jlopezr/mini-gpu/tools/README.md

# tools/

Infraestructura común del repositorio: lanzadores que funcionan desde cualquier
directorio una vez `tools/` está en el `PATH`, y que reutilizan la lógica que ya
vive en cada prototipo (simuladores, backends de placa) en vez de duplicarla.
`build`/`build-sweep`/`prototype-report` son genéricos: no dependen de qué
prototipo es, solo de en qué carpeta corren.

```bash
export PATH="$PWD/tools:$PATH"
```

Todo lo de aquí abajo funciona igual si lo lanzas desde la raíz del repo, desde
`17.fpga-gpu-ram-v2/`, o desde `/tmp`: cada comando localiza la raíz del
repositorio solo (por `MINI_GPU_ROOT`, por su propia ruta, o buscando
`tools/` + `README.md`).

## Validar VOBJ con vlink

`vlink` vive como submódulo opcional en `w.vlink`. Para inicializarlo
y compilarlo:

```bash
git submodule update --init w.vlink
build-vlink
```

`check-vobj` genera un smoke test MiniISA, lo ensambla a `.vobj`, lo enlaza con
`vlink` a rawbin y compara el resultado con el `.bin` directo de `mini-asm`:

```bash
check-vobj
check-vobj programa.asm
check-vobj programa.vobj
```

Si `vlink` no está en `PATH` ni compilado en `w.vlink`, el comando
sale con código 77 y lo reporta como skip. También acepta `--vlink /ruta/a/vlink`.

Para inspeccionar un objeto sin enlazar:

```bash
mini-objdump programa.vobj
mini-objdump --disassemble programa.vobj
mini-objdump --json programa.vobj
```

Un ejemplo completo de compilación separada (dos `.c` y un `.asm` a objetos
VOBJ, una biblioteca `.a` y vlink descartando lo que no se usa) está en
[`1.isa/ejemplo-enlazado/`](../1.isa/ejemplo-enlazado/README.md).

## Comprobar la trazabilidad documental

`trace check` construye un Project Model conforme al metamodelo v0.3. Un fichero
Markdown es un `RESOURCE`, no una identidad semántica. Los `ARTIFACT` se
declaran explícitamente mediante un comentario seguido de su heading:

```markdown
<!-- trace:artifact IMPL-MINIGPU
type: implementation
subjects: [isa, cpu, gpu]
implements:
  - SPEC-ISA
-->

# Implementación MiniGPU
```

El ID es global, sensible a mayúsculas y no deriva del `type`. Los headings
dentro del artifact crean `SECTION` locales como `SPEC-ISA#ssy`; una sección
que sea origen de relaciones necesita un ID formal `{#ssy}` y una directiva
`trace:relations`. Los enlaces Markdown ordinarios no crean relaciones.

El checker valida metadata YAML, tipos core, IDs únicos, atributos de relación,
targets exactos y relaciones duplicadas. Solo conserva las relaciones authored
en su dirección canónica; `trace show` calcula la vista inversa al consultar.

Este vertical slice implementa `RESOURCE`, `ARTIFACT`, `SECTION` y relaciones
Markdown. `trace.yaml` controla el discovery con patrones `scan` y `exclude`:

```yaml
project: minigpu
version: 1
scan:
  - "**/*.md"
exclude:
  - build/**
  - .git/**
```

La configuración es estricta: campos desconocidos, versiones no soportadas y
listas de patrones inválidas son errores. Una ruta explícita tampoco puede
saltar los límites de `scan`/`exclude`.

### Caché del grafo

Cada adapter produce un fragmento de modelo por `RESOURCE`, almacenado en
`.trace/cache-v1.json` (ignorado por Git). La caché conserva identidades,
relaciones pendientes, diagnósticos, localizaciones y dependencias:

- si `mtime_ns` y tamaño no cambian, no se abre el fichero;
- si cambia la metadata pero no el tamaño, se calcula SHA-256 y se reutiliza el
  fragmento cuando el contenido sigue siendo idéntico;
- si cambia el contenido o la versión del adapter, se vuelve a parsear;
- los resources borrados salen del grafo activo y conservan su último fragmento
  como tombstone para el análisis de impacto;
- un sidecar se invalida también cuando cambia, aparece o desaparece el recurso
  que describe.

El resolver reconstruye siempre el grafo global desde los fragmentos para que
duplicados y referencias reflejen el conjunto actual. `trace check --no-cache`
permite forzar una lectura completa; la salida normal informa hits y misses.

### Análisis de impacto

`trace impact` recorre en ambos sentidos únicamente las relaciones explícitas
del grafo y muestra una ruta mínima que explica cada resultado. Acepta una
identidad o un recurso; cuando se indica un recurso, todas las identidades que
proceden de él son puntos de partida:

```bash
$ trace impact SPEC-DEVICE#identity-register
$ trace impact tools/traceability/example/validation.py --depth 2
$ trace impact REQ-DEVICE-IDENTITY --json
```

La salida separa afectados directos y transitivos. `--depth N` limita el
recorrido y `--json` ofrece IDs, localizaciones, profundidad y cada salto de la
ruta para integraciones. El recorrido es una vista de conectividad: no añade
relaciones semánticas ni invierte su dirección canónica; cada salto indica si
se recorrió una relación en sentido `outgoing` o `incoming`.

Si un recurso desaparece después de haber sido cacheado,
`trace impact ruta/al/recurso` utiliza su tombstone y lo marca expresamente en
la salida. Esta posibilidad depende de la caché descartable: con `--no-cache`,
o si se borra `.trace/cache-v1.json`, no existe historial del recurso eliminado.

### Navegación del grafo

La API pública `Graph` construye una vez los índices por ID, tipo de elemento,
tipo de artifact, `kind` y `subject`, además de relaciones entrantes, salientes
y ownership estructural. Los comandos de consulta usan esos mismos índices:

```bash
$ trace list --type specification
$ trace list --kind capability --format json
$ trace incoming SPEC-DEVICE#identity-register --relation implements
$ trace outgoing IMPL-DEVICE-PROBE --relation implements
$ trace tree SPEC-DEVICE
$ trace path VER-DEVICE-IDENTITY::identity-read IMPL-DEVICE-PROBE::read-identity
```

`tree` recorre estructura (`owner` y `parent-facet`), no relaciones semánticas.
`path` recorre relaciones explícitas en ambos sentidos y devuelve el camino más
corto, indicando en cada salto si utilizó la dirección canónica o su vista
inversa. `show`, `list`, `incoming`, `outgoing`, `tree`, `path` e `impact`
aceptan `--format text|json`; `impact --json` se conserva como alias.

### Queries Python

Las preguntas reutilizables son funciones Python registradas, no comandos con
lógica duplicada ni un DSL propio:

```python
from tools.traceability import query

@query
def my_query(graph):
    ...

@query("related-to", arguments=("identity",))
def related_to(graph, identity):
    ...
```

El registro core se consulta y ejecuta desde CLI:

```bash
$ trace query list
$ trace query unimplemented
$ trace query unverified
$ trace query not-fully-verified
$ trace query unsatisfied
$ trace query implementations-of SPEC-DEVICE#identity-register
$ trace query verifications-of SPEC-DEVICE#identity-register --format json
```

`unverified` significa que no existe ninguna relación entrante `verifies`.
`not-fully-verified` exige al menos una relación con `coverage=complete`; varias
relaciones `partial` no se combinan implícitamente. Esta slice expone el registro
Python, pero todavía no carga módulos de queries arbitrarios desde el proyecto.

### Rules Python

Las rules son políticas verificables separadas de las queries. Se registran con
`@rule`, devuelven `RuleFinding` y se activan explícitamente en `trace.yaml`:

```yaml
rules:
  - accepted-requirements-satisfied
  - accepted-specifications-implemented
  - accepted-targets-fully-verified
```

`trace check` solo las ejecuta después de resolver un grafo válido. Los findings
`error` provocan exit code 1; los `warning` se muestran sin hacer fallar el
comando. `trace rule list` enumera el registro core. Una rule desconocida o una
configuración duplicada/inválida es un error explícito.

Una `FACET` se declara dentro de un artifact y se asocia a una sección formal
con el mismo ID local:

```markdown
<!-- trace:facet calls
kind: capability
-->

## Function calls {#calls}
```

Esto crea `SPEC-ISA@calls` y `SPEC-ISA#calls`. Su subtree determina el alcance;
las facets anidadas conservan `parent-facet` y cada sección guarda únicamente
su facet inmediata. Una frontera de artifact termina cualquier facet activa.

Todavía no se modela jerarquía interna de símbolos. El contenido situado dentro
de bloques `gendoc` se ignora al construir el modelo, para que el resultado
generado nunca se convierta accidentalmente en fuente autoritativa.

### Anotaciones SystemVerilog

El adapter SystemVerilog ofrece nivel 1–2: enlaza grupos de comentarios al
siguiente `module` y reconoce artifacts, módulos nombrados y símbolos formales.

```systemverilog
// @artifact IMPL-MINIGPU type=implementation
// @implements SPEC-ISA
module minigpu (...);

// update-mask @implements SPEC-SIMT#active-mask
module mask_writer (...);
```

En el primer grupo las relaciones salen del ARTIFACT. En el segundo, el ID
formal produce `IMPL-MINIGPU::update-mask`. También se admite `@id local-id`
como anotación separada. Whitespace y comentarios normales no rompen el grupo;
otro elemento sintáctico sí lo rompe y produce un diagnóstico.

Python y ensamblador MiniISA reutilizan exactamente la misma gramática. Python
asocia los grupos al siguiente `class`, `def` o `async def` (admite decoradores
entre ambos); ASM los asocia al siguiente label. Sus comentarios son `#` y `;`
respectivamente. Como en SystemVerilog, el código no anotado permanece como
RESOURCE y no genera un inventario de SYMBOLs.

### Sidecars

Un fichero `<basename>.trace.yaml` aporta metadata a un recurso que no conviene
modificar. Puede declarar cualquier tipo de ARTIFACT; no implica `source` por
sí mismo.

```yaml
artifact: SRC-W9825G6KH-DATASHEET
type: source
kind: datasheet
resource:
  file: w9825g6kh.pdf
  revision: "Rev. A"
  sha256: "..."
```

`resource.file` se resuelve respecto al sidecar y no puede salir de la raíz.
Debe existir. Si se proporciona `sha256`, `trace check` valida su formato y el
contenido. La metadata desconocida es un error y el artifact puede declarar
las mismas relaciones core que una representación Markdown.

```bash
trace check                         # todos los Markdown del repositorio
trace check README.md docs/         # solo observaciones de esas rutas
trace check --root /ruta/mini-gpu   # raíz explícita para CI
trace show REQ-DEVICE-IDENTITY      # declaración y relaciones de una identidad
```

`trace coverage` ayuda a migrar documentación existente: compara los ficheros
que descubre `scan` con las identidades declaradas y resume por directorio
cuántos siguen sin marcar. No es una query porque esos ficheros aún no son
identidades del grafo.

```bash
trace coverage                      # resumen por directorio de primer nivel
trace coverage --depth 2 --files    # más detalle y lista de ficheros sin marcar
trace coverage 30.fpga-cpu-console  # solo una zona
```

Al seleccionar rutas se siguen indexando las identidades de todo el repositorio,
de modo que sus enlaces pueden resolverse fuera del subconjunto. El comando
devuelve 0 si todo resuelve, 1 si encuentra diagnósticos y 2 si el uso o una
ruta de entrada no son válidos.

Hay un [ejemplo autocontenido](traceability/example/README.md) con requisito,
decisión, especificación, implementación y verificación. Sirve como recorrido
mínimo y especificación ejecutable del adapter Markdown.

## Windows: un `.ps1` por cada lanzador

Un fichero sin extensión no se puede ejecutar directamente en Windows (no hay
shebang), así que cada lanzador de `tools/` tiene un `.ps1` homónimo. Todos
son adaptadores finos que reenvían tal cual a python (`@args`); no hay lógica
propia en PowerShell en ninguno, así que las opciones son siempre las del
script Python correspondiente: `--prototype`/`-p`, doble guion.

## Resolver un prototipo

Los comandos Python que aceptan `--prototype` también aceptan `-p` (equivalen
al mismo argumento: `-p 17` y `--prototype 17` son intercambiables).

Entienden cuatro formas equivalentes de identificar un prototipo, y resuelven
un número ambiguo o inexistente con un error explícito en vez de adivinar:

```bash
$ list-prototypes | grep -m1 17
PROTOTYPE               TITLE
...
17.fpga-gpu-ram-v2      MiniGPU con SDRAM v2: 8 warps × 8 lanes             sí     no    sí     no

$ python3 tools/prototype.py 17
/Users/tú/mini-gpu/17.fpga-gpu-ram-v2

$ python3 tools/prototype.py 17.fpga-gpu-ram-v2   # nombre completo, mismo resultado
$ python3 tools/prototype.py ./17.fpga-gpu-ram-v2 # ruta relativa
$ python3 tools/prototype.py 99
error: No existe ningún prototipo para '99'. Disponibles: 0.mandelbrot, 1.isa, ...
```

`list-prototypes` es el punto de partida cuando no te acuerdas del nombre
exacto de una carpeta: lista todo en orden numérico (1, 2, ..., 10, 11, no
alfabético) con el título de su `README.md`, el backend detectado en el RTL
(`cpu`/`gpu`/`—`) y si tiene `apio.ini` (si lo tiene, `build`/`test`/`lint`/
`build-sweep` funcionan ahí sin más).

## Ensamblar y simular un programa

Lanzadores finos: ejecutan el script real de la carpeta correspondiente, no
una reimplementación.

```bash
> mini-asm ../t.tests/cases-gpu/demos/vector/vector.asm           # -> 1.isa/asm2/mini-asm.py
> sim-cpu ../t.tests/cases-gpu/demos/vector/vector.asm             # -> 2.cpu-sim-func/minicpu_sim.py
> sim-gpu ../t.tests/cases-gpu/demos/vector/vector.asm             # -> 11.gpu-sim-func/minigpu_sim.py
> sim-gpu-cycle ../t.tests/cases-gpu/demos/vector/vector.asm       # -> 25.gpu-sim-cycle-uarch/minigpu_cycle.py
> sim-sys ../t.tests/cases-cpu-gpu/launch/launch.asm              # -> 32.cpu-gpu-func-sim/cpu_gpu_sim.py
```

Cada uno acepta los mismos argumentos que el script al que llama (pásale
`--help` para verlos).

Los simuladores son Python puro y van de 4 a 10 veces más rápido con PyPy, sin cambiar nada: basta con lanzarlos
con él (`uv python install pypy@3.11` lo instala). Las ventanas Tk (`--window`) no van en PyPy, pero se abren en
otro proceso, y `gui_python()` de `tools/sim_host.py` las lanza con `MINIGPU_GUI_PYTHON`, el `.venv` del repo o el
`python3` del PATH. El Makefile de `39.mini-gl` ya usa PyPy si está (`SIM_PYTHON`). Para `mini-opt` no compensa:
tarda poco y el JIT no llega a amortizarse.

```bash
$ $(uv python find pypy) tools/sim-sys programa.bin --halt-after-swaps 2
```

Sin `-o`, `mini-asm` deja el binario en `_build/<nombre>.bin` junto al fuente
(carpeta ignorada por git), no al lado del `.asm`. `board-load` y `run-board`
ensamblan ahí mismo, así que `vector.asm` acaba en `vector/_build/vector.bin`.

`mini-asm` se llamaba `miniisa`, y el módulo `1.isa/mini_asm.py` se llamaba
`miniisa_asm.py`. `MiniISA` sigue siendo el nombre de la ISA: el rename fue solo
del ensamblador, para que quede junto a `mini-lcc`.

Para saber qué instrucción hay en una dirección concreta —el `pc` que reporta
`run-board` o un simulador— `mini-asm --listing` saca el listado PC / palabra /
fuente y la tabla de etiquetas. Ver [`1.isa/ensamblador.md`](../1.isa/ensamblador.md).

Para saber **qué funciones ocupan más** de un programa, `asm-sizes` lee los
bloques `Secciones:` y `Simbolos:` de ese listado (los calcula el ensamblador)
y da el tamaño de cada función y de cada dato, con el reparto por sección:

```text
> mini-asm v.tui/_build/tui_mini.s --listing tui_mini.lst -o tui_mini.bin
> asm-sizes tui_mini.lst --top 15 --datos
```

Solo necesita el `.lst`. Si es de un `mini-asm` anterior a esos bloques, lo
dice y hay que regenerarlo. La imagen del listado coincide con el `.bin`.

Los tres simuladores aceptan **`.asm`, `.bin` o `.hex`**, y ensamblan solos si
hace falta. La carga es `load_program_bytes()` de `1.isa/mini_asm.py` (fachada
de compatibilidad hacia `asm2`), una sola para los tres: antes cada simulador hacía lo suyo, y estos ejemplos con
`.asm` solo funcionaban en `sim-gpu-cycle` — los otros dos leían el fichero como
binario y morían con «el programa debe contener instrucciones completas», que
es el síntoma (el texto fuente no mide un múltiplo de 4) y no la causa.

Ojo con los casos de `t.tests`: muchos traen un `warps.json` que hay que pasar
con `--config`, o el simulador lanza los 8 warps por defecto en vez de los que
el caso espera.

```bash
$ sim-gpu t.tests/cases-gpu/memory/memory-copy/program.asm \
         --config t.tests/cases-gpu/memory/memory-copy/warps.json --trace
```

El modelo 25 ejecuta la futura microarquitectura S/F/I/D/X/W. Acepta
`--trace ciclos.jsonl`, `--report perfil.json`, latencias parametrizables y
`--imem-lines 0` para fetch ideal. Tests: `test --prototype 25 --quick`.
Los casos existentes también se ejecutan con
`python t.tests/run_tests.py --backend sim-gpu --version cycle t.tests/cases-gpu`.

### Perfil por función (`--profile`)

`sim-sys`, `sim-cpu` y `sim-gpu` cuentan, si se les pide, las instrucciones de CPU y de warp de cada función del
programa (`tools/sim_profile.py`, compartido como las opciones de periféricos; `sim-gpu-cycle` todavía no lo tiene):

```bash
$ sim-sys programa.asm --profile                        # tabla al terminar (las 25 primeras)
$ sim-sys programa.bin --profile --symbols programa.asm # un .bin no lleva nombres: el .asm que lo dio
$ sim-sys programa.asm --profile perfil.txt             # todas, en un fichero
$ sim-sys programa.asm --profile --profile-annotate anotado.txt  # y el .asm con la cuenta de cada instrucción
```

Las funciones son las etiquetas de código que no son de bloque (`L.n`, que el ensamblador renombra a
`L.<fichero>.n`) ni las que añade `mini-opt` (`__inl$...` de `marks` y los puntos de reunión `__ssy_...` de
`ssy`). lcc da a cada función del `.asm` el nombre que tiene en C y no expande en línea, así que en un programa de
`build-c` son las funciones C (`build-c` deja el `.asm` que ensambla junto a los intermedios: es el
de `--symbols`). En la CPU salen las instrucciones **propias**, las **llamadas** (`JAL`/`JALR`) y el **total**
con todo lo que llama; la pila se sigue por la dirección de retorno, así que una llamada final que `mini-opt`
convirtió en `BRA` cuenta dentro de quien salta, y la recursión no se cuenta dos veces. En la GPU, las
instrucciones de warp de cada kernel (`__kernel_x` sale como `x (kernel)`). El código antes de la primera
etiqueta (o de un programa sin ninguna) sale como `(sin nombre)`. Funciona junto a `--trace`.

Un kernel no llama a nada (`kernelcalls` expande sus llamadas), pero el pase `marks` de `mini-opt` deja etiquetas
`__inl$...` donde cambia la función expandida, y con ellas la GPU sale como un árbol: el kernel y, dentro, cada
función expandida con sus instrucciones **propias**, el **total** con lo que tiene dentro y la **ocupación**
(lanes activas de las vivas, de media: en SIMT una instrucción con una lane activa cuesta lo mismo que con ocho):

```text
Perfil de GPU: 336488 instrucciones de warp; ocupación 97% (lanes activas de las vivas)
  función                                         propias      %      total      %  ocup.
  mgl_render (kernel)                                  33   0.0%     336488 100.0%    97%
    render.gpu_renderer                              2604   0.8%     336455 100.0%    97%
      segment.gpu_renderer                          60562  18.0%     118076  35.1%    95%
        span.gpu_renderer                           10276   3.1%      26924   8.0%    97%
          row_fill.gpu_renderer                     16648   4.9%      16648   4.9%    96%
        box.gpu_renderer                             2988   0.9%      14136   4.2%    96%
          row_fill.gpu_renderer                     11148   3.3%      11148   3.3%    95%
        put.gpu_renderer                             6400   1.9%       6400   1.9%    34%
```

`--profile-annotate FICHERO` escribe el `.asm` de las funciones que se han ejecutado con, en cada instrucción, las
veces que la ha ejecutado la CPU, las de la GPU (instrucciones de warp) y su ocupación.

### Backend Codon para CPU+GPU

Si Codon está instalado, `sim-sys` ejecuta el sistema en un motor nativo compilado
con Codon a partir de los mismos núcleos Python (`minicpu_core.py`,
`minigpu_core.py`, `cpu_gpu_core.py`), sin traducirlos. Es `--backend auto`, el
valor por defecto; sin Codon (en Windows, siempre) usa Python, y si Codon falla al
compilar, avisa y sigue con Python. `--backend python|codon` fuerza uno y
`MINIGPU_SIM_BACKEND` cambia el valor por defecto. Conserva los periféricos Python
y las opciones de ventana, entrada, serie y volcados; traza y perfil usan siempre
el motor Python.

Se necesita Codon (`MINIGPU_CODON`, PATH o `_build/codon-sdk/bin/codon`) y la
libpython de CPython (`CODON_PYTHON` permite indicar la ruta). La compilación
queda en `_build/codon-engine/` y se rehace al cambiar cualquier fuente del motor.
Para MiniGL, `make -C 39.mini-gl sim-boxes` ya lo usa.
Regresión diferencial: `RUN_CODON=1 tools/test --prototype 32 --quick`.
Cómo está montado: [codon/README.md](codon/README.md). Qué no admite Codon y qué
rodeos llevan por ello los núcleos: [codon/LIMITACIONES.md](codon/LIMITACIONES.md).

### Periféricos comunes de los tres simuladores

`sim-cpu`, `sim-gpu` y `sim-gpu-cycle` comparten `tools/sim_devices.py` y las
opciones de `tools/sim_peripherals.py`:

| Opción | Efecto |
|---|---|
| `--video` | Activa registros de vídeo en `0x80000000` |
| `--frame-instructions N` | Periodo sintético del frame, 1000 por defecto; debe ser positivo |
| `--halt-after-swaps N` | Activa vídeo y para el simulador tras N intercambios |
| `--frame-output frame.bin` | Activa vídeo y guarda el framebuffer frontal RGB565 de 320×240 |
| `--console` | Activa vídeo con la consola de texto 80×30 de la 30: `CONFIG` (`+0x40`), paleta (`+0x1000`) y texto (`+0x6000`) dentro de la ventana de vídeo. `SWAP` pasa a ser `FRAME_COMMIT` de dos bits (swap y `STATE_COMMIT`) |
| `--console-output pantalla.txt` | Activa `--console` y vuelca la pantalla de texto (30 líneas, UTF-8) al terminar |
| `--console-image pantalla.png` | Activa `--console` y guarda la pantalla como PNG 640×480, dibujada con `--console-font` (nombre de `30.fpga-cpu-console/fonts` —`cpc464` por defecto, `pc`, `tamzen`— o ruta a un `.hex`). Compone la consola sobre el framebuffer si el programa lo usa (`VIDEO_CTRL` en scanout); el color 0 es transparente, como en el RTL, y sin framebuffer sale negro. `--frame-output` y `fb_window` solo muestran el framebuffer, sin la consola |
| `--serial` | Activa serie en `0x80000200` |
| `--serial-tty` | Activa serie y lo conecta al terminal: la salida del programa va a stdout y lo que se teclea entra por RX (sin eco ni Enter, como `run-board --interactive`). **Ctrl+C** sale. Combinable con `--window` (ventana para teclado y ratón, terminal para la UART). No vale en `mini-dbg`: la TUI ocupa el terminal |
| `--serial-input entrada.bin` | Activa serie y precarga los bytes de entrada |
| `--serial-output salida.bin` | Activa serie y recoge la salida durante toda la ejecución |
| `--window` | Abre una ventana con la pantalla (framebuffer, consola o ambos, según `VIDEO_CTRL` y `CONFIG`) y conecta su teclado y ratón a INPUT. Implica vídeo; `--console` y `--console-font` valen igual. **F12** o cerrar la ventana paran el simulador; al terminar el programa la última imagen se queda hasta cerrarla. En `mini-dbg` es la ventana de `fb screen` y F12 interrumpe la ejecución sin parar la máquina |
| `--keyboard` | Activa INPUT (teclado y ratón, `mmio.md` §25, en `0x80600000`) con un teclado presente desde el principio |
| `--mouse` | Activa INPUT con un ratón presente desde el principio |
| `--input-script entrada.txt` | Activa INPUT y carga un guion de entrada. El guion conecta lo que no pidan `--keyboard`/`--mouse`; se comprueba entero al cargar |

Por ejemplo, las mismas opciones sirven con cualquiera de los tres lanzadores:

```powershell
.\tools\sim-cpu.ps1 programa.asm --serial-input entrada.bin --serial-output salida.bin
.\tools\sim-gpu-cycle.ps1 dibujo.asm --video --halt-after-swaps 2 --frame-output frame.bin
.\tools\sim-cpu.ps1 leer_teclas.asm --input-script entrada.txt --serial-output salida.bin
```

#### Ventana (`--window`)

```powershell
.\tools\sim-cpu.ps1 2.cpu-sim-func\examples\input_paint.asm --window --run-limit 2000000000
```

El pintor de `2.cpu-sim-func/examples/input_paint.asm` dibuja con el ratón
(botón izquierdo), cambia de color con cualquier tecla y borra con la barra
espaciadora. La ventana es un proceso aparte (`tools/screen_window.py`, Tk y
PIL) y el simulador la refresca unas 15 veces por segundo solo si la pantalla
cambió; no hay ritmo de tiempo real, el simulador corre tan deprisa como puede.

Las teclas viajan como **teclas físicas** (`tools/host_input.py`): `MapVirtualKey`
da el scancode y de ahí el Usage ID, así que no dependen del layout. Los
modificadores se leen del sistema y AltGr no deja pulsado un Control. Mantener
una tecla no repite pulsaciones: el contrato no define typematic, es del
software. Los movimientos del ratón se funden en un evento por muestreo
(10 ms). El ratón se supone al principio en el centro de la ventana, y cuando el
puntero sale y vuelve a entrar por otro sitio se entrega el desplazamiento neto
de fuera, de modo que un pincel no se descoloca. Si la FIFO de
INPUT está casi llena, el simulador retiene el movimiento y lo entrega sumado
cuando hay hueco, en vez de perderlo (el dispositivo sigue siendo fiel al
contrato: lo que llegara con la cola llena se perdería). Perder el foco suelta
todo. El ratón de INPUT es **relativo**: el programa no sabe dónde está el
puntero, solo cuánto se mueve, así que un pincel arranca donde el programa
diga y se mueve desde ahí; para ver el puntero hay que dibujarlo.

#### En la placa (`monitor.py input`)

En la 30, el teclado y el ratón del PC alimentan el INPUT de la FPGA a través del
monitor, sin ningún USB conectado a la placa:

```powershell
python 30.fpga-cpu-console\monitor.py input
```

Abre una ventana que **solo captura** (con `tools/screen_window.py --panel`; la
imagen la enseña el HDMI de la placa, porque leer el framebuffer por UART
costaría ~1,5 s por frame) y manda cada report como eventos con `INPUT_EVENTS`
(`mmio.md` §16.5). Es la misma captura y la misma traducción a teclas físicas
que la ventana del simulador. **F12** sale, y al salir manda las liberaciones de
lo que siguiera pulsado y la presencia a cero. La lógica —qué palabras salen, el
control de flujo con los huecos libres de la FIFO, que el movimiento se funda
mientras no hay sitio— está en `tools/input_adapter.py` y se prueba sin placa
(`t.tests/unit/input/test_input_adapter.py`). Cada ida y vuelta cuesta ~16 ms por el latency
timer del FTDI, así que se manda un comando por vuelta con todo lo que cabe.

**El puntero se resincroniza al conectar.** El ratón de INPUT es relativo y el
programa de la placa sigue vivo entre una sesión y otra, así que conserva el
puntero donde lo dejó la anterior, mientras que la ventana de captura supone que
empieza en su centro. Sin más, cada vez que se sale y se vuelve a entrar queda un
desfase. Al conectar se barre el puntero hacia la esquina (0,0), donde lo deja
cualquier programa que recorte su cursor a la pantalla, y de ahí al centro de la
ventana (`InputAdapter.home`). Con `--keep-pointer` no se hace, para un programa
que use el movimiento como entrada relativa y no quiera ese barrido.

#### Pruebas automáticas en la placa

`monitor.py input` es para una persona. Para automatizar hay tres piezas, de la
más baja a la más alta:

- **`monitor.py screen [FILA...]`** imprime la pantalla de texto (80x30) como
  texto, entera o solo las filas que se piden. La RAM de texto no se puede leer en
  bloque por el monitor, así que son ~2 ms por celda: ~0,2 s una fila, ~5 s la
  pantalla entera.
- **`tools/board_input.py`** (`BoardInput`) es lo mismo que la ventana pero desde
  Python: `tap`, `key_down`, `click(columna, fila)`, `screen()`, `wait_for(texto)`.
  Resincroniza el puntero al empezar y lleva la cuenta de dónde está, así que un
  clic cae en su celda sea cual sea el estado en que dejó la placa la sesión
  anterior, y espera a que la CPU haya sacado los eventos y la aplicación haya
  repintado antes de mirar.
- **`monitor.py input --script guion.txt`** ejecuta un guion de
  `tools/board_script.py`: el mismo formato que `--input-script` del simulador
  (`keyboard`, `mouse`, `key`, `type`), con los instantes en **milisegundos** en vez
  de instrucciones, y cuatro verbos que solo existen con una placa delante:

```text
@0     keyboard connect
+0     mouse connect
+300   type "hola"
+0     click 53 6                      # columna, fila de la pantalla de texto
+0     moveto 40 15                    # solo mueve el puntero
+0     expect row 13 contains "hola"   # lo que debe verse ya (con un margen)
+0     expect row 29 is "Control: Edit"
+0     expect screen absent "Error"
+0     wait row 29 contains "Edit" 3000    # espera hasta 3000 ms (5000 por defecto)
```

  `expect` y `wait` admiten `contains`, `is` (fila entera) y `absent`, sobre
  `row N` o `screen`. El guion se comprueba entero al cargarlo (una tecla sin
  teclado conectado, una celda fuera de pantalla, una línea mal escrita fallan con
  el número de línea y antes de tocar la placa). Una comprobación que falla para el
  guion, dice qué esperaba y qué había, y el código de salida es 1. Pase lo que
  pase, al terminar se sueltan las teclas y los botones, y se quita la presencia.

  **Cuánto se espera.** Leer una fila cuesta ~0,16 s (80 palabras a ~2 ms: la
  latencia del USB-serie; el monitor no encadena peticiones ni lee bloques de la RAM
  de texto), así que nada duerme entre lecturas. `wait` mira hasta que se cumple o
  se agota su tiempo. `expect ... contains|is` mira en cuanto la placa consumió lo
  enviado y, si no está, sigue hasta `4 x settle`; `absent` espera `settle` y mira
  una vez, porque la ausencia no se confirma viendo algo. Lo que arranca la
  aplicación (justo tras `board-load`) se espera con un `wait`, no con un `+300` y un
  sueño. `--settle-ms` (150 por defecto) es el tiempo que se deja a la aplicación
  para repintar; `--keep-pointer` desactiva la resincronización del puntero.
  Ejemplo: `v.tui/test/board_controls.txt`.

Qué usar: para la lógica (teclado español, repintado, controles) el simulador con
`--input-script`, que es determinista y no necesita placa; para comprobar la placa
de verdad (latencia, FIFO, repintado real), estos. Se prueban sin placa en
`t.tests/unit/input/test_board_input.py` y `t.tests/unit/input/test_board_script.py`, con una FPGA y una
aplicación simuladas.

#### Guiones de entrada (`--input-script`)

Una acción por línea, con el instante en instrucciones completadas (de CPU o
de warp): `@N` es absoluto y `+N` relativo a la línea anterior. `@0` se aplica
al cargar, antes de la primera instrucción.

```text
@0    keyboard connect               # o `keyboard connect A LSHIFT` con teclas ya pulsadas
+100  key press H                    # down y up, dos reports
+10   type "Hola\n"                  # teclado US; las mayúsculas llevan LSHIFT
+50   key down LSHIFT A              # varias teclas = un solo report
+50   key up LSHIFT A
@500  mouse connect
+10   mouse move 12 -5
+10   mouse button left click        # left, right, middle o 0..31; down, up o click
+10   mouse report 0b101 3 4         # bitmap de botones y movimiento en un report
+10   keyboard disconnect            # libera lo pulsado y deja STATE a cero
```

Las teclas son nombres de `tools/hid_keys.py` (`A`, `ENTER`, `LSHIFT`, `F1`,
`UP`...) o Usage IDs literales (`0x2C`); un dígito suelto es la tecla del
dígito, no el Usage ID. El simulador reproduce INPUT, no USB: aplica los
reports con el orden de eventos, el overflow y las reglas de
conexión/desconexión de §25, así que un guion que lanza más de 16 eventos sin
que el programa los lea los pierde igual que la FPGA.

`SYS_ID` siempre está disponible, también mediante LOAD en la 25. Vídeo y serie
son opcionales en la API (`video=VideoDevice()`, `serial=SerialDevice()`). El
runner `t.tests` conecta serie en los tres modelos y vídeo cuando lo pide el
caso; los tres declaran `video`, `frame_capture` y `serial`.

El contrato funcional de vídeo incluye `SWAP_COUNT`, `HALT_AT` y `VIDEO_CTRL`.
Las bases arrancan a cero y las configura el programa; se alinean a 4 bytes en
los tres modelos. Una escritura a `SWAP` pide intercambio, incluso con valor
cero. Para portabilidad al RTL GPU, alinear bases a 16 y escribir 1 a `SWAP`.
`HALT_AT` cuenta intercambios completados desde que se arma (mmio.md §9.6) y
`HALT_TARGET` dice a quién para: el bit 0 a la CPU y el 1 a la GPU, y cada modelo
solo hace caso al suyo. El RTL GPU no gana serie por esta unificación de
simuladores.

El frame se mide en instrucciones CPU o de warp, no en ciclos del pipeline.
Los puntos de avance y el orden entre warps dependen del motor: no se promete
el mismo PC al capturar. No se simulan desgarro, underflow ni tiempo físico de
UART/HDMI. `--frame-output` vuelca RAM desde `FB_FRONT`, no renderiza PATTERN ni
BLANK. Los accesos MMIO requieren palabras alineadas de 32 bits.

## Depurador interactivo (`mini-dbg`)

Un solo depurador que se **conecta** a dos sitios: el simulador funcional o la
placa por el monitor serie. Mismos comandos, misma interfaz, mismo núcleo.

```bash
> mini-dbg programa.asm                  # simulador funcional (2.cpu-sim-func)
> mini-dbg --board --prototype 21        # placa real, por monitor.py
> mini-dbg --board -p 21 programa.asm    # placa, con el fuente para el listado
```

El programa hace dos cosas: se carga en el simulador y sirve de mapa
`PC -> fuente`. Con `--board` no se carga nada —de eso ya se ocupa
`board-load`— pero el `.asm` sigue valiendo para ver el código tal como se
escribió en vez de palabras en crudo. El mapa no es un desensamblador: lo
construye `mini_asm.first_pass`, como `mini-asm --listing`, así que conserva
comentarios, etiquetas y macros. Con un `.bin` o un `.hex` se ven `.word`.

La TUI son cuatro paneles —código con el PC centrado, registros, memoria y
consola— y una línea de comandos. Cada tecla hace exactamente lo mismo que
escribir el comando, ni más ni menos:

| Comando | Tecla | Qué hace |
|---|---|---|
| `step [N]` | `s` | Ejecuta N instrucciones (1 por defecto). No para en breakpoints |
| `over` | `n` | Un paso, saltando entera la llamada si es `JAL`/`JALR` |
| `finish` | `o` | Ejecuta hasta salir de la función actual |
| `run [N]` | `c` | Hasta breakpoint, `HALT`, error, `F12` o `Esc`; con N, como máximo N instrucciones |
| `until X` | `u` | Hasta la dirección, etiqueta o línea marcada por el cursor |
| `break [X]` | `b` | Breakpoint en X (o en el PC con la tecla); sin argumento los lista |
| `delete [X]` | — | Borra el breakpoint X, o todos |
| `regs [Rn]` | — | Los registros, o uno |
| `set X V` | — | `set R5 0x10`, `set pc bucle` |
| `mem [X N]` | — | Vuelca N bytes desde X y mueve el panel de memoria |
| `write X V` | — | Escribe la palabra V en la dirección X |
| `fb [X]` | `v` | Ventana de framebuffer: `front` (por defecto), `back`, `both`, `off`. `fb screen` abre la pantalla del simulador (framebuffer, consola o ambos) con teclado y ratón hacia INPUT; `--window` la abre al arrancar |
| `input` | — | Estado de INPUT: presencia, teclas pulsadas, botones del ratón y la cola de eventos, sin consumirlos. Solo si hay INPUT (`--keyboard`, `--mouse`, `--window` o `--input-script`) |
| `frame` | `f` | Ejecuta hasta que se completa el siguiente intercambio de framebuffer |
| `reset` | `R` | PC, registros y contadores a cero sin borrar la memoria |

Durante `run`, `until`, `over`, `finish` o `frame`, `F12` (o `Esc` en la TUI) solicita
la parada y devuelve el control a la TUI. En las ventanas **solo** `F12`: `Esc` es una
tecla más del programa que se depura. Código y memoria aceptan también `PageUp`, `PageDown` y
`Home`; `Home` lleva al inicio del programa o a `0x00000000`, respectivamente.
`Ctrl+C` hace lo mismo durante la ejecución; con la máquina ya parada, sale del
depurador limpiamente.
`run` sin argumento no tiene límite interno, pensado también para programas
gráficos con bucle principal permanente. `run N` o `--run-limit N` permiten
pedir expresamente un máximo.
Después de ejecutar, el cursor de código vuelve al PC y el siguiente
`↑`/`↓` parte de la instrucción actual.
Con el foco en código, registros o memoria, `/` abre una búsqueda en ese panel.
En memoria busca bytes hexadecimales (`DE AD BE EF`) o texto dentro de la
ventana mostrada. `a` repite la última búsqueda en el mismo panel.
Los comentarios clicables usan cian para destinos de código, magenta para RAM
y amarillo para MMIO (`0x80000000` en adelante). La dirección efectiva de un
acceso se calcula con la instantánea actual de los registros: es exacta cuando
el PC está en esa instrucción y orientativa al inspeccionar código futuro.

**Ayuda.** `F1` (o `?` con el foco fuera de la línea de comandos, o escribir
`help`) abre una ventana flotante con todo: las teclas, las propias de cada
panel, los comandos agrupados por tema y el significado de los colores y marcas.
Solo enseña lo que el objetivo tiene —sin la sección de CPU + GPU en un solo
núcleo, ni `fb` sin vídeo— y las teclas salen de las de la propia aplicación, así
que no se desactualiza. `Esc`, `F1` o `q` la cierran, y las flechas la
desplazan. La paleta de Textual (`Ctrl+P`) no ofrece su «Show keys and help
panel», que abre una barra lateral que se come un tercio del ancho: en su lugar
tiene «Ayuda del depurador», la misma ventana. En modo línea (`--no-tui`), `help`
sigue imprimiendo la lista.

El pie muestra únicamente acciones disponibles. `v` y `f` no aparecen si el
objetivo no ofrece vídeo; al cambiar el foco añade las teclas propias del panel:
`↑`/`↓`, `/`, `a`, `p`, `b` y `u` en código, `↑`/`↓`, `/` y `a` en registros, y
`↑`/`↓`, `/`, `a` y `h` en memoria.

### Ver el framebuffer mientras se depura

`v` (o `fb`) abre una **ventana** aparte con el framebuffer, en tkinter —de la
biblioteca estándar, no hace falta pygame ni nada nuevo—. `fb both` enseña los
dos buffers lado a lado, `+`/`-` amplían y `F12` detiene la ejecución en curso
sin cerrar la ventana. La X (o `fb off`) sí la cierra.
Mientras la ventana de vídeo tiene el foco, sus teclas de depuración se
reenvían como si estuviera seleccionado el panel de código: `s`, `n`, `o`,
`c`, `f`, `R`, cursores, `PageUp`/`PageDown`, `Home`, `p`, `b`, `u`, `/` y
`a`. El zoom conserva `+`/`-`.

Los dos buffers no enseñan lo mismo, y esa es la gracia:

- **front** es el frame estable, el que estaría saliendo por HDMI.
- **back** es sobre el que el programa está dibujando *ahora*, así que con la
  máquina parada a mitad de dibujo se ve a medias. Eso no es un fallo de la
  captura: es ver exactamente hasta dónde había llegado. Es justo lo contrario
  de `capture-frames`, que para en el swap para que la captura salga
  entera y determinista — las dos herramientas quieren cosas distintas.

En el simulador la ventana se repinta **después de cada comando**, así que se
ve el dibujo avanzar paso a paso. En la placa no: son ~1,5 s por buffer a
1 Mbaud (el número está medido en `tools/capture-frames`), así que se refresca
cuando se pide con `fb`. `fb auto on|off` cambia ese comportamiento si en algún
caso concreto interesa lo contrario.
Durante una ejecución larga, el título con `PC` e `instr` se actualiza unas
diez veces por segundo aunque no haya un frame nuevo; este refresco no lee ni
transfiere los píxeles.
Cada frame viaja íntegramente en memoria por la tubería, codificado en Base64;
no se crean archivos temporales ni interviene el bloqueo de ficheros de
Windows. La ventana agrupa los frames que llegan más deprisa de lo que puede
pintarlos. Si Pillow falla igualmente,
el error aparece en rojo en la consola de la TUI en vez de quedar oculto bajo
el repintado del terminal.

Las bases no se cablean: `FB_FRONT` y `FB_BACK` se releen en cada refresco
porque el swap las intercambia. En el simulador se le preguntan al dispositivo;
en la placa se leen de la ventana de vídeo de MMIO v2 (`0x80200000`), pero sólo
después de comprobar el magic de SYS_ID y el bit de vídeo de `DEVICES`. Sin
magic no se lee nada: en v2 `0x80000000` es SYSTEM, así que leer ahí a ciegas
devolvería el propio magic con pinta de dirección de framebuffer.

Los programas de vídeo escriben sus propias bases `FB_FRONT` y `FB_BACK`; el
depurador no las prepara desde fuera. Hay que habilitar el dispositivo con
`--video`. Si un fuente usa símbolos `MMIO_VIDEO_*` sin esa opción, `mini-dbg`
y `sim-cpu` muestran un aviso antes de ejecutarlo:

```bash
> mini-dbg t.tests/cases-cpu/video/fire/fire.asm --video -x "run 400000"
```

Direcciones y valores aceptan etiquetas del programa, `0x...`, decimal y `pc`.
Los `.include` se buscan siempre en `runtime/include` y `runtime/src` —ahí vive `mmio.inc`—
más lo que se añada con `-I`.
Para tuberías, `ssh` o una máquina sin `textual`, `--no-tui` da el mismo
depurador en modo línea. Se puede arrancar con trabajo hecho:
`mini-dbg programa.asm --break bucle -x run`.

**Qué se puede hacer en cada sitio.** No todo objetivo soporta todo, y el que
no, lo dice en vez de fingirlo:

| Operación | Simulador | Placa |
|---|---|---|
| Paso, breakpoints, leer registros y memoria | sí | sí |
| Escribir memoria, `reset` | sí | sí |
| `set Rn` / `set pc` | sí | **no** — pide comandos nuevos en `monitor.v` (punto 11 del TODO) |
| `run` sin breakpoints | paso a paso (ya es rápido) | `RUN` del monitor, no miles de `STEP` por el serie |

Un `run` **con** breakpoints en la placa sí va instrucción a instrucción por el
puerto serie, porque el hardware no tiene comparador de PC: es correcto pero
lento, así que conviene acercarse con `until` y afinar desde ahí.

**Dónde está.** `tools/debug_core.py` es el depurador entero —comandos,
ejecución, breakpoints— y no pinta nada; `tools/debug_tui.py` solo coloca en
paneles lo que el núcleo devuelve. En medio, `tools/debug_target.py` define qué
necesita el depurador de la máquina que depura, con una implementación para el
simulador y otra (`tools/debug_board.py`) para el monitor. CPU y GPU juntas son
un tercer objetivo, `tools/debug_system.py` (siguiente apartado).
Suite: `python -m unittest discover -s t.tests/unit/debugger -t t.tests -p "test_debugger*.py"`.

### Depurar CPU + GPU (`mini-dbg --gpu`)

```bash
> mini-dbg --gpu t.tests/cases-cpu-gpu/launch/launch.asm
> mini-dbg --gpu programa.asm --num-warps 4 --warp-size 8 --cpu-steps 2 --gpu-steps 1
```

Monta el simulador de `32.cpu-gpu-func-sim` (CPU y GPU sobre la misma RAM): el
programa lleva el código de la CPU y el kernel en una imagen, como en
`sim-sys`. Solo existe en el simulador; la placa no lo tiene porque el
monitor de las carpetas con GPU no da los registros de lane (hace falta un
comando de selección de contexto en `monitor.v`).

**Parada total.** `run`, `until` y `frame` hacen avanzar a los dos núcleos con
el reparto de `--cpu-steps`/`--gpu-steps`, y en cuanto uno para (breakpoint,
error) paran los dos. El foco pasa al núcleo responsable y el mensaje lo dice:
`parada en 0x0000004C [GPU warp 1]`. Una CPU con `HALT` no corta a la GPU: se
sigue hasta que los warps terminen. Si la CPU ya paró y quedan warps que no
pueden avanzar (una barrera a la que no llegan todos) sale con «sin progreso».

**Foco.** Hay un núcleo con foco y, dentro de la GPU, un warp y una lane. El
foco recibe `step`, `regs`, `set`, el listado y la barra de estado.

| Comando | Tecla | Hace |
|---|---|---|
| `core [cpu\|gpu]` | `g` | cambia de núcleo (sin argumento, alterna) |
| `warp [N]` | `w` | foco en el warp N (sin argumento, el siguiente); implica GPU |
| `lane [N]` | `l` | foco en la lane N (sin argumento, la siguiente); implica GPU |
| `round [N]` | `r` | una instrucción en cada warp que pueda avanzar, en orden de warp; el foco no se mueve |
| `sched [N]` | `t` | N instrucciones del warp que elige el planificador (round-robin); el foco las sigue |
| `warps` | | tabla de warps |
| `lanes` | | registros de todas las lanes del warp (omite las filas a cero) |

**`step` mueve solo el núcleo con foco.** Con el foco en la CPU, la GPU queda
congelada: se ve el `WARP_START` hacer vivos a los warps sin que ejecuten. Con el
foco en la GPU avanza *un warp* —el del foco— y ningún otro, ni el puntero del
planificador. Si ese warp espera en una barrera o ha terminado, el foco pasa al
siguiente que pueda avanzar y la consola lo dice (`el warp 0 espera en una
barrera; sigo con el warp 1`). Para ver el entrelazado sin ir cambiando de warp a
mano hay dos formas: `round` hace avanzar una instrucción a todos los warps
vivos (se ve la tabla entera moverse), y `sched` da el paso que daría el
hardware, eligiendo el planificador y llevándose el foco con él. Los dos paran si
un warp falla (parada total, con el foco en el que falló). Un `step` explícito
ignora los breakpoints. `over`
y `finish` actúan sobre el núcleo con foco; un kernel de `build-c` no tiene llamadas (`kernelcalls` las expande).

**Ejecutar con parte del sistema quieta.** `run` y `until` avanzan CPU y GPU a la
vez. Con un ámbito, solo avanza una parte y el resto queda congelado:

| Comando | Avanza | Para en |
|---|---|---|
| `run gpu [N]` | solo la GPU, con el planificador; la CPU queda donde estaba | breakpoint, `watch`, error, o cuando no quedan warps vivos |
| `run warp [N]` | solo el warp con foco (implica el foco en la GPU) | lo mismo, o cuando ese warp termina o espera en una barrera |
| `until X gpu`, `until X warp` | como los anteriores | además, la dirección X |

Sirven para aislar qué hace la GPU sin que la CPU llegue al sondeo ni al swap.
Con `run gpu` los warps acaban con `WARP_DONE` sin recoger (la CPU no ha hecho el
W1C), y un `run` normal después deja que la CPU lo recoja. Un warp que espera en
una barrera no puede avanzar solo: la parada lo dice, y habrá que avanzar los
demás (`step`, `round`) o usar `run gpu`. Los límites de `N` cuentan
instrucciones de warp.

**Una sola lista de breakpoints.** Es una dirección, y vale para los dos
núcleos: salta el que llegue. Un warp recién lanzado sobre una marca para antes
de ejecutar su primera instrucción —una vez por warp lanzado—, que es como se
llega a la primera línea de un kernel: `break kernel`, `run`. No hay ISA por
núcleo: el listado es el del fuente, y una instrucción que el núcleo no sabe
ejecutar falla al ejecutarla.

**Dos resets.**

| Comando | Qué hace |
|---|---|
| `reset gpu` | blando: descarta warps, errores y barreras; **conserva** descriptores, memoria y la CPU |
| `reset` | duro: RAM a cero, imagen recargada, CPU y GPU como tras el reset del sistema (§19); conserva los breakpoints |

El reset duro no toca el estado de vídeo, serie ni entrada: el anfitrión los
configuró al arrancar y el simulador no tiene un reset de sistema para ellos.

**Paneles.** La tabla de warps está siempre arriba a la derecha: estado
(`LIBRE`, `CONFIG` —descriptor escrito y sin lanzar, con su PC y máscara—,
`READY`, `WAIT_BAR`, `FIN`, `ERROR`), PC, máscara de lanes (`●` activa, `○` viva
pero fuera de la ruta, `·` muerta), profundidades de las pilas SIMT, id lógico y
argumento. Debajo, los registros: los de la CPU, o con el foco en la GPU una
rejilla con una columna por lane del warp (la del foco subrayada, las lanes
inactivas atenuadas, los valores que cambiaron en amarillo y el nombre del
registro en cian si las lanes activas no coinciden). La columna es fija de 84
caracteres: por debajo de unos 140 de terminal el panel de código se queda
estrecho.

**Dos indicadores en el listado.** Entre la marca de breakpoint y la dirección
hay dos columnas: `C` (verde) donde está el PC de la CPU y `G` (azul fijo `#4da3ff`, no un color ANSI: según el tema del terminal `bright_blue` sale blanco) donde está
el del warp con foco, si está vivo. La fila resaltada en inverso sigue siendo la
del núcleo con foco. El listado se centra en esa fila, así que el otro
indicador puede quedar fuera de pantalla: `core` lleva el foco y el listado a él.

**`watch`.** `watch X [N]` vigila N bytes en X (4 por defecto, admite etiquetas) y
para la ejecución cuando su valor cambia, diciendo **quién escribió**:

```text
> watch out
> run
watch 0x00000150: 0x00000000 → 0x00000007 (escrito por GPU warp 0, PC=0x00000048) (31 instrucciones)
```

El foco se va al núcleo que escribió. En la TUI, mientras haya watches aparece
un panel `watch` a la derecha de la memoria (se esconde con `unwatch all`): dos
líneas por watch con el valor actual —en amarillo si cambió con el último
comando— y debajo el valor anterior y quién lo escribió. Caben cuatro. `watch`
sin argumento los lista y
`unwatch [X|all]` los quita. Funciona también con un solo núcleo (entonces dice
solo `PC=...`). Tras un `step` que no pasa por `run`, el cambio se anuncia en la
consola; un `write` o un `set` del propio usuario no es una noticia.
Limitaciones: compara el valor tras cada instrucción, así que una escritura del
mismo valor no se ve; con watches activos `run` va instrucción a instrucción
(en la placa, donde cada lectura es un viaje por el serie, `watch` se rechaza); y
solo mira RAM, no MMIO.

**Escrituras.** `write` va con los permisos de la CPU (`mmio.md` §15): escribir un
descriptor con el warp vivo, o un bloque que la CPU no puede tocar, es un error
normal que se enseña en la consola; no para ningún núcleo.

## Ejecutar la suite de tests

`t.tests` (backends de placa/simulador, casos, runner) tiene su propio
`./test` local; `run-tests` es el mismo script accesible desde cualquier sitio:

```bash
$ run-tests
== Tests unitarios de infraestructura ==
...
== Suite de casos (run_tests.py) ==
...

$ run-tests --quick              # solo los test_*.py, sin simular casos (rápido)
$ run-tests --hardware           # casos contra placa real, backend fpga-gpu
$ run-tests -- --backend fpga-cpu               # passthrough directo a run_tests.py; detecta el puerto FTDI si no pasas --port
```

### Informe de tiempos de todas las suites (`test-timings`)

`test-timings` ejecuta y ordena de mayor a menor todos los tests unitarios
Python del repositorio (por método y con subtotal por carpeta), los bancos RTL de un prototipo (por banco) y los casos de
`t.tests` para `sim-cpu`, `sim-gpu` y `sim-gpu-cycle`. Escribe por defecto
`reports/test-timings.md`. Usa `--jobs 1` por defecto para que el total y los
tiempos individuales no se solapen:

```powershell
.\tools\test-timings.ps1                                  # todo; usa la placa si la detecta
.\tools\test-timings.ps1 --prototype 30                   # solo este RTL
.\tools\test-timings.ps1 --prototype 30 --prototype 29     # RTL CPU y GPU
.\tools\test-timings.ps1 --prototype 30 --cpu-prototype 30 --gpu-prototype 29
.\tools\test-timings.ps1 --skip-hardware                    # no detectar ni modificar la placa
.\tools\test-timings.ps1 --full --json reports/test-timings.json
```

Por defecto detecta un único FTDI: si está conectado, elige el prototipo
registrado de número más alto de cada familia y acepta cargar primero su
bitstream CPU y después el GPU; si no encuentra ninguno, omite hardware sin
fallar. `--skip-hardware` evita incluso la detección y garantiza que no toca la
placa. Al indicar `--cpu-prototype`/`--gpu-prototype` manualmente no carga nada
(`--no-upload`). `--cases RUTA` (repetible) limita los casos, y `--skip-python`,
`--skip-rtl` y `--skip-x-tests` permiten medir una parte. Los bancos marcados
`TEST-LENTO` solo entran con `--full`.

Los casos cuyo `test.json` declara `"slow": "motivo"` se omiten por defecto
en `sim-gpu` y `sim-gpu-cycle`: hoy son las dos imágenes completas, `mandelbrot`
y `mandelbrot-packed`, que dominan el tiempo del informe y ocultan el coste del
resto de la suite. `--full-x-tests` los incluye. Esta
exclusión no se aplica a las placas CPU/GPU, cuyo coste y comportamiento interesa
medir por separado. El runner general ofrece también `--exclude-case RUTA`
(repetible) para excluir un caso o una carpeta en cualquier ejecución, y
`--skip-slow` para respetar la marca declarativa.

No incluye síntesis, lint ni checks de documentación: son validaciones, pero no
tests de ejecución comparables. Tampoco incluye la suite propia opcional de
`u.lcc` ni `13.hdmi/check_timing.ps1`; ambas son proyectos/pruebas independientes
y requieren dependencias o entornos distintos.

## Compilador C experimental (`mini-lcc`)

El fork de lcc con backend MiniISA se integra como submodulo en
`u.lcc`, no dentro de `tools/`: `tools/` conserva solo los lanzadores y la
infraestructura propia del repo. Para inicializarlo:

```bash
$ git submodule update --init --recursive u.lcc
```

La validacion propia del compilador se puede lanzar directamente:

```bash
$ mkdir -p u.lcc/build
$ python3 u.lcc/run-mini-tst.py --simulate
$ python3 u.lcc/run-mini-tst.py --simulate --optimize
$ python3 u.lcc/run-mini-tst.py --simulate --compare-optimizer
```

`--optimize` conserva el `.s` original, genera además un `.opt.s` con
`tools/mini-opt` y valida la forma optimizada. `--compare-optimizer` genera las
dos y, con `--simulate`, valida ambas contra las mismas expectativas, además de
mostrar el total de instrucciones antes y después. Sin ninguna de esas opciones
el comportamiento sigue siendo el histórico. Se puede pasar otra ubicación con
`--mini-opt RUTA`.

O mediante el wrapper global:

```bash
$ mini-lcc-test
```

Para compilar un programa C a ensamblador MiniISA:

```bash
$ mini-lcc programa.c -o programa.s
```

Por ahora esta validacion comprueba compilacion y simulacion dentro de
`mini-lcc`. El siguiente paso sera usarlo para producir `.asm`, `.bin` o
manifiestos `.json` desde programas C y alimentar con ellos los simuladores y
las suites de `t.tests`.

## Un programa entero en C: `mini-cc`

Para un programa con CPU y kernels de GPU en C, `mini-cc` encadena `mini-lcc`, `mini-opt` y `mini-asm`
(las tres piezas se explican en la sección siguiente) y añade el runtime de la GPU:

```bash
$ mini-cc programa.c                          # -> _build/c/programa.bin (simulador); sin GPU
$ mini-cc programa.c runtime/src/gpu.c runtime/src/gpu_runtime.inc runtime/src/bench.inc   # con el runtime de la GPU
$ mini-cc programa.c ... --board              # -> _build/c/programa_board.bin (placa 36)
$ mini-cc programa.c ... --load               # compila con --board y lo sube a la 36 (como board-load)
$ mini-cc programa.c ... --load 37 --no-run  # a la 37, sin arrancarlo
$ mini-cc programa.c ... --outdir out -I inc --data tex=tex.bin
$ mini-cc test.c biblioteca.c                # varias unidades: la primera lleva main y da el nombre
```

Compila lo que se le pide y nada más: cada `.c` con `mini-lcc --no-crt`, y una sola llamada a `mini-opt` con todos
los `.s`, que los junta y optimiza el programa entero. Los demás ficheros (`.s`, `.asm`, `.inc`) no se optimizan: se
`.include`n tal cual tras el código, en el orden dado. Lo único que se pone solo es el arranque
(`runtime/src/crt0.s`), primero, cuando hay algún `.c`. El runtime de la GPU se pide explícitamente: `gpu.c`
(`gpu_launch` y `__gpu_stack`, los 32 KiB de pila de los kernels), `gpu_runtime.inc` y `bench.inc`; los Makefile que
usan `tools/c-program.mk` lo pasan con `$(GPU_RUNTIME)`. Un programa que no lanza la GPU desde C no lo necesita
(el scheduler y su demo ocupan la mitad). La biblioteca C mínima es `string.c` (`runtime/src`, cabecera `string.h`), que
también se pide. Las cabeceras `gpu.h`, `mmio.h` y `string.h` de `runtime/include` entran siempre en el `-I`; `-D NOMBRE[=VALOR]`
define una macro en todas las unidades.

- **`--board`** hace `.define BOARD` en el `.asm` generado: lanzar la GPU con `RUN` (la 36 no tiene `WARP_START`) y
  `bench_now()` con los ciclos reales de CPU. La salida se llama `<nombre>_board.bin`.
- **`--data ETIQUETA=FICHERO`** (repetible): pega un binario tras el código con `.incbin`. El C lo declara con
  `extern unsigned etiqueta[]`. `mini-cc` no ejecuta generadores: los datos los prepara quien llama.
- **`--outdir DIR`**: dónde dejar los intermedios (`.s`, `.opt.s`, `.asm`, `.bin`, `.hex`). Por defecto, `_build/c/`
  en la raíz del repo, que git ignora. **`-I DIR`** (repetible): cabeceras propias, además de `runtime/include`.
- La lógica es `tools/mini_cc.py` (`build()`, `wrapper_path()`), que usan los tests de la 32 y los `compare*.py`.

El ensamblador acepta `.ifdef`/`.ifndef`/`.else`/`.endif`, `.define SIMBOLO` y `-D SIMBOLO` (ver `1.isa/mini_asm.py`);
así `gpu_runtime.inc` y `bench.inc` sirven al simulador y a la placa con un solo fichero.
Ejemplos en `t.tests/cases-cpu-gpu/programas-en-c.md`; los números, en `32.cpu-gpu-func-sim/compare/README.md`.

## Compilar C para la CPU y la GPU: `mini-lcc --no-crt`, `crt0` y `mini-opt`

Tres piezas pequeñas entre el compilador y el ensamblador:

```bash
$ mini-lcc host.c --no-crt -o host.s          # sin _start ni __stack
$ mini-lcc kernels.c --no-crt -o kernels.s
$ mini-opt kernels.s -o kernels.opt.s --stats # pases sobre el .s
$ cat programa.asm
    .include "crt0.s"                         # primero: _start en la direccion 0
    .include "host.s"
    .include "kernels.opt.s"
$ mini-asm programa.asm -I runtime/src -o programa.bin
```

- **`-I DIR`** (repetible): carpeta extra para `#include "..."`, además de la del propio fuente.
- **`--no-crt`** (`rcc -crt=none`): el compilador no emite `_start` ni `.comm __stack`. El
  arranque es `runtime/src/crt0.s` (pone la pila, llama a `main`, para). Sin la opción el
  compilador sigue emitiéndolo como siempre.
- **Juntar `.s`:** con `.include`. Las etiquetas `L.n` que lcc numera desde 1 en cada
  compilación son privadas de cada fichero incluido (el principal conserva las suyas), así
  que dos `.s` no chocan. Los `static` de C sí chocarían (el ensamblador no sabe de ellos): `mini-cc`
  los renombra a `<nombre>.<unidad>` en cada unidad (lo que lcc no marca con `.globl`).
- **Varios `.s` en `mini-opt`:** `mini-opt a.s b.s -o todo.s` los junta en ese orden (renumera
  las `L.n` y `__sf.n` de los siguientes, empieza cada uno en `.text`) y optimiza la unión
  como un programa. Si dos `.s` definen el mismo símbolo, error. `mini-cc` lo hace así con
  todas las unidades `.c` y deja un solo `<programa>.opt.s`; los `--extern-refs` son solo el
  arranque y los ficheros a mano (`.s`, `.inc`).
- **`--whole-program` y el pase `deadfuncs`:** dice que los `.s` de entrada son todo el programa. Entonces
  `deadfuncs` (primero del pipeline y otra vez tras `tailcalls`, cuando el `inline` ha dejado funciones sin llamadas)
  borra las funciones que no alcanza ninguna raíz: lo que nombran los `--extern-refs` (el arranque llama a `main`; sin contar
  sus comentarios), los kernels (`__kernel_*`, que los lanza el anfitrión por su etiqueta) y lo que un dato mencione
  (`.word f`), y lo que esas funciones llamen o cuya dirección tomen. Los datos no se tocan, porque los anfitriones
  leen globales por su etiqueta. Sin la bandera no hace nada, porque en un `.s` suelto cualquier función pública
  puede llamarla otra unidad. `mini-cc` la pone siempre. Con el scheduler, la demo ahorra 156 instrucciones
  (`gpu_cancel`...).
- **`mini-opt`** transforma un `.s` en otro con pases (`--list-passes`). Hoy `intrinsics`: el
  C declara `extern volatile int __gpu_tid;` y lo lee como una variable; el pase convierte
  `LI r,__gpu_tid ; LOAD d,r,0` en `GETTID d` (también `__gpu_lane`, `__gpu_warp`,
  `__gpu_lwarp`, `__gpu_arg`, y `__gpu_bar = 0;` pasa a `BAR`). Rechaza la dirección de un
  intrínseco o un temporal que siga vivo. El código es un paquete, `tools/mini_opt/`, con un fichero
  por pase en `passes/` (`intrinsics`, `kernels`, `stackslots`, `jumps`, `constprop`, `dce`,
  `copyprop`, `boolean`, `forward`, `deadstores`, `branches`, `unreachable`, `argblock`, `strength`, `licm`, `noalias`, `sharebase`, `deadsaves`, `inline` (y `kernelcalls`), `leafregs`, `tailcalls`,
  `deadfuncs`, `invert`, `ssy`, `lanestack`, `marks`) y,
  aparte, el troceado en funciones (`model.py`), qué lee y escribe cada instrucción (`isa.py`), el
  grafo de flujo y la vida de registros (`flow.py`) y la línea de órdenes (`cli.py`). Para añadir una
  transformación: un fichero en `passes/` con una función `@register_pass` y su `import` en
  `passes/__init__.py`.

- **Pase `inline`:** lcc no expande nada en línea. Tras `deadsaves`, cuando las hojas ya no
  tienen marco, cada `JAL R31, f` a una hoja de la unidad de hasta 8 instrucciones (sin llamadas,
  sin tocar R30 ni R31 y que solo salta a sus etiquetas) pasa a ser su cuerpo, con etiquetas `L.n`
  nuevas y cada `JR R31` saltando detrás de la llamada; luego `copyprop`, `dce`, `jumps` y
  `deadsaves` limpian. Recupera menos que escribir una macro: llega después de que lcc haya
  repartido los registros contando con la llamada (valores en R16–R29, guardados en la pila).
  Eso lo arregla en parte `leafregs`.
- **Pase `leafregs`:** en una función sin llamadas (nunca las tuvo o `inline` las expandió),
  los R16–R29 que guarda pasan a un R3–R15 que no interfiera con ellos (la vida de registros dice
  que nunca llevan valores a la vez) y se borran el guardado y la restauración, sea una copia
  (`stackslots`) o un `STORE`/`LOAD` en la pila; el guardado de R31 se borra sin más y, si nada
  más lee la pila, el marco también.

- **Pase `kernelcalls`:** en un kernel, cada `JAL R31, f` pasa a ser el cuerpo entero de `f` (marco
  incluido: `JAL` no cambia R30, así que hace lo mismo que llamada), y lo que este llame, a su vez; los
  kernels se compilan para la GPU de la 36, que no tiene `JAL` (el simulador 11 y la 37 sí). Sin llamadas, nadie lee R31: se borran sus guardados.
  Error si `f` es de otra unidad, recursiva, de ABI privada o salta por un puntero. Va antes de
  `kernels`, que sigue el valor de R30 por cada instrucción para no confundir los marcos expandidos con
  el del kernel, y reserva en la pila de la lane los 16 bytes donde lcc guarda R1–R4.
- **Pase `kernels`:** una función `__kernel_<nombre>` (la macro `KERNEL` de
  `runtime/include/gpu.h`) pasa a ser el punto de entrada de una lane: fija su
  pila (solo si la usa: el marco que solo guarda y restaura registros preservados se quita),
  carga desde `GETARG` los parámetros `R1`–`R4` que el cuerpo lee, cambia `SHLI`/`SHRI`/`SARI`
  por los desplazamientos con registro que tiene la GPU, y sustituye `JR R31` por `EXIT`. Da error
  si el kernel usa una instrucción que la GPU del prototipo no ejecuta o pide más de 4
  parámetros. `__gpu_nthreads` (nwarps × nlanes del lanzamiento) es un intrínseco compuesto.
  Ejemplo completo en `t.tests/cases-cpu-gpu/`.

- **Pase `ssy`:** pone `SSY` delante de los saltos de un kernel que pueden divergir, con su
  postdominador inmediato como punto de reconvergencia; en un bucle, una sola vez antes de él.
  Un análisis de qué registros varían entre lanes (`GETTID`, `GETLANE`, y lo definido bajo un
  salto divergente) evita marcar los saltos uniformes. De la pila sigue cada hueco: lo que se lee
  varía solo si lo que se guardó variaba (si una dirección de la pila se escapa, varía todo lo que se
  lee de ella); así los parámetros por la pila de una función expandida por `kernelcalls` no abren
  regiones. `--ssy-all` los marca todos. Quita
  además el `SSY` que cae siempre después de otro con el mismo destino. Si se entra en un bucle divergente
  desde un salto condicional (`if (...) ... else for (...)`), el `SSY` no puede ir delante del salto, porque
  abriría la región también en el camino que no entra: va en un trampolín (`SSY join; BRA cabecera`) al final
  de la función, al que se redirige el salto. Al final comprueba que ningún `SSY` puede abrir su región con
  la pila de regiones llena (8 niveles en la 36, la 37 y los simuladores): una cota de las regiones que lo
  contienen. Pasarse es un error al compilar, con la función expandida de la que viene el salto.

- **Pase `lanestack`** (kernels, al final): error si los marcos de las funciones expandidas por `kernelcalls`
  hacen bajar R30 más de lo que tiene la pila de la lane (512 bytes menos los 16 del hueco de R1..R4), o si un
  acceso a la pila cae fuera de ella. Sin la comprobación, una lane escribiría en la pila de la siguiente sin
  aviso. Si R30 no se puede seguir, no comprueba nada (`lanestack.unknown` en `--stats`).

- **Pase `marks`** (el último): `inline` y `kernelcalls` apuntan en cada línea que copian de qué funciones viene
  (`Line.origin`), y este pase pone una etiqueta `__inl$<unidad>$<función>$<n>$<f1>$<f2>...` donde cambia (sin
  funciones detrás de `<n>`, de vuelta en la propia). Es para el perfil (`--profile` de los simuladores). Va al
  final porque una etiqueta parte un bloque básico, y no cambia el binario. Una línea que ha creado un pase no
  trae origen: toma el de sus vecinas si coinciden.

- **Pase `licm`** (todas las funciones): en cada bucle sin llamadas saca al preheader
  las instrucciones puras cuyos operandos no cambian en él (constantes, `SHL p, cstep, c`, productos como
  `MUL t, lane, dux`...), en un
  registro que el bucle no usa (R5..R15; en un kernel también los R16..R29 libres) y cuando cada uso
  viene solo de esa definición. Va de dentro afuera: lo que el bucle interior deja en su preheader está en el
  cuerpo del exterior y, si tampoco cambia allí, sube otra vez (en la rotación y el cubo, lo que no depende de
  la fila: el reparto por `lane`, `4 * lane`, los límites). Un cero pasa a `R0`. No toca `DIV`/`REM`. Las cargas, solo en un kernel y solo si la base es la
  dirección de un símbolo que el kernel solo lee (todos los usos de `LI base, símbolo+K` en la función son
  `LOAD`, por cualquier camino) y que **ningún puntero puede alcanzar**, lo que se demuestra con la unidad entera:
  el símbolo está definido en ella, su dirección no escapa de ninguna función (solo se usa como base de
  `LOAD`/`STORE`, directamente o en un puntero calculado a partir de ella, `&tabla[i]`, que a su vez solo
  se usa así o se compara; no se suma a otra cosa, ni se guarda, ni se pasa, ni se devuelve, ni está en un
  `.word`), no es `volatile` y ningún fichero ajeno a la unidad lo nombra (`--extern-refs FICHERO`, repetible: el
  arranque, el runtime de ensamblador, la otra unidad). `volatile` es un hecho que lcc escribe en un comentario
  (`; @miniopt volatile NOMBRE`, que el ensamblador no ve), porque el `.s` ya no lo dice. Quedan dos supuestos que
  ningún análisis del texto puede comprobar: que nadie escriba el símbolo mientras el kernel corre (la CPU, el DMA,
  otro agente) y que no se fabrique un puntero a partir de un entero. Con `--assume-noalias` basta que el kernel no
  escriba el símbolo, aunque su dirección escape o lo nombre código ajeno; un `volatile` no se saca nunca.
  `mini-cc` pasa `--extern-refs` con el arranque y los ficheros a mano (las unidades `.c` ya están juntas), y deja la suposición
  apagada (`MINI_OPT_NOALIAS=1` la enciende). Las direcciones que solo servían de base a lo que sale del bucle
  quedan muertas: las borra el `dce` que viene detrás en el pipeline.
- **Pase `stackslots`:** lcc deja en la pila lo que no cabe en los registros, y en un kernel cada lane tiene
  su porción a 512 bytes de la siguiente (un acceso de un warp son 8 transacciones). Los huecos de pila
  que son una palabra a un desplazamiento fijo de `R30`, a los que solo se accede con `LOAD`/`STORE` de
  palabra y de los que nadie toma la dirección, y alguno de cuyos accesos está en un bucle, pasan a un
  registro que ninguna instrucción de la función menciona (`LOAD Rd, R30, k` es `ADD Rd, Rp, R0`; `STORE
  Rs, R30, k` es `ADD Rp, Rs, R0`); `constprop` y `copyprop`, que van después, quitan las copias. Si caben
  también los huecos que no están en bucles, se llevan todos y desaparece el marco entero (los `ADDI R30,
  R30, ±n` y, en un kernel, la preparación de la pila de la lane). Para saber a qué hueco apunta un acceso
  sigue cuánto vale `R30` por el grafo de flujo; si dos caminos no coinciden, o `R30` se toca de otra forma
  que en la preparación del principio, no hace nada. Registros: en una función normal solo R1..R15 y sin
  llamadas; en un kernel también R31 y los R16..R29 que sobren. Los huecos más calientes (los accesos
  dentro de bucles pesan 10 por nivel de anidamiento) se llevan primero. El área desde `R30` de
  entrada +16, reservada por MiniABI para los argumentos 5+, nunca se promociona: pertenece al
  llamador y no es un slot privado inicializado por la función.
- **Pase `sharebase`:** lcc carga cada campo de una tabla con su propio `LI` (`LI R12, cube_faces+4 ; LOAD
  R12, R12, 0`). Dentro de un bloque, los `LI simbolo+K` del mismo símbolo cuyo registro solo se lee como
  base de `LOAD`/`STORE` (y no sale vivo del bloque) se cambian por un único `LI base, simbolo` en un
  registro que nadie toca durante el tramo, y cada acceso suma su `K` al desplazamiento. Necesita al
  menos dos `LI` del mismo símbolo y un registro libre (los mismos que `licm`; en un kernel también los
  R16..R29 sin uso); si no lo hay, no hace nada. Va después de `licm`, que se queda primero con los
  registros que necesita para sacar cosas de los bucles.
- **Pase `constprop`:** donde un registro vale una constante por todos los caminos, `ADD`, `SUB`, `AND`,
  `OR` y `XOR` pasan a su forma con inmediato, y `SHL` por 1 a `ADD d, a, a`; la constante, si ya nadie la
  lee, la elimina después el pase `dce`. Con la misma información: se quita un `MOVI`/`LI` que carga lo que el registro ya vale
  (`redundant`); si los dos operandos son constantes la operación se hace en el filtro y queda un
  `MOVI`/`LI` (`evaluated`, con la aritmética de 32 bits de la máquina; una copia `ADD d, x, R0` no se
  evalúa, es lo que sigue `copyprop`); `x+0`, `x-0`, `x|0`, `x^0`, `x<<0`, `x*1` y `x&-1` pasan a una
  copia (o se borran si `d` es `x`) y `x*0`, `x&0`, `x-x` y `x^x` a un cero (`identities`); y
  `MUL d, a, K` seguido de `SHL d, d, S` queda `MUL d, a, K<<S`, con la constante recargada ya
  desplazada antes del `MUL` (`fused`; solo si ese registro no se lee después).
- **Pase `copyprop`:** propagación de copias (`ADD d, s, R0`: donde llega por todos los caminos, los
  usos de `d` leen `s`) en todas las funciones. Una copia que queda de un registro sobre sí mismo
  también se borra; la DCE general queda en su pase propio.
- **Pase `branches`:** resuelve branches cuyos operandos son constantes o el mismo registro; los que
  siempre se toman pasan a `BRA` y los que nunca se toman desaparecen.
- **Pase `unreachable`:** elimina bloques que dejan de ser alcanzables, en particular tras simplificar
  branches. Las funciones con saltos indirectos se dejan intactas.
- **Pase `deadfuncs`:** solo con `--whole-program`, que promete que los `--extern-refs` son todo el resto del
  programa (el arranque, el runtime y las otras unidades); sin esa promesa no borra nada, porque que un fichero
  pasado no nombre una función no demuestra que no la use otro que no se ha pasado. Como un enlazador: las raíces
  son lo que se nombra fuera de las funciones de la unidad (`main` en el arranque, un `.word f` en una tabla de
  datos) y los kernels (`__kernel_*`), que son puntos de entrada aunque los lance alguien de fuera del programa
  (los arneses de `32.cpu-gpu-func-sim/compare` los lanzan desde Python), y se borran las funciones que no se alcanzan desde ellas siguiendo lo que nombra cada cuerpo, aunque se
  llamen entre ellas. Las declaraciones (`.globl`, `.extern`) y los comentarios no cuentan como uso; al borrar
  una función se va su `.globl`, esté donde esté, y se quedan sus cambios de sección. Las referencias ajenas son
  los `.s` de las otras unidades sin optimizar, así que puede sobrar algo, pero nunca se borra código vivo.
  `mini-cc` pasa siempre `--whole-program`: de la biblioteca C mínima (`runtime/src/string.c`) solo se queda lo que\n  el programa usa.
- **Pase `dce`:** elimina a punto fijo instrucciones puras cuyo resultado ya no está vivo. Es un pase
  independiente y el pipeline por defecto lo intercala entre fases para que una limpieza abra nuevas
  oportunidades a la siguiente; `--passes` permite colocarlo donde convenga.
- **Pase `tailcalls`:** una `JAL` directa en posición final pasa a restaurar el epílogo y hacer `BRA`
  al destino. Solo actúa sobre el epílogo canónico de LCC, con destino definido en la misma unidad,
  sin argumentos de pila, varargs ni punteros al frame actual; helpers de ABI privada y llamadas
  indirectas quedan fuera.
- **Pase `jumps`:** `BRA` a una etiqueta que solo salta, va al destino final; `BRA` a la línea
  siguiente se quita.
- **Pase `forward`:** reenvío de store a load sobre huecos de la pila. `STORE R1, R30, 32 ... LOAD R1, R30, 32`
  deja de leer la memoria (el `LOAD` sobra) y `LOAD R5, R30, 32` pasa a `ADD R5, R1, R0`; una segunda carga
  del mismo hueco copia a la primera. Es el análisis `forward_must` sobre el CFG con el estado
  `{desplazamiento: registro con el mismo valor}`, válido solo si lo es por todos los caminos. Lo invalidan:
  que se reescriba el registro, otro store sobre esa palabra (o de otro ancho, o con desplazamiento simbólico),
  cualquier llamada, un cambio de R30, y un store por puntero si el hueco está en o por encima de la dirección
  de marco más baja que la función calcula (si calcula R30 de otra forma, caen todos). Solo palabras con
  desplazamiento numérico múltiplo de 4. Va antes de `constprop` y `copyprop`, que limpian las copias.
- **Pase `deadstores`:** tras `forward`, el `STORE R1, R30, 32` con que lcc vuelca un argumento a su hueco
  deja de leerse. Se borra un `STORE` de palabra a un hueco por encima del marco (desplazamiento ≥ n, con
  `ADDI R30, R30, -n` al entrar: el área de parámetros del llamador, que el destino puede pisar) cuando
  ninguna instrucción de la función lee esa palabra con ningún ancho y nadie calcula la dirección de ese
  hueco ni de uno anterior del área (`va_start`, `&param`). Por debajo del marco no toca nada: ahí está el
  área saliente, que lee el destino de la llamada, además de los guardados y los locales. Si R30 cambia
  de otra forma que el ajuste canónico, o se usa de una forma que no se sigue, no toca la función.
  Es una condición de toda la función, sin CFG ni liveness.
- **Hechos de lcc (`; @miniopt volatile NOMBRE`, `; @miniopt const NOMBRE`):** comentarios que el ensamblador no ve y `parse_unit` lee en
  `Unit.volatile` y `Unit.const`. Un objeto `const` (o un array de const; un struct solo si lo es entero) no lo escribe nadie, así que `licm`
  saca de un bucle, en cualquier función, su lectura a una dirección fija; si es además `volatile`, gana `volatile`. Un puntero a `const`
  no se exporta: otro puntero puede escribir en el objeto.
- **Intrínseco `NOALIAS(p)` y pase `noalias`:** `restrict` no existe en C89, así que `gpu.h` define `NOALIAS(p)` como
  `__noalias_mark = (int)(p)`. `intrinsics` lo convierte en una marca interna `NOALIAS Rp` (que lee `p`, así que sigue vivo hasta ella) y el
  pase `noalias` las borra al final (`optimize` las borra aunque no se pida el pase). Es la promesa de `restrict`: lo que se accede por `p`
  o por un puntero calculado a partir de él no se accede por ningún otro mientras dure la función. El análisis de procedencia
  (`passes/noalias.py`) da a cada registro el conjunto de regiones marcadas de las que puede derivar: la marca vale para el *valor* (todas
  sus copias, aunque lcc use el registro original), `p + índice` deriva de `p`, y lo que se guarda en memoria, se pasa a una llamada y se
  vuelve a cargar conserva la región. Dos accesos no se estorban si sus procedencias no comparten región y alguna no está vacía. `licm` lo
  usa para sacar de un bucle una carga invariante por un puntero marcado o por un símbolo que no sea `volatile` cuando ningún store del
  bucle (salvo los del marco) puede tocar lo mismo; sin marca ni símbolo no se toca (podría ser un dispositivo). Si se marca mal el
  resultado es incorrecto sin aviso. Solo con mini-opt, que es quien borra la escritura.
- **Pase `argblock`:** contrato de los kernels: el bloque de argumentos (lo que devuelve `GETARG`) no se escribe mientras el kernel
  corre, como la memoria constante de CUDA. Así, `GETARG` y cada `LOAD` cuya base sale de él son invariantes de un bucle aunque haya
  `STORE` por punteros dentro (el compilador no puede demostrar que no escriben en el bloque: los punteros de salida salen del propio
  bloque y todo es `int`). Se suben al preheader solo ellos. Va antes de `strength` porque el paso `x += nlanes` se releía en cada vuelta
  y mientras no sale del bucle no es invariante, y porque `licm`, que sube lo demás, se queda con los registros libres. `licm` aplica
  el mismo contrato después. Solo en funciones `__kernel_*`. Cuidado con un kernel que escriba resultados en su bloque: el contrato
  lo prohíbe.
- **Pase `strength`:** reducción de fuerza de los accesos indexados de un bucle. lcc compila `a[(y + 1) * 168 + 8 + x + k]` con la
  cuenta entera de cada acceso (`ADD`, `SHL`, `ADD` de la base y el `LOAD`, 4 instrucciones donde a mano es una). Si el bucle tiene una
  variable de inducción (`ADDI i, i, c`, su única escritura, en el único bloque con arista de vuelta) y la dirección es una suma de
  registros invariantes, `i` y una constante (`ADD`, `ADDI`, `SUB`, `SHL`/`SHLI` y `MUL` por constante, evaluados dentro de un bloque), los
  accesos con los mismos invariantes y coeficientes (las vecinas `x - 1`, `x`, `x + 1`) comparten un puntero: el preheader lo deja en
  `sum(...) + coef * i0 + const_minimo` y el último bloque lo avanza `coef * c`; cada acceso pasa a `LOAD v, P, const - const_minimo`, y el DCE
  borra las cuentas que quedan sin uso. Cada grupo se prueba sobre una copia y se acepta solo si el bucle queda más corto (con doble peso
  en los bloques que se ejecutan en cada vuelta); necesita un registro libre para el puntero (y otro de apoyo para el preheader), por eso va
  antes de `licm`, que se queda con los que sobran. El paso de la variable puede ser una constante (`ADDI i, i, c`) o un registro que el
  bucle no escribe (`ADD i, i, s`, el `x += nlanes` de un kernel): el puntero avanza entonces `coef * s`, un registro que se calcula una vez en
  el preheader y se comparte entre grupos. No toca bucles con llamadas ni con más de una arista de vuelta. En la vida de Conway en C
  con índices: 2,30× → 1,13× el ensamblador en la CPU.
- **Pase `deadsaves`:** un `R16..R29` que la función guarda en el prólogo y restaura en el epílogo, pero que
  no aparece en ninguna otra instrucción, pierde el `STORE` y los `LOAD`. Lo dejan así `copyprop` y `dce` al
  borrar el último uso (el `.s` de lcc no los tiene). El `JR` lo lee por convenio y no cuenta como uso; no
  hace falta liveness. Respeta el hueco: si otra instrucción lo lee, lo escribe o calcula su dirección, o hay
  un desplazamiento simbólico de pila, no toca nada. El marco no se encoge. Va antes de `tailcalls`, que así
  copia epílogos más cortos.
- **Pase `invert`:** `Bcc a,b,L1 ; BRA L2 ; L1:` pasa a `B!cc a,b,L2 ; L1:` (la condición contraria
  salta a `L2` y si no, cae en `L1`, que se queda por si tiene otras referencias). Solo si `L2` es una
  etiqueta de la misma función y esta tiene menos de 32.000 instrucciones, porque un branch
  condicional alcanza ±128 KiB y `BRA` mucho más. Va el último antes de `ssy`.
- **Pase `boolean`:** un branch que decide entre cargar 1 y cargar 0 (`Bcc a,b,Lf ; MOVI r,1 ; BRA Le ;
  Lf: ; ADD r,R0,R0 ; Le:`, como lcc evalúa `x = a < b`) pasa a `SLT`/`SLTU`: BLT/BGE/BLTU/BGEU en una
  instrucción (más un `XORI r,r,1` si el sentido es el contrario) y BEQ/BNE en `SUB` + `SLTU r,R0,r` (sin
  el `SUB` si un operando es R0). No necesita liveness: `r` se escribe por los dos caminos y la secuencia
  nueva no toca nada más. Solo actúa si nadie más salta a `Lf`; `Le` y las demás etiquetas se quedan.
- **`--stats`:** una línea por pase con las instrucciones que añade o quita y sus contadores
  (`mini-opt k.s --stats`); `32.cpu-gpu-func-sim/compare/opt_stats.py` lo junta con las
  instrucciones ejecutadas en el simulador, con y sin los pases.

Pruebas: `t.tests/unit/compiler/test_mini_opt.py` y `t.tests/unit/compiler/test_crt0.py` (la parte que pasa por `rcc`
necesita MSVC y se omite sin él). `TuiDemoTest`, en `test_mini_opt.py`, compila la demo de `v.tui`
con y sin los pases y exige la misma pantalla, menos instrucciones ejecutadas (−16,0 % medido) y un
binario menor (−5,6 %).

## Build con historial de timing, en segundo plano, estado, logs

`tools/build` (con `tools/build_report.py`) es común a cualquier prototipo con
`apio.ini` — no hace falta copiar nada a su carpeta. Sintetiza con apio,
resume Fmax/LUT/FF/camino crítico y archiva un historial reproducible en
`<prototipo>/reports/`:

```bash
$ build --prototype 17 --label synth --background
Using prototype: 17.fpga-gpu-ram-v2
Started build: 20260915-001203-synth
Status: .../reports/20260915-001203-synth/status.json
Log: .../reports/20260915-001203-synth/build.log
```

`--archive-only` archiva los resultados existentes sin volver a sintetizar.
Por defecto se reutiliza el último informe detallado si sus hashes coinciden
con el RTL, constraints y opciones actuales. Si no coinciden, ejecuta PNR
detallado y guarda el log completo. `--no-incremental` fuerza siempre un PNR
detallado nuevo; `--incremental` fuerza una ejecución usando la caché interna
de Apio y no pide el progreso detallado de routing.
Funciona igual sin `--background` (bloquea hasta terminar, con la misma
salida por pantalla).

Para reconstruir todos los prototipos que declaran un proyecto Apio:

```powershell
.\tools\build.ps1 --all
```

Los recorre en orden numérico y de forma secuencial, crea una entrada de
`build-list` por prototipo, continúa si alguno falla y muestra un resumen al
final. `--all` no admite `--background`, para no lanzar varias síntesis FPGA
simultáneas accidentalmente.

Desde otra terminal (o desde otro directorio: `build-status` también acepta
`--prototype` para encontrarlo sin tener que estar dentro de la carpeta):

```bash
$ build-status --prototype 17
Prototype: 17.fpga-gpu-ram-v2
Label: synth
State: running
PID: 47021
Elapsed: 02:14
Recent output:
...

$ build-log --prototype 17 --lines 50
$ build-log --prototype 17 --follow        # como tail -f / Get-Content -Wait
$ build-list --prototype 17                # builds anteriores, más nuevo primero
$ build-list --prototypes                  # una fila de estado por prototipo RTL
$ build-stop --prototype 17                # SIGTERM al build activo
```

`build-list --prototypes` cruza el último intento registrado con el bitstream
local y el informe archivado. Distingue `CURRENT`, `STALE` y `MISSING` del
estado del último build (`SUCCESS`, `FAILED`, `TIMING_FAIL`, `RUNNING`,
`INTERRUPTED` o `NEVER`), y muestra timing, Fmax requerida/alcanzada del reloj limitante,
la semilla fija de NextPNR (o `-` si no hay ninguna), duración, fecha y
etiqueta. Es una consulta: no lanza ni detiene builds.
Cuando el build produjo un resultado válido pero no alcanzó la frecuencia
requerida, `LAST BUILD` muestra `TIMING_FAIL` en amarillo y la columna
`TIMING` conserva `FAIL` en rojo; `FAILED` queda reservado para errores sin
un informe de timing válido.
La fecha se convierte a la zona horaria local del ordenador.
En una terminal colorea los estados (`CURRENT`/`SUCCESS`/`PASS` en verde,
obsoletos o interrumpidos en amarillo, fallos o ausencias en rojo y builds
activos en cian); al redirigir la salida no emite secuencias ANSI. Si hay algún
build activo, lo anuncia sobre la tabla y marca su fila con `*`. La variable
de entorno `NO_COLOR` desactiva también el color interactivo.

`--background` devuelve el control enseguida: crea `status.json` de inmediato
y sigue el proceso en segundo plano de verdad (grupo/sesión propios), no
bloquea la terminal que lo lanzó. Si lo paras con `build-stop`, el estado
queda en `stopped`, no en `failed`.

Al consultar el historial, un registro que siga marcado como `running` pero
cuyo PID ya no exista se corrige y persiste como `interrupted`. Esto recupera
los estados que quedan huérfanos tras cerrar una terminal, reiniciar el equipo
o terminar externamente el proceso de seguimiento.

Los backends de placa usan este mismo camino cuando necesitan reconstruir un
bitstream antes de programarlo. Esa síntesis automática aparece por tanto en
`build-list`, con etiqueta `auto-upload`, y genera el mismo archivo de timing
que un `build --prototype N` explícito.

Cuando ya no necesitas builds antiguos:

```bash
$ build-clean --dry-run                  # qué borraría, sin borrar nada
$ build-clean --prototype 17 --keep 5 --keep-reports 3 --yes
```

`build-clean` limpia dos cosas. Los logs de ejecución de `reports/` en la raíz
(`--keep`, 10 por defecto, `--older-than`, `--max-size`) y los archivos de build
de `<prototipo>/reports/`. De estos conserva completos los `--keep-reports`
(2) más recientes, el último que cumplió timing y los que aún no tienen
`metadata.json` (build en curso). En los demás borra solo lo pesado
(`hardware.json`, `.config`, `.pnr` y las carpetas `sweep-*`) y deja
`summary.*`, `metadata.json`, `build.log` y `sources.zip`; con `--full` borra
la carpeta entera. Nunca borra sin `--yes`.

## Suite de un prototipo (`test`)

Igual que `build`: común a cualquier prototipo, sin copiar nada a su carpeta.
Cada paso se salta con claridad si no aplica — no todos los prototipos tienen
fixtures, `test_*.py` propios o `apio.ini`:

```bash
$ test --prototype 21
Using prototype: 21.fpga-cpu-hdmi-alu
== tests Python
...
== regresión RTL (apio test)
...
OK

$ test --prototype 6 --quick          # solo fixtures + tests Python, sin apio test
$ test --prototype 21 --lint          # añade apio lint
$ test --prototype 22 --full          # incluye los bancos lentos (alias: --slow)
$ test --prototype 17 --background    # se sigue con build-status/build-log, igual que build
```

Orden de pasos: fixtures (si algún banco del prototipo incluye `fixtures/count.vh`,
las genera `tools/make_rtl_fixtures.py --prototype N`, ver
[Fixtures diferenciales de RTL](#fixtures-diferenciales-de-rtl-make_rtl_fixtures-y-fixtures-report);
si no, el `make_fixtures.py` propio, si existe) → `test_*.py` propios por
`unittest discover` (si hay alguno) → `apio test` (regresión RTL contra los
testbenches del `apio.ini`, salvo `--quick`) → `apio lint` (solo con
`--lint`). Un prototipo sin nada de eso —`test_*.py` ni `apio.ini`— avisa y
sale en `OK` en vez de fingir que probó algo.

### Bancos lentos (`TEST-LENTO`)

Un banco que lleve `TEST-LENTO` en un comentario queda **fuera de la pasada
normal**; `--full` (o `--slow`) lo mete de vuelta. Sirve para los bancos que
simulan una carga realista entera y cuestan minutos: hoy solo
`22.fpga-gpu-bl8/gpu_plasma_tb.v`, con 463 s, la mitad de la suite del
prototipo.

La marca va **dentro del banco, con el motivo al lado**, no en una lista
aparte: una lista se desincroniza en cuanto alguien renombra o borra un banco y
el filtro deja de filtrar sin que nadie se entere. Al omitir alguno, `test`
dice cuál y cómo pedirlo.

Con `--jobs 1`, un prototipo sin ningún banco marcado hace una sola llamada a
`apio test`, y el recorrido por bancos sueltos solo se usa cuando hay algo que
excluir. Con el valor por defecto (`--jobs 2`) los bancos se reparten como se
explica abajo.

Al marcar uno, deja cubierto lo mismo por otro lado. `gpu_plasma_tb` tiene a
`gpu_plasma4_tb`, que corre el mismo camino con 24 filas en vez de 240 (~50 s).

### Bancos en paralelo (`--jobs`)

`test` reparte los bancos RTL en `--jobs N` grupos (por defecto 2) que corren a
la vez. Cada grupo es **una** invocación de `apio test` sobre su **propia copia**
de la carpeta del prototipo, y no sobre la real: apio/scons guardan estado en el
proyecto y dos `apio test` sobre la misma carpeta se pisarían. Las copias son
hermanas de la carpeta (`_tmp_test_<k>_<prototipo>`, para que rutas como
`..\runtime\include` sigan valiendo), no llevan `reports/` ni `_build/`, y se borran
al terminar, también si algo falla.

- El reparto es por turnos, sin más. Sirve cuando un banco pesa más que todos los
  demás juntos, como `video_fullframe_tb` en la 30 (unos 40 s de simulación
  frente a ~10 s del resto): la suite tarda lo que ese banco y los demás corren
  a su lado. Más grupos no lo bajan.
- Los ficheros que un banco escribe en su carpeta (`frame_full.hex/.bin`) se
  copian de vuelta a la carpeta real, como con una sola invocación.
- `--jobs 1` es el comportamiento anterior, sin copias.
- La salida de cada grupo se imprime entera al terminar, no mientras corre.

### Solo lint (`lint`)

`test --lint` añade `apio lint` a la suite completa, pero sigue ejecutando
fixtures/tests Python si el prototipo los tiene. Para *solo* lint, sin nada
más:

```bash
$ lint --prototype 12
Using prototype: 12.fpga-gpu
== lint (apio lint)
...
OK
```

`lint` es `test --lint-only`: nunca toca fixtures, tests Python ni la
regresión RTL, aunque el prototipo los tenga.

## Fixtures diferenciales de RTL (`make_rtl_fixtures` y `fixtures-report`)

`gpu_system_tb.v` (y `gpu_system_bl8_tb.v` en 22 y 29) compara el estado completo del RTL con el del
simulador funcional, programa a programa. Lo que lee está en `<prototipo>/fixtures/` (`NN.program.hex`,
`NN.regs.hex`, `NN.memory.hex`, `NN.config.hex`, `NN.counts.hex`, `NN.state.hex`, `manifest.json` y
`count.vh`). **No se versiona**: lo genera un único script para los cinco prototipos de GPU (12, 14, 17,
22 y 29), a partir de los casos de `t.tests/cases-gpu`.

```bash
python tools/make_rtl_fixtures.py --prototype 22        # escribe 22.fpga-gpu-bl8/fixtures/
python tools/make_rtl_fixtures.py -p 12 --out /tmp/f    # a otro sitio, para comparar
```

`test --prototype N` ya lo ejecuta como primer paso (un prototipo cuyo banco incluye `fixtures/count.vh`
lo usa; si no, su `make_fixtures.py` propio, si lo tiene), así que a mano solo hace falta para el banco
suelto: `apio test -p 22.fpga-gpu-bl8 gpu_system_tb.v` necesita las fixtures ya generadas.

Qué casos entran y por qué lo decide el propio caso, en su `test.json`
(ver [t.tests/README.md](../t.tests/README.md#casos-para-el-diferencial-de-rtl)). Un caso entra en un
prototipo solo si todo su `requires` está entre las capacidades que `rtl_facts` lee de su RTL; los
casos van por ruta ordenada, así que el `NN` de un caso puede ser distinto en cada prototipo.

`fixtures-report` dice cuál es cuál:

```text
$ fixtures-report
caso                                       12   14   17   22   29
alu/random-arithmetic                      01   01   01   01   01
...
Omisiones:
  <caso> en 12: falta video

Sin problemas.

$ fixtures-report --prototype 22     # una sola columna
```

La matriz lleva el `NN` de cada caso o `-` si el prototipo lo omite, con el motivo debajo. Después
comprueba tres cosas y sale con 1 si alguna falla:

1. un banco pide `generated/programs/X.hex` y no hay `X.asm` en `t.tests` (el banco no tendría programa);
2. un caso marcado `rtl.differential` que ningún prototipo usa (marca que no hace nada);
3. un programa que un banco pide por nombre y que ni un caso (que lo ejecute) ni un README de su
   carpeta documentan: corre en la regresión sin que nadie diga qué prueba.

Los bancos que piden su programa por nombre (`gpu_smoke_tb`, `gpu_plasma_tb`, `gpu_bench_tb`...) no
usan `fixtures/`: los resuelve `stage_programs.py` desde `t.tests`, y `fixtures-report` solo los vigila.

## Barrido de semillas de placement (`build-sweep`)

Igual que `build`: común a cualquier prototipo con `apio.ini`, sin copiar
nada. Necesita un build archivado con timing correcto (`build --prototype N`
primero) y `oss-cad-suite` instalado (lo gestiona `apio`). Lee la placa/paquete
del propio `scons.params` archivado — no asume qué FPGA es:

```bash
$ build --prototype 17 --label base
$ build-sweep --prototype 17 --seeds 1 2 3 4 5     # usa el último build archivado
$ build-sweep --prototype 17 --seeds 1 2 3 --report-dir 17.fpga-gpu-ram-v2/reports/20260915-001203-base
$ build-sweep --prototype 17 --seeds 1 2 3 4 5 --background   # se sigue con build-status/build-log
```

**El barrido no sintetiza.** Repite colocación y rutado sobre el `hardware.json`
del último build archivado, así que si has cambiado RTL hay que hacer **antes** un
`build`: si no, barre el netlist viejo (el aviso «el build de partida NO cumple
timing; se barre igual» es la pista, y el nombre de la carpeta `reports/<build>` del
log también).

**Sin esperar al rutado del build (`--live`).** La síntesis de un build termina a
los pocos minutos y el rutado de la semilla del `apio.ini` puede tardar una hora.
Con `--live` el barrido toma la síntesis de `_build/default` del build **en curso**
y barre las demás semillas a la vez, sin esperar:

```bash
$ build --prototype 37 --label hito2 --background     # sigue con la semilla del apio.ini
$ build-sweep --prototype 37 --live --seeds 1 2 3 4 5 6 8 --jobs 7 --background
```

Comprueba que esa síntesis es de ese build (su fecha es posterior al arranque y el
`hardware.json` está entero) y que **las fuentes no han cambiado** desde que
arrancó (hashes del `metadata.json`); si no, se niega. Copia la síntesis a
`sweep-*/base/`, de modo que el barrido queda autocontenido y se puede adoptar
(`--promote`) cuando el build haya terminado. Cuida la memoria: cada `nextpnr` pesa
alrededor de 1 GB, y el build en curso es uno más.

Cada semilla queda en `reports/<build>/sweep-<fecha>/seed-N/`, con
`results.json` y `medians.json` en la carpeta del barrido. Al final imprime
cuántas cumplen, el rango, la mediana y la semilla con más margen. Hay dos
usos distintos, y cada uno tiene su opción:

- **Adoptar una semilla porque vamos justos** (`--promote`): escribe `--seed N`
  en el `nextpnr-extra-options` del `apio.ini` (conserva comentarios y saltos de
  línea) y deja el bitstream de esa semilla como build archivado y en
  `_build/`, sin volver a sintetizar (ver más abajo). Sin valor adopta la que
  cumple con más margen; con valor (`--promote 9`), esa, si cumple. Si ninguna
  cumple no toca nada. Es opt-in: las carpetas GPU no fijan semilla a
  propósito, ahí no se usa. Los párrafos de números del `apio.ini` se siguen
  apuntando a mano.
- **Saber si un cambio de RTL mejora o empeora** (`--compare`): no fijes una
  semilla, que mezcla el efecto del cambio con el ruido del placement. Barre
  las mismas semillas antes y después, y compara:

  ```bash
  $ build-sweep --prototype 17 --seeds 1 2 3 4 5 6 7 8      # antes del cambio
  # ... cambio de RTL ...
  $ build --prototype 17
  $ build-sweep --prototype 17 --seeds 1 2 3 4 5 6 7 8 \
        --compare 17.fpga-gpu-ram-v2/reports/<build-antiguo>/sweep-<fecha>
  ```

  Por reloj imprime mediana, peor caso y rango de los dos barridos, y un
  veredicto: `MEJORA`, `EMPEORA` o «dentro del ruido» cuando el cambio de
  mediana no supera dos veces el error típico de la diferencia entre los dos
  conjuntos (desviación / √n de cada uno). El rango de las semillas no vale
  para esto: con ocho es tan ancho que tapaba una mejora de +6 MHz. Exige exactamente las mismas
  semillas que el barrido de referencia y se niega antes de barrer si no
  coinciden. Es una heurística, no una prueba estadística.

**Probar opciones de nextpnr** (`--nextpnr-options`): antes de tocar el
`apio.ini`, se mide con el mismo barrido sobre el mismo build archivado. Las
opciones van **sin guiones** y con `=` para el valor, para que no dependan de
cómo cite cada shell:

```bash
$ build-sweep --prototype 30 --seeds 1 2 3 4 5 6 7 8 --nextpnr-options tmg-ripup placer-heap-timingweight=120 \
      --compare 30.fpga-cpu-console/reports/<build>/sweep-<base>
```

Quedan anotadas en el barrido (`--list` las muestra en la columna OPCIONES) y
con `--promote` se escriben en el `apio.ini` **junto con la semilla**: una semilla
solo vale con las opciones con las que se midió. No admite `seed`, `json`,
`report`, `lpf`, `textcfg`, `package`, `speed` ni `force`, que ya pone el
barrido. Hay que comparar siempre contra un barrido base **con las mismas
semillas y el mismo build**.

Lo medido en la 30 (ocho semillas, mismo netlist, mediana de `sdram_clk`, 80
MHz exigidos): `tmg-ripup` y `placer-heap-timingweight` de 60 a 250 suben la
mediana y hacen que algunas semillas cumplan; `--router router2` la baja 13 MHz;
`placer-heap-critexp`, `placer-heap-beta` y `freq` dan exactamente lo mismo que
sin ellas, y `placer static` empeora. `tmg-ripup` alarga el rutado (unos 4-5
minutos por semilla en la 30).

**Consultar barridos ya hechos** (no lanza nada ni crea registro en `reports/`):

```bash
$ build-sweep --prototype 6 --list            # una fila por barrido y reloj
$ build-sweep --prototype 6 --show latest     # detalle por semilla del último
$ build-sweep --prototype 6 --show 20260920-1334   # o un trozo del nombre (ver --list)
```

`build-sweep --last` (sin `--prototype`) hace lo mismo para todos los prototipos
a la vez: una fila por reloj del **último** barrido de cada prototipo que tenga
alguno, con el margen del peor caso sobre lo exigido.

En terminal (y sin `NO_COLOR`), `--last`, `--list`, `--show`, `--compare` y el
resumen del propio barrido colorean los valores: peor / mediana / mejor y el
margen en verde si llegan a lo exigido y en rojo si no; `CUMPLEN` en verde si
cumplen todas las semillas, amarillo si algunas y rojo si ninguna; y el
veredicto de `--compare` (`MEJORA` verde, `EMPEORA` rojo, ruido amarillo). Al
redirigir a un fichero o al log no se escribe ningún código de color.

`--list` enseña, de todos los builds archivados, cuántas semillas cumplieron y
el peor / mediana / mejor de cada reloj frente al exigido; `2/3` en SEEDS
significa que una semilla pedida no llegó a dar informe. `--show` añade el
margen en % por semilla y marca las que no dieron informe. Acepta `latest`, un
trozo único del nombre del barrido o su ruta.

**Cuándo fijar semilla y qué Fmax declarar.** Se fija (`--promote`) cuando el
margen se mide en unidades, como en las carpetas de CPU: ahí la semilla decide
si el diseño cumple. En las de GPU (12, 14, 17, 22) el margen se mide en
decenas por ciento, la semilla no decide nada, y fijarla solo daría un número
reproducible a costa de rebarrer con cada cambio de RTL: no se fija. En ese
caso el Fmax que vale es el **peor** del barrido, no el de un build suelto, que
es optimista y no reproducible. Para una medición reproducible concreta sí se
puede fijar la semilla, pero no representa el peor caso del barrido.

**Adoptar una semilla sin recompilar** (`--promote`). Cambiar el `apio.ini` deja
el bitstream STALE, pero la semilla buena ya está enrutada en el barrido
(`hardware.config`). Con la misma semilla y el mismo netlist nextpnr es
determinista, así que en vez de sintetizar otra vez `--promote`:

```bash
$ build-sweep --prototype 16 --seeds 1 2 3 4 5 6 7 8 --promote   # barre y adopta la mejor
$ build-sweep --prototype 16 --seeds 1 2 3 4 5 6 7 8 --promote 3 # barre y adopta la 3
$ build-sweep --prototype 16 --promote                           # del último barrido, la mejor
$ build-sweep --prototype 16 --promote 9 --from 20261008-0955    # esa, de otro barrido
```

Con `--seeds` actúa al terminar el barrido; sin `--seeds`, sobre uno ya hecho
(`--from` elige cuál). Escribe la semilla y las opciones de nextpnr con las que
se midió en el `apio.ini`, empaqueta ese `.config` con `ecppack` (segundos), lo
archiva como un build más (`<fecha>-promote-seedN`, con `hardware.bit` y su
`sources.zip`) y lo deja en `_build/<env>/`, con lo que el prototipo vuelve a
ser CURRENT. Se niega, sin tocar el `apio.ini`, si el RTL cambió desde el build
que se barrió o si la semilla no cumple timing (una semilla cumple si cumplen
**todos** sus relojes). Si falla el empaquetado, el `apio.ini` vuelve a como
estaba. En la 16 el `.bit` promovido es idéntico, byte a byte, al de un `build`
completo.

"Más margen" es la semilla cuyo reloj más justo tiene más holgura. Cuando hay
varias que cumplen y no son la mejor en todos los relojes, el barrido imprime
al final **la mejor semilla de cada reloj**, y marca la elegida. Sirve para
decidir a mano: por ejemplo, adoptar con `--promote N` la que deja más margen en
el reloj de la CPU porque se va a tocar, aunque no sea la de más margen global.

`build-sweep` no sintetiza: re-ruta el `hardware.json` del último build
archivado. Si el RTL ha cambiado desde entonces devuelve ocho números
plausibles y falsos, así que ejecuta `build` justo antes.

Antes reemplazaba a `tools/seed-sweep.ps1` (retirado): ese trabajaba directo
sobre `_build/<env>/` sin pasar por el archivo de `reports/`; `build-sweep`
pide un build archivado primero, pero a cambio verifica que ese build pasó
timing y queda constancia de qué fuentes se barrieron.

## El muro de caminos casi críticos (`timing-wall`)

Un build que cierra con poca holgura casi nunca tiene **un** camino malo: tiene
cientos casi igual de malos, y arreglar el peor solo descubre el siguiente.
`timing-wall` enseña ese muro —qué registros de destino llegan tarde, de qué
módulos son y cuántos— y compara dos builds para ver si un cambio baja el muro o
solo el primer camino:

```bash
$ timing-wall -p 30                                   # último build (o, si no trae detalle, el último barrido)
$ timing-wall -p 30 --sweep latest --seed 5           # una semilla concreta de un barrido
$ timing-wall <barrido> --compare <otro-barrido>      # antes y después de un cambio de RTL
$ timing-wall informe.pnr --clock sdram --top 30
```

Acepta un `hardware.pnr`, una carpeta `seed-N` o un barrido entero (se toma su
mejor semilla). Por defecto mira el reloj de menos margen. La `LLEGADA` es el
tiempo acumulado hasta el registro de destino desde el flanco de reloj, como el
último número de un camino crítico; `HOLGURA = periodo − llegada`, y las columnas
`>=80 %` y `>=90 %` cuentan destinos por encima de esa fracción del periodo. Sale
además el resumen por módulo, que suele decir más que la lista de registros.

**Cuando el muro sale como `(anonimo)`** (`--path`). Yosys aplana el diseño y los
registros de, por ejemplo, la CPU acaban llamandose `$auto$ff.cc:337:slice$N`: el
agrupado por modulo no dice de quien son. El informe detallado de nextpnr solo trae
los destinos finales (no las LUT intermedias), asi que el camino de cada destino no
se puede reconstruir. Lo que si trae completo es el **camino critico** de cada
dominio, y `--path` lo enseña salto a salto:

```bash
$ timing-wall -p 35 --sweep latest --seed 24 --path            # el reloj de menos margen
$ timing-wall -p 35 --sweep latest --seed 24 --path --clock sdram
```

Por salto: tipo, retardo, acumulado, **distancia** (columnas + filas entre los
extremos del salto de ruteo; en amarillo los de 1,5 ns o mas), la red y donde se
declara (`fichero.v:linea`; las redes que crea ABC no tienen fuente). Al final, el
reparto logica/ruteo. Sirve para ver si un camino pierde el tiempo en niveles de
logica o en un salto largo (p. ej. un `CE` con mucho fanout que cruza la FPGA). Es
**un** camino por dominio y semilla: para saber si el problema es general hay que
mirarlo en varias semillas del mismo barrido.

Ejemplo real (la 30, sdram_clk a 80 MHz): del mejor build sin opciones de
nextpnr al que está en la placa, los destinos a ≥ 80 % del periodo bajan de 675 a
293 y los de ≥ 90 % de 223 a 11. Antes de arreglar nada, el 80 % del muro eran
registros anchos de `dmem_adapter_i` (`wb_data`, de 128 bits, y sus máscaras).

**Nombres del RTL y resumen por etapa** (`--by-register`, `--filter`, `--stages`).
Con `--by-register` cada destino se nombra con su registro del RTL
(`cpu_i.ex_result`) en vez de con la celda (`$auto$ff.cc:337:slice$N`), y el muro
deja de salir como `(anonimo)`. Lo saca del `hardware.json` de Yosys del mismo build
(`build` lo archiva junto al `.pnr`; si no está, `--netlist`): la salida `Q` de cada
flip-flop es un bit, y `netnames` dice qué señales lo contienen. Como un `wire` que
corta un registro o un puerto que lo recibe comparten sus bits, se prefiere la señal
declarada en el mismo fichero que el `always` que escribe el flip-flop, luego una sin
constantes ni bits repetidos, y luego la más ancha. `--filter cpu_i.` deja solo un
módulo.

`--stages` (implica `--by-register`) añade un resumen por etapa. La etapa **no se
deduce del circuito**: sale del RTL. Primero, del atributo
`(* pipeline_stage = "IF" *)` en la declaración del registro, que Yosys conserva en
el `hardware.json` (en `reg` y en `output reg`; **no** en arrays de memoria); si no
lo tiene, del prefijo de su nombre corto. La lista dice los prefijos y el orden: un
elemento en minúsculas que acaba en `_` es un prefijo (`if_` → etapa `IF`); el resto
son etiquetas de atributo que solo fijan su sitio. `prefijo=ETIQUETA` pone la
etiqueta a mano (`ctl_=_CTL`). Sin valor, `if_,id_,ex_,wb_,ctl_=_CTL`. Las
etiquetas que empiezan por `_` (`_CTL`, `_RAM`) son **grupos que no son etapas** del
pipeline, y lo que no tiene etapa se lista en `(sin etapa)`:

```bash
$ timing-wall -p 38 --clock clk_25mhz --filter cpu_i. --stages --ports
ETAPA        LLEGADA  % PERIODO  DATO   ENABLE  OTRAS  REGISTROS  DESTINOS  >=80 %  >=90 %
IF           19.17    48         19.17  18.13   7.82   6          388       0       0
ID           19.32    48         18.60  19.32   7.84   3          195       0       0
EX           17.48    44         17.48  12.38   7.55   18         645       0       0
WB           10.69    27         9.55   10.69   7.32   13         433       0       0
_CTL         9.54     24         7.14   9.54    3.66   4          11        0       0
(sin etapa)  9.80     25         4.62   1.48    9.80   4          1243      0       0
(sin etapa): registers 9.80, debug_data 4.62, sweep 3.87, debug_address_registered 3.62
```

En `38.fpga-cpu-pipelined/cpu.v` los `if_*`/`id_*`/`ex_*`/`wb_*` y `ctl_*` van por
prefijo y solo llevan atributo los demás (`architectural_pc`, `imem_*`, `dmem_*`,
`halted`...).
La regla: un registro es de la etapa cuya lógica lo **lee**, así que la lógica de la
etapa X es el cono que va de los registros de X a los de X+1.

La `LLEGADA` de un registro es cuándo le llega la señal, no de qué etapa viene: en la
38 los registros de IF llegan tan tarde como EX porque su habilitación depende de la
decisión de salto. `--ports` lo separa en columnas por entrada del flip-flop: `DATO`
(DI/M, lo que el registro calcula), `ENABLE` (CE, la decisión de si se actualiza) y
`OTRAS` (reset, puertos de RAM):

```bash
$ timing-wall -p 38 --clock clk_25mhz --filter cpu_i. --by-register --ports
REGISTRO DE DESTINO     MODULO  LLEGADA  HOLGURA  DATO   ENABLE  OTRAS  ...
cpu_i.if_instruction    cpu_i   17.46    +22.54   1.79   17.46   4.27
cpu_i.ex_result         cpu_i   17.48    +22.52   17.48  12.27   4.24
```

`if_instruction` copia su dato en 1,79 ns y solo espera al enable; `ex_result` sí
calcula. Ojo en el resumen por etapa: los `*_valid` son bits de control y su "dato"
es precisamente la decisión de avanzar, así que suben la columna `DATO` de la etapa.
Para el camino concreto, `--path`.

**Matriz entre etapas** (`--stage-matrix`, implica `--stages`). Sigue el netlist de
Yosys hacia atrás desde cada entrada de cada registro, por la lógica combinacional,
hasta los registros de los que sale, contando las LUT del camino (el carry cuenta una
al entrar y ninguna a lo largo de la cadena; la lectura de RAM distribuida cuenta
una y su contenido es un origen, `_RAM`). Saca dos matrices etapa origen × etapa
destino, una para el DATO y otra para el CONTROL (CE/LSR), con `LUT/llegada` en
cada casilla, y la lista de caminos hacia atrás:

```bash
$ timing-wall -p 38 --clock clk_25mhz --filter cpu_i. --stages --stage-matrix
DATO (DI/M): lo que el registro calcula
ORIGEN \ DESTINO  IF         ID         EX        WB       _CTL   _RAM  (fuera)  (sin etapa)
IF                5/19.2 =   1/18.6     ·         ·        ·      ·     ·        ·
ID                12/19.2 <  13/18.6 =  13/17.5   ·        ·      ·     ·        ·
EX                7/19.2 <   7/18.6 <   8/14.6 =  4/9.6    ·      ·     ·        ·
WB                8/19.2 <   8/18.6 <   9/14.6 <  4/9.6 =  2/6.0  ·     ·        ·
_CTL              6/19.2     ·          6/14.6    4/9.6    4/7.1  ·     ·        ·
_RAM              8/19.2     10/18.6    10/17.5   ·        ·      ·     ·        2/4.6
...
Caminos hacia atras, 20 de 204, por LUT:
ORIGEN                ETAPA  DESTINO                    ENTRADA  ETAPA  LUT  LLEGADA
cpu_i.id_instruction  ID     cpu_i.if_fetch_request_pc  dato     IF     12   18.58
cpu_i.id_instruction  ID     cpu_i.imem_address         dato     IF     11   19.17
```

`<` es un camino hacia atrás, `=` uno dentro de la misma etapa; las casillas con
algún grupo (`_CTL`, `_RAM`, `(fuera)`...) no llevan dirección. Las LUT son del par;
la **llegada es del destino**, no del par (nextpnr no da tiempos por par), así que
si un destino recibe caminos de dos etapas las dos casillas comparten su llegada.
Las LUT no incluyen el ruteo, que puede ser más de la mitad del camino.

Necesita el informe detallado de nextpnr (`--detailed-timing-report`): **todas las
semillas de `build-sweep` lo llevan**, pero un `build` normal no, salvo que el
`apio.ini` lo pida. Solo se miran los destinos del reloj elegido, sin las rutas
hasta los pines. Es una lectura de un solo netlist y una sola semilla: la
colocación mueve las cifras, así que conviene comparar semillas de un mismo
barrido y no una contra otra suelta.

## Encadenar todo (`check`)

`test` → `lint` → `build`, en ese
orden, parando en el primer fallo. Solo reenvía `--prototype` — cada paso
tiene opciones propias incompatibles entre sí (`--quick`, `--archive-only`...),
así que para combinaciones concretas usa cada comando por separado:

```bash
$ check --prototype 12
Using prototype: 12.fpga-gpu
== tests Python
...
== lint (apio lint)
...
== regresión RTL (apio test)
...
OK
```

## Informe de un prototipo

Sin necesidad de placa: cruza el título del `README.md`, el último commit que
tocó la carpeta, el mapa de memoria que declara `monitor.py`
(`ARCHITECTURAL_REGIONS`/`MONITOR_REGIONS`, leído sin importar el módulo), y
el último `reports/*/summary.json` archivado si existe. La identidad
—backend, versión de monitor, reloj, capacidades— se lee **directamente del
RTL**, no de una copia a mano en ningún sitio:

- CPU o GPU: presencia de `cpu.v` vs `gpu_sm.v`/`gpu_system.v`.
- Versión de monitor: `localparam VERSION_MAJOR`/`VERSION_MINOR` en `monitor.v`.
- Reloj: atributo `FREQUENCY_PIN_CLKOP` del fichero del PLL.
- Capacidades: `tools/capabilities.json` — un mapa capacidad→señal (fichero,
  y opcionalmente un patrón a buscar dentro). Añadir una capacidad nueva es
  una entrada ahí, no hay que tocar cada prototipo ni el código de
  `prototype-report`.

```bash
$ prototype-report --prototype 21
Prototype: 21.fpga-cpu-hdmi-alu
Title: MiniCPU con la familia ALU completa, desplazamientos inmediatos y `R0` a cero
Last commit: d99ca1d (2026-09-14) 10 does not have MUL/DIV
Backend: cpu — alu (monitor 4.21)
Clock: 80.0 MHz
Capabilities: mul_div, subword_memory, calls, shift_immediate, alu_extended, video, frame_capture, serial
Memory map:
  ARCHITECTURAL_REGIONS:
    0x00000000-0x02000000 (33,554,432 bytes)
Synthesis: (sin reports/*/summary.json; ejecuta ./build --report)

$ prototype-report --prototype 21 --json | jq .capabilities
```

El nombre corto de versión (`alu`, `ebr`, `sdram`...) es lo único que sigue
viniendo de `t.tests/backends/{fpga_cpu,fpga_gpu}.py` — es una etiqueta elegida a
mano, no algo verificable en el RTL. Si un prototipo no está registrado ahí
(como le pasaba a `17.fpga-gpu-ram-v2`), cae al nombre de la carpeta en vez
de dejar todo en blanco.

## Las constantes del mapa MMIO

```bash
$ generate-mmio
escrito: runtime/include/mmio.inc
escrito: tools/mmio_map.py
escrito: runtime/include/mmio_map.h

$ generate-mmio --check     # no escribe; exit code 1 si algo cambiaría (para CI)
```

La fuente única es [`1.isa/mmio_map.vh`](../1.isa/mmio_map.vh), que pide
[`1.isa/mmio.md`](../1.isa/mmio.md) §20: sólo `define`, nombre y constante, sin
una sola expresión. De ahí salen el include del ensamblador y el módulo Python
que usan el monitor y los simuladores. **No edites lo generado**: toca el `.vh`
y vuelve a ejecutar esto.

El include se usa así, y `runtime/include` y `runtime/src` ya van en el `-I` tanto de
`run_tests.py` como de `tools/run_board.py`, así que no hay que pasar nada:

```asm
.include "mmio.inc"
    LI    R2, MMIO_VIDEO_BASE
    STORE R3, R2, 0                  ; CTRL
    LI    R4, MMIO_VIDEO_FB_FRONT_ADDR
```

Cada `_OFF` del `.vh` sale también como `_ADDR` con su base ya sumada. A qué
bloque pertenece se deduce del prefijo del nombre, así que **un `_OFF` tiene
que llamarse igual que su `_BASE`** — `MMIO_GPU_WARPS_PC_OFF` cuelga de
`MMIO_GPU_WARPS_BASE`, y escribirlo sin la S lo colgaría de `MMIO_GPU_BASE`.
El generador comprueba que no haya dos registros en la misma dirección y falla
si los hay, que es como se caza ese error.

`t.tests/unit/tools/test_mmio_map.py` comprueba tres cosas distintas: que lo generado está
al día, que las direcciones son las que dice el contrato (con los números
escritos a mano, para que un `.vh` mal editado no pase), y que el generador
rechaza lo que no debe aceptar.

## Mantener la documentación generada al día

```bash
$ generate-docs
actualizado: docs/resumen-prototipos.md
actualizado: docs/synthesis-report.md

$ generate-docs --check     # no escribe nada; exit code 1 si algo cambiaría (para CI)
$ generate-docs --list-generators
```

`generate-docs` descubre los bloques declarativos en todos los Markdown que
forman parte del modelo. Tanto `docs/synthesis-report.md` como
`docs/resumen-prototipos.md` conservan el texto escrito a mano: la herramienta
**solo** toca lo que haya entre los marcadores de cada bloque. Por ejemplo:

```markdown
<!-- gendoc:begin cpu-capabilities
generator: cpu-matrix
-->

... contenido generado ...

<!-- gendoc:end cpu-capabilities -->
```

El nombre del bloque es local al documento y el campo `generator` selecciona
el generador registrado. El mismo mecanismo materializa queries del grafo:

```markdown
<!-- gendoc:begin identity-register-implementations
generator: trace.query
query: implementations-of
arguments:
  - SPEC-DEVICE#identity-register
-->

... tabla generada ...

<!-- gendoc:end identity-register-implementations -->
```

El generador llama directamente a `ModelBuilder`, `Graph` y `CORE_QUERIES`; no
duplica la semántica del CLI. `--check` comprueba también estos bloques sin
escribir. Como dogfood, `tools/generate_docs.py` declara el artifact
`IMPL-GENDOC` y símbolos formales para sus cuatro generadores.

Todos se despachan ahora mediante `GeneratorRegistry`: `synthesis-table`,
`cpu-matrix`, `gpu-matrix`, `prototype-summary` y `trace.query`. El decorador
`@generator` permite registrar otros generadores Python sin añadir ramas al
dispatcher. `--list-generators` muestra el inventario disponible. En cada
ejecución se recalculan todos los bloques encontrados; la
caché de `trace` conserva también qué recursos contienen bloques, por lo que
`generate-docs` solo vuelve a abrir esos Markdown y solo los escribe cuando el
texto renderizado cambia. Todavía no existe caché ni declaración de dependencias
específica por generador.

Las matrices llevan una columna por simulador además de las de bitstream. Las
capacidades del RTL se detectan leyendo los `.v`; las de los simuladores se leen
del `VERSIONS` de `t.tests/backends/{sim_cpu,sim_gpu}.py`, que es donde
están declaradas y lo que usa `incompatibility()` para decidir qué casos corren.
Fmax y LUT/FF salen del `summary.json` archivado en `reports/` y, si esa carpeta
no tiene ninguno, del `_build/*/hardware.pnr` local.

## Dependencias externas

- Python 3.10+
- Apio (`.venv/bin/apio` en macOS/Linux, `.venv/Scripts/apio.exe` en Windows)
- oss-cad-suite (Yosys, nextpnr...), que instala `apio` en
  `~/.apio/packages/oss-cad-suite`
- Icarus o Verilator para los testbenches Verilog/SystemVerilog
- pyserial para hablar con la placa (`board.py`, `monitor.py` de cada
  prototipo; los lanzadores de `tools/` que no tocan placa, como
  `prototype-report`, no lo necesitan)

## Diagnosticar desconexiones USB del FTDI (Windows)

`usb-power-monitor` registra los cambios de presencia y estado del FTDI y de
toda su cadena de hubs. Tambien guarda los indicadores de suspension selectiva
y de reposo de cada dispositivo. Es una herramienta de solo lectura: no cambia
la configuracion de energia. Comprueba el estado cada segundo, pero solo escribe
una nueva linea cuando detecta algun cambio, por lo que el registro permanece
pequeno. Cada evento se escribe, se fuerza a disco y se cierra inmediatamente;
el fichero queda util aunque el proceso o el dispositivo se interrumpan despues.

```powershell
.\tools\usb-power-monitor.ps1
# o una prueba limitada a 20 minutos:
.\tools\usb-power-monitor.ps1 --duration 20 --output ftdi-prueba.jsonl
```

Deja que la pantalla se apague y, despues de reproducir el fallo, pulsa
`Ctrl+C`. El fichero JSONL solo contiene una instantanea inicial, los cambios
detectados y posibles errores; se puede compartir directamente para comparar
que elemento de la cadena desaparecio primero.

## Ejecutar un programa en una placa real (`run-board`)

Resuelve el prototipo, comprueba (y si hace falta sube) el bitstream
correcto, carga el programa y lo ejecuta. Reutiliza `t.tests/backends/board.py`
para todo lo que habla con la placa — no es un segundo sistema de
programación FPGA, es la composición de esas piezas con resolución de
prototipos:

```bash
$ run-board --prototype 6 --program fpga_smoke_test.asm --port COM3
Using prototype: 6.fpga-cpu
Bitstream correcto: monitor 3.6.
== loading fpga_smoke_test.bin at 0x00000000
== starting
CPU halted=True error=False ...

$ run-board --prototype 6 --port COM3                    # solo comprueba identidad
$ run-board --prototype 6 --port COM3 --no-upload         # falla si el bitstream no es el correcto
$ run-board --prototype 6 --port COM3 --program demo.asm --no-run   # carga sin arrancar
$ run-board --prototype 21 --port COM3 --interactive      # deja una consola serie (solo con capacidad `serial`)
```

La identidad esperada del monitor se lee del RTL (`monitor.v`), igual que
`prototype-report` — no depende de que el prototipo esté registrado en
ningún sitio. `--rebuild` fuerza `apio upload` aunque la identidad ya
coincida.

`--program` acepta una ruta, o un nombre suelto: primero busca en el
directorio actual y en `examples/` del prototipo; si no aparece ahí, busca por
todo el repositorio (como hacía `run-demo.ps1`, ya retirado) y falla con una
lista si hay varias coincidencias.

Si no pasas `--port`, `run-board` detecta el primer adaptador FTDI conectado
(VID `0x0403`, el de la ULX3S y de la mayoría de placas de desarrollo FPGA).
En macOS/Linux no hay "COM3" que valga por defecto, así que esto evita tener
que buscarlo a mano cada vez; si hay varios o ninguno, lo dice explícitamente
en vez de adivinar.

### Detección de puerto compartida (`tools/serial_ports.py`)

Lo mismo vale ahora para los `monitor.py` de los prototipos y para
`22.fpga-gpu-bl8/profile.py`: todos importan `tools/serial_ports.py`, que es
el único sitio donde vive `detect_port()`/`available_ports()`.

Antes esa función estaba **copiada palabra por palabra en los trece
monitores** y devolvía el primer puerto del sistema. Con la placa
desenchufada eso cogía el puerto serie de la placa base o un enlace
Bluetooth, y el fallo salía mucho más tarde disfrazado de *write timeout* —
un síntoma que se parece a "la FPGA no tiene monitor" y no a "no has
enchufado la placa". Ahora `--port` sin valor detecta, y `available_ports()`
marca cuál es la placa:

```text
Available ports: COM3 (FTDI), COM1, COM6, COM8
```

`t.tests/backends/board.py` mantiene su propia copia a propósito: `t.tests`
no depende de `tools/` (la dependencia va en el otro sentido) y `board.py`
recibe el `monitor.py` del prototipo como módulo, así que importar desde el
monitor haría un ciclo. Son dos copias en vez de trece, y
`t.tests/unit/backends/test_monitor_port.py` comprueba que no divergen.

### Las tres operaciones por separado

`run-board` es la composición de tres pasos; cada uno también existe como
comando suelto, por si solo hace falta uno:

```bash
$ board-info --prototype 6 --port COM3
Using prototype: 6.fpga-cpu
OK: monitor 3.6 (versión ebr).                # o MISMATCH, sin subir nada nunca

$ board-upload --prototype 6 --port COM3 -y
Using prototype: 6.fpga-cpu
Bitstream correcto: monitor 3.6.

$ board-load --prototype 6 --port COM3 --program fpga_smoke_test.asm
Using prototype: 6.fpga-cpu
== loading fpga_smoke_test.bin (32 bytes) at 0x00000000
== starting
CPU halted=True error=False ...
```

`board-info` nunca escribe nada en la placa (solo lee la versión del
monitor). `board-upload` es el mismo chequeo que hace `run-board` por
defecto, con `--rebuild`/`--no-upload`/`-y`. `board-load` **no comprueba la
identidad del bitstream** — asume que ya es el correcto y va directo a
ensamblar/cargar/ejecutar; combínalo con `board-upload` si no estás seguro.

**Subir un build archivado (`board-upload --bitstream`).** `board-upload` normal
programa `_build/default/hardware.bit`, que es el del *último intento*, aunque
ese intento no haya cerrado timing o haya muerto antes de generar bitstream (en
ese caso el fichero que queda es el de un intento anterior). Para volver a un
build bueno del histórico:

```bash
$ board-upload -p 37 --bitstream 37.fpga-cpu-gpu-mk2/reports/20261008-160636-738467-base -y
$ board-upload -p 37 --bitstream reports/20261008-160636-738467-base/hardware.bit -y
```

Acepta un `hardware.bit` o la carpeta de `reports/` que lo contiene (una ruta
relativa se busca desde el directorio actual y desde la carpeta del prototipo).
Lee el `summary.txt` de esa carpeta y **avisa** de los relojes que no cumplían
(o de que no hay resumen), pero no lo impide. Programa con `fujprog` directo,
comprueba la identidad con `board-info` al terminar, y **no sella** la subida:
borra el sello de `_build/default/.uploaded`, así que el siguiente `run-board`
o `board-upload` sin `--bitstream` vuelve a programar el bitstream actual del
proyecto. Es incompatible con `--rebuild` y `--no-upload`.

### Barrido de fase de la SDRAM (`phase-sweep`)

Programa uno o varios bitstreams y, para cada uno, recorre las 48 fases del reloj
de la SDRAM (pasos de 208 ps) escribiendo y leyendo cuatro patrones desde el
monitor. Saca la ventana de fases que pasan en todos y recomienda su centro, que
es la fase con la que sale el bitstream (`SDRAM_PHASE` en el `top.v` de la 35–38,
un valor para Yosys y otro para Diamond; la 36 y la 37 la fijan en `pll_mem.v`):

```bash
$ phase-sweep --bitstream 38.fpga-cpu-pipelined/reports/20261111-165312-596391-paso-5 --dry-run
$ phase-sweep --bitstream s3=37.fpga-cpu-gpu-mk2/reports/sweep-X/seed-3 \
              --bitstream s10=37.fpga-cpu-gpu-mk2/reports/sweep-X/seed-10 --yes
```

`--bitstream` acepta `[NOMBRE=]RUTA`, al `hardware.bit` o a su carpeta de
`reports/`; sin nombre usa el de esa carpeta. **El prototipo sale de la ruta**
(la carpeta `N.nombre` que la contiene); `-p` solo hace falta para un bitstream
fuera del repo. Se usa para dos cosas: `board-upload` comprueba tras programar
que responde el monitor de ese prototipo, y el protocolo se habla con su
`monitor.py`, que no es igual en todos (la 38 va a 250 kbaudios, la 35-37 a
1 Mbaudio). Al acabar deja la placa en `--restore-phase`, por defecto la que tenía
el bitstream recién programado. Los informes (JSONL, CSV, JSON y Markdown) van a
`<prototipo>/reports/phase-sweep-<fecha>.*` salvo `--output`. Sin `--yes` no
programa nada; `--phases 4-16` limita el barrido, pero entonces no recomienda
fase.

### Cambiar la fuente de la consola sin resintetizar (`font-patch`)

La fuente de `text_console.v` es contenido inicial de cuatro EBR: cambiarla no
cambia el netlist, así que no hace falta volver a sintetizar. `font-patch`
localiza esos EBR en `_build/default/hardware.config` por su contenido (detecta
cuál de las fuentes de `fonts/` lleva), los reescribe con la pedida y repaquea
con `ecppack`:

```bash
$ font-patch --prototype 30 pc               # deja _build/default/font-pc.bit
$ font-patch --prototype 30 cpc464 --upload  # y lo programa (SRAM) con fujprog
```

No toca `hardware.bit` ni el sello de subida. Tras `--upload` la CPU arranca
vacía: recarga el programa con `board-load`. Solo vale para el netlist con el
que se construyó el `.config`; si cambia el RTL hay que reconstruir, y entonces
la fuente entra por `FONT_FILE`. Parchear a la fuente por defecto da el mismo
bitstream, byte a byte, que una síntesis completa (comprobado en la 30).

### Suite de casos contra placa real (`test-board`)

`t.tests/run_tests.py` necesita `--backend fpga-cpu`/`fpga-gpu` y `--version`
(el nombre corto de `t.tests/backends/{fpga_cpu,fpga_gpu}.py`), que hay que saber
a mano. `test-board` los infiere del mismo sitio que `board-info`/`run-board`
(el RTL, vía `_capabilities()`), detecta el puerto igual que el resto de
comandos de placa, y reenvía todo lo demás (`TEST_JSON`, `--trace`, `-y`,
`--measure`...) a `run_tests.py` sin tocarlo:

```bash
$ test-board --prototype 21 -y cases-cpu/basics
Detected port: /dev/cu.usbserial-D00688 (ULX3S FPGA 85K v3.0.8)
Using prototype: 21.fpga-cpu-hdmi-alu
$ .../run_tests.py --backend fpga-cpu -p 21 --port /dev/... -y cases-cpu/basics
PASS smoke [fpga-cpu]
PASS zero-register [fpga-cpu]
2 caso(s), 0 fallo(s), 0 omitido(s) por arquitectura o capacidades, 1.7s
```

Si el prototipo no tiene identidad inferible (sin `cpu.v`/`gpu_sm.v`/
`gpu_system.v` + `monitor.v` con versión), falla con un mensaje claro en vez
de adivinar — en ese caso usa `t.tests/run_tests.py` directamente con
`--backend`/`--version` a mano.

**La 36 y la 37 son CPU y GPU.** `test-board -p 37 -y` lanza `run_tests.py` dos
veces, una por familia y en este orden: `--backend fpga-cpu` y `--backend
fpga-sys` (la GPU, que lanza el host por GPU CORE; `fpga-gpu` no las conoce). Un
fallo de la primera no impide la segunda y el código de salida es el peor de los
dos. `--family cpu|gpu` prueba una sola, y los demás argumentos (casos, `-y`...)
se reenvían a las dos: con casos concretos en un prototipo CPU+GPU, usa
`--family` para no mandar un caso de CPU al backend de GPU. `test-all --family
gpu` incluye también la GPU de la 36 y la 37.

### CPI y reparto de los ciclos (`--measure`)

`test-board --prototype 30 --measure medidas.md <casos>` ejecuta cada caso y
escribe una tabla en Markdown: instrucciones y CPI por versión, tiempo de CPU y,
**solo para las versiones con contadores de espera** (capacidad `perf_stalls`, hoy
la 30), una tercera tabla, «Reparto de los ciclos»: qué fracción de los ciclos de
cada caso es cálculo, espera a la búsqueda de instrucciones, espera a datos y
espera a MMIO, más la tasa de acierto del búfer de instrucciones y las peticiones
a memoria por instrucción. Los contadores son los de CPU PERFORMANCE
(`1.isa/mmio.md` §13.2); las versiones que solo tienen `CYCLES` y `RETIRED` salen
sin esa tabla, no con ceros.

Para mirar un programa suelto, o uno que ya está corriendo en la placa, el
`monitor.py` de la 30 tiene `perf`: `monitor.py perf` da lo acumulado y
`monitor.py perf 2` lo contado en una ventana de 2 s, que es lo correcto cuando
lleva minutos corriendo (los contadores dan la vuelta a los 53 s a 80 MHz).
Los dos usan `tools/perf_counters.py`, así que reparten los ciclos igual.

#### Archivo de medidas y comparación (`measure-compare`)

`--measure` archiva cada medida en `<prototipo>/reports/<fecha>-medida-<etiqueta>/`
(`measure.json` y `measure.md`), con o sin nombre de fichero. Guarda los datos de
cada caso, el hash de las fuentes sintetizables y el Fmax del build hecho con
*esas* fuentes; si no hay un build que coincida, el Fmax queda en `n/d`. Se pone
nombre con `--measure-label antes-de-segmentar`.

```bash
$ measure-compare -p 30                 # las dos medidas más recientes del prototipo
$ measure-compare A B                   # carpetas o measure.json, primero la de antes
```

Junta CPI y frecuencia en **ns por instrucción = CPI / Fmax**, para juzgar una
propuesta de subir Fmax que empeore el CPI. Es una **proyección**: el reloj real
está fijo (80 MHz, por el divisor de la UART) y nadie ha corrido a la Fmax del
build. El CPI global es ciclos totales entre instrucciones totales, sin los casos
de vídeo y UART, cuyas instrucciones dependen del reloj o del baudrate.

#### Probar todos los prototipos (`test-all`)

`test-all` ejecuta la suite completa en cada prototipo con placa, de uno en uno
(hay una sola placa), y escribe una matriz caso × prototipo en
`reports/pruebas/<fecha>-<familia>.md`: `PASS`, `FAIL` o `SKIP`, con una sección
que dice por qué se omitió cada caso y otra con el detalle de los fallos. Un
`SKIP` por capacidades no es un fallo; el código de salida es 0 solo sin `FAIL`
ni prototipos que no arrancan. Una pasada que termina con código distinto de cero
sin ningún `FAIL` (una excepción del arnés a mitad) sale como `INCOMPLETO` en la
columna Estado, con lo ya ejecutado en la matriz: antes salía como `OK` con medio
informe.

```bash
$ test-all --family gpu --yes          # 12, 14, 22, 29 y la GPU de la 36 y la 37
$ test-all --family cpu --yes
$ test-all -p 22 -p 29 --yes           # solo esos
$ test-all --list
```

#### Medir todos los prototipos y comparar (`bench-all`, `perf-report`)

`--measure` funciona con `--backend fpga-cpu` y con `--backend fpga-gpu`. En GPU
el CPI son ciclos por instrucción **de warp**, y solo salen ciclos donde el RTL
tiene el bloque GPU PERFORMANCE (22 y 29; en 12 y 14 sale `sin contadores`).

```bash
$ bench-all --list                      # qué prototipos mediría, sin tocar la placa
$ bench-all --yes                       # todos, CPU y GPU, y al final el informe
$ bench-all --family gpu -p 22 --yes    # solo la 22
$ perf-report                           # solo el informe, con lo ya archivado
$ perf-report --label bench --history 8
```

`bench-all` llama a `run_tests.py --measure -p N` por prototipo, así que cada uno
sube su bitstream (y lo sintetiza si sus fuentes cambiaron: la primera pasada
tarda). Un prototipo que falla no detiene a los demás. El informe va a
`reports/rendimiento/<fecha>-informe.md` y trae, por familia: un resumen por
prototipo (reloj, Fmax, CPI, ns/instr), y tablas de tiempo (ms), CPI y FPS donde
cada fila es un programa y cada columna un prototipo, más la evolución de cada
uno entre medidas y los casos cuyo CPI cambió un 1 % o más.

Tres cosas que el informe repite donde importan: el CPI del resumen es sobre los
casos que **todos** los prototipos de la tabla midieron (otro conjunto da otro
promedio); los programas de vídeo y UART llevan `*` porque su tiempo depende de
vsync o del baudrate; y los FPS son intercambios por segundo de la placa, que con
vsync a 60 Hz no pasan de 60 y solo se dan con 10 intercambios o más (con menos
sale `corto`: el arranque pesa más que el ritmo). Los prototipos sin contadores
(6, 10, 12 y 14) no entran en el CPI común, y la evolución compara cada medida con
la anterior solo sobre los casos que ambas tienen. Los casos de vídeo de GPU (`demo-plasma`)
corren en placa en la 22 y la 29: paran tras N intercambios sondeando
`SWAP_COUNT`, igual que los de CPU (`t.tests/backends/frame_capture.py`).

## Herramientas de vídeo/HDMI

Comunes a los cuatro prototipos con framebuffer + HDMI, todas con `--prototype`/`-p`:

```bash
$ make-framebuffer bars fb.bin                                  # genera un patrón RGB565 320x240
$ demo-no-cpu --prototype 21 --pattern frame                    # lo muestra sin ejecutar CPU
$ capture-frames --prototype 21 swap_demo_fast --frames 4       # captura frames deterministas
$ measure-demo --prototype 21                                   # FPS de swap_demo/tear_demo (lee R21)
```

`make-framebuffer` no depende de ninguna versión concreta. `demo-no-cpu`
genera uno de sus patrones, para el núcleo, lo carga en SDRAM y configura el
scanout con el mapa MMIO común; acepta `--port` y detecta el FTDI si se omite.
`capture-frames` y `measure-demo` sí hablan con una
placa real por el protocolo de vídeo compartido, reutilizando
`resolve_target`/`run_monitor_cli`/`detect_port` de `run_board.py`;
`measure-demo` en particular solo tiene sentido con las demos
`swap_demo`/`tear_demo`, no como medición de FPS general.

### Poner una imagen en la pantalla (`image-to-framebuffer`)

El camino contrario a `frame-to-image.py`: entra un JPG/PNG/BMP y sale el
`.bin` RGB565 de 320x240 —**153600 bytes**, el mismo formato que
`make-framebuffer`—, listo para `write-block`.

```bash
$ image-to-framebuffer foto.jpg foto_fb.bin                       # 153600 bytes en 0x01000000
$ image-to-framebuffer foto.jpg foto_fb.bin --ajuste encajar --fondo 0,0,64
$ image-to-framebuffer foto.jpg foto_fb.bin --upload --prototype 22
```

El framebuffer es de 320x240 y el scanout duplica cada píxel, así que lo que
entra sin deformarse es **4:3** (640x480, 1024x768...). Para el resto está
`--ajuste`: `recortar` (por defecto, llena y recorta el lado largo),
`encajar` (imagen entera con bandas de `--fondo`) y `estirar`.

Con `--upload --prototype N` no se queda en un fichero: resetea el núcleo,
escribe el framebuffer en SDRAM (~2 min a 250 kbaud), apunta `FB_FRONT` y
`FB_BACK` a esa dirección y pone `VIDEO_CTRL` en SCANOUT. No hace falta
programa cargado — el scanout lee SDRAM por su cuenta. `VIDEO_CTRL` solo
existe en la 22; en 16/18/19/21 el scanout está siempre encendido y la
herramienta lo dice al leerlo de vuelta en vez de fallar.

### Capturar un frame sin placa (`capture-frame-sim`)

Igual que `capture-frames`, pero contra el simulador funcional
(`2.cpu-sim-func/minicpu_sim.py`) en vez de hardware — no hace falta placa ni
`--prototype`, y es casi instantáneo. Dos formas de decidir cuándo capturar,
y el formato de salida lo decide la extensión (`.bin`, `.hex`, o cualquier
cosa que entienda Pillow vía `frame-to-image.py`):

```bash
$ capture-frame-sim cases-cpu/video/bounce/bounce.asm --swap 20 frame.png
$ capture-frame-sim cases-cpu/video/band/band.asm --instrucciones 500000 frame.bin
```

`--swap N` para en el N-ésimo intercambio completado desde el arranque.
`--instrucciones N` ejecuta N instrucciones sin condición de parada y captura
en el intercambio que ocurra después — útil para mirar el framebuffer en un
punto cualquiera del programa sin saber a qué intercambio corresponde.

## Qué no hay todavía

Nada pendiente en la infraestructura común. `prototype-report`/`run-board`
leen la identidad de un prototipo directamente del RTL (`cpu.v`/`gpu_sm.v`,
`monitor.v`, el PLL, `tools/capabilities.json`) en vez de depender de que
alguien la registre en ningún sitio — ver "Informe de un prototipo" arriba.

Para agentes trabajando en este repo: ver también [`../AGENTS.md`](../AGENTS.md).
