jlopezr/mini-gpu/9.fpga-ram-param/README.md

# Monitor UART para controlador SDRAM parametrizado de ULX3S

Este proyecto expone los 32 MiB de SDR SDRAM W9825G6KH como un espacio de
memoria direccionado por bytes mediante el monitor UART. Es la unión del
monitor de `5.fpga-monitor`, las direcciones de 32 bits de `6.fpga-cpu` y el
controlador SDRAM de `8.ulx3s_w9825g6kh_test`.

El oscilador de 25 MHz alimenta una PLL que hace funcionar todo el diseño a
120 MHz. La UART trabaja a 1200000 baudios (`120 MHz / 100`), con 8 bits, sin
paridad y un bit de parada.

El controlador recibe `CLK_FREQ_HZ=120_000_000` desde `top.v`. La espera de
encendido, el intervalo de refresco y los tiempos `tRP`, `tRCD` y `tRFC` se
convierten automáticamente a ciclos enteros redondeando hacia arriba. Esta
La PLL, la lógica y la SDRAM comparten el mismo reloj de 120 MHz, por lo que el
diseño continúa teniendo un único dominio y no necesita un puente CDC.

La UART conserva inicialmente 100 ciclos por bit y nunca supera el límite de
3 Mbaud. `monitor.py` lee `CLK_FREQ_HZ`, `UART_CLOCKS_PER_BIT` y
`UART_MAX_BAUD` directamente de `top.v` y calcula el mismo baud rate, por lo
que no hay que editar ambos archivos. El reloj físico generado o conectado al
diseño debe coincidir siempre con el valor del parámetro.

## Mapa y protocolo

El rango válido es `0x00000000`–`0x01ffffff`. Las direcciones y longitudes se
envían primero por el byte más significativo:

| Petición | Respuesta  | Operación |
|---|---|---|
| `01` | `81` | PING |
| `02` | `82 02 00` | Versión 2.0 |
| `10 AA AA AA AA DD` | `90` | Escribir byte |
| `11 AA AA AA AA` | `91 DD` | Leer byte |
| `20 AA AA AA AA LL LL DD...` | `a0` | Escribir 1–256 bytes |
| `21 AA AA AA AA LL LL` | `a1 DD...` | Leer 1–256 bytes |

Las operaciones fuera de rango responden `ff`.

## Adaptación a SDRAM y DQM

La interfaz física usa palabras de 16 bits y burst length 1. El adaptador
convierte la dirección de byte en `address >> 1`. Para escrituras pares activa
solo `wmask[0]`; para impares, solo `wmask[1]`. El controlador aplica la
inversión requerida por los pines activos en alto de máscara:

```text
sdram_dqm = ~req_wmask
```

Así, escribir un byte no modifica su vecino. Los bloques del monitor siguen
siendo secuencias de accesos BL1 independientes; todavía no se emplean bursts.

## Pruebas

```powershell
apio test monitor_tb.v
apio test sdram_byte_adapter_tb.v
apio build
```

Prueba física equivalente a los patrones de la carpeta 8, controlada desde el
PC (128 KiB en este ejemplo):

```powershell
python monitor.py memory-test 0 0x20000 --port COM3
```

También están disponibles `ping`, `get-version`, `write-byte`, `read-byte`,
`write-block`, `read-block` y `verify`. Use `python monitor.py --help` para ver
los argumentos.

## LEDs

| LED | Significado |
|-----|---|
| 0 | Inicialización SDRAM terminada |
| 1 | Monitor ocupado |
| 2 | Controlador SDRAM ocupado |
| 3 | Error de acceso durante el pulso actual |
| 7:4 | Cuatro bits bajos del último comando |

La futura integración con la CPU añadirá un frontend 32→16. Una palabra CPU
de 32 bits requerirá inicialmente dos transacciones BL1; los bursts quedan
fuera del alcance de esta etapa.
