jlopezr/mini-gpu/tools/traceability/example/requirements.md

<!-- trace:artifact REQ-DEVICE-IDENTITY
type: requirement
kind: interface
subjects: [cpu, gpu]
-->

# Identidad del dispositivo

Cada prototipo debe exponer una identidad que permita distinguir el diseño y
la versión del monitor antes de cargar o ejecutar un programa.
