jlopezr/mini-gpu/3.fpga/docs/documentacion.md

<https://github.com/emard/ulx3s>
<https://github.com/emard/ulx3s/blob/master/doc/MANUAL.md#precompiled-opensource-tools-for-all-platforms>
<https://github.com/ulx3s/fpga-odysseus>
<https://ulx3s.github.io/>
<https://fpgawars.github.io/apio/docs/supported-boards/>
