jlopezr/mini-gpu/30.fpga-cpu-console/README.md

# MiniCPU con consola de texto 80×30 y fuente 8×16

Parte de [`../21.fpga-cpu-hdmi-alu`](../21.fpga-cpu-hdmi-alu) e implementa el
primer corte de la [propuesta 2D v0.4](minigpu-2d-propuesta-consolidada-v0.4.md):

- Text RAM de 2400 celdas en EBR dual-port;
- celda `BG[15:12] | FG[11:8] | CHARACTER[7:0]`;
- Font RAM de 256 glifos × 8×16, inicializada en el bitstream y cargable por MMIO;
- colores de texto 1..15 replicados desde la paleta global;
- overlay físico 640×480, posterior al framebuffer, con color 0 transparente;
- `CONFIG.TEXT_ENABLE` shadow/active mediante `FRAME_COMMIT.STATE_COMMIT`.

Tiles, sprites, framebuffer indexado y HUD quedan fuera de este hito. El RTL
reserva sus posiciones arquitectónicas para poder incorporarlos sin renumerar
la consola.

La fuente inicial es la variante Mode 1 de
[CPC464](https://codeberg.org/Dmian/font-cpc464), convertida de 8×8 a 8×16
mediante duplicación vertical exacta. También se conserva una fuente alternativa
estilo PC (Unscii). Las dos siguen la asignación CP437, con cajas simples, dobles
y mixtas en 0xB0..0xDF. Origen, licencia y regeneración están documentados en
[`fonts/README.md`](fonts/README.md).

## Mapa de este hito

| Recurso | Offset desde `VIDEO_BASE` |
|---|---:|
| `FRAME_COMMIT` | `0x000c` |
| `CONFIG` | `0x0040` |
| cargador de fuente | `0x0080..0x0094` |
| `PALETTE[256]` | `0x1000..0x13fc` |
| `TEXT[2400]` | `0x6000..0x857c` |

## INPUT: el teclado y el ratón del PC en la placa

La 30 añade el bloque INPUT de [`mmio.md` §25](../1.isa/mmio.md) en
`0x80600000`, **sin ningún teclado ni ratón conectado a la FPGA**: los eventos
los manda el PC por el monitor.

```text
 teclado / ratón del PC
        │  tools/screen_window.py --panel     captura (Tk), teclas físicas HID
        ▼
 tools/input_adapter.py        el ADAPTADOR: calcula los eventos con las reglas
        │                      de InputDevice y respeta el control de flujo
        │  INPUT_EVENTS (3B) / INPUT_PRESENCE (3C)      por la UART del monitor
        ▼
 monitor.v  ──►  input_registers.v  ──►  MMIO  ──►  el programa (polling)
                 STATE + FIFO de 16
```

El adaptador está en el PC, no en la FPGA. El bloque [`input_registers.v`](input_registers.v)
**solo guarda**: recibe eventos ya formados, actualiza STATE (`KEY_STATE0..7`,
`MOUSE_BUTTONS`) y los mete en la FIFO. Se valoró y se descartó mandar el estado
completo de las teclas y calcular las diferencias en la FPGA: habría hecho falta
un comparador de 256 bits, un buscador del primer bit distinto y una FSM de
serialización en una carpeta que cierra a 80 MHz por los pelos, y las reglas de
orden habrían quedado escritas dos veces (Python y Verilog). Además, el día que
llegue el USB real su adaptador también producirá eventos, no estados: así este
bloque sirve igual para el monitor, para USB o para cualquier otra fuente.

Cómo se usa:

```powershell
python 30.fpga-cpu-console\monitor.py input      # F12 en la ventana para salir
```

Las decisiones y el protocolo de los dos comandos están en `mmio.md` §16.5. En
resumen: cada palabra son 4 bytes en little-endian, todas las de un report van
en un comando, la respuesta lleva los huecos libres de la FIFO (el control de
flujo) y el monitor consume siempre todas las palabras aunque no quepan.

Qué cambió respecto a la 21 para tenerlo:

| Pieza | Cambio |
|---|---|
| [`input_registers.v`](input_registers.v) | El bloque: STATE, FIFO de 16 palabras drop-new, `OVERFLOW` pegajoso, `FLUSH` con prioridad sobre el push |
| `monitor.v` | `HAS_INPUT`, `INPUT_EVENTS` (`3B`) e `INPUT_PRESENCE` (`3C`). Copia **idéntica** en las doce carpetas con monitor; con `HAS_INPUT = 0` contestan `ff` |
| `mmio_decoder.v` | Bloque `0x8060_0000`: solo palabras alineadas; escribir un registro de solo lectura, leer `EVENT_CTRL`, un registro reservado o una máscara parcial dan error |
| `top.v` | `HAS_INPUT`, `WINDOW4` del monitor y monitor **5.30** (MAYOR 5: juego base + serie + INPUT) |
| `DEVICES` | 0x237 → **0xA37** (bit 11, INPUT), derivado de la capacidad `input_device` |

Las demás carpetas reciben el nuevo `monitor.v` con `HAS_INPUT = 0`: su protocolo
no cambia, pero el texto del fichero sí, así que **sus bitstreams quedan
desfasados** hasta que se vuelvan a sintetizar.

Pruebas, todas sin placa:

| Banco | Qué comprueba |
|---|---|
| [`input_registers_tb.v`](input_registers_tb.v) | Diferencial contra `InputDevice`: 7 760 operaciones de `input_vectors.hex` (lo genera `tools/gen_input_vectors.py`), con las colisiones `FLUSH`/pop/`CLEAR_OVERFLOW` en el mismo ciclo |
| [`monitor_input_tb.v`](monitor_input_tb.v) | Los dos comandos contra el bloque real: lotes de 1 y 16, lote mayor que los huecos, sondeo, y `HAS_INPUT = 0` contestando `ff` |
| [`mmio_input_ack_tb.v`](mmio_input_ack_tb.v) | Mux + decodificador + bloque: los accesos inválidos dan error en el ciclo del `ack` y no tienen efecto |
| [`cpu_input_tb.v`](cpu_input_tb.v) | Un programa lee INPUT mientras el monitor lo alimenta, con la CPU en marcha y parada |
| `test_input_codec.py` | El codec Python contra un modelo de la FPGA |
## Base CPU heredada

La CPU conserva los **cuatro cambios independientes** de la 21. Todo lo demás
—camino de ráfagas BL8, vídeo, monitor, accesos sub-palabra y llamadas— parte
de esa carpeta.

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

### Frecuencia de la 21

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

Para repetirlo:

```powershell
..\tools\build-sweep.ps1 --prototype 21.fpga-cpu-hdmi-alu --seeds 1 2 3 4 5 6 7 8
```

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

---

## 1. Desplazamientos con inmediato

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

```text
31          26 25    21 20    16 15    11 10   9              0
┌─────────────┬────────┬────────┬────────┬───┬────────────────┐
│   opcode    │   Rd   │   Ra   │ Rb/imm │ I │       0        │
└─────────────┴────────┴────────┴────────┴───┴────────────────┘
                                            ↑ 1 = cantidad inmediata
```

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

---

## 2. La familia ALU completa

Las cuatro reservadas de `1.isa/isa.md` §3, implementadas enteras:

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

### `MULHI` es con signo, y no es gratis

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

El razonamiento completo, y el del signo del resto, están en
[`docs/alu-extendida.md`](../21.fpga-cpu-hdmi-alu/docs/alu-extendida.md).

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

---

## 3. `R0` cableado a cero

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

Detalles en [`docs/registro-cero.md`](../21.fpga-cpu-hdmi-alu/docs/registro-cero.md). Verificación:
[`zero_register_tb.v`](zero_register_tb.v), que recorre los seis caminos por los
que la CPU escribe el banco, y el caso
[`basics/zero-register`](../t.tests/cases-cpu/basics/zero-register/).

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

### Qué se rompió con `R0` a cero, y cómo quedó

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

La 19 se queda como está y sigue siendo válida: allí `R0` es un registro
general.

---

## 4. El medio resultado que la CPU tiraba

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

**Medido en simulación**, con [`alu_fast_path_tb.v`](alu_fast_path_tb.v):

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

Las reglas y qué protege cada una están en
[`docs/alu-extendida.md`](../21.fpga-cpu-hdmi-alu/docs/alu-extendida.md) §3.

### Romper las suites a propósito

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

---

## 5. Comparaciones materializadas: `SLT` y `SLTU`

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

```text
0x26 SLT  Rd, Ra, Rb   Rd = (signed(Ra)  < signed(Rb)) ? 1 : 0
0x27 SLTU Rd, Ra, Rb   Rd = (Ra           < Rb)         ? 1 : 0
```

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

```asm
SLT  Rd, Ra, R0      ; Rd = signo de Ra
SLTU Rd, R0, Ra      ; Rd = (Ra != 0)
```

y los dos están entre los vectores de
[`compare_tb.v`](compare_tb.v).

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

---

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

## Lo nuevo respecto a la 18

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

Las llamadas cuestan aún menos hardware: reutilizan `STATE_BRANCH_COMMIT` entero
y solo añaden un sumador de desplazamiento y el enlace escrito desde `pc`. El
diseño y por qué `JR` sigue teniendo opcode propio están en
[`docs/llamadas.md`](../21.fpga-cpu-hdmi-alu/docs/llamadas.md); la verificación es el lote de llamadas de
[`cpu_tb.v`](cpu_tb.v).

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

### Frecuencia

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

Para repetirlo:

```powershell
..\tools\build-sweep.ps1 --prototype 19.fpga-cpu-hdmi-ls --seeds 1 2 3 4 5 6 7 8
```

---

Lo que sigue es el README de la 18, que describe el camino de ráfagas.

**Estado: en curso.** Lo que hay hecho y medido:

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

## Un framebuffer de verdad, sin placa

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

```powershell
..\.venv\Scripts\apio.exe test video_fullframe_tb.v
..\.venv\Scripts\python.exe ..\tools\frame-to-image.py frame_full.bin mirar.jpg
..\.venv\Scripts\python.exe ..\tools\frame-to-image.py frame_full.hex mirar.png --escala 2
```

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

Dos cosas difieren de la placa y conviene saberlas:

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

## La combinación de escrituras

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

**4,15×** sobre la 16, o **3,32× netos** contando el reloj más lento.

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

## El árbitro, y dos cosas que su banco corrigió

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

## Una trampa de `memory_fabric_4`, para la lista

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

## El búfer de instrucciones

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

### Coherencia, que aquí es barata

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

### Lo que cobra

Sobre el bucle interior real, 160 iteraciones:

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

### Lo que costó en la FPGA

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

---

# Documentación heredada de la 16

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

## Escalera de hitos

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

## Qué hay en el hito A

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

```text
clk_25mhz ─┬─ pll_cpu ──── 100 MHz ── CPU + monitor UART + SDRAM
           │
           └─ clock2_gen ─┬─ 125,0 MHz ── serializador TMDS
                          └─  25,0 MHz ── simple_480p → video_pattern → DVI → gpdi
```

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

### Modo de vídeo

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

### Lo que se ve

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

## Qué hay en el hito B

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

```text
   dominio de sistema, 100 MHz          dominio de pixel, 25 MHz
   ───────────────────────────          ────────────────────────

   video_line_source_pattern
        │  (en el hito C pasa a ser el lector de SDRAM)
        ▼
   escritura ─────► line_buffer ──────► lectura, cada pixel y
                     2 bancos            cada linea por duplicado
                                              │
                     handshake                ▼
        fill_start ◄──────────────── peticion de linea
        fill_done  ────────────────► banco listo
```

### Por qué doble banco y no una FIFO asíncrona

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

### Underflow

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

### El primer frame tras reset es basura

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

## Qué hay en el hito C

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

### El framebuffer

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

### Arbitraje: la prioridad tuvo que acotarse

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

```text
presupuesto     2 × 800 píxeles / 25 MHz = 64 µs = 6400 ciclos a 100 MHz
coste           SRC_W × V + (SRC_W / VIDEO_RUN) × C

con V = 10 ciclos por acceso de vídeo y C = 20 por transacción de CPU:

VIDEO_RUN = 1   →  9600 ciclos   no cabe
VIDEO_RUN = 4   →  4800 ciclos   cabe, 25 % de margen
```

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

### Cómo probarlo en la placa

```powershell
..\.venv\Scripts\python.exe ..\..\tools\make-framebuffer diagonal fb.bin
..\.venv\Scripts\python.exe monitor.py write-block 0x01000000 fb.bin --port COM3
```

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

## Qué hay en el hito D

Una ventana de registros y el doble framebuffer que gobiernan.

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

### El instante del intercambio

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

### Acceso desde la CPU y desde el monitor

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

Eso permite probar el swap **sin escribir ni una línea de programa**:

```powershell
..\.venv\Scripts\python.exe ..\..\tools\make-framebuffer bars fb0.bin
..\.venv\Scripts\python.exe ..\..\tools\make-framebuffer checker fb1.bin
..\.venv\Scripts\python.exe monitor.py write-block 0x01000000 fb0.bin --port COM3
..\.venv\Scripts\python.exe monitor.py write-block 0x01025800 fb1.bin --port COM3
..\.venv\Scripts\python.exe monitor.py write-byte 0x80000008 1 --port COM3
```

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

### Los programas

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

### Los dos demos de Bresenham

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

Las operaciones que este último deja como candidatas para evolucionar la ISA
—y las optimizaciones que no necesitan tocarla— se analizan en
[`docs/cubo-solido-isa.md`](../21.fpga-cpu-hdmi-alu/docs/cubo-solido-isa.md).

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

Los dos reparten el enlace entre varios registros —`R31` y `R30` en las rectas,
más `R29` en las circunferencias— en lugar de salvarlo en memoria. Funciona
porque `JAL` nombra su registro de enlace explícitamente, y es barato con dos o
tres niveles, pero **no escala**: con recursión no vale de ninguna manera. Los
propios ficheros lo explican y apuntan a [`docs/llamadas.md`](../21.fpga-cpu-hdmi-alu/docs/llamadas.md);
el caso `calls-link-and-return` de [`t.tests`](../t.tests) hace la
versión con pila.

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

```powershell
..\tools\run-board.ps1 --prototype 21 --program swap_demo_fast
..\tools\run-board.ps1 --prototype 21 --program tear_demo_fast
..\tools\run-board.ps1 --prototype 21 --program bresenham_lines
..\tools\run-board.ps1 --prototype 21 --program bresenham_circles
..\tools\run-board.ps1 --prototype 21 --program swap_demo --no-run     # cargar sin arrancar
..\tools\run-board.ps1 --prototype 21 --program tear_demo --port COM4
```

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

```powershell
..\tools\demo-no-cpu.ps1 --prototype 30 --pattern frame
```

#### Qué se ve, y por qué

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

#### El umbral de los 16,7 ms

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

#### La contabilidad que exige el doble buffer

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

#### Cómo se miden, y cómo se midieron mal

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

Hay dos trampas, y la primera se cayó en ella:

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

## Temporización: de 120 a 100 MHz

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

Lo que cuesta:

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

### El baudio: dos condiciones, no una

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

Entre 40 y 200, el único divisor que cumple ambas es **100 → 1 Mbaud**:

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

### El pulso del monitor, y por qué el vídeo lo hacía desaparecer

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

### Por qué se degradó, y por qué no es lo que parece

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

```text
instruction → decodificación de shift_kind → step_active → branch_taken → pc
8,34 ns totales: 1,9 de lógica y 4,9 de routing
```

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

### Se intentó recuperar los 120 MHz, y no salió

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

```text
antes    min 102,03   mediana 109,46   max 111,35
después  min 103,57   mediana 110,13   max 116,97
```

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

### Resultado a 100 MHz

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

## Lo que sólo dijo la placa

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

### La captura de DQ no tenía margen

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

```text
semilla 7 ->  (3,4) (3,5) (7,4) (7,5)
semilla 1 ->  (0,6) (3,4) (3,6) (4,6) (6,6) (7,4) (7,6)
```

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

```verilog
reg [15:0] dq_negedge;
always @(negedge clk) dq_negedge <= sdram_d;
```

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

La matriz queda como herramienta, porque es lo único que distingue este fallo:

```powershell
..\.venv\Scripts\python.exe sdram_dq_matrix.py --port COM3
```

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

### `HALT_AT` sólo servía una vez por encendido

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

### El contador de instrucciones contaba una de menos

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

## Uso y comprobaciones

Desde esta carpeta:

```powershell
..\.venv\Scripts\apio.exe test video_fullframe_tb.v
..\.venv\Scripts\apio.exe test video_frame_tb.v
..\.venv\Scripts\apio.exe test cpu_burst_system_tb.v
..\.venv\Scripts\apio.exe test write_combine_tb.v
..\.venv\Scripts\apio.exe test memory_fabric_tb.v
..\.venv\Scripts\apio.exe test video_burst_tb.v
..\.venv\Scripts\apio.exe test sdram_controller_128_tb.v
..\.venv\Scripts\apio.exe test instruction_buffer_tb.v
..\.venv\Scripts\apio.exe test perf_probe_tb.v
..\.venv\Scripts\apio.exe test cpu_video_tb.v
..\.venv\Scripts\apio.exe test video_registers_tb.v
..\.venv\Scripts\apio.exe test video_sdram_tb.v
..\.venv\Scripts\apio.exe test video_scanout_tb.v
..\.venv\Scripts\apio.exe test cpu_sdram_system_tb.v
..\.venv\Scripts\apio.exe test cpu_tb.v
..\.venv\Scripts\apio.exe test monitor_tb.v
..\.venv\Scripts\apio.exe test sdram_controller_tb.v
..\.venv\Scripts\apio.exe test sdram_system_adapter_tb.v
..\.venv\Scripts\apio.exe build
```

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

### Qué mapa de direcciones prueba cada banco

Hay **dos** decodificadores MMIO en esta carpeta, y hasta ahora no estaba dicho
en ninguna parte:

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

La suite completa de CPU contra esta placa:

```powershell
..\.venv\Scripts\python.exe ..\t.tests\run_tests.py --backend fpga-cpu --version bl8 --port COM3
```

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

### Medir el CPI

La CPU tiene un dispositivo MMIO de contadores, **CPU PERFORMANCE**, en
`0x81010000` ([`cpu_perf_counters.v`](cpu_perf_counters.v), contrato en
[`mmio.md`](../1.isa/mmio.md) §13.2). Son ocho: `CYCLES` y `RETIRED` (CPI e IPC),
las búsquedas que aciertan y fallan en el búfer de instrucciones, las peticiones
al fabric y tres de espera —a la búsqueda, a los datos y a MMIO— que reparten los
ciclos entre cálculo y memoria. El propio programa puede leerlos, porque son
MMIO. Los comandos `0x36` y `0x37` del monitor, que daban solo los dos primeros,
ya no existen.

Desde el PC, `monitor.py perf` congela el bloque, lee los ocho y da el reparto:

```powershell
..\.venv\Scripts\python.exe monitor.py perf --port COM3        # lo acumulado desde el último run
..\.venv\Scripts\python.exe monitor.py perf 2 --port COM3      # lo contado en una ventana de 2 s
```

Con un programa que lleva minutos corriendo, usa la ventana (`perf 2`): los
contadores dan la vuelta a los 53 s y sus valores absolutos dejan de significar
nada, aunque las diferencias siguen valiendo. El comando avisa cuando pasa.

Para comparar esta versión con las anteriores en los mismos programas, el runner
tiene `--measure`, que saca una tabla en Markdown con instrucciones, tiempo y CPI
y, para las versiones que tienen los contadores de espera —hoy solo esta—, una
tercera con el reparto de los ciclos de cada caso:

```powershell
..\.venv\Scripts\python.exe ..\t.tests\run_tests.py --backend fpga-cpu `
    --measure medidas.md --port COM3 ..\t.tests\cases
```

Qué cuenta exactamente cada contador, cómo leerlos, un ejemplo y por qué dan la
vuelta en lugar de saturar están en [`docs/cycles.md`](docs/cycles.md).

### `MUL`, `MULFX` y `DIV`

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

## Notas de integración

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

## Pasos siguientes

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

### El número incómodo

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

De ahí salen tres caminos, de menos a más ambicioso:

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

### Lo que falta en la CPU

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
