jlopezr/mini-gpu/32.cpu-gpu-func-sim/README.md

# 32.cpu-gpu-func-sim

Simulador funcional de **MiniCPU + MiniGPU sobre una RAM compartida**, con el
mapa y los permisos de MMIO v2 ([`../1.isa/mmio.md`](../1.isa/mmio.md)).

No reimplementa ningún núcleo: importa la `CPU` de
[`../2.cpu-sim-func`](../2.cpu-sim-func/minicpu_sim.py) y el `System` de
[`../11.gpu-sim-func`](../11.gpu-sim-func/minigpu_sim.py), y les pone en medio lo
que les falta para convivir. Un arreglo en cualquiera de los dos simuladores
llega aquí sin tocar nada.

```bash
sim-sys t.tests/cases-cpu-gpu/launch/launch.asm
python -m unittest test_cpu_gpu_sim        # desde esta carpeta: 14 s, sin las clases lentas
RUN_SLOW=1 python -m unittest test_cpu_gpu_sim   # todo: unos 110 s (en PowerShell, $env:RUN_SLOW = "1")
```

Las clases lentas (`@slow` en el test) simulan varios fotogramas de un demo en su `setUpClass`: `PollExperimentTest`,
`BenchDmaTest` y los de `race` (`LifeRaceTest`, `BlurRaceTest`, `RotateRaceTest`, `CubeRaceTest`, `CCubeRaceTest`,
`LifeRaceStripTest`, `CRotateTest`, `CPlaneRaceTest`). Por defecto salen como omitidas; hay que correrlas antes de dar por
bueno un cambio en el compilador, en `mini-opt` o en un demo.

## GPU ociosa y rendimiento del anfitrión

El planificador conserva el reparto CPU/GPU por ronda y comprueba los límites
antes de cada instrucción. Cuando no hay warps vivos, `GpuUnit.halted` usa
`WARP_LIVE` y `GpuUnit.step()` devuelve sin entrar en la máquina SIMT. La misma
consulta barata se usa al comprobar el límite GPU y el fin de ejecución.
`HALT` y los errores también detienen la GPU; una espera en barrera con warps
vivos conserva la detección de `stalled` cuando la CPU ya ha parado, y no se
considera GPU ociosa.

Medida local con PyPy 3.11, sin ventana ni profiling, del binario MiniGL
`39.mini-gl/build/minigpu/3d/boxes.bin`, hasta 12 swaps:

| | Antes | GPU ociosa optimizada |
|---|---:|---:|
| Tiempo de pared, dos ejecuciones | 13,007 / 13,300 s | 4,580 / 4,580 s |
| Instrucciones CPU, cada ejecución | 42 190 000 | 42 190 000 |
| Instrucciones GPU | 0 | 0 |

Unas **2,87 veces más rápido** (65% menos tiempo) en esta medición, incluido
el arranque y calentamiento del JIT. Los framebuffers finales de ambos ensayos
son idénticos. No es una medida de la velocidad de la FPGA ni incluye ventana.
Regresión: los 150 tests, incluidos los lentos, pasan con CPython mediante
`RUN_SLOW=1 PYTHON=python3 tools/test --prototype 32 --full`. Se compararon
también trazas, registros, RAM y contadores con la implementación anterior en
el programa `launch`, con repartos CPU/GPU 1:1, 5:1, 1:5 y 3:7: idénticos.
Para reproducir, desde la raíz del repositorio y con el binario ya compilado:

```sh
"$(uv python find pypy)" tools/sim-sys 39.mini-gl/build/minigpu/3d/boxes.bin \
    --halt-after-swaps 12 --run-limit 1000000000 --frame-output /tmp/boxes.bin
```

## Backend Codon

Si Codon está instalado, `sim-sys` ejecuta CPU y GPU SIMT en un motor nativo
compilado con Codon a partir de `cpu_gpu_core.py` y de los núcleos de 2 y 11,
**los mismos ficheros** que usa Python: el modelo está en `cpu_gpu_core.py` y
`cpu_gpu_sim.py` añade la línea de órdenes. Es `--backend auto`, el valor por
defecto; sin Codon (en Windows, siempre) usa Python. Vídeo, entrada, serie y
ventana son los periféricos Python; traza y profiling usan siempre el motor Python.

```sh
sim-sys t.tests/cases-cpu-gpu/launch/launch.asm                  # Codon si está
sim-sys t.tests/cases-cpu-gpu/launch/launch.asm --backend python # forzar Python
RUN_CODON=1 PYTHON=python3 tools/test --prototype 32 --quick
```

Requiere Codon y una biblioteca compartida de CPython. La primera ejecución
compila el motor; las siguientes reutilizan la caché de `_build/codon-engine/`.
Al tocar `cpu_gpu_core.py` hay que respetar lo que Codon no admite
([`tools/codon/LIMITACIONES.md`](../tools/codon/LIMITACIONES.md)); las pruebas
con `RUN_CODON=1` lo comprueban. Detalles y mediciones en
[`tools/codon/README.md`](../tools/codon/README.md).

## Programas

Los programas que corren en este simulador (y los de la placa 36) están en
[`t.tests/cases-cpu-gpu`](../t.tests/cases-cpu-gpu/README.md), uno por carpeta y cada uno con su README:

| Programa | Qué es |
|---|---|
| [launch](../t.tests/cases-cpu-gpu/launch/) | CPU y kernel en un solo fichero, sin ninguna dirección escrita a mano |
| [dma](../t.tests/cases-cpu-gpu/dma/) | El arnés del [diseño de GPU/DMA](docs/diseno-gpu-dma.md), los kernels de sistema y su [benchmark](docs/bench-dma.md) |
| [race](../t.tests/cases-cpu-gpu/race/) | Demos de «carrera»: el mismo trabajo con CPU, GPU inocente y GPU buena |
| [render](../t.tests/cases-cpu-gpu/render/) | Un plasma que pinta la GPU, con el bucle de frames en la CPU |
| [simt](../t.tests/cases-cpu-gpu/simt/) | Kernels en C con divergencia |

[`compare/`](compare/README.md) tiene las herramientas que miden el C frente al ensamblador en este simulador.
`test_cpu_gpu_sim.py` comprueba los programas contra modelos en Python.
`--window` abre la ventana y ya implica el vídeo; sin ventana, `--video` da los registros de vídeo (en `mini-dbg`,
`fb` abre una ventana con el framebuffer).

## Qué se comparte

| | |
|---|---|
| **RAM** | El mismo `bytearray` en la CPU y en todas las lanes de la GPU. Lo que escribe uno lo lee el otro sin copias ni caché. |
| **SYSTEM, SERIAL, VIDEO, INPUT** | Los dispositivos de `tools/sim_devices.py`, accesibles desde las dos (§15). `SYSTEM_ID` es 32 y `DEVICES` declara también el bit de GPU. |
| **Reloj de dispositivos** | Una vez por instrucción retirada, de CPU o de warp. `HALT_TARGET` decide a quién para `HALT_AT`: bit 0 la CPU, bit 1 la GPU. |

## Dónde se sincronizan

Solo en el MMIO de la GPU (§14), que es lo que hace el hardware. No hay otro
canal.

```text
CPU escribe código y datos en RAM
CPU escribe descriptores en GPU WARPS (0x82010000)
CPU escribe GPU_CONTROL.RUN  o  WARP_START          ← lanza
GPU ejecuta (los warps escriben en la RAM)
CPU lee GPU_STATUS / WARP_LIVE / WARP_DONE          ← sondea
CPU escribe unos en WARP_DONE (W1C) y lee resultados
```

Implementado según el contrato: `RUN` (solo sin warps vivos), `HALT`, `RESUME`
(solo con la GPU detenida), `STEP` (una instrucción de warp, solo detenida),
`RESET` (conserva los descriptores), `WARP_START` (añade trabajo con otros warps
en marcha), `WARP_LIVE`, `WARP_DONE` pegajoso y W1C, `GPU_CAPS` con la geometría
real y `GPU_STATUS` (`RUNNING`, `HALTED`, `IDLE`, `ERROR`, `LIVE_WARPS`).

Los accesos inválidos paran el núcleo que los hace con error `0x02`, no devuelven
cero (§4.3): escribir un registro de solo lectura, bits reservados o dos
comandos a la vez en `GPU_CONTROL`, `WARP_START` de un warp no implementado, ya
vivo o con `ACTIVE = 0`, `RUN` con warps vivos, `RESUME`/`STEP` sin `HALT`,
`PC` desalineado, `ACTIVE` con lanes que no existen, y tocar el descriptor de un
warp en marcha.

### Configuración por warp: id lógico y argumento

Además de los descriptores, GPU WARPS tiene dos arrays de una palabra por warp
(§14.2): `LOGICAL_WARP_ID[n]` en `+0x200 + 4n` y `WARP_ARG[n]` en `+0x280 + 4n`,
de lectura y escritura. La CPU los rellena antes de `WARP_START` y el kernel los
lee con las instrucciones `GETLWARP` y `GETARG` (la familia `GETID` de
[`isa.md`](../1.isa/isa.md), junto con `GETLANE` y `GETWARP`).

- Escribirlos con el warp vivo es error, como el resto del descriptor.
- `GPU_CONTROL.RESET` los **conserva**, igual que los descriptores.
- Se copian al warp al lanzarlo, así que un cambio posterior en el registro no
  afecta a un warp que ya corre.

Así un kernel recibe su parámetro sin ninguna dirección escrita a mano: la CPU
pone en `WARP_ARG` el puntero a un bloque de argumentos, y en `LOGICAL_WARP_ID`
qué warp lógico es cada uno, que no tiene por qué coincidir con su slot físico.
El diseño que usa esto está en [`docs/diseno-gpu-dma.md`](docs/diseno-gpu-dma.md).

Una **GPU con error** queda parada con `GPU_STATUS.ERROR` y `FIRST_ERROR` /
`FIRST_ERROR_PC` en `GPU SIMT DEBUG`; la CPU sigue. Solo `RESET` la recupera, y
mientras haya error `RUN` y `WARP_START` fallan.

## Permisos por master (§15)

| Bloque | CPU | GPU |
|---|---|---|
| SYSTEM | R | R |
| SERIAL, VIDEO, INPUT | RW | RW |
| CPU CORE (`0x81000000`) | R | — |
| GPU CORE, solo `ID`…`STATUS` | RW | R |
| GPU CORE, `CONTROL`, `WARP_*` | RW | — |
| GPU WARPS (descriptores, `LOGICAL_WARP_ID`, `WARP_ARG`) | RW | — |
| GPU SIMT DEBUG | RW (solo `CONTEXT` escribible) | — |

Un warp no puede reprogramarse a sí mismo ni a sus vecinos: es error.

## Planificación

Determinista y de un solo hilo. Cada ronda ejecuta `--cpu-steps` instrucciones
de CPU (1) y luego `--gpu-steps` de warp (1), con el round-robin de `11`. El
resultado de un programa correcto **no depende** de la proporción (hay un test),
pero el reparto es una elección del modelo, no una medida: el simulador cuenta
instrucciones, no ciclos ni esperas, y no reproduce contienda por la memoria.

Termina cuando la CPU ha parado y la GPU no puede avanzar sola (sin warps vivos,
con error o detenida). Una CPU con `HALT` no corta a la GPU: los warps lanzados
terminan. Si la CPU ya paró y quedan warps vivos sin poder avanzar (una barrera
a la que no llegan todos) sale con código 2 y el aviso «sin progreso».

**Límites de ejecución.** `--run-limit N` vale **N para cada núcleo**: N
instrucciones de CPU y N de warp (no N entre las dos), contando los warps
relanzados. `--cpu-run-limit` y `--gpu-run-limit` lo sustituyen para uno solo,
por si quieres, por ejemplo, dejar la CPU libre y acotar la GPU. Se comprueban
antes de cada instrucción y salta el primero que se alcance, con código 2 y el
mensaje de qué núcleo fue. Un núcleo que ya paró no dispara su límite.

## Línea de órdenes

```text
cpu_gpu_sim.py PROGRAMA [--num-warps 8] [--warp-size 8]
    [--cpu-steps 1] [--gpu-steps 1]
    [--run-limit N] [--cpu-run-limit N] [--gpu-run-limit N]
    [--memory-size 0x2000000] [--dump DIR TAM FICHERO]
    [--trace | --trace-file F] [--trace-limit N]
    [+ periféricos de tools/sim_peripherals.py]
```

Una sola imagen, cargada en 0: el código de la CPU primero (termina con `HALT`
antes de llegar al kernel) y el kernel detrás. Para tenerlos en ficheros
distintos, `.include "kernel.asm"` en el de la CPU: las etiquetas son globales,
así que cada uno puede usar las del otro. No hay opción para cargar un kernel
aparte: obligaría a escribir su dirección a mano.

La CPU pone los descriptores y lanza: no hay ningún `--config` que lo haga por
ella, porque eso sería un camino que la placa no tiene.

`--trace` intercala una línea por instrucción, con `CPU` delante de las de CPU y
`GPU` delante de las de warp (el formato de `11`):

```text
CPU     0x00000030  LOAD R15, R10, 36
GPU     000001  W0   0x0000004C  FF  AAAAAAAA GETTID R1   -> 0x00000050 READY
```

`--trace-limit N` (implica `--trace`) imprime como máximo N líneas, de CPU y de
warp juntas, y avisa con `... traza limitada a N líneas; la ejecución continúa`.
Solo limita lo que se imprime: el programa corre hasta el final. Para parar la
ejecución están los límites de arriba.

Código de salida: 0 bien, 1 error de CPU o de GPU, 2 límite alcanzado, sin
progreso o entrada inválida.

## Límites conocidos

- **Provisional:** `CPU_ID` (2) y `GPU_ID` (11) son el número de carpeta del
  modelo que implementa cada núcleo, `*_VERSION` es 1, `*_FEATURES` es 0,
  `CPU_STATUS` usa el bit 0 (parada) y el 1 (error), y `WARP_RETIRED` lee el
  warp de `CONTEXT`. §22 pospone esos bits «junto a MiniISA» y §14.3 no dice de
  qué warp es el contador: cuando se definan, se cambian aquí.
- CPU PERFORMANCE, GPU PERFORMANCE, CPU DEBUG, TIMER, INTC, DMA, FABRIC y SDRAM
  no existen: acceder es error (§17), no cero.
- **§4.2 (una sola lane activa en un acceso MMIO desde SIMT) no se comprueba**:
  es una carencia heredada de `11`, que serializa las lanes en silencio. Los
  kernels de los tests y de la demo usan `ACTIVE = 1` cuando acceden a MMIO.
- **Accesos de 8 y 16 bits en la GPU:** el simulador de `11` los tiene (se
  retroportaron de la CPU y del modelo de ciclos de la 25), así que los kernels de
  este simulador pueden usar `LOADB`/`LOADUB`/`STOREB`/`LOADH`/`LOADUH`/`STOREH`
  sobre RAM. El RTL también: el SM de la 29, y con él las placas 36 y 37, los
  decodifica y la LSU escribe con máscara por byte (capability `subword_memory`).
  Las GPU anteriores (12, 14, 17, 22) no los tienen. Contra MMIO son error, como
  manda §4.1.
- La GPU de `11` no tiene `JAL`/`JR`; el kernel solo puede usar su ISA, y la CPU
  la suya.
