jlopezr/mini-gpu/14.fpga-gpu-ram/README.md

# MiniGPU con SDRAM: 8 warps × 8 lanes

> **Backport de `R0` cableado a cero.** Esta carpeta recibio el cambio despues
> de cerrarse: `R0` vale siempre cero y descarta las escrituras, que es una
> regla de la MiniISA y no una extension opcional. Ver
> [`1.isa/isa.md`](../1.isa/isa.md) seccion 1.
>
> El guardian NO esta en `gpu_register_file.v` sino en `gpu_sm.v`, que es la
> diferencia con la MiniCPU y conviene no perderla: aqui el banco es BRAM y no
> tiene reset, lo pone a cero un barrido de 256 ciclos en el estado `INIT`. Si
> el guardian estuviera dentro del banco bloquearia tambien ese barrido, `R0` no
> se inicializaria nunca y en simulacion se quedaria a `X`. Dejando el barrido
> fuera, lo escribe una vez y ninguna instruccion vuelve a tocarlo.
>
> **Este monitor responde ahora 3.14.** Subio con el renumerado a juego de comandos (mayor) y numero de carpeta (menor), sin cambiar ni
> un byte del protocolo. Los numeros de version que se mencionan mas abajo son
> historicos; los de hoy estan en [`resumen-prototipos.md`](../docs/resumen-prototipos.md).

Copia del RTL de `12.fpga-gpu` con memoria unificada de **32 MiB de SDRAM**
en lugar de los ocho bancos EBR de 128 KiB. Destino: ULX3S-85F,
**25 MHz**, UART **250000 baudios**, monitor **3.14**.

Comparte todos los comandos con la 12, que responde 3.12: el mayor es igual
porque el juego de comandos es el mismo, y el menor los distingue porque **es el
número de carpeta**. Eso es lo que permite a `t.tests --version sdram` saber que
no tiene delante el bitstream de BRAM. Antes esos números se elegían a mano, y
14 y 17 llegaron a compartir el mismo.

Código, LOAD/STORE y monitor comparten `0x00000000–0x01ffffff`.
Las palabras son de 32 bits little-endian, alineadas a cuatro bytes;
la última comienza en `0x01fffffc`. El monitor conserva sus accesos por byte
y las ventanas de 12: depuración SIMT en `0x80000100` y configuración de warps
en `0x80001000`, la segunda página, exclusiva de la GPU (ver
[`docs/resumen-prototipos.md`](../docs/resumen-prototipos.md)).
Los registros de la GPU siguen usando EBR; se sustituye la RAM de código/datos.

## Integración

- `gpu_sm.v`, `gpu_lane.v` y `gpu_register_file.v` conservan el RTL de 12.
- `gpu_lsu.v` conserva el contrato vectorial SM↔LSU y los ocho slots de warp.
  Atiende una lane cada vez y rota entre warps después de cada palabra.
  Alterna con el puerto auxiliar de fetch/monitor cuando ambos tienen trabajo.
  Las respuestas vectoriales retenidas no bloquean el fetch.
- `gpu_system.v` conecta el SM, la LSU y el monitor. El monitor accede a memoria
  cuando la GPU está detenida y ha drenado sus operaciones.
- `sdram_controller.v` procede de 10 (idéntico al de 9), parametrizado desde
  `top.v` a 25 MHz. Solo se explicitan extensiones de ancho de contadores para lint.
  Cada palabra requiere dos accesos BL1 de 16 bits; no hay caché ni coalescencia.
  Las máscaras DQM preservan los bytes no escritos por el monitor.
- `top.v` conecta los pines SDRAM usando el LPF de 12, que ya incluía su pinout.

Se esperan `init_done` y la aceptación real de cada petición. Una respuesta STORE
solo se publica después de recibir `done` para ambas mitades de todas las lanes.
Las direcciones desalineadas o fuera de rango generan errores por lane activa.
Una máscara vacía responde sin tocar memoria.

El reset del monitor reinicia la GPU y descarta sus transacciones pendientes,
pero **no reinicia el controlador SDRAM**: continúa el refresco y se conserva RAM.
Una transferencia ya aceptada puede terminar; las escrituras parciales no se
revierten. La siguiente petición espera la disponibilidad del controlador y
no recoge una finalización antigua. El reset global sí inicializa el controlador.

## Uso y comprobaciones

Desde la raíz del repositorio:

```powershell
./tools/test.ps1 --prototype 14
./tools/lint.ps1 --prototype 14
./tools/build.ps1 --prototype 14 --label check
.venv/Scripts/python.exe 14.fpga-gpu-ram/monitor.py --help
```

Se conservan los ejemplos, el generador de fixtures y las 32 pruebas diferenciales
contra `11.gpu-sim-func`. Las pruebas de sistema y UART usan el controlador real
con un modelo funcional del bus SDRAM (`sim/sdram_model.vh`). La inicialización
se acorta solo en las pruebas de sistema; el top conserva los 200 µs del controlador.
El modelo verifica datos/direcciones/máscaras, pero no sustituye una prueba física
ni un modelo de temporización del fabricante. Véase `validation.md`.
