jlopezr/mini-gpu/18.fpga-cpu-hdmi-bl8/README.md

# MiniCPU con SDRAM, salida HDMI y memoria en ráfagas

> **Backport de `R0` cableado a cero.** Esta carpeta recibio el cambio despues
> de cerrarse: `R0` vale siempre cero y descarta las escrituras, que es una
> regla de la MiniISA y no una extension opcional. Ver
> [`1.isa/isa.md`](../1.isa/isa.md) seccion 1.
>
> **Este monitor responde ahora 3.18.** Subio con el renumerado a juego de comandos (mayor) y numero de carpeta (menor), sin cambiar
> ni un byte del protocolo: es lo unico que el PC puede preguntar para saber que
> bitstream tiene delante, y un programa que use `R0` como registro general no
> para con error en el bitstream viejo, da otro resultado en silencio.
>
> El texto que sigue es anterior al backport. Los numeros de version que
> menciona mas abajo son historicos; los de hoy estan en
> [`resumen-prototipos.md`](../docs/resumen-prototipos.md).

Copia de [`../16.fpga-cpu-hdmi`](../16.fpga-cpu-hdmi) cuyo camino de memoria se
va sustituyendo por uno de ráfagas BL8, para que la CPU no pase la vida
esperando a la SDRAM. Es el punto 0 del [`../TODO.md`](../TODO.md).

**Estado: en curso.** Lo que hay hecho y medido:

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

El paso 0 reordenó el plan y está contado entero en
[`docs/medida-inicial.md`](docs/medida-inicial.md). El resumen: de los ~26 ciclos
por acceso de 16 bits, **8 son comandos de SDRAM y 6,5 son suelo de handshake y
de CPU**; y **el scanout se lleva otro 35 %** del tiempo de la CPU. Por eso el
búfer de instrucciones se hizo primero: es lo más grande, y no necesita BL8 para
nada —sobre el bus de 16 bits ya daba 2,65×—.

El paso 2 encontró **dos fallos** en el controlador BL8 que llegó de
`pruebas/sdram`, uno de ellos grave: la ráfaga de lectura salía corrida un beat
en la placa. Está contado en
[`docs/controlador-bl8.md`](docs/controlador-bl8.md).

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

Y con eso **el camino de memoria entero está integrado en `top.v`**: controlador
de 128 bits, árbitro de cuatro puertos y un adaptador por cliente. El bucle
interior de `swap_demo_fast` pasa de los **146 ciclos por palabra de la 16 a
49,7: 2,94×**, medido por
[`cpu_burst_system_tb.v`](cpu_burst_system_tb.v) sobre el sistema completo.
Cómo está montado y qué costó cerrar temporización está en
[`docs/camino-de-memoria.md`](docs/camino-de-memoria.md).

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

## Un framebuffer de verdad, sin placa

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

```powershell
..\.venv\Scripts\apio.exe test video_fullframe_tb.v
..\.venv\Scripts\python.exe ..\tools\frame-to-image.py frame_full.bin mirar.jpg
..\.venv\Scripts\python.exe ..\tools\frame-to-image.py frame_full.hex mirar.png --escala 2
```

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

Dos cosas difieren de la placa y conviene saberlas:

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

El programa es [`../t.tests/cases-cpu/demos/fullframe/fullframe_tb.asm`](../t.tests/cases-cpu/demos/fullframe/fullframe_tb.asm) —**no**
[`../t.tests/cases-cpu/demos/fullframe/fullframe.asm`](../t.tests/cases-cpu/demos/fullframe/fullframe.asm), que es el de la placa—, y
pinta una «L» azul y un cuadrado blanco. La «L» no es simétrica a propósito: un
marco completo se ve igual si alguien intercambia los ejes; una línea arriba y
una columna a la izquierda, no.

Los dos programas son idénticos salvo las dos `.equ` de las bases del
framebuffer: en la placa están en `0x01000000`, y ahí no caben en el modelo de
SDRAM del banco. Esta frase decía lo contrario y era falsa; regenerar
`fullframe.hex` «como ponía aquí» hace que el banco cuente 60 000 violaciones
JEDEC, que en realidad son 60 000 accesos a una fila que no existe.
[`t.tests/unit/build/test_fullframe_fixture.py`](../t.tests/unit/build/test_fullframe_fixture.py)
comprueba las tres cosas para que no vuelva a quedarse vieja.

## La combinación de escrituras

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

**4,15×** sobre la 16, o **3,32× netos** contando el reloj más lento.

Lo delicado no es la combinación sino los tres vaciados forzados —MMIO, parada de
la CPU, y lectura que caiga en la línea guardada—, y cada uno tiene control
negativo comprobado: se quitó del RTL y se verificó que el banco falla. Ahí
apareció un fallo real, que `wb_dirty` bajaba al *empezar* el volcado y no al
terminarlo, con lo que la carrera con el monitor seguía abierta. Está contado en
[`docs/combinacion-escrituras.md`](docs/combinacion-escrituras.md).

## El árbitro, y dos cosas que su banco corrigió

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

## Una trampa de `memory_fabric_4`, para la lista

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

## El búfer de instrucciones

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

### Coherencia, que aquí es barata

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

### Lo que cobra

Sobre el bucle interior real, 160 iteraciones:

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

### Lo que costó en la FPGA

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

Lo que costó cerrar temporización —de 84 a 100 MHz, con una parada en 78 por
arreglar el camino crítico equivocado— está en
[`docs/camino-de-memoria.md`](docs/camino-de-memoria.md).

---

# Documentación heredada de la 16

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

Estado: **hito D completado**. Hay doble framebuffer con intercambio
sincronizado, gobernado desde una ventana de registros en `0x80200000` que
manejan tanto la CPU como el monitor. Con esto termina la fase 2 del plan.

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

## Escalera de hitos

| Hito | Contenido | Estado |
|---|---|---|
| A | Fusión: CPU de 10 intacta + 640×480p60 con patrón generado por lógica | **hecho** |
| B | Doble line buffer, cruce de dominios y escalado 2×, con productor falso | **hecho** |
| C | Scanout real: la CPU escribe el framebuffer en SDRAM y se ve | **hecho** |
| D | Registros en `0x80200000` y doble framebuffer con swap sincronizado | **hecho** |

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

## Qué hay en el hito A

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

```text
clk_25mhz ─┬─ pll_cpu ──── 100 MHz ── CPU + monitor UART + SDRAM
           │
           └─ clock2_gen ─┬─ 125,0 MHz ── serializador TMDS
                          └─  25,0 MHz ── simple_480p → video_pattern → DVI → gpdi
```

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

### Modo de vídeo

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

### Lo que se ve

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

## Qué hay en el hito B

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

```text
   dominio de sistema, 100 MHz          dominio de pixel, 25 MHz
   ───────────────────────────          ────────────────────────

   video_line_source_pattern
        │  (en el hito C pasa a ser el lector de SDRAM)
        ▼
   escritura ─────► line_buffer ──────► lectura, cada pixel y
                     2 bancos            cada linea por duplicado
                                              │
                     handshake                ▼
        fill_start ◄──────────────── peticion de linea
        fill_done  ────────────────► banco listo
```

### Por qué doble banco y no una FIFO asíncrona

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

### Underflow

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

### El primer frame tras reset es basura

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

## Qué hay en el hito C

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

### El framebuffer

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

### Arbitraje: la prioridad tuvo que acotarse

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

```text
presupuesto     2 × 800 píxeles / 25 MHz = 64 µs = 6400 ciclos a 100 MHz
coste           SRC_W × V + (SRC_W / VIDEO_RUN) × C

con V = 10 ciclos por acceso de vídeo y C = 20 por transacción de CPU:

VIDEO_RUN = 1   →  9600 ciclos   no cabe
VIDEO_RUN = 4   →  4800 ciclos   cabe, 25 % de margen
```

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

### Cómo probarlo en la placa

```powershell
..\.venv\Scripts\python.exe ..\..\tools\make-framebuffer diagonal fb.bin
..\.venv\Scripts\python.exe monitor.py write-block 0x01000000 fb.bin --port COM3
```

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

## Qué hay en el hito D

Una ventana de registros y el doble framebuffer que gobiernan.

Las direcciones son las de **MMIO v2** ([`1.isa/mmio.md`](../1.isa/mmio.md) §9).
El bloque de vídeo vive en `0x80200000`, no en `0x80000000`, que ahora es
SYSTEM. Un programa no las escribe a mano: hace `.include "mmio.inc"` y usa los
símbolos, que los genera `tools/generate-mmio` desde `1.isa/mmio_map.vh`.

| Dirección | Símbolo del offset | Registro | | Contenido |
|---|---|---|----|---|
| `0x80200000` | `MMIO_VIDEO_CTRL_OFF` | `CTRL` | RW | modo: 0 BLANK, 1 PATTERN, 2 SCANOUT |
| `0x80200004` | `MMIO_VIDEO_FB_FRONT_OFF` | `FB_FRONT` | RW | dirección de byte del buffer que se muestra |
| `0x80200008` | `MMIO_VIDEO_FB_BACK_OFF` | `FB_BACK` | RW | dirección de byte del buffer que se dibuja |
| `0x8020000c` | `MMIO_VIDEO_SWAP_OFF` | `SWAP` | RW | escribir: pide intercambio. leer bit 0: pendiente |
| `0x80200010` | `MMIO_VIDEO_STATUS_OFF` | `STATUS` | R  | bit 0 underflow, bit 1 intercambio pendiente |
| `0x80200014` | `MMIO_VIDEO_FRAME_COUNT_OFF`  | `FRAME_COUNT` | R  | frames de barrido, registro propio de 32 bits |
| `0x80200018` | `MMIO_VIDEO_SWAP_COUNT_OFF` | `SWAP_COUNT`  | R  | intercambios completados |
| `0x8020001c` | `MMIO_VIDEO_HALT_AT_OFF` | `HALT_AT` | RW | alarma: para al completarse ese **intercambio** |
| `0x80200020` | `MMIO_VIDEO_HALT_TARGET_OFF`  | `HALT_TARGET` | RW | a quién para. **Tras reset vale 0: a nadie** |
| `0x80200024` | `MMIO_VIDEO_TX_OFF` | `VIDEO_TX` | R  | transacciones de vídeo contra memoria |

Tres cosas de v2 que muerden si se pasan por alto:

- **`CTRL` se mueve al principio**, así que los cuatro registros de siempre
  —`FB_FRONT`, `FB_BACK`, `SWAP` y `STATUS`— cambian todos de offset.
- **`FRAME_COUNT` es un registro propio**, no los bits 31:16 de `STATUS`.
- **`HALT_AT` no para a nadie mientras `HALT_TARGET` valga cero.** El síntoma
  de olvidarlo es un timeout, que no se parece a la causa. Cuenta
  **intercambios** completados desde que se arma, como en v1 (MMIO v2 llegó a
  contar frames y volvió a intercambios: mmio.md §9.6); armarlo no toca
  `FRAME_COUNT` ni `SWAP_COUNT`.

`FB_FRONT` y `FB_BACK` se alinean a **16 bytes**, y desalinearlas es un **error
de acceso**: en v1 se truncaban los bits bajos en silencio.

### El instante del intercambio

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

### Acceso desde la CPU y desde el monitor

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

Eso permite probar el swap **sin escribir ni una línea de programa**:

```powershell
..\.venv\Scripts\python.exe ..\..\tools\make-framebuffer bars fb0.bin
..\.venv\Scripts\python.exe ..\..\tools\make-framebuffer checker fb1.bin
..\.venv\Scripts\python.exe monitor.py write-block 0x01000000 fb0.bin --port COM3
..\.venv\Scripts\python.exe monitor.py write-block 0x01025800 fb1.bin --port COM3
# Tras el reset las dos bases valen CERO y el modo es PATTERN, asi que hay que
# ponerlo todo: el framebuffer es una decision del programa, no una reserva que
# el hardware imponga.
..\.venv\Scripts\python.exe monitor.py write-word 0x80200004 0x01000000 --port COM3  # FB_FRONT
..\.venv\Scripts\python.exe monitor.py write-word 0x80200008 0x01025800 --port COM3  # FB_BACK
..\.venv\Scripts\python.exe monitor.py write-word 0x80200000 2 --port COM3           # CTRL = SCANOUT
..\.venv\Scripts\python.exe monitor.py write-word 0x8020000C 1 --port COM3           # SWAP
```

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

### Los programas

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

```powershell
..\tools\run-board.ps1 --prototype 18 --program swap_demo_fast
..\tools\run-board.ps1 --prototype 18 --program tear_demo_fast
..\tools\run-board.ps1 --prototype 18 --program swap_demo --no-run     # cargar sin arrancar
..\tools\run-board.ps1 --prototype 18 --program tear_demo --port COM4
```

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

```powershell
..\tools\demo-no-cpu.ps1 --prototype 18 --pattern frame
```

#### Qué se ve, y por qué

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

#### El umbral de los 16,7 ms

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

#### La contabilidad que exige el doble buffer

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

#### Cómo se miden, y cómo se midieron mal

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

Hay dos trampas, y la primera se cayó en ella:

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

## Temporización: de 120 a 100 MHz

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

Lo que cuesta:

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

### El baudio: dos condiciones, no una

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

Entre 40 y 200, el único divisor que cumple ambas es **100 → 1 Mbaud**:

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

### El pulso del monitor, y por qué el vídeo lo hacía desaparecer

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

### Por qué se degradó, y por qué no es lo que parece

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

```text
instruction → decodificación de shift_kind → step_active → branch_taken → pc
8,34 ns totales: 1,9 de lógica y 4,9 de routing
```

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

### Se intentó recuperar los 120 MHz, y no salió

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

```text
antes    min 102,03   mediana 109,46   max 111,35
después  min 103,57   mediana 110,13   max 116,97
```

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

### Resultado a 100 MHz

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

## Lo que sólo dijo la placa

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

### La captura de DQ no tenía margen

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

```text
semilla 7 ->  (3,4) (3,5) (7,4) (7,5)
semilla 1 ->  (0,6) (3,4) (3,6) (4,6) (6,6) (7,4) (7,6)
```

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

```verilog
reg [15:0] dq_negedge;
always @(negedge clk) dq_negedge <= sdram_d;
```

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

La matriz queda como herramienta, porque es lo único que distingue este fallo:

```powershell
..\.venv\Scripts\python.exe sdram_dq_matrix.py --port COM3
```

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

### `HALT_AT` sólo servía una vez por encendido

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

### El contador de instrucciones contaba una de menos

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

## Uso y comprobaciones

Desde esta carpeta:

```powershell
..\.venv\Scripts\apio.exe test video_fullframe_tb.v
..\.venv\Scripts\apio.exe test video_frame_tb.v
..\.venv\Scripts\apio.exe test cpu_burst_system_tb.v
..\.venv\Scripts\apio.exe test write_combine_tb.v
..\.venv\Scripts\apio.exe test memory_fabric_tb.v
..\.venv\Scripts\apio.exe test video_burst_tb.v
..\.venv\Scripts\apio.exe test sdram_controller_128_tb.v
..\.venv\Scripts\apio.exe test instruction_buffer_tb.v
..\.venv\Scripts\apio.exe test perf_probe_tb.v
..\.venv\Scripts\apio.exe test cpu_video_tb.v
..\.venv\Scripts\apio.exe test video_registers_tb.v
..\.venv\Scripts\apio.exe test video_sdram_tb.v
..\.venv\Scripts\apio.exe test video_scanout_tb.v
..\.venv\Scripts\apio.exe test cpu_sdram_system_tb.v
..\.venv\Scripts\apio.exe test cpu_tb.v
..\.venv\Scripts\apio.exe test monitor_tb.v
..\.venv\Scripts\apio.exe test sdram_controller_tb.v
..\.venv\Scripts\apio.exe test sdram_system_adapter_tb.v
..\.venv\Scripts\apio.exe build
```

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

- `video_scanout_tb.v` (hito B) simula el cruce de dominios **sin memoria**.
- `video_sdram_tb.v` (hito C) simula la aritmética del framebuffer y el
  arbitraje **sin dominio de píxel**, contra el adaptador real y un modelo
  funcional de memoria con tres ciclos de latencia.

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

La suite completa de CPU contra esta placa:

```powershell
..\.venv\Scripts\python.exe ..\t.tests\run_tests.py --backend fpga-cpu --version bl8 --port COM3
```

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

### Medir el CPI

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

```powershell
..\.venv\Scripts\python.exe monitor.py perf --port COM3
```

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

```powershell
..\.venv\Scripts\python.exe ..\t.tests\run_tests.py --backend fpga-cpu `
    --measure medidas.md --port COM3 ..\t.tests\cases
```

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

### `MUL`, `MULFX` y `DIV`

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

## Notas de integración

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

## Pasos siguientes

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

### El número incómodo

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

De ahí salen tres caminos, de menos a más ambicioso:

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

### Lo que falta en la CPU

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
