jlopezr/mini-gpu/19.fpga-cpu-hdmi-ls/README.md

# MiniCPU con SDRAM, salida HDMI, memoria en ráfagas, accesos de 8 y 16 bits y llamadas

> **Backport de `R0` cableado a cero.** Esta carpeta recibio el cambio despues
> de cerrarse: `R0` vale siempre cero y descarta las escrituras, que es una
> regla de la MiniISA y no una extension opcional. Ver
> [`1.isa/isa.md`](../1.isa/isa.md) seccion 1.
>
> **Este monitor responde ahora 4.19.** Subio con el renumerado a juego de comandos (mayor) y numero de carpeta (menor), sin cambiar
> ni un byte del protocolo: es lo unico que el PC puede preguntar para saber que
> bitstream tiene delante, y un programa que use `R0` como registro general no
> para con error en el bitstream viejo, da otro resultado en silencio.
>
> El texto que sigue es anterior al backport. Los numeros de version que
> menciona mas abajo son historicos; los de hoy estan en
> [`resumen-prototipos.md`](../docs/resumen-prototipos.md).

Copia de [`../18.fpga-cpu-hdmi-bl8`](../18.fpga-cpu-hdmi-bl8) con nueve
instrucciones nuevas: `LOADB`, `LOADUB`, `STOREB`, `LOADH`, `LOADUH`, `STOREH`
y las llamadas `JAL`, `JALR` y `JR`. Todo lo demás —camino de ráfagas BL8,
vídeo, monitor— es la 18 tal cual, y el resto de este documento la describe sin
cambios.

## Lo nuevo respecto a la 18

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

El diseño entero, la tabla de opcodes y lo que costará la migración a v0.3 están
en [`docs/accesos-sub-palabra.md`](docs/accesos-sub-palabra.md). La verificación
es [`subword_ls_tb.v`](subword_ls_tb.v), sobre el sistema completo, y la clase
`SubwordAccessTest` de
[`../2.cpu-sim-func/test_minicpu_sim.py`](../2.cpu-sim-func/test_minicpu_sim.py)
sobre el simulador funcional. El demo que las justifica es
[`../t.tests/cases-cpu/demos/subword-demo/subword_demo.asm`](../t.tests/cases-cpu/demos/subword-demo/subword_demo.asm): un degradado RGB565
pixel a pixel, que con solo `STORE` de 32 bits costaría una lectura y una mezcla
por pixel.

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

### Frecuencia

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

Para repetirlo:

```powershell
..\tools\build-sweep.ps1 --prototype 19.fpga-cpu-hdmi-ls --seeds 1 2 3 4 5 6 7 8
```

---

Lo que sigue es el README de la 18, que describe el camino de ráfagas.

**Estado: en curso.** Lo que hay hecho y medido:

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

## Un framebuffer de verdad, sin placa

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

```powershell
..\.venv\Scripts\apio.exe test video_fullframe_tb.v
..\.venv\Scripts\python.exe ..\tools\frame-to-image.py frame_full.bin mirar.jpg
..\.venv\Scripts\python.exe ..\tools\frame-to-image.py frame_full.hex mirar.png --escala 2
```

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

Dos cosas difieren de la placa y conviene saberlas:

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

## La combinación de escrituras

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

**4,15×** sobre la 16, o **3,32× netos** contando el reloj más lento.

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

## El árbitro, y dos cosas que su banco corrigió

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

## Una trampa de `memory_fabric_4`, para la lista

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

## El búfer de instrucciones

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

### Coherencia, que aquí es barata

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

### Lo que cobra

Sobre el bucle interior real, 160 iteraciones:

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

### Lo que costó en la FPGA

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

---

# Documentación heredada de la 16

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

## Escalera de hitos

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

## Qué hay en el hito A

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

```text
clk_25mhz ─┬─ pll_cpu ──── 100 MHz ── CPU + monitor UART + SDRAM
           │
           └─ clock2_gen ─┬─ 125,0 MHz ── serializador TMDS
                          └─  25,0 MHz ── simple_480p → video_pattern → DVI → gpdi
```

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

### Modo de vídeo

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

### Lo que se ve

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

## Qué hay en el hito B

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

```text
   dominio de sistema, 100 MHz          dominio de pixel, 25 MHz
   ───────────────────────────          ────────────────────────

   video_line_source_pattern
        │  (en el hito C pasa a ser el lector de SDRAM)
        ▼
   escritura ─────► line_buffer ──────► lectura, cada pixel y
                     2 bancos            cada linea por duplicado
                                              │
                     handshake                ▼
        fill_start ◄──────────────── peticion de linea
        fill_done  ────────────────► banco listo
```

### Por qué doble banco y no una FIFO asíncrona

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

### Underflow

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

### El primer frame tras reset es basura

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

## Qué hay en el hito C

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

### El framebuffer

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

### Arbitraje: la prioridad tuvo que acotarse

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

```text
presupuesto     2 × 800 píxeles / 25 MHz = 64 µs = 6400 ciclos a 100 MHz
coste           SRC_W × V + (SRC_W / VIDEO_RUN) × C

con V = 10 ciclos por acceso de vídeo y C = 20 por transacción de CPU:

VIDEO_RUN = 1   →  9600 ciclos   no cabe
VIDEO_RUN = 4   →  4800 ciclos   cabe, 25 % de margen
```

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

### Cómo probarlo en la placa

```powershell
..\.venv\Scripts\python.exe ..\..\tools\make-framebuffer diagonal fb.bin
..\.venv\Scripts\python.exe monitor.py write-block 0x01000000 fb.bin --port COM3
```

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

## Qué hay en el hito D

Una ventana de registros y el doble framebuffer que gobiernan.

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

Tres cosas de v2 que muerden si se pasan por alto:

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

### El instante del intercambio

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

### Acceso desde la CPU y desde el monitor

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

Eso permite probar el swap **sin escribir ni una línea de programa**:

```powershell
..\.venv\Scripts\python.exe ..\..\tools\make-framebuffer bars fb0.bin
..\.venv\Scripts\python.exe ..\..\tools\make-framebuffer checker fb1.bin
..\.venv\Scripts\python.exe monitor.py write-block 0x01000000 fb0.bin --port COM3
..\.venv\Scripts\python.exe monitor.py write-block 0x01025800 fb1.bin --port COM3
# Tras el reset las dos bases valen CERO y el modo es PATTERN, asi que hay que
# ponerlo todo: el framebuffer es una decision del programa, no una reserva que
# el hardware imponga.
..\.venv\Scripts\python.exe monitor.py write-word 0x80200004 0x01000000 --port COM3  # FB_FRONT
..\.venv\Scripts\python.exe monitor.py write-word 0x80200008 0x01025800 --port COM3  # FB_BACK
..\.venv\Scripts\python.exe monitor.py write-word 0x80200000 2 --port COM3           # CTRL = SCANOUT
..\.venv\Scripts\python.exe monitor.py write-word 0x8020000C 1 --port COM3           # SWAP
```

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

### Los programas

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

### Los dos demos de Bresenham

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

```powershell
..\tools\run-board.ps1 --prototype 19 --program swap_demo_fast
..\tools\run-board.ps1 --prototype 19 --program tear_demo_fast
..\tools\run-board.ps1 --prototype 19 --program bresenham_lines
..\tools\run-board.ps1 --prototype 19 --program bresenham_circles
..\tools\run-board.ps1 --prototype 19 --program swap_demo --no-run     # cargar sin arrancar
..\tools\run-board.ps1 --prototype 19 --program tear_demo --port COM4
```

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

```powershell
..\tools\demo-no-cpu.ps1 --prototype 19 --pattern frame
```

#### Qué se ve, y por qué

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

#### El umbral de los 16,7 ms

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

#### La contabilidad que exige el doble buffer

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

#### Cómo se miden, y cómo se midieron mal

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

Hay dos trampas, y la primera se cayó en ella:

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

## Temporización: de 120 a 100 MHz

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

Lo que cuesta:

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

### El baudio: dos condiciones, no una

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

Entre 40 y 200, el único divisor que cumple ambas es **100 → 1 Mbaud**:

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

### El pulso del monitor, y por qué el vídeo lo hacía desaparecer

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

### Por qué se degradó, y por qué no es lo que parece

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

```text
instruction → decodificación de shift_kind → step_active → branch_taken → pc
8,34 ns totales: 1,9 de lógica y 4,9 de routing
```

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

### Se intentó recuperar los 120 MHz, y no salió

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

```text
antes    min 102,03   mediana 109,46   max 111,35
después  min 103,57   mediana 110,13   max 116,97
```

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

### Resultado a 100 MHz

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

## Lo que sólo dijo la placa

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

### La captura de DQ no tenía margen

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

```text
semilla 7 ->  (3,4) (3,5) (7,4) (7,5)
semilla 1 ->  (0,6) (3,4) (3,6) (4,6) (6,6) (7,4) (7,6)
```

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

```verilog
reg [15:0] dq_negedge;
always @(negedge clk) dq_negedge <= sdram_d;
```

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

La matriz queda como herramienta, porque es lo único que distingue este fallo:

```powershell
..\.venv\Scripts\python.exe sdram_dq_matrix.py --port COM3
```

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

### `HALT_AT` sólo servía una vez por encendido

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

### El contador de instrucciones contaba una de menos

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

## Uso y comprobaciones

Desde esta carpeta:

```powershell
..\.venv\Scripts\apio.exe test video_fullframe_tb.v
..\.venv\Scripts\apio.exe test video_frame_tb.v
..\.venv\Scripts\apio.exe test cpu_burst_system_tb.v
..\.venv\Scripts\apio.exe test write_combine_tb.v
..\.venv\Scripts\apio.exe test memory_fabric_tb.v
..\.venv\Scripts\apio.exe test video_burst_tb.v
..\.venv\Scripts\apio.exe test sdram_controller_128_tb.v
..\.venv\Scripts\apio.exe test instruction_buffer_tb.v
..\.venv\Scripts\apio.exe test perf_probe_tb.v
..\.venv\Scripts\apio.exe test cpu_video_tb.v
..\.venv\Scripts\apio.exe test video_registers_tb.v
..\.venv\Scripts\apio.exe test video_sdram_tb.v
..\.venv\Scripts\apio.exe test video_scanout_tb.v
..\.venv\Scripts\apio.exe test cpu_sdram_system_tb.v
..\.venv\Scripts\apio.exe test cpu_tb.v
..\.venv\Scripts\apio.exe test monitor_tb.v
..\.venv\Scripts\apio.exe test sdram_controller_tb.v
..\.venv\Scripts\apio.exe test sdram_system_adapter_tb.v
..\.venv\Scripts\apio.exe build
```

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

### Qué mapa de direcciones prueba cada banco

Hay **dos** decodificadores MMIO en esta carpeta, y hasta ahora no estaba dicho
en ninguna parte:

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

La suite completa de CPU contra esta placa:

```powershell
..\.venv\Scripts\python.exe ..\t.tests\run_tests.py --backend fpga-cpu --version bl8 --port COM3
```

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

### Medir el CPI

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

```powershell
..\.venv\Scripts\python.exe monitor.py perf --port COM3
```

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

```powershell
..\.venv\Scripts\python.exe ..\t.tests\run_tests.py --backend fpga-cpu `
    --measure medidas.md --port COM3 ..\t.tests\cases
```

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

### `MUL`, `MULFX` y `DIV`

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

## Notas de integración

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

## Pasos siguientes

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

### El número incómodo

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

De ahí salen tres caminos, de menos a más ambicioso:

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

### Lo que falta en la CPU

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
