jlopezr/mini-gpu/17.fpga-gpu-ram-v2/README.md

# MiniGPU con SDRAM v2: 8 warps × 8 lanes

> **Backport de `R0` cableado a cero.** Esta carpeta recibio el cambio despues
> de cerrarse: `R0` vale siempre cero y descarta las escrituras, que es una
> regla de la MiniISA y no una extension opcional. Ver
> [`1.isa/isa.md`](../1.isa/isa.md) seccion 1.
>
> El guardian NO esta en `gpu_register_file.v` sino en `gpu_sm.v`, que es la
> diferencia con la MiniCPU y conviene no perderla: aqui el banco es BRAM y no
> tiene reset, lo pone a cero un barrido de 256 ciclos en el estado `INIT`. Si
> el guardian estuviera dentro del banco bloquearia tambien ese barrido, `R0` no
> se inicializaria nunca y en simulacion se quedaria a `X`. Dejando el barrido
> fuera, lo escribe una vez y ninguna instruccion vuelve a tocarlo.
>
> **Este monitor responde ahora 3.17.** Subio con el renumerado a juego de comandos (mayor) y numero de carpeta (menor), sin cambiar ni
> un byte del protocolo. Los numeros de version que se mencionan mas abajo son
> historicos; los de hoy estan en [`resumen-prototipos.md`](../docs/resumen-prototipos.md).

Copia de `14.fpga-gpu-ram` dedicada a subir la frecuencia máxima sin cambiar la
funcionalidad. El registro de cambios, medidas y caminos críticos está en
`optimizacion.md`; `tools/build` resume el informe de temporización al final de
cada pasada y `tools/build-sweep` mide el fmax sobre varias semillas, porque una
sola tiene aquí un 17 % de dispersión. Todo lo demás de este documento describe
el diseño heredado.

A su vez copia del RTL de `12.fpga-gpu` con memoria unificada de **32 MiB de SDRAM**
en lugar de los ocho bancos EBR de 128 KiB. Destino: ULX3S-85F,
**25 MHz**, UART **250000 baudios**, monitor **3.17**.

Comparte todos los comandos con la 12 y con la 14: el mayor es igual porque el
juego de comandos es el mismo, y el menor las distingue porque **es el número de
carpeta**. Antes esos números se elegían a mano, y esta carpeta y la 14 llegaron
a responder el mismo — con lo que comprobar el bitstream contra la placa
equivocada pasaba en silencio.

Código, LOAD/STORE y monitor comparten `0x00000000–0x01ffffff`.
Las palabras son de 32 bits little-endian, alineadas a cuatro bytes;
la última comienza en `0x01fffffc`. El monitor conserva sus accesos por byte
y las ventanas de 12: depuración SIMT en `0x80000100` y configuración de warps
en `0x80001000`, la segunda página, exclusiva de la GPU (ver
[`docs/resumen-prototipos.md`](../docs/resumen-prototipos.md)).
Los registros de la GPU siguen usando EBR; se sustituye la RAM de código/datos.

## Integración

- `gpu_lane.v` y `gpu_register_file.v` proceden de 12; las etapas de control
  añadidas en `gpu_sm.v` se documentan en `optimizacion.md`.
- `gpu_lsu.v` conserva el contrato vectorial SM↔LSU y los ocho slots de warp.
  Atiende una lane cada vez y rota entre warps después de cada palabra.
  Alterna con el puerto auxiliar de fetch/monitor cuando ambos tienen trabajo.
  Las respuestas vectoriales retenidas no bloquean el fetch.
- `gpu_system.v` conecta el SM, la LSU y el monitor. El monitor accede a memoria
  cuando la GPU está detenida y ha drenado sus operaciones.
- `sdram_controller.v` procede de 10 (idéntico al de 9), parametrizado desde
  `top.v` a 25 MHz. Solo se explicitan extensiones de ancho de contadores para lint.
  Cada palabra requiere dos accesos BL1 de 16 bits; no hay caché ni coalescencia.
  Las máscaras DQM preservan los bytes no escritos por el monitor.
- `top.v` conecta los pines SDRAM usando el LPF de 12, que ya incluía su pinout.

Se esperan `init_done` y la aceptación real de cada petición. Una respuesta STORE
solo se publica después de recibir `done` para ambas mitades de todas las lanes.
Las direcciones desalineadas o fuera de rango generan errores por lane activa.
Una máscara vacía responde sin tocar memoria.

El reset del monitor reinicia la GPU y descarta sus transacciones pendientes,
pero **no reinicia el controlador SDRAM**: continúa el refresco y se conserva RAM.
Una transferencia ya aceptada puede terminar; las escrituras parciales no se
revierten. La siguiente petición espera la disponibilidad del controlador y
no recoge una finalización antigua. El reset global sí inicializa el controlador.

## Uso y comprobaciones

Desde la raíz del repositorio:

```powershell
tools\test.ps1 --prototype 17
tools\lint.ps1 --prototype 17
tools\build.ps1 --prototype 17 --label context-pc
.venv/Scripts/python.exe 17.fpga-gpu-ram-v2/monitor.py --help
```

Se conservan los ejemplos, el generador de fixtures y las 32 pruebas diferenciales
contra `11.gpu-sim-func`. Las pruebas de sistema y UART usan el controlador real
con un modelo funcional del bus SDRAM (`sim/sdram_model.vh`). La inicialización
se acorta solo en las pruebas de sistema; el top conserva los 200 µs del controlador.
El modelo verifica datos/direcciones/máscaras, pero no sustituye una prueba física
ni un modelo de temporización del fabricante. Véase `validation.md`.

## Builds con historial de timing

`tools/build` ejecuta **una sola vez** `apio build --verbose-pnr`. La opción
`--detailed-timing-report` está en `apio.ini`, así que no hace falta volver a
enrutar para obtener el detalle. Al terminar imprime fmax por reloj, los nets del
camino crítico y la utilización, y los archiva en `reports/<fecha>-<etiqueta>/`.

La consola muestra el progreso nativo de nextpnr: iteraciones de colocación y
tabla de arcos enrutados, reintentados y pendientes. Los pendientes pueden subir
durante los reintentos; no representan un porcentaje ni una ETA lineales.
La frecuencia tras la colocación es provisional: interesa la final, tras routing.

Cada ejecución conserva `reports/<fecha>-<etiqueta>/` (ignorado por Git):

- `build.log`: salida completa, progreso e histogramas de slack de nextpnr.
- `routing_progress.csv` y `slack_histograms.txt`: esas tablas extraídas del log.
  El histograma usa picosegundos y conserva las cuentas aproximadas del original.
- `hardware.pnr`: JSON con timing detallado por net y caminos críticos.
- `summary.json` y `summary.txt`: frecuencias, recursos, extremos y segmentos
  de los caminos críticos, con retardos de lógica y routing separados.
- `sources.zip` y `metadata.json`: copia de fuentes, hashes, comando y duración.
  Las fuentes se comprimen para que Apio no descubra los LPF archivados como
  constraints adicionales del proyecto.
- Netlist, configuración y bitstream, para conservar la implementación medida.

El historial sobrevive a `apio clean`. No se elimina automáticamente: cada build
conserva también el netlist y puede ocupar decenas de MB o más con timing detallado.
En Apio 1.5.1, **`--verbose-pnr` fuerza el routing incluso sin cambios**; el modo
normal sirve para medir una nueva pasada y ver su progreso. Para aprovechar la
caché sin pedir progreso ni histogramas en el log, utiliza:

```powershell
tools\build.ps1 --prototype 17 --label comprobacion --incremental
```

El JSON detallado sigue habilitado en ambos modos. Cambiar entre modo normal e
incremental también puede invalidar la acción de routing en SCons una vez,
porque cambia la línea de comando. Para archivar sin ejecutar nada, usa
`-ArchiveOnly`.

La comparación con el informe anterior es de una pasada; no sustituye un barrido
de semillas. El script devuelve error si falla Apio, falta el informe/reloj, o
algún dominio no alcanza su constraint (mínimo 25 MHz).

`tools\build.ps1 --prototype 17 --label anterior --archive-only` conserva resultados
existentes sin sintetizar. En este modo la copia de fuentes es la actual y no
demuestra qué fuentes produjeron el informe antiguo.
