jlopezr/mini-gpu/39.mini-gl/examples/low-poly-tie-fighter/README.md

# Low Poly Tie Fighter Star Wars

- Autor: **tolotedesign**
- Fuente: <https://sketchfab.com/3d-models/low-poly-tie-fighter-star-wars-4cf6cb507ba54533a50e608f2aadb47c>
- Licencia: [Creative Commons Attribution 4.0 (CC BY 4.0)](https://creativecommons.org/licenses/by/4.0/)

Modelo y textura sin cambios: `source/TIE.obj` y `textures/TIETexture.png`.

Cambios en la versión que usa el sketch ([`../tie_fighter_shape.h`](../tie_fighter_shape.h), generada con
[`tools/obj2shape.py`](../../tools/obj2shape.py)): caras triangulizadas, modelo centrado, escalado a
[-1, 1] y girado 180° en x, y la textura sustituida por un color plano por cara (el color medio de la
textura bajo la cara, reducido a unos pocos colores).
