jlopezr/mini-gpu/32.cpu-gpu-func-sim/examples/c/README.md

# Programas en C con CPU y GPU

A diferencia de `examples/asm` (`dma`, `race`, `render`), que está en
ensamblador, esto es C compilado con `mini-lcc`. Un mismo `.c` lleva el código de la CPU
(`main`) y los kernels de la GPU:

```c
#include "gpu.h"

void KERNEL(memset)(int *dst, int value, int n) {          /* GPU */
    int i, step = __gpu_nthreads;
    GRID_FOR(i, n, step)
        dst[i] = value;
}

int main(void) {                                           /* CPU */
    return GPU_RUN(memset, 4, buffer, 7, 4096);            /* kernel, warps, parámetros */
}
```

```text
python examples/c/build.py examples/c/dma/memset.c        # -> examples/c/_build/memset.bin
python cpu_gpu_sim.py examples/c/_build/memset.bin
```

## Dónde está cada cosa

`examples/asm` y `examples/c` tienen los mismos temas, y lo que existe en las dos tiene el mismo
nombre en la misma carpeta, para encontrar rápido la otra versión:

| Tema | Ensamblador | C |
|---|---|---|
| `dma` | `asm/dma/gpu_kernels.inc` (memset, memcpy, fill_rect, blit) | `c/dma/gpu_kernels.c` |
| `dma` | (dentro de `gpu_kernels.inc`) | `c/dma/memset.c`: programa completo con CPU y GPU |
| `race` | `asm/race/rotate.inc` (+ `rotate.asm`) | `c/race/rotate.c` (+ `rotate_body.h`) |
| `race` | `asm/race/cube.inc` + `race_host.inc` (+ `cube_board.asm`) | `c/race/cube.c` (+ `cube_body.h`): el demo entero, anfitrión incluido |
| `simt` | | `c/simt/diverge.c` (solo en C) |
| `render`, `launch.asm`, `race/{life,blur}` | sí | aún no |

En `c/system/` están las librerías del sistema (`gpu.h`, `gpu.c`, `mmio.h`); `build.py` pasa esa carpeta a
`mini-lcc -I`, así que los ejemplos solo escriben `#include "gpu.h"`. En `c/` quedan las herramientas
(`build.py`, `compare.py`, `compare_rotate.py`) y las salidas de la compilación van a `c/_build/`.

## Cómo funciona

- **`KERNEL(nombre)`** pone `__kernel_nombre` al nombre de la función. Es la marca que lee
  `mini-opt`: lcc no tiene atributos.
- **`mini-opt`** (pases `intrinsics` y `kernels`, ver `tools/README.md`) convierte esa función en
  el punto de entrada de una lane: carga los parámetros que el kernel lee desde el bloque de
  argumentos (`GETARG`) y sustituye el `JR R31` final por `EXIT`. Quita además el marco de
  pila que lcc monta para guardar y restaurar registros preservados, que a un kernel no le
  sirve (nadie recibe esos registros de vuelta). Solo si el kernel usa la pila de verdad (un
  array local, un derrame) fija la de su lane (`__gpu_stack`, 512 bytes por lane). Además cambia los desplazamientos con cantidad inmediata
  (`SHLI`) por los de registro, que son los únicos que tiene la GPU, y da un error si el
  kernel usa una instrucción que la GPU no ejecuta.
- **`GPU_RUN(nombre, warps, parámetros...)`** llama a `gpu_launch` (`system/gpu.c`), que rellena el
  bloque de argumentos y llama a `gpu_run` de `examples/asm/dma/gpu_runtime.inc` (el runtime de
  ensamblador de siempre). Lanza y espera.
- **El arranque** es `1.isa/runtime/crt0.s`; `build.py` compila con `mini-lcc --no-crt`.
- **La divergencia no se escribe:** un `if`, un `while` o un `break` cuyas lanes tomen
  caminos distintos necesita una región abierta con `SSY` (si no, `ERROR_SIMT`). Los pone
  el pase `ssy` de `mini-opt`: delante de cada salto que puede divergir, con el punto donde
  se juntan todos los caminos (su postdominador inmediato) como destino; en un bucle, una
  sola vez antes del bucle. Solo marca los saltos que dependen de `GETTID`/`GETLANE` (o de lo
  que se calcula bajo un salto así); `mini-opt --ssy-all` los marca todos.

## Los ejemplos

- **`dma/memset.c`**: el kernel más sencillo, sin divergencia (`n` es múltiplo de los hilos).
- **`simt/diverge.c`**: cinco kernels con divergencia: un bucle cuyas lanes salen en vueltas
  distintas, `if`/`else` por id de hilo, un `while` con un número de vueltas distinto por
  lane, una salida anticipada y dos bucles anidados con `break`. Se comprueban contra un
  modelo en Python (`CDivergenceTest`).
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
