jlopezr/mini-gpu/docs/synthesis-report.md

# Último informe de síntesis por prototipo

_La tabla la genera `generate-docs` a partir de `t.tests/backends/` y `reports/`; el texto exterior al bloque puede editarse a mano._

<!-- gendoc:begin synthesis-table
generator: synthesis-table
-->

| Prototype | Label | Clock | Achieved / Target (MHz) | Status |
|---|---|---|---|---|
| [`3.fpga`](../3.fpga) | build | $glbnet$clk_25mhz$TRELLIS_IO_IN | 295.42 / 25.00 | PASS |
| [`4.fpga-uart`](../4.fpga-uart) | build | $glbnet$clk | 166.94 / 120.00 | PASS |
| [`5.fpga-monitor`](../5.fpga-monitor) | build | $glbnet$clk | 139.76 / 120.00 | PASS |
| [`6.fpga-cpu`](../6.fpga-cpu) | auto-upload | $glbnet$clk | 112.46 / 100.00 | PASS |
| [`7.ulx3s_w9825g6kh_test`](../7.ulx3s_w9825g6kh_test) | build | $glbnet$sdram_clk$TRELLIS_IO_OUT | 136.05 / 25.00 | PASS |
| [`8.fpga-ram`](../8.fpga-ram) | build | $glbnet$sdram_clk$TRELLIS_IO_OUT | 118.99 / 25.00 | PASS |
| [`9.fpga-ram-param`](../9.fpga-ram-param) | seed4 | $glbnet$sdram_clk$TRELLIS_IO_OUT | 122.58 / 120.00 | PASS |
| [`10.fpga-cpu-ram`](../10.fpga-cpu-ram) | auto-upload | $glbnet$sdram_clk$TRELLIS_IO_OUT | 105.73 / 100.00 | PASS |
| [`12.fpga-gpu`](../12.fpga-gpu) | auto-upload | $glbnet$clk_25mhz$TRELLIS_IO_IN | 35.06 / 25.00 | PASS |
| [`13.hdmi`](../13.hdmi) | build | $glbnet$clk_pix | 110.95 / 74.00 | PASS |
| [`13.hdmi`](../13.hdmi) | build | $glbnet$clk_pix_5x | 425.89 / 370.10 | PASS |
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
