jlopezr/mini-gpu/0.mandelbrot/mandelbrot.png

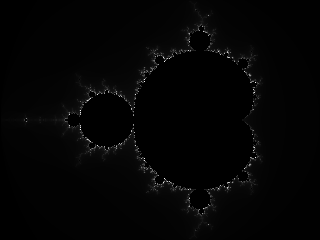
0.mandelbrot/mandelbrot.png
