jlopezr/mini-gpu/1.isa/minigpu2.png

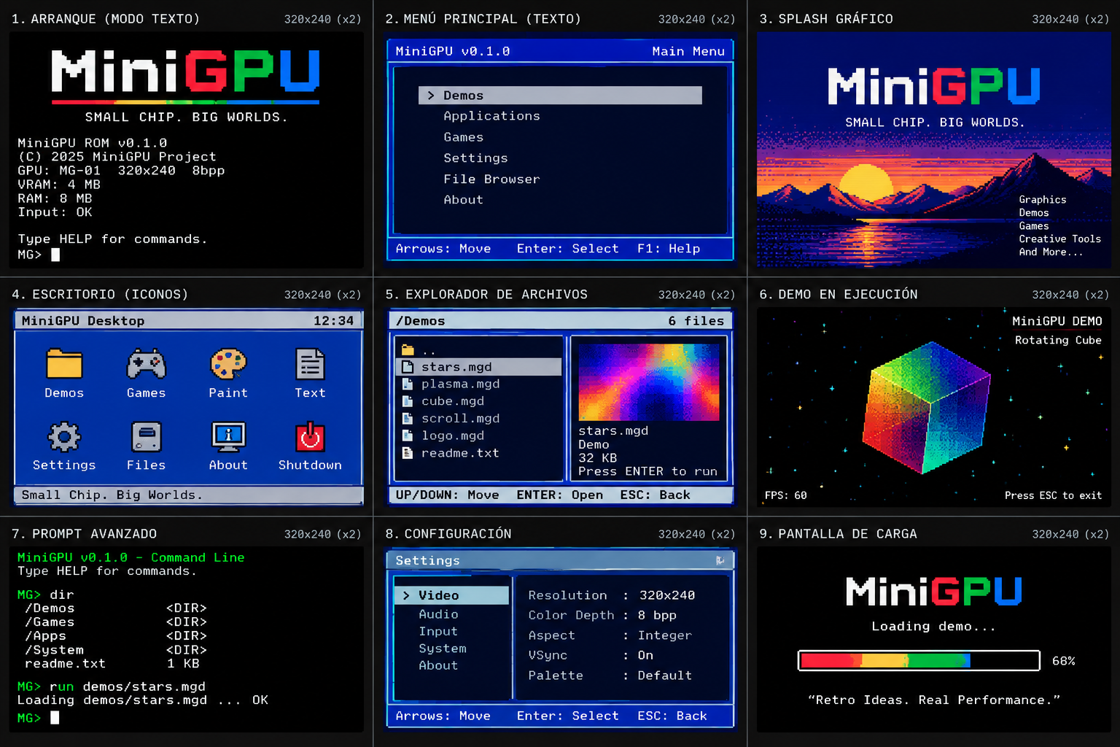
1.isa/minigpu2.png
