jlopezr/mini-gpu/1.isa/minigpu-small.png

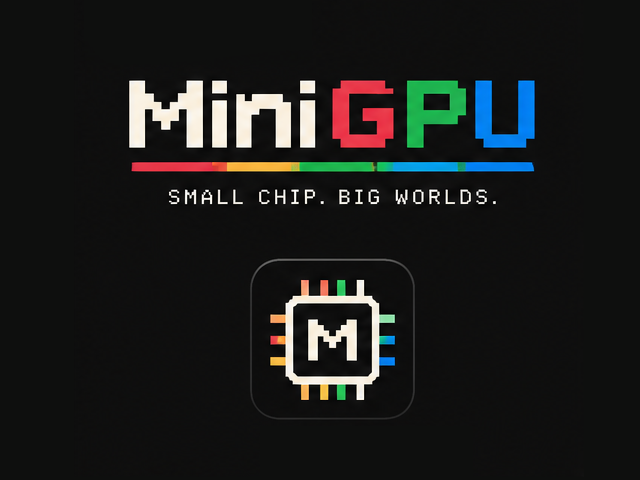
1.isa/minigpu-small.png
