jlopezr/mini-gpu/1.isa/minigpu-xsmall.png

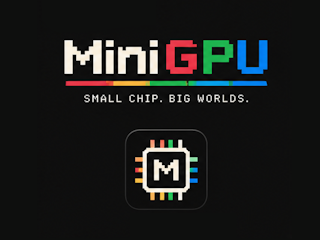
1.isa/minigpu-xsmall.png
