jlopezr/mini-gpu/37.fpga-cpu-gpu-mk2/fonts/previews/tui-tamzen.png

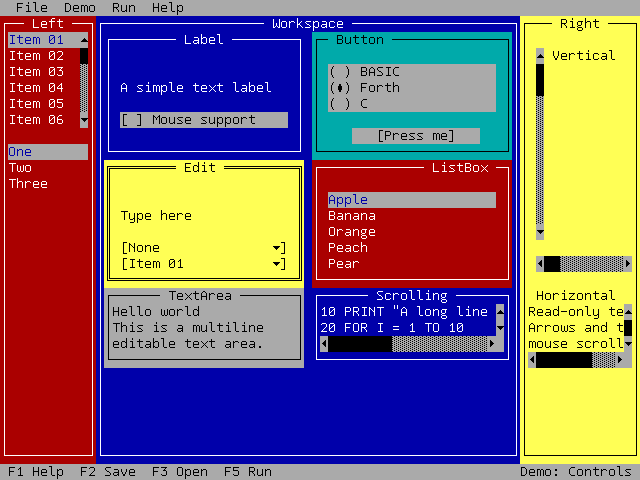
37.fpga-cpu-gpu-mk2/fonts/previews/tui-tamzen.png
