jlopezr/mini-gpu/39.mini-gl/examples/low-poly-tie-fighter/textures/TIETexture.png

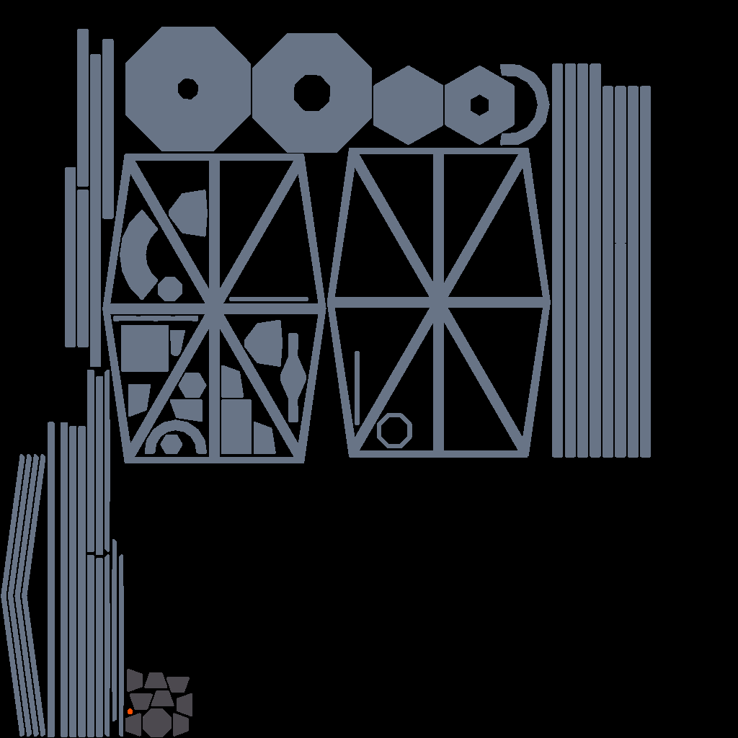
39.mini-gl/examples/low-poly-tie-fighter/textures/TIETexture.png
