jlopezr/mini-gpu/x.tests/README.md

# Tests de MiniCPU y MiniGPU

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

## Dónde viven los programas

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

### Convertir una demo en un caso

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

```powershell
# 1. escribe test.json con nombre, program, requires, max_instructions y "expect": {}
# 2. grábalo desde el simulador; --tighten deja max_instructions en el doble de
#    lo observado, y --frame guarda el frame tras run_until.swap
python record_case.py cases-cpu/demos/swap-smoke/test.json --tighten --frame
```

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

## MiniGPU: ejemplo completo de suma de vectores

Desde `x.tests`:

```powershell
python run_tests.py --backend sim-gpu
python run_tests.py cases-gpu/memory/vecsum/test.json --backend sim-gpu
python -m unittest unit.runner.test_gpu_runner -v
```

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

```json
{
  "warps": {
    "1": {
      "pc": "0x38",
      "active_mask": 0,
      "instructions_executed": 14,
      "registers": {
        "7": {"R1": 15, "R8": 115}
      }
    }
  }
}
```

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

## Ejecución

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

### Casos C generados por mini-lcc

El submodulo [`../y.lcc`](../y.lcc) contiene tests C del backend MiniISA de
lcc. Para aprovecharlos desde esta infraestructura sin duplicar manifiestos
derivados en git:

```powershell
python run-mini-lcc-tests.py --backend sim-cpu
```

El adaptador ejecuta `y.lcc/run-mini-tst.py`, reutiliza los `.bin`, `.json` y
dumps esperados generados en `y.lcc/mini-tst-out/`, y crea casos temporales en
`x.tests/generated/mini-lcc/`. Esa carpeta esta ignorada porque se regenera a
partir de los `.c`.

Para pasar opcionalmente el ensamblador generado por `mini-opt` antes de crear
los casos de `x.tests`:

```powershell
python run-mini-lcc-tests.py --backend sim-cpu --optimize
```

`--compare-optimizer` conserva y ensambla las dos formas, muestra el recuento
antes/después y hace que `x.tests` valide la optimizada. Si se combina con
`--simulate-lcc`, el runner propio de Mini-LCC simula y comprueba también ambas:

```powershell
python run-mini-lcc-tests.py --backend sim-cpu --compare-optimizer --simulate-lcc
```

Por defecto no se invoca el optimizador. Tanto el `.s` original como el
`.opt.s` se conservan bajo `y.lcc/mini-tst-out/`. Fuera de un checkout de
Mini-GPU se puede indicar el ejecutable con `--mini-opt RUTA`.

Por defecto se omiten los `xfail` conocidos de `mini-lcc` que generan
manifiesto, ya que `x.tests` no tiene semantica de fallo esperado. Para
investigarlos como fallos normales:

```powershell
python run-mini-lcc-tests.py --backend sim-cpu --include-xfail
```

Desde `x.tests`. `--port` es opcional: sin él, detecta el primer adaptador
FTDI conectado; solo hace falta si hay varios o para forzar uno en concreto
(por ejemplo, en Windows con "COM3"):

```powershell
# 1. CPU sobre el simulador funcional
python run_tests.py --backend sim-cpu

# 2. CPU sobre FPGA, versión EBR
python run_tests.py --backend fpga-cpu --version ebr --port COM3

# 3. CPU sobre FPGA, versión SDRAM
python run_tests.py --backend fpga-cpu --version sdram --port COM3

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

# 5. GPU sobre el simulador funcional
python run_tests.py --backend sim-gpu

# 6. GPU sobre FPGA, versión BRAM
python run_tests.py --backend fpga-gpu --version bram --port COM3
```

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

Qué necesita y qué ejecuta cada una:

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

**`sdram` no tiene `mul_div`, y esa capacidad es distinta de las demás.**
`10.fpga-cpu-ram` no implementa `MUL`, `MULFX` ni `DIV`, que son instrucciones
**base** de la MiniISA, no extensiones. Salió al correr el diferencial contra esa
placa por primera vez. Se probó el port —copiar el `cpu.v` de la 6, que resultó
ser un superconjunto estricto— y funciona, pero deja el diseño en una de ocho
semillas al +2,4 %; el detalle está en
[`10.fpga-cpu-ram/cpu.v`](../10.fpga-cpu-ram/cpu.v).

`mul_div` es por tanto la única capacidad que significa «a este backend le
**falta** algo de la base» en vez de «tiene algo **de más**». Conviene no leer su
`SKIP` como «aquí no hace falta»: ahí falta algo que la ISA exige. El día que la
10 implemente las tres, la capacidad desaparece entera en lugar de extenderse a
más backends.

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

```powershell
.\.venv\Scripts\python.exe .\x.tests\run_tests.py --backend fpga-gpu --version bram --port COM3 --yes --durations
```

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

```powershell
.\.venv\Scripts\apio.exe upload -p .\12.fpga-gpu
if ($LASTEXITCODE -ne 0) { throw "Falló la carga" }
.\.venv\Scripts\python.exe .\x.tests\run_tests.py --backend fpga-gpu --version bram --port COM3 --no-upload --durations
```

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

```powershell
python run_tests.py --backend both --version fpga-cpu=sdram --port COM3
```

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

También se puede ejecutar uno o varios casos concretos:

```powershell
python run_tests.py cases-cpu/basics/smoke/test.json --backend sim-cpu
```

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

```powershell
python run_tests.py cases-gpu/memory/vecsum/test.json --backend sim-gpu `
    --trace --trace-limit 100 --trace-file ejecucion.log
```

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

```powershell
python run_tests.py --backend sim-gpu --durations 5
```

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

```powershell
python run_tests.py --backend both `
    --version sim-cpu=current --version fpga-cpu=sdram --port COM3
```

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

## Placa y bitstream

Los backends de FPGA comprueban la versión física mediante `GET_VERSION`:

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

Lo que sí conviene saber para leer esas respuestas:

```text
mayor   = juego de comandos     3  base + READ_WORD/WRITE_WORD
                                4  lo anterior + SEND_BYTES/RECV_BYTES
menor   = número de carpeta     3.6, 3.10, 3.12, 3.14, 3.16, 3.17,
                                3.18, 3.22, 4.19, 4.21
```

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

```powershell
python run_tests.py --backend fpga-cpu --port COM3              # pregunta
python run_tests.py --backend fpga-cpu --port COM3 --yes        # carga sin preguntar
python run_tests.py --backend fpga-cpu --port COM3 --no-upload  # nunca carga
```

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

`RESET_CPU` permite ejecutar casos consecutivos sin reconfigurar la placa ni
borrar sus memorias.

## Formato

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

```json
{
  "architecture": "cpu",
  "name": "ejemplo",
  "program": "program.asm",
  "max_instructions": 1000,
  "timeout_seconds": 2.0,
  "initial_memory": [
    {
      "address": "0x00100300",
      "file": "input/data.bin"
    }
  ],
  "expect": {
    "halted": true,
    "error": false,
    "error_code": "0x00",
    "pc": "0x00000020",
    "registers": {
      "R1": "0x12345678"
    },
    "memory_dumps": [
      {
        "address": "0x00100400",
        "file": "expected/result.bin"
      }
    ]
  }
}
```

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

```json
"build": {"command": ["make", "case"]}
```

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

## Opciones del simulador

Un caso GPU puede fijar parámetros de construcción del simulador con la clave
opcional `simulator_options`:

```json
{
  "architecture": "gpu",
  "name": "ssy-path-overflow-depth4",
  "program": "program.asm",
  "warp_config": "warps.json",
  "simulator_options": {
    "simt_region_depth": 8,
    "simt_path_depth": 4
  },
  "expect": {}
}
```

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

## Direcciones de datos

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

## Resultado diferencial

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

## Medir: `--measure`

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

```bash
# Todas las versiones de placa, más el simulador
python run_tests.py --backend fpga-cpu --measure medidas.md --port COM3 cases

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

# Sin placa: solo cuenta instrucciones, que es la mitad de la tabla
python run_tests.py --backend sim-cpu --version sim --measure cases
```

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

## Estado de error

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

## Programas de integración

`cases-cpu/programs` contiene cargas de trabajo pequeñas pero completas:

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

## Casos GPU y diagnóstico de fallos

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

El campo opcional `expect.fault` comprueba el diagnóstico completo:

```json
"fault": {
  "pc": "0x1C",
  "warp_id": 0,
  "core_id": 3,
  "address": "0x02000000"
}
```

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

## Casos para el diferencial de RTL

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

```json
"rtl": { "differential": true, "warp_config": "../../rtl-8-warps.json", "exclude": ["12"] }
```

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

Qué sí y qué no marcar:

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

## Arquitectura y compatibilidad

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

Los nombres llevan la plataforma delante (`sim-` o `fpga-`) y detrás lo que se
ejecuta:

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

## Capacidades

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

```json
"requires": ["frame_capture"]
```

| Capacidad | Qué significa | Quién la tiene |
|---|---|---|
| `atomic_warp_faults` | Un fallo de warp no deja efectos parciales | solo el simulador GPU |
| `video` | Registros en `0x80000000` y un framebuffer que se muestra | `sim-cpu`, `sim-gpu`, `hdmi`, `bl8`, `subword`, `alu`, `console`, y las GPU `22` y `29` |
| `frame_capture` | Parar tras N intercambios y capturar el frame: hace falta `SWAP_COUNT` (se detecta de `video_registers.v` o `gpu_video_regs.v`), no `HALT_AT` | los mismos que `video` |
| `halt_on_swap` | `HALT_AT` cuenta intercambios: el arnés lo arma en vez de sondear. Implica `frame_capture`; un caso no lo pide, lo elige el backend | todas las que tienen vídeo: las CPU (`hdmi`, `bl8`, `subword`, `alu`, `console`) y las GPU 22 y 29 |
| `subword_memory` | `LOADB`/`LOADUB`/`STOREB`/`LOADH`/`LOADUH`/`STOREH`, opcodes `0x18–0x1D`. En una CPU se detecta en `cpu.v`; en una GPU, en `gpu_sm.v`, que es quien despacha la memoria | `sim-cpu`, `subword`, `alu`, `sim-gpu`, `sim-gpu-cycle` y la GPU 29 (`smpipe`) |
| `gpu_ids` | La familia `GETID` (`GETLANE`, `GETWARP`, `GETLWARP`, `GETARG`, opcode `0x30` con `type` 1 a 4) y los campos `logical_warp_id` y `arg` de cada warp en `warps.json` (`LOGICAL_WARP_ID[n]` y `WARP_ARG[n]`, `mmio.md` §14.2). Un caso que los use en `warps.json` **tiene que declararla**: el runner lo rechaza al cargarlo. Se detecta en `gpu_lane.v`; una GPU sin ella solo tiene `GETTID` y un `type` ≠ 0 para con `0x05`, así que sus casos se omiten allí | `sim-gpu`, `sim-gpu-cycle` y la GPU 29 (`smpipe`) |
| `calls` | `JAL`/`JALR`/`JR`, opcodes `0x2C–0x2E` | `sim-cpu`, `subword`, `alu` |
| `serial` | Puerto serie en `0x80000200`, y los comandos que lo alimentan | `sim-cpu`, `subword`, `alu` |
| `input` | INPUT, teclado y ratón (`mmio.md` §25, `0x80600000`). El caso lo alimenta con `"input": [líneas de guion]` (`tools/input_script.py`; `@N`/`+N` en instrucciones completadas), que se comprueba al cargar el caso. Es **que el arnés sabe alimentarlo**, no que el RTL lo tenga (eso es `input_device`): la placa recibe eventos del monitor, no tiempo en instrucciones, así que solo lo declaran los simuladores y en la placa el caso se omite | `sim-cpu`, `sim-gpu`, `sim-gpu-cycle` |
| `input_device` | El RTL tiene el bloque INPUT (`input_registers.v`), alimentado por `INPUT_EVENTS`/`INPUT_PRESENCE` del monitor. Da el bit INPUT de `DEVICES` (`mmio.md` §5.4). **No implica `input`**: tener el dispositivo no significa poder reproducir un guion con tiempo | `console` |
| `shift_immediate` | `SHLI`/`SHRI`/`SARI`: bit 10 de `SHL`/`SHR`/`SAR` | `sim-cpu`, `alu` |
| `alu_extended` | `MULHI`/`DIVU`/`REM`/`REMU`, opcodes `0x0B` y `0x0D–0x0F` | `sim-cpu`, `alu` |
| `mul_div` | `MUL`/`MULFX`/`DIV`: **base de la ISA**, no una extensión | todos menos `sdram` |
| `perf_counters` | `CYCLES` y `RETIRED` de CPU PERFORMANCE (`0x81010000`): dan el CPI de `--measure` | `hdmi`, `bl8`, `subword`, `alu`, `console` |
| `perf_stalls` | Además las ranuras 2 a 7 (`IMEM_HITS`, `IMEM_MISSES`, `MEM_TX`, `STALL_MEM`, `STALL_FETCH`, `STALL_MMIO`): `--measure` reparte los ciclos entre cálculo, búsqueda, datos y MMIO | `console` |

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

### `mul_div` va al revés que todas las demás

`alu_extended` **implica** `mul_div`, y es una implicación física: `MULHI` sale
del mismo multiplicador que `MUL`, y `REM` del mismo divisor que `DIV`. Un
backend con `MULHI` pero sin `MUL` no puede existir, así que `alu` no la declara
—le llega sola—.

Y es la única capacidad que **encogerá** en vez de crecer. Las demás se extienden
según los bitstreams las van implementando; ésta desaparece entera el día que la
10 tenga multiplicador, porque ese día ya no habrá nada que distinguir.

### Dos cosas que NO son capacidades, por motivos opuestos

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

### El simulador tiene vídeo, pero no tiene tiempo

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

`frame_capture` implica `video`, así que un backend solo declara lo que de
verdad implementa.

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

```text
SKIP video-band [sim-cpu]: el simulador no tiene frame_capture:
    no hay barrido ni framebuffer, use --backend fpga-cpu --version bl8
```

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

### Casos de vídeo

Tres piezas más, y las tres solo se admiten con la capacidad declarada:

```json
{
  "requires": ["frame_capture"],
  "run_until": { "swap": 4 },
  "expect": {
    "video": { "underflow": false },
    "frame": { "file": "expected/frame.bin" }
  }
}
```

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

**Cómo se para en placa.** Hay dos caminos, según lo que declare el RTL:

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
