jlopezr/mini-gpu/x.tests/cases-cpu/programs/README.md

# Programas completos

Programas con bucles y memoria, útiles como prueba de integración del conjunto
ensamblador + CPU + memoria.

| Caso | Qué valida |
|---|---|
| [array-sum](array-sum/) | Recorrido de un array con acumulador |
| [fibonacci](fibonacci/) | Bucle con dependencia entre iteraciones |
| [memory-copy](memory-copy/) | `LOAD`/`STORE` en bucle |
| [shift-multiply](shift-multiply/) | Multiplicación mediante desplazamientos |
| [xorshift](xorshift/) | PRNG xorshift32: `XOR` + `SHL`/`SHR` en bucle |
