jlopezr/mini-gpu/t.tests/cases-shared/shift-immediate/shli-shri-sari/README.md

# SHLI, SHRI y SARI, igual en CPU y GPU

Seis valores de borde por seis cantidades (0, 1, 5, 15, 16 y 31) para cada uno de los tres desplazamientos inmediatos. `expected.hex` sale de aritmética de Python.
