jlopezr/mini-gpu/t.tests/cases-shared/alu-extended/divu-by-zero/README.md

# DIVU entre cero, igual en CPU y GPU

La ISA da `ERROR_DIVISION_BY_ZERO` (0x04) en las cuatro instrucciones de division.
