jlopezr/mini-gpu/t.tests/cases-shared/compare/slt-sltu/README.md

# SLT y SLTU, igual en CPU y GPU

Dieciseis pares de operandos de borde (signo, minimo, maximo, iguales). El programa deja `SLT` y `SLTU` de cada par en RAM, y `expected.hex` sale de aritmetica de Python.
