jlopezr/mini-gpu/x.tests/cases-shared/alu-extended/mulhi-div-rem/README.md

# MULHI, DIV, DIVU, REM y REMU, igual en CPU y GPU

Quince pares de borde, con `-2^31 / -1`, divisores por encima de 2^31 y operandos negativos. El resto lleva el signo del dividendo. `expected.hex` sale de aritmetica de Python.
