jlopezr/mini-gpu/(commit log)

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2026-09-10 monitor warp-status & registers
    [gpu_uart_tb.v, monitor.py, monitor.v]
2026-09-10 Using localparam constants instead of literals for errors/exceptions
    [gpu_sm.v]
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2026-09-12 step C: scanout leyendo el framebuffer de SDRAM
    El scanout lee un framebuffer RGB565 de 320x240 en 0x01000000 y lo saca
    escalado 2x a 640x480 por HDMI, compartiendo la SDRAM con la CPU y el monitor.
    Un pixel RGB565 es exactamente un acceso de 16 bits, asi que el lector no tiene
    que componer palabras.
    El video es el tercer cliente del adaptador y va primero, pero la prioridad
    tuvo que acotarse: el lector vuelve a subir video_req un ciclo despues de cada
    concesion, asi que prioridad absoluta congelaba la CPU y el monitor los ~27 us
    de cada linea. Ahora cede un turno cada VIDEO_RUN=4 accesos si hay alguien
    esperando; el dimensionado sale del presupuesto de ancho de banda por par de
    lineas de p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
2026-09-12 cpu: sacar la decodificacion de opcode del cono de datos del PC
    Las cuatro paradas por error hacian `pc <= pc - 4` dentro del case gigante
    sobre el opcode, lo que metia el decodificador entero en el cono de datos del
    PC: ocho niveles de LUT desde `instruction` hasta `pc`, y era el camino critico
    del diseno. Ahora marcan `pc_restore` y la resta se hace al entrar en
    STATE_HALTED, que es adonde van las cuatro sin excepcion.
    El PC sigue apuntando a la instruccion culpable: `halted` se levanta en el
    mismo ciclo que la marca y el monitor no puede leerlo hasta mucho despues; y si
    llega un run_request en ese mismo ciclo, correccion y salida ocurren en el
    mismo flanco, asi que el fetch siguiente ya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
    [cpu.v]
2026-09-12 step D: doble framebuffer con swap sincronizado y registros en 0x80000000
    Ventana de registros de video accesible por la CPU (palabras) y por el monitor
    (bytes): FB_FRONT, FB_BACK, SWAP y STATUS con underflow y contador de frames.
    Con ella, doble buffer e intercambio sin desgarro.
    El intercambio ocurre en la primera peticion de linea de cada frame, que es el
    unico instante en el que no queda nada del frame anterior por leer ni se ha
    leido nada del siguiente. El scanout la marca con `fill_first`, asi que el swap
    viaja dentro de la peticion que ya cruza de dominio: no hace falta cruzar un
    VBlank aparte ni razonar sobre que cruce llega antes.
    `fb_base` es combinacional respecto a esa decision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
    [cpu_sdram_system_tb.v, cpu_video_tb.v, monitor.py, sdram_system_adapter.v, sdram_system_adapter_tb.v, top.v, video_line_source_sdram.v]
2026-09-12 arreglar el enlace del monitor: baudio a 1 Mbaud y enganche del pulso
    Dos fallos que solo aparecen en la placa, encontrados al probar los hitos C y D.
    1. Baudio. El divisor de UART tiene que ser multiplo de cuatro, porque uart.v
    alimenta la recepcion con DIVISOR/4 y la division es entera. El aviso estaba
    en el propio codigo y aun asi el hito C dejo un divisor de 50: la recepcion
    quedo a 12 en vez de 12,5, un 4,2 % rapida, casi medio bit de deriva en una
    trama de diez. En la placa se veia como un enlace que funcionaba la mitad de
    las veces. El divisor tiene ademas que dar un baudio que el FTDI sepa generar
    exacto, y entre 40 y 200 el unico que cumple las dos condiciones es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
    [monitor.py, monitor.v, monitor_tb.v, sdram_system_adapter.v, top.v, uart.v, video_sdram_tb.v]
2026-09-12 arreglar la ruta de los casos de Mandelbrot en test_simt_regions.py
    Los siete subtests de Mandelbrot fallaban con FileNotFoundError. Los casos de
    programa se reagruparon en su dia bajo x.cpu-tests/cases-gpu/programs/ y esta
    ruta se quedo apuntando al sitio anterior.
    No lo detecto nadie porque estos bancos se ejecutan a mano; el fichero cambio de
    sitio y la referencia se quedo atras, sin que nada avisara. Con el arreglo pasan
    los cuatro bancos de 11.gpu-sim-func.
2026-09-12 mover los programas a examples/ y dejar de versionar sus binarios
    15.fpga-cpu-hdmi tenia seis .asm y siete .bin sueltos en la raiz, mezclados con
    las fuentes Verilog. 11.gpu-sim-func, tres y cinco. Pasan a examples/, que es la
    convencion que ya usaban 12.fpga-gpu, 14.fpga-gpu-ram y 16.fpga-gpu-ram-v2.
    El motivo no es el orden, es que el .gitignore de 15 ignoraba los binarios POR
    NOMBRE:
    fb_*.bin
    swap_*.bin
    Al aparecer tear_demo.asm y tear_demo_fast.asm, sus binarios no encajaban en
    ningun patron y entraron en el repositorio sin que nada avisara. Un fichero que
    se cuela en git no se queja. Ahora se ignora por extension dentro de examples/,
    que no tiene ese modo de fallo, con una ex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
2026-09-12 quitar los scripts duplicados y documentar los programas de 11
    demo2.ps1 y demo3.ps1 hacian exactamente lo mismo que `run-demo.ps1 swap_demo` y
    `run-demo.ps1 swap_demo_fast`, pero sin resetear la CPU antes de escribir ni
    mirar el estado al terminar. Se borran.
    demo1.ps1 no estaba duplicado, porque carga un framebuffer y run-demo.ps1 no
    cubre eso. Pasa a examples/demo-no-cpu.ps1, con un nombre que dice lo que hace y
    que es lo que lo hace util: pinta una imagen sin ejecutar ni una instruccion, asi
    que si aparece, el scanout, la SDRAM, los registros de video y la cadena DVI
    funcionan y el problema esta en el programa o en la CPU. De paso acepta el patron
    y el puerto por parametro en vez de lle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
2026-09-12 reformatear el README de 11: deshacer el doble interlineado
    Tenia cada salto de linea duplicado, 181 lineas en blanco para 156 con
    contenido. En Markdown eso no es solo feo: un blanco entre dos lineas del mismo
    parrafo las convierte en dos parrafos, asi que el texto se renderizaba troceado
    en bloques de una linea.
    La regla no era "quitar blancos de mas". Con el interlineado duplicado, una
    tirada de UN blanco es un salto dentro del parrafo y una de TRES es la
    separacion entre parrafos; colapsarlo todo a uno habria borrado esa distincion.
    Se unen los primeros y se deja uno en los segundos.
    La seccion "Los programas de examples/" se escribio despues y ya estaba bien
    espaciada, asi que se copi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
2026-09-12 reordenar la documentacion: 15.isa-v2, docs/ por carpeta y verificador de enlaces
    Tres cambios que van juntos porque comparten los mismos enlaces.
    1. El diseno de la GPU sale de 16.fpga-cpu-hdmi/docs/ y pasa a 15.isa-v2.
    Esos tres documentos no eran documentacion de la carpeta que los alojaba:
    describen la GPU entera —arquitectura SIMT, modos de video, formatos de
    framebuffer, pipeline 3D— y su plan por fases, cuya fase 0 es "Optimizar
    LSU", el punto 1 del TODO.md. Son anteriores al trabajo de HDMI, que no es
    mas que una de sus fases. Estar dentro de 16 sugeria lo contrario.
    Con eso, 15.fpga-cpu-hdmi pasa a 16 y 16.fpga-gpu-ram-v2 a 17, que es lo que
    coloca el dis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
2026-09-12 18.fpga-cpu-hdmi-bl8: medida, bufer de instrucciones y lector de video BL8
    Copia de la 16 con los tres primeros pasos del plan de rafagas.
    Paso 0, medir antes de escribir RTL. perf_probe_tb.v barre la latencia del
    modelo de memoria sobre el bucle interior real de swap_demo_fast y separa las
    partidas: de los ~26 ciclos por acceso de 16 bits, 8 son comandos de SDRAM
    --lo unico que BL8 ataca-- y 6,5 son handshake y CPU. El scanout se lleva
    otro 35 %. Eso reordena el plan: el bufer de instrucciones es lo mas grande y
    no necesita BL8.
    Paso 1, instruction_buffer.v: cuatro lineas de 16 bytes, mapeo directo,
    intercalado en top.v con el mismo contrato por los dos lados. 2,65x medido
    contra un techo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
    [clock2_gen.v, cpu.v, cpu_sdram_system_tb.v, cpu_tb.v, cpu_video_tb.v, dvi_generator.sv, instruction_buffer.v]
2026-09-12 18: anotar la trampa del handshake de memory_fabric_4
    En el arbitro, req_ready depende combinacionalmente de req_valid: la concesion
    mira el valid del propio puerto. Un cliente que espere ready antes de levantar
    valid se cuelga para siempre. Costo una simulacion colgada, y va a la lista de
    trampas junto al pulso de un ciclo del monitor.
2026-09-12 18: integrar el camino de rafagas entero en top.v
    El camino de memoria pasa de un bloque de 16 bits a cuatro clientes sobre un bus
    de 128:
    p0 cpu_dmem_adapter dmem 32 bits + MMIO
    sdram_controller_128 instruction_buffer imem 32 bits (p1)
    ^ p2 video_line_source_burst (nativo, urgent)
    memory_fabric_4 p3 monitor_mem_adapter_128 monitor, byte a byte
    Modulos nuevos: cpu_dmem_adapter, monitor_mem_adapter_128 y mmio_mux. El ultimo
    hace falta porque la ventana de registros de video tiene un puerto y ahora dos
    clientes; en la 16 los serializaba el arbitro unico.
    El bufer de instrucciones pasa a pedir la linea en UNA rafaga en vez de c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
2026-09-12 18: banco de pruebas de memory_fabric_4
    El arbitro llevaba desde la integracion en el camino de memoria de top.v sin
    pruebas propias. Ahora las tiene, y han corregido dos suposiciones.
    LA PRIMERA VERSION DEL CASO DE ROUND-ROBIN NO PROBABA NADA. Con cuatro clientes
    que piden una vez y callan, el orden sale 0,1,2,3 aunque el puntero no avance
    jamas: cada uno baja su valid al ser servido y el else-if en cascada hace el
    resto. Se comprobo sustituyendo el avance por `rr_ptr <= MASTER_0`, y el banco
    seguia en verde. De ahi sale el caso de equidad, con los cuatro clientes
    martilleando sin dejar huecos: con el arbitro bueno da 12/12/12/12 y con el
    puntero clavado 21/21/3/3, y falla como debe.
    `urg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
    [memory_fabric_4.v, memory_fabric_tb.v]
2026-09-12 18: combinacion de escrituras, el paso 4 del plan
    cpu_dmem_adapter guarda una linea de 16 bytes con su mascara. Mientras la CPU
    siga escribiendo dentro de esa linea las escrituras se funden y se contestan en
    un ciclo, sin tocar la memoria; al salirse, se vuelca de una rafaga. Cuatro
    STORE con +4 caben en una linea, que es exactamente el bucle interior.
    la 16 145,9 ciclos/palabra
    camino de rafagas 49,7 163 rafagas
    con combinacion 35,2 42 rafagas -> 4,15x
    Netos, con el reloj a 80 MHz, 3,32x.
    No es una cache, y el motivo no es el coste: el subsistema de video lee el
    framebuffer de la SDRAM por su cuenta, asi que una escritura dif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
2026-09-12 18: instrumentacion para probar la parte grafica
    Cuatro piezas, y la mitad de la lista ya existia (STATUS ya daba underflow y
    contador de frames de video).
    REGISTROS. La ventana de video pasa de 16 a 32 bytes y gana dos:
    0x80000010 SWAP_COUNT R intercambios completados
    0x80000014 HALT_AT RW parar la CPU al completar el intercambio N
    y STATUS deja de ser de solo lectura: escribir un uno en el bit 0 borra el
    underflow.
    El borrado desbloquea todo lo demas. Antes el bit solo se iba recargando el
    bitstream, asi que el primer caso que fallara contaminaba la sesion entera y no
    se podia tener una suite. No es una linea: el latch vive en el dominio de
    pixel, asi que el pulso cruza c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
    [cpu_burst_system_tb.v, cpu_dmem_adapter.v, top.v, video_frame_tb.v, video_registers.v, video_registers_tb.v, video_scanout.v]
2026-09-12 x.cpu-tests: capacidades, y el primer caso de video
    El mecanismo YA EXISTIA: el esquema tenia `requires` y cada backend publica
    `incompatibility(case, version)`. Lo que habia era un solo valor,
    `atomic_warp_faults`, y una linea que lo restringia a casos GPU. Se extiende en
    vez de inventar otro.
    DOS CAPACIDADES Y NO UNA, porque la diferencia es real:
    video hay scanout leyendo un framebuffer de memoria y ventana de
    registros en 0x80000000. La tienen la 16 y la 18.
    frame_capture ademas HALT_AT, SWAP_COUNT y borrado de underflow, o sea se
    puede parar en un intercambio concreto y leer el frame de
    forma repetible. Solo la 18.
    Con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
2026-09-12 x.cpu-tests: dos casos de video mas, y el cuadrado que rebota
    Tres casos en cases/video, cada uno cubriendo algo que los otros no.
    REGISTERS. No dibuja nada: comprueba la ventana de registros desde un programa.
    Que las bases arrancan donde dice el hardware, que escribir FB_BACK funciona y
    se alinea a cuatro bytes, y que al aplicarse un SWAP las dos bases se
    INTERCAMBIAN en vez de copiarse una sobre la otra.
    Usa solo los cuatro registros que existen desde la 16, asi que corre alli
    tambien. Es el caso que justifica que `video` y `frame_capture` sean capacidades
    distintas: hoy es el unico que pide solo la primera.
    Lo que NO comprueba a proposito: que SWAP quede pendiente justo despues de
    ped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
2026-09-12 18: un framebuffer de 320x240 de verdad, sin placa
    video_fullframe_tb.v dibuja un framebuffer a resolucion COMPLETA con la CPU
    real ejecutando un programa real desde la SDRAM, sobre el camino de memoria
    entero. 35 segundos de reloj de pared, 2,5 millones de ciclos de CPU
    simulados, 76 800 pixeles comprobados.
    Es la prueba mas cercana a la placa que se puede hacer sin placa, y ejercita
    justo lo que un simulador funcional NO podria: el bufer de instrucciones, la
    combinacion de escrituras con su vaciado forzado al escribir SWAP, el
    controlador BL8, el arbitro con dos clientes compitiendo, y HALT_AT dentro del
    sistema completo en vez de aislado. Los cuatro fallos encontrados en esta rama
    vivian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
    [video_fullframe_tb.v]
2026-09-12 2.cpu-sim-func: dispositivo de video, y los casos graficos corren sin placa
    minicpu_sim.py gana una clase VideoDevice con la ventana de registros de
    0x80000000 y un reloj de frames sintetico. `read_u32`/`write_u32` enrutan la
    ventana hacia el, y `step()` avanza el reloj. Sin dispositivo, 0x80000000 sigue
    siendo memoria fuera de rango y da error, como siempre.
    No es una carpeta nueva a proposito: la parte cara --la CPU-- ya existe y esta
    mantenida, y duplicarla iria justo contra el punto 4 del TODO. Lo que faltaba
    era el dispositivo, que es una clase.
    Con esto `cpu-simulator` declara `video` y `frame_capture`, y los tres casos de
    cases/video corren headless. video-band y video-registers pas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
2026-09-12 Contadores de rendimiento y modo --measure
    La CPU emitia `instruction_retired` desde la 6 y no iba a ninguna parte, asi
    que el CPI solo se podia estimar contando ciclos en el RTL. Ahora se mide.
    Hardware (18):
    - `top.v` cuenta ciclos e instrucciones mientras la CPU corre. Se ponen a cero
    al ARRANCARLA, no al resetearla, para que run/halt/run den tres medidas
    independientes; saturan en vez de dar la vuelta, que a 80 MHz son 53 s.
    - monitor 1.11 -> 1.12: comandos 0x36 (ciclos) y 0x37 (instrucciones). Son dos
    y no uno porque el bufer de respuesta tiene 7 bytes y los dos juntos
    necesitan 9.
    - `monitor.py perf`.
    Dos fallos encontrados por el camino:
    - el decodificador de comandos del mo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
    [monitor.py, monitor.v, monitor_tb.v, top.v]
2026-09-12 Tres fallos que solo la placa podia encontrar
    La 18 nunca se habia ejecutado en hardware. Al hacerlo, 14 de 15 casos
    fallaban. Los tres motivos eran invisibles en simulacion, cada uno por una
    razon distinta, y eso es lo que merece la pena anotar.
    1. La captura de DQ no tenia margen (sdram_controller_128.v)
    READ_DELAY_CYCLES estaba en 1 por analogia con el controlador BL1 de la 16.
    Mala analogia: la 16 va a 100 MHz y esta a 80, y el viaje de ida y vuelta al
    chip es fisico y no escala con el reloj. Con 1, la rafaga salia corrida un
    beat entero. Con 0 salia casi bien: fallaban los beats 3 y 7 en DQ4 y DQ5, y
    al recompilar con otra semilla los bits malos se movian a DQ4 y DQ6. Un fallo
    que cam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
2026-09-12 La matriz de DQ, el rebarrido y lo que la placa enseno
    Cierra la sesion de hardware que empezo en 30410ed.
    `sdram_dq_matrix.py`: escribe un unico 1 aislado en cada una de las 128
    posiciones de una rafaga (8 beats x 16 DQ) y comprueba que vuelve donde se
    puso. Es lo unico que distingue este fallo, y merece quedarse como herramienta
    porque ni el banco ni nextpnr pueden:
    - el modelo de SDRAM comparte `READ_DELAY_CYCLES` con el controlador, asi que
    emparejados leen bien con cualquier valor: la simulacion comprueba coherencia
    consigo misma, no con la placa;
    - el camino de DQ entra por un pin, y nextpnr no modela lo de fuera del chip:
    daba +14,5% de holgura con el diseno roto.
    Lo que reso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
2026-09-15 Create protected-mode.md for CPU architecture details
    Add protected mode documentation outlining system privileges, traps, and interrupts.
2026-09-15 Small bug in monitor that does not give access to performance registers
    [clock2_gen.v, dvi_generator.sv, gpu_bench_video_tb.v, gpu_calib_tb.v, gpu_mmio_tb.v, gpu_monitor_regions_tb.v, gpu_plasma16_tb.v, gpu_plasma_tb.v]
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2026-09-17 Capacidades: admitir dispositivos compartidos entre CPU y GPU
    Fase 0 de docs/unificacion-mmio.md, el plan para aplicar al RTL el contrato
    objetivo de docs/mapa-de-memoria.md §6.
    El bloqueo no era que faltasen entradas GPU en capabilities.json, sino que
    `architecture` era un unico valor y `parse_requires` exigia coincidencia
    exacta con la del caso. Mientras `video` fuese solo "cpu", un caso GPU no
    podia declararlo aunque la placa tuviera el dispositivo -- justo lo que este
    plan existe para permitir.
    `architecture` y `file` admiten ahora un valor o una lista. Con lista, `file`
    son alternativas: el mismo dispositivo se llama distinto en cada familia
    (video_registers.v en CPU, gpu_video_regs.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
2026-09-17 12: mover la configuracion de warps a 0x80001000
    Fase 1 de docs/unificacion-mmio.md. La 12 es el ensayo del movimiento: EBR en
    vez de SDRAM, sin video ni contadores, ciclo de sintesis corto, y el parche
    recorre las cuatro capas que van a doler igual en 14, 17 y 22.
    El decodificador pasa de una pagina a dos: el prefijo es ahora
    address[31:13]==19'h40000 y address[12] separa la pagina de perifericos
    compartidos con la CPU (0x80000000) del control exclusivo de la GPU
    (0x80001000). Cuesta un bit en el comparador, y es lo que hace que el reparto
    siga valiendo el dia que CPU y GPU compartan bitstream. La depuracion SIMT no
    se mueve: ya estaba en su slot definitivo.
    Cuatro testbenches daban por h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
    [gpu_control_tb.v, gpu_regions_tb.v, gpu_system.v, gpu_system_tb.v, gpu_uart_tb.v, monitor.py, monitor.v]
2026-09-17 14 y 17: mover la configuracion de warps a 0x80001000
    Fase 2 de docs/unificacion-mmio.md. El parche de la 12 valio literal: los dos
    gpu_system.v eran byte a byte identicos al de la 12 en la parte del
    decodificador, y las cuatro formas en que aparecia la direccion vieja eran las
    mismas -- incluida la big-endian dentro de la trama UART.
    Su monitor.py ya declaraba WARP_CONFIG_BASE desde la fase 1, asi que el
    backend compartido de x.tests no se toca.
    Regresion RTL de 12, 14 y 17 en paralelo: las tres en verde a la primera, mas
    176 tests Python. 14 y 17 siguen respondiendo identicas. Queda verificar en
    placa, junto con la 12.
    [gpu_control_tb.v, gpu_regions_tb.v, gpu_system.v, gpu_system_tb.v, gpu_uart_tb.v, monitor.py, monitor.v]
2026-09-17 22: vídeo a 0x80000000 y warps a 0x80001000
    Fase 3 de docs/unificacion-mmio.md, y la que produce el resultado: el mismo
    programa de video, con las mismas constantes, vale ya en 21 y en 22.
    Los dos movimientos van juntos porque estan acoplados -- el video no podia
    volver a 0x80000000 mientras los warps estuvieran ahi. VIDEO_CTRL, que solo
    tiene la GPU, se va al final del bloque (+0x18) para que FB_FRONT quede en
    +0x00 como en CPU y ningun programa de CPU cambie.
    La 22 implementa ya el bit 1 de STATUS (swap_pending). Antes era cero fijo, y
    codigo que sondease ese bit esperando al intercambio funcionaba en CPU y se
    colgaba aqui.
    HALT_AT (+0x14) sigue sin implementarse -- pararia el SM desde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
    [gpu_calib_tb.v, gpu_control_tb.v, gpu_lsu2_tb.v, gpu_monitor_regions_tb.v, gpu_plasma_tb.v, gpu_profile_tb.v, gpu_regions_tb.v, gpu_system.v]
2026-09-17 docs: corregir §6 y anotar la fase de alinear la CPU
    §6 justificaba mandar VIDEO_CTRL a +0x18 diciendo que "los cores sin
    VIDEO_CTRL leen cero ahi, que ya es su comportamiento". Es cierto en 19 y 21
    (slot de 256 B) y en 18 (32 B, llega justo), pero NO en la 16: decodifica
    address[31:4], o sea 16 bytes, asi que +0x14 y +0x18 caen fuera del MMIO y van
    a SDRAM. No leen cero, leen memoria.
    Anotada la fase 3.5, que va en la direccion contraria a las anteriores: hasta
    ahora se movio solo la GPU para no romper binarios de CPU, y alinear la CPU si
    los rompe. Con la tabla de diferencias medidas en el RTL y las dos decisiones
    abiertas: bases de reset en 0/0, y BLANK o PATTERN como estado comun.
    Co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
2026-09-17 docs: partir la fase 4 y fijar SYS_ID como el numero de carpeta
    SYS_ID = {magic, byte libre, numero de carpeta}, p.ej. 0x4D470016 en
    22.fpga-gpu-bl8. Asi no hay identificador que asignar ni registrar al anadir un
    prototipo --que es lo que AGENTS.md presume del repo-- y no se puede duplicar
    porque lo impone el nombre del directorio. El magic evita que 0 sea ambiguo
    entre "prototipo antiguo" y "prototipo 0", que existe.
    Y hace comprobable que el bloque sea obligatorio sin generador: con el ID
    derivado del nombre, el test que recorre las carpetas y compara son cuatro
    lineas.
    La fase se parte porque el coste de las dos mitades no se parece. 4a son
    constantes a mano (~100 lineas repartidas entr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
2026-09-17 Renombrar perf_counters del backend a monitor_cycle_counters
    Habia dos cosas llamadas perf_counters y no eran matices del mismo concepto:
    daban valores OPUESTOS para la misma carpeta. En la 22, el campo del backend
    era False --su monitor tiene los 12 comandos base, sin CMD_GET_CYCLES (0x36)--
    mientras que la capacidad estaba presente, porque tiene gpu_perf_counters.v.
    El mal nombre era el del backend: no describe un dispositivo, describe si el
    monitor entiende dos comandos, que es lo que mapa-de-memoria.md §6.5 llama
    "+contadores". La capacidad conserva el nombre del dispositivo del contrato.
    Verificado: el campo sigue saliendo en 18, 19 y 21, y no en 6, 10 ni 16.
    Cierra tambien las otra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
2026-09-17 docs: fase 3.4 (acceso de 32 bits al MMIO) y contadores de CPU a MMIO
    El host llega a los registros MMIO byte a byte --en CPU solo con READ_BYTE, los
    bloques a MMIO los rechaza el monitor-- y _read_register/_write_register de
    fpga.py son cuatro idas y vueltas por serie. Entre la primera y la cuarta pasa
    ~1 ms, asi que un registro que siga vivo puede leerse partido.
    Ya hay un caso: fpga.py lee VIDEO_STATUS asi y saca frames = estado >> 16, que
    es frame_count, que incrementa con fill_start && fill_first SIN condicionar a
    cpu_halted -- el propio video_registers.v dice que avanza aunque la CPU este
    parada. A 60 Hz el acarreo cae cada ~4,3 s y la ventana es ~1 ms: del orden de
    una lectura de cad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
2026-09-17 docs: pasada de revision del plan; video-scanout.md describia el mapa viejo
    Repaso buscando lo que el plan no tiene, en vez de ejecutarlo.
    video-scanout.md seguia diciendo "En 21 los registros de video viven en
    0x80000000. En 22 esa direccion ya esta ocupada", con el decodificador antiguo
    y la conclusion de que lo portable es la semantica y no la direccion. Es el
    documento que justifica el diseno del scanout, asi que dejarlo desfasado es
    peor que en otros sitios. Reescrito conservando el problema historico --explica
    de donde sale el 0x80000200 de commits y capturas viejas-- y anadido el mapa de
    dos paginas.
    Y medido el alcance real de unificar las bases de framebuffer en 0/0, que el
    plan d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
2026-09-17 Verificado en placa: 12, 14, 17 y 22 con el mapa de dos paginas
    ULX3S 85F por COM3. Las cuatro sintetizan, cierran timing y funcionan en
    hardware real.
    12: 34,93 MHz / 25, +136 LUTs, 26 casos 0 fallos
    14: 32,65 MHz / 25, +47 LUTs, 27 casos 0 fallos
    17: 38,18 MHz / 25, sin version.json, verificada a mano
    22: 35,67 MHz / 25, +452 LUTs, 27 casos 0 fallos + kernels de video
    Cada caso de la suite configura warps, asi que valida de una vez la lista
    blanca del monitor, MONITOR_REGIONS y la ventana en 0x80001000.
    La suite NO prueba el video: los casos de video son de arquitectura CPU y se
    omiten. Eso se verifico corriendo los kernels y leyendo el bloque. Tras
    plasma.asm: FB_FR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
2026-09-17 Un solo monitor.v para la familia GPU, con las diferencias por parametro
    Los cuatro monitor.v de 12, 14, 17 y 22 se diferenciaban en tres cosas y
    ninguna era logica: VERSION_MINOR, el limite de RAM y la lista de ventanas
    MMIO. 14 y 17 eran ya identicos byte a byte; 12 estaba a 25 lineas y 22 a 22.
    La maquina de estados, los opcodes y el camino de TX eran los mismos.
    Ahora el fichero es COPIA IDENTICA en las cuatro carpetas --se decidio copia y
    no fichero compartido para que cada carpeta siga siendo autocontenida-- y lo
    que las diferenciaba llega por parametro:
    VERSION_MAJOR / VERSION_MINOR
    RAM_END 128 KiB en la 12, 32 MiB en el resto
    WINDOW0..3_BASE / _END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
2026-09-17 MONITOR_REGIONS en la familia HDMI, y un banco que lo comprueba
    Cierra el punto 10 del TODO.md, pendiente desde la fase 0 del plan.
    El vacio de 16/18/19/21 no era correcto, pero tampoco era un fallo visible, y
    las dos mitades importan por separado:
    - MEMORY_REGIONS solo filtra BLOQUES y transferencias (validate_block /
    validate_transfer); los accesos byte a byte no pasan por ahi. Como todo el
    acceso a video de esa familia va byte a byte por _read_register, la lista
    podia estar vacia indefinidamente sin sintoma. Ademas 21/monitor.v no tiene
    lista blanca propia --el filtrado lo hace el adaptador--, asi que tampoco
    habia gemela que la contradijera.
    - Lo incoherente er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
    [cpu_video_tb.v, monitor.py]
2026-09-17 Memoria contigua en la 6: 32 KiB de una pieza en vez de dos bancos con hueco
    La 6 era el unico prototipo con la memoria partida: dos EBR de 16 KiB en
    0x00000000 y 0x00100000, con 1 MiB de hueco en medio. Ahora el banco 1 empieza
    donde acaba el 0 y el bit 14 de la direccion elige.
    Sale a favor por tres lados:
    - Un programa puede pasar de 16 KiB. Antes el segmento de datos no podia
    cruzar el hueco, asi que ninguna estructura superaba un banco aunque
    hubiera 32 KiB libres, y el compilador tenia que conocer el agujero.
    - El decodificador se abarata: un comparador de 17 bits por puerto en vez de
    dos de 18, y hay tres puertos (monitor, imem, dmem). Seis comparadores
    pasan a t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
2026-09-17 SSY y BAR como no-op en la MiniCPU, para compartir binarios con la GPU
    El objetivo es que el MISMO .bin corra en las dos familias. GETTID ya existia en
    la CPU devolviendo cero, asi que el guardia habitual --GETTID, comparar con cero
    y saltar-- ya funcionaba; faltaban SSY y BAR, que no se pueden quitar del fuente
    compartido porque en la GPU un salto divergente sin SSY delante para el SM con
    ERROR_SIMT.
    En una maquina de un solo hilo las dos tienen semantica bien definida y trivial:
    no hay divergencia que reconverger ni nadie con quien sincronizar. Se retiran
    como NOP.
    EL NO-OP ES ESTRECHO, Y ESO SE PRUEBA. Se consideró un paso previo que
    tradujera esos opcodes a NOP en el binario, para no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
    [cpu.v, cpu_tb.v]
2026-09-17 READ_WORD en los diez prototipos, y SYS_ID en las cuatro GPU
    Fase 3.4 y 4a de docs/unificacion-mmio.md.
    READ_WORD (0x12 -> 0x92) lee 32 bits en UNA transaccion de bus. No es
    velocidad: es atomicidad. Hay registros que siguen vivos con el nucleo
    parado --frame_count avanza con el scanout, que cuelga de reset y no de
    core_reset-- y entre el primer READ_BYTE y el cuarto pasa cerca de un
    milisegundo, asi que el valor montado a trozos puede no haber existido
    nunca.
    Va por un puerto de 32 bits PARALELO al de bytes, no ensanchando el que
    habia: 18 bancos de prueba declaran `wire [7:0] host_read_data` y
    ensanchar habria truncado en silencio. Con un puerto nuevo, los 24 que
    faltaban por actualizar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
    [cpu_burst_system_tb.v, cpu_serial_tb.v, cpu_video_tb.v, gpu_bench_base_tb.v, gpu_bench_tb.v, gpu_bench_video_tb.v, gpu_calib_tb.v, gpu_control_tb.v]
2026-09-17 Un caso de video que corre igual en CPU y en GPU, con el mismo binario
    Cierra el ultimo punto de la fase 0 de docs/unificacion-mmio.md.
    x.tests/cases-shared/video/double-buffer escribe FB_BACK, pide SWAP,
    espera a que se aplique y comprueba que las bases se intercambian. Pasa
    en cpu-simulator y en gpu-simulator con el MISMO fichero de programa,
    que es la prueba de que el mapa MMIO es un contrato y no dos parecidos.
    Tres decisiones lo hacen portable:
    - Un solo hilo, quitando el reparto DESDE FUERA: el warps.json deja
    active_mask a 1. Asi no hace falta ninguna guarda con GETTID dentro
    del programa y el codigo puede ser literalmente el mismo.
    - No afirma ninguna direccion absoluta. Las b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
2026-09-17 El lanzador de tests funciona en Windows, y una carga deja de resintetizar
    Dos cosas que costaban tiempo a cada vuelta.
    tools/run-tests llamaba a x.tests/test, que es un script de bash: en
    Windows fallaba con un CreateProcess y tools/run-tests.ps1 existia pero
    no podia funcionar. La logica pasa a estar en tools/run-tests, que es
    Python y por tanto igual en las tres plataformas, y x.tests/test queda
    como envoltorio de dos lineas. Una implementacion y dos puertas de
    entrada, en vez de dos implementaciones que se separan en cuanto
    alguien toca una.
    Y _fresh_bitstream contaba los bancos de prueba entre las fuentes que
    invalidan el bitstream. Un `*_tb.v` no se sintetiza, asi que no puede
    cambia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
2026-09-17 Al dia el plan de unificacion: 3.4 y 4a cerradas y verificadas en placa
    Resultados en hardware del 17/09/2026 sobre la 22 (lsu2, monitor 2.6):
    SYS_ID responde 0x4D47_0016 leido con READ_WORD, y la suite completa de
    casos pasa 28 de 28 contra la placa.
    Dos correcciones al plan, no solo marcas:
    - fpga.py condiciona READ_WORD a la CAPACIDAD, no a la version de
    monitor como decia el plan. La numeracion no es comparable entre
    familias --la 6 va por 1.x y la 22 por 2.x-- asi que "version >= N" no
    significa nada fuera de una carpeta.
    - "Abrir el MMIO con el nucleo en marcha" pasa a ser dos casillas, una
    por familia. La CPU ya lo hace desde antes de este plan y la GPU no;
    con una sola ca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
2026-09-17 MMIO en marcha, SYS_ID en CPU y los contadores dejan de ser comandos
    Cierra la fase 3.4 y avanza 3.5 y 4a de docs/unificacion-mmio.md.
    MMIO CON EL NUCLEO EN MARCHA. Las cuatro GPU atienden ahora las
    LECTURAS de MMIO sin parar; la RAM y las escrituras siguen exigiendo
    parada. Hacia falta de verdad: parar la GPU NO congela frame_count,
    porque el scanout cuelga de `reset` y no de `core_reset`, asi que se
    juntaba lo peor de las dos cosas. Con esto desaparece el parche de
    run_board.py que se saltaba la comprobacion de underflow en GPU.
    En la 22 no bastaba con abrir la puerta. `mmio_data` sale del mux
    arbitro `gm_accept ? gm_addr : address`, asi que con el nucleo en marcha
    el host podia latear e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
    [cpu_burst_system_tb.v, cpu_dmem_adapter.v, cpu_perf_counters.v, cpu_serial_tb.v, cpu_video_tb.v, gpu_system.v, gpu_system_bl8.v, mmio_decoder.v]
2026-09-17 VIDEO_CTRL en las cuatro carpetas de MiniCPU
    El modo de salida pasa a ser un registro, en +0x18, con los mismos tres
    valores que la MiniGPU: BLANK, PATTERN y SCANOUT. Tras el reset vale
    PATTERN y no SCANOUT, a proposito: la memoria recien encendida contiene
    basura, asi que arrancar leyendola es elegir un valor por defecto cuya
    salida es indefinida. Con PATTERN, ver el patron demuestra que la cadena
    hasta el monitor funciona, y no verlo senala aguas arriba.
    Cambiar de modo a media linea colgaba el scanout de forma permanente
    --solo se recuperaba reprogramando la FPGA--, asi que el modo se muestrea
    en `fill_start` dentro de video_line_source_mux.v y la linea en curso
    termina con el modo con e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
    [top.v, video_mode_switch_tb.v, video_registers.v]
2026-09-17 Las bases de framebuffer dejan de venir cableadas del reset
    FB_FRONT y FB_BACK arrancan a cero en los cuatro video_registers.v y en los
    dos VideoDevice. La unica ventaja del valor cableado --que un programa
    dibujara sin configurar nada-- desaparecio al arrancar en PATTERN: quien
    quiera que se vea lo que dibuja ya tiene que escribir VIDEO_CTRL, y quien
    escribe un registro puede escribir tres. Ademas 0x01000000 no es valida en
    todos los mapas: en la 12, con 128 KiB de EBR, cae fuera.
    La constante de x.tests/backends/fpga.py no era un valor de reset aunque se
    llamara asi: es la direccion que el ARNES elige para los casos, y hace falta
    porque `band` y `bounce` leen FB_BACK y dibujan donde les d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
    [cpu_serial_tb.v, video_registers.v]
2026-09-17 La 19 vuelve a cumplir timing: semilla 4
    Tras la fase 3.5 la semilla fijada (6) se cayo de 88,00 a 72,06 MHz, un 9,9 %
    corta. El bisect senala al commit de VIDEO_CTRL -- 82,52, 89,32, 86,93, 72,06
    -- y repetir la sintesis da 72,06 clavado, asi que no es ruido.
    Pero no es logica: el camino critico son 2,18 ns de logica contra 11,70 ns de
    enrutado, y es el de siempre en esta carpeta --el handshake de memoria, sin un
    solo bloque de MMIO dentro--. Lo que cambio es como se coloca.
    Rebarrido de ocho semillas: cumplen TRES, entre 72,06 y 84,99. Se fija la 4,
    +6,2 %. Tres de ocho es peor que cualquier barrido anterior aqui --daban siete
    u ocho entre 80 y 94-- y la mediana cae por debajo de la rest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
2026-09-17 El barrido de semillas sirve ahora despues de una regresion
    Es cuando hace falta: cuando un diseno deja de cumplir, lo que hay que
    averiguar es si se ha vuelto lento o si lo que se cayo fue la semilla, y eso
    solo lo contesta correr todas y contar cuantas cumplen.
    sweep_report.py no podia. Se negaba a arrancar si el build de partida no
    cumplia timing, y abortaba en la primera semilla que fallara, asi que solo
    servia para confirmar un diseno ya sano -- justo cuando no hace falta. Con la
    19 a 72,06 MHz el barrido hubo que rehacerlo a mano.
    Una semilla que no cumple es un DATO, no un error: "cumplen tres de ocho" dice
    algo muy distinto de "cumplen ocho de ocho", y ninguna de las dos frases se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
2026-09-17 run_tests reparte los casos de simulador entre procesos
    gpu-simulator baja de 184,8 s a 96,2 s. El techo es bajo y esta medido:
    gpu-mandelbrot y gpu-mandelbrot-packed --89 y 95 s-- son el 99,9 % del tiempo,
    asi que ningun reparto baja del mas lento. Es un 1,9x, no un 24x.
    Procesos y no hilos: el simulador ejecuta el modelo dentro del proceso, es
    Python ligado a CPU y con hilos el GIL lo serializa. Cada worker construye su
    backend a partir del nombre y la version, porque el objeto lleva modulos
    cargados con importlib y no viaja por pickle.
    La placa no entra en el pool y ademas no comparte maquina: el reparto TERMINA
    antes de que se toque el puerto serie. Sus timeouts son de reloj de pared,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
2026-09-17 El protocolo del monitor vive una vez
    Los diez monitor.py con juego de comandos tenian 20 de los 21 metodos de
    MonitorClient byte a byte identicos. El unico que difería, read_word, difería
    solo en el docstring. No eran diez clientes: era uno copiado diez veces, y cada
    arreglo del protocolo habia que hacerlo diez veces y acordarse de las diez.
    tools/monitor_protocol.py se queda con el protocolo. Cada carpeta se queda con
    lo que la describe --baudrate, MAX_ADDRESS, su mapa-- y COMPONE su cliente con
    los mixins que su hardware justifica: SerialMixin donde hay serial_port.v,
    PerfMixin donde hay cpu_perf_counters.v, WarpMixin en la MiniGPU. No se hereda
    todo de balde, porque un metodo contra h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
    [monitor.py]
2026-09-17 SYS_ID en la 6 y la 10, y READ_WORD que estaba sin cablear
    SYS_ID entra por la puerta pequena. `sysid` cuelga del camino del MONITOR y
    nada mas: la CPU no lo ve, no hay pagina de dispositivos y un programa no puede
    leerlo, asi que la leccion de esas carpetas --memoria plana, sin perifericos--
    se queda intacta. Identidad si, MMIO no, y hay un test que lo vigila.
    Hace falta para la fase 5. Al renumerar las versiones de monitor por juego de
    comandos, 6 y 10 contestan lo mismo, y la version --1.17 contra 1.18-- era lo
    unico que las distinguia: sin esto `--version ebr` daria por buena una 10
    flasheada y se medirian prestaciones del hardware equivocado, que es
    literalmente el fallo que SYS_ID exi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
2026-09-17 Renumerar versiones de monitor, y ensanchar la ventana del host
    MAYOR = juego de comandos, MENOR = numero de carpeta. Habia NUEVE numeros para
    DOS juegos, y ademas colisionaban: 14, 17 y 22 respondian las tres 2.6 siendo
    hardware distinto, con lo que --version sdram pasaba contra una 22 flasheada y
    se median prestaciones del hardware equivocado.
    juego 1 base, 13 comandos 6, 10, 12, 14, 16, 17, 18, 22 -> 1.N
    juego 2 base + serie, 15 comandos 19, 21 -> 2.N
    Con el numero de carpeta el menor no se puede duplicar ni hay que registrarlo
    en ningun sitio: lo impone el nombre del directorio, igual que en SYS_ID. La
    colision no puede repetirse por construccion.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
2026-09-17 SysIdDevice: los simuladores tambien se identifican
    Gemelo en Python de sysid.v, en tools/sysid_device.py, para los tres modelos:
    2 (funcional de CPU), 11 (funcional de GPU) y 25 (ciclos).
    Existe porque un programa que se identifica --leer SYS_ID, mirar ISA_PROFILE y
    decidir-- tenia que probarse en la placa a la fuerza, que es al reves de como se
    trabaja aqui: el caso se escribe contra el simulador y la placa confirma.
    Cada uno declara SU carpeta, no la placa que modela. Hacerles decir "soy la 21"
    convertiria SYS_ID en una mentira util, que es la peor clase: un simulador no
    tiene el mapa de memoria ni el juego de dispositivos de ninguna placa concreta.
    El 25 lo destapo: hereda de function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
2026-09-17 Los backends de simulador se llaman como sus lanzadores
    cpu-simulator -> cpusim, gpu-simulator -> gpusim, y el modelo de ciclos deja de
    esconderse tras `--version cycle` para ser gpusim-cycle. tools/cpusim,
    tools/gpusim y tools/gpusim-cycle ya existian: dos nombres para lo mismo es de
    las cosas que hacen dudar de si son lo mismo. 95 sustituciones en 23 ficheros.
    El renombrado destapo dos fallos, los dos del mismo origen -- codigo que
    reconocia los simuladores POR EL SUFIJO del nombre:
    - `simulator_names` buscaba nombres acabados en "simulator", asi que dejo de
    encontrarlos y el reparto en procesos se apago EN SILENCIO. Solo se noto
    porque cpusim paso de 15 a 19,7 s.
    - Y el peor: `gpusi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
2026-09-18 xorshift32 como caso de programa
    Diez pseudoaleatorios de 32 bits en 0x00100200. Solo nucleo de la ISA
    --XOR y SHL/SHR con registro, sin shift_immediate-- para que corra en
    cualquier CPU del repo.
    Verde en cpusim y en la 21.
2026-09-18 Tres demos para la 21: campo de estrellas y cubo en alambre
    starfield.asm reusa el xorshift para un tunel de estrellas; la
    perspectiva es una division, asi que la aceleracion al acercarse no hay
    que programarla.
    starfield_fast.asm borra solo los 256 pixeles anteriores en vez de la
    pantalla entera. La trampa es que con doble buffer el buffer trasero
    contiene el frame de hace DOS, asi que cada estrella guarda dos
    direcciones; y los borrados van en una pasada previa a los dibujos, o el
    borrado de una estrella apagaria el pixel que otra acaba de encender.
    De 123 000 a 16 000 instrucciones de trabajo por frame.
    cube.asm gira ocho vertices en Q16.16 con MULFX y traza las doce aristas
    con el draw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
2026-09-18 Casos de video para las demos nuevas
    starfield fija el contrato del PRNG y cubre DIV con dividendo negativo
    repartido por la pantalla, que un caso de ALU con cocientes sueltos no ve.
    starfield-fast compara contra el expected de starfield, no contra uno
    propio: que dos programas distintos den el frame identico es lo que
    demuestra la contabilidad de los dos buffers, imposible de ver a ojo.
    cube es el unico caso con coma fija, y el unico que mezcla las dos reglas
    de redondeo de la ISA: MULFX y SARI desplazan aritmeticamente, DIV trunca
    hacia cero. Aplicar la misma a las tres desplaza un pixel las aristas del
    lado negativo y solo esas.
    Los tres modelos de referencia se escribieron aparte del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
2026-09-18 Patron de diagnostico warp/lane para la MiniGPU
    320x240 RGB565 en 0x01000000: cada warp una banda de 30 filas con su
    color base y cada lane un escalon de intensidad. Un solo bucle de 600
    iteraciones por lane, cuerpo de tres instrucciones, sin correccion de
    stride: 20 iteraciones de 32 bytes son exactamente una fila, asi que la
    lane cambia de fila sola conservando su columna.
    Las 64 lanes particionan el framebuffer exactamente --cero bytes sin
    escribir, cero escritos dos veces-- y cada STORE genera ocho direcciones
    consecutivas de 4 bytes, 32 bytes contiguos por instruccion.
    OJO: usa GETWARP/GETLANE, que isa.md declara sin implementar y sin opcode
    asignado, asi que este fichero NO ensambla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
2026-09-18 .include en el ensamblador, y una biblioteca compartida
    drawline y putpixel estaban copiados literalmente en tres sitios
    --bresenham_lines.asm, bresenham_circles.asm y cube.asm-- y una
    correccion en Bresenham habia que hacerla tres veces. El riesgo no era el
    trabajo: era que los casos de video que comparan contra el abanico
    pasaran mientras cube.asm se quedaba con la version vieja.
    La directiva se expande ANTES de la pasada 1, asi que el resto del
    ensamblador sigue viendo una secuencia plana de lineas. Lo unico que
    cambia es que cada linea recuerda de donde vino, que es lo que permite
    que un label duplicado diga los DOS sitios -- lo importante cuando no hay
    espacios de nombres.
    Busqueda: p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
2026-09-18 .once: el fichero incluido se declara idempotente
    Mejor que un `.include_once` en quien incluye: ser idempotente es una
    propiedad del fichero, no de cada sitio que lo llama. Con la directiva en
    el includer hay que acordarse en las N llamadas y basta que una se
    olvide. Es el modelo de #pragma once, y ca65 tiene la directiva con este
    mismo nombre.
    Sigue siendo opt-in: sin `.once`, incluir dos veces emite el contenido
    dos veces, que a veces es lo que se quiere (una tabla repetida). Hay test
    de los dos comportamientos.
    No necesita tabla de simbolos ni ensamblado condicional --que era mi
    objecion para no hacer guardas-- porque deduplica por ruta resuelta, que
    ya se calculaba para detectar ciclo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
2026-09-18 Etiquetas locales @nombre, y documentar el ensamblador
    Una etiqueta que empieza por `@` pertenece a la ultima global, y por
    dentro se llama `global@local`. Como `@` solo se admite al PRINCIPIO de un
    nombre, ese compuesto no lo puede escribir nadie: no hay forma de chocar.
    Es la otra mitad de lo que hacia falta para que incluir ensamblador
    escale. Con `.include` y sin esto, drawline.inc se apropiaba de NUEVE
    nombres globales, ocho de ellos saltos internos que no le importan a
    nadie. Ahora reserva uno.
    `@` y no `.` porque un `.loop:` se lee como directiva; y no `_` porque el
    backend MiniISA de y.lcc emite `_start` como simbolo global, y ademas un
    `_` delante significa historicamente lo contr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
2026-09-18 y.lcc: construir mini-lcc en Windows
    Avanza el submodulo de 3f665a8 a 91bfc8a. Son DOS commits, no uno: el de
    Windows y el "working on longlong" que ya estaba en main y que el
    puntero de aqui no habia recogido todavia.
    Eso cambia lo que mide la suite de mini-lcc: de 116/116 (+4 xfail) a
    120/121 (+7 xfail). El que falla, 117_long_long_return_low_high, es uno
    de los tests que anade ese mismo commit y es un fallo de plegado de
    constantes de 64 bits en src/mini.md, no de Windows ni del puntero.
2026-09-18 y.lcc: R5 reservado como scratch, y 117 era limitacion del anfitrion
    Corrige lo que dije en el commit anterior: 117_long_long_return_low_high
    no falla por el backend sino porque lcc parsea las constantes enteras en
    `unsigned long`, de 32 bits en este build. En Linux LP64 son 64 y por eso
    alli pasa.
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2026-09-18 y.lcc: SLT/SLTU en el simulador y test de 64 bits sin literales
2026-09-20 checkpoint: migraciones de la 19 y la 21 a MMIO v2, antes de empezar la 18
    Punto de restauracion. Recoge tal cual el estado verde del arbol de trabajo
    --las dos migraciones anteriores estaban sin commitear-- para que la tercera
    carpeta pueda apilarse encima con algo a lo que volver, ya que toca las piezas
    compartidas (x.tests, tools, 1.isa).
    Incluye la regeneracion de la documentacion generada, que estaba en rojo desde
    antes de tocar nada: reports/ tiene un build de la 21 posterior a su migracion
    que no cumple temporizacion (sdram_clk 79,90 MHz contra 80,00, semilla 13) y
    que sube el area a 11.590/5.236 LUT/FF. El FAIL queda documentado; el barrido
    de semillas sigue pendiente y no se paga a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
    [cpu_burst_system_tb.v, cpu_dmem_adapter.v, cpu_mmio_error_tb.v, cpu_perf_counters.v, cpu_serial_tb.v, cpu_video_tb.v]
2026-09-20 18.fpga-cpu-hdmi-bl8: migracion a MMIO v2
    Tercera carpeta conforme, despues de la 21 y la 19. Bitacora completa en
    18.fpga-cpu-hdmi-bl8/docs/migracion-v2.md.
    RTL: los seis ficheros MMIO compartidos se copian ya migrados de la 19 y
    quedan byte a byte iguales en las tres carpetas. cpu_dmem_adapter.v es esa
    copia mas una linea propia --la 18 no tiene accesos sub-palabra, asi que su
    comprobacion de alineacion en SDRAM se queda--. top.v lleva sus valores:
    HAS_SERIAL(0), DEVICES 0x225 sin el bit de SERIAL, VIDEO_REGISTERS 0x3ff,
    MONITOR_VERSION 0x0312 y TRES ventanas de monitor en vez de cuatro.
    Es la primera carpeta sin puerto serie que se migra, y eso resulto ser lo mas
    caro: HAS_SERIAL hay qu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
2026-09-20 checkpoint: validacion de MMIO v2 en placa (18, 19, 21)
    Ronda de placa completa, que estaba entera sin commitear:
    - video_registers.v x3: el error de dato colgaba de `bus_write`, que muere
    con `select` un ciclo antes de que el cliente lo muestree en el `ack`.
    Pasa a colgar de `write`, que el mux si retiene.
    - mmio_error_ack_tb.v x3: banco nuevo que monta la cadena entera y mira el
    error donde lo mira el cliente.
    - x.tests/backends/fpga.py: parada por sondeo de SWAP_COUNT en vez de la
    alarma de v1, paridad del intercambio pendiente, y puesta a cero de las
    regiones que el caso va a volcar.
    - 18/19 monitor.py: la ventana del CLI seguia en la pagina de 4 KiB de v1.
    - test_monitor_prot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
    [mmio_error_ack_tb.v, monitor.py, video_registers.v]
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2026-09-20 6.fpga-cpu: migracion a MMIO v2
    El bloque de identificacion pasa de cuatro palabras en 0x80000F00 a siete en
    0x80000000. NO gana MMIO: sigue sin decodificador, sin pagina de dispositivos y
    sin nada que un programa pueda leer.
    - sysid.v copiado ya migrado de la 21, byte a byte.
    - La seleccion lleva DOS comparaciones: siete palabras no son potencia de dos,
    y con `[31:5]` a secas la palabra 7 (+0x1C) contestaria cero en vez de error,
    que es lo que la seccion 5 prohibe. Banco que lo fija y control negativo.
    - Ventana de monitor y MONITOR_REGIONS al bloque entero de 64 KiB.
    - NO se le anaden MMIO_BASE/MMIO_LIMIT: su CLI no filtra direcciones, y
    declarar constantes que nadie lee es como sob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
    [monitor.py, monitor_tb.v, sysid.v, sysid_host_tb.v, top.v]
2026-09-20 10.fpga-cpu-ram: migracion a MMIO v2
    Gemela de la 6 y salio casi gratis, que era la prediccion del encargo. Mismos
    cinco ficheros, mismos cambios, otros valores: ISA_PROFILE 0 --sin MUL ni DIV--,
    DEVICES 0x005 --SYSTEM + SDRAM--, MEM_SIZE 32 MiB, MONITOR_VERSION 3.10.
    Su seleccion cuelga de la direccion YA REGISTRADA, no del bus crudo como en la
    6, asi que no toca el camino critico. Mismo diff, distinto riesgo.
    Lo unico que no fue gemelo, y es el hallazgo: SU CLI NUNCA PUDO LEER SU PROPIO
    BLOQUE DE IDENTIFICACION. MAX_ADDRESS son los 32 MiB de SDRAM, asi que
    `monitor.py read-word 0x80000f00` se rechazaba en el host sin llegar al cable.
    No es una regresion de v2: pasaba igual en v1. Lo dest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
2026-09-20 16.fpga-cpu-hdmi: migracion a MMIO v2, y con ella la familia CPU entera
    Bloques de 64 KiB, SYSTEM de siete palabras, direccion MMIO de 12 a 32 bits y
    deteccion por address[31]. Cinco de sus ficheros MMIO se copian ya migrados.
    LA DECISION DEL BITMAP: adopta los DIEZ registros de video, no los cinco que
    tenia, asi que GANA frame_capture. Conservar cinco era conforme pero exigia
    bifurcar una cuarta variante de video_registers.v --hoy identico en cuatro
    carpetas-- y dejaba a la 16 fuera de los casos de video del runner, que es la
    carpeta que menos cobertura automatica tiene. El hueco que parecia bloquearlo
    --underflow_clear y halt_request-- resulto ser otra copia limpia mas un OR.
    ES LA PRIME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
2026-09-20 docs: encargo de migracion a MMIO v2 para la familia GPU
    Las cuatro que quedan: 17, 14, 12 y 22. Con ellas se borra mmio_map_v1.vh.
    Datos medidos el 20/09/2026 sobre 8c2b261, no heredados. Corrige la estimacion
    que la bitacora de la 19 dejo escrita sobre la 17: decia que gpu_system.v es
    unico de cada carpeta y que la familia GPU no hereda nada, y medido con
    git hash-object los cuatro comparten la linea de decodificacion literal y el
    fichero de la 14 y el de la 17 difieren en UNA linea, el numero de carpeta.
    Trae ademas el riesgo que la 16 acaba de destapar y que esta familia comparte:
    el coste de v2 es estructural --un lazo adaptador/decodificador/dispositivo sin
    mmio_mux por medio-- y no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
2026-09-29 Small tests solved and interactive Basic
    [basic_mini_tty.c, monitor.py, run_minicpu.py]
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2026-09-29 Fmax of 30: fabric response_data without zeroing, console reads one cycle earlier
    memory_fabric_4: response_data is only loaded from the SDRAM response (ST_WAIT).
    It was also zeroed on an address error in ST_IDLE, which hung the whole
    arbitration -> address mux -> range compare cone on the clock enable of 128
    flip-flops. Nobody reads the data with rsp_error high (the CPU drops the LOAD,
    instruction_buffer and monitor_mem_adapter_128 ignore it).
    text_console: text_ram and palette_ram are read continuously from `address`,
    one cycle before the select reaches the device, and a fabric register holds the
    value. mmio_mux registers address in cycle 0, so the data reaches mmio_decoder in
    the same cy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
    [memory_fabric_4.v, text_console_tb.v]
2026-09-29 video_fullframe_tb: 2 frames instead of 6, and check both buffers
    The bench was 96% of the RTL suite of prototype 30 (115.7 s of 120 s; the other
    31 benches take about 8 s together). The program draws the same picture every
    frame and the CPU needs ~0.5 ms per buffer against 16.8 ms per video frame, so
    frame 2 is already the steady state. underflow is a sticky flag, one read at the
    end covers every simulated frame.
    FRAMES_TO_STOP 2, 3, 4 and 6 were run in isolated copies: all pass. The old note
    saying that 2 stopped the CPU mid-burst no longer reproduces.
    With an even frame count the dumped front buffer is always FB0, so FB1 was never
    checked. Both are checked now. A copy with one FB1 pixel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
    [video_fullframe_tb.v]
2026-09-29 test: --jobs runs RTL benches in parallel, each group in its own copy
    apio test runs every bench in one scons invocation and cannot parallelize. With
    --jobs N (default 2) the benches are split round-robin into N groups, each one
    apio test on its own copy of the prototype folder, so scons state is not shared.
    The copies are siblings of the prototype (_tmp_test_<k>_<name>, so ..\x.tests
    paths still resolve), leave out reports/ and _build/, and are removed on exit
    even on failure. Files a bench writes in its folder (frame_full.hex/.bin) are
    copied back. --jobs 1 keeps the previous behaviour.
    Prototype 30 suite: 125 s -> 55.7 s. Prototypes 18, 19, 21 pass in 41, 59.7 and
    42.3 s; their time befo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
2026-10-01 x.tests: READMEs per case, regenerable data and _build output
    - README for every case in x.tests (68 new + 3 category indexes).
    - mini_asm.py and run_board.py write the assembled .bin to _build/ next to
    the source instead of beside it, so it no longer looks like an input.
    - run_tests.py runs reference.py / make_expected.py when an expected data
    file is missing (they are gitignored with **/*.bin).
    - pacman incbins 1.isa/minigpu-small.bin instead of an untracked copy.
    - Version the recorded reference frames that have no independent generator
    (cube-solid, subword-demo, plasma).
2026-10-01 x.tests: test for on-demand data generators; document _build default output
    - test_data_generators.py covers load_data_file running reference.py /
    make_expected.py only when the expected file is missing.
    - 1.isa/README.md and tools/README.md say that mini_asm.py (and board-load /
    run-board) write the binary to _build/ next to the source by default.
2026-10-01 x.tests: mandelbrot gets a reference.py like every other case
    The scalar Q16.16 model moves out of run.py into reference.py, so run_tests
    regenerates expected.bin when it is missing. run.py --reference-only reuses it.
    Verified byte-identical with the tracked expected.bin via reference.py,
    run.py --reference-only and the runner with the file removed.
2026-10-01 x.tests: READMEs for the demo programs that are not cases
    serial-upper, tear-demo, tear-demo-fast, text-console-demo, text-scroll-demo,
    video/fire and the GPU cube-solid variants had no test.json and no README.
    Each README says why it is not a case. Also fix the broken path to
    make_cube_solid_frames.py in 22.fpga-gpu-bl8/cube-solid.md.
2026-10-01 docs: cycles.md assembles fastpath_hit instead of loading a stale example
    The ignored examples/*.bin of the CPU prototypes (16, 18, 19, 21, 30) were
    leftovers from before the sources moved to x.tests: nothing generates them
    (their benches do not read examples/) and board-load picked them up before
    the freshly assembled source. Deleted locally; the two docs that pointed at
    examples\fastpath_hit.bin now assemble it first.
2026-10-01 HALT_AT counts swaps again, on every CPU and GPU with video
    MMIO v2 had moved HALT_AT to count video frames so that a hung program
    could still be captured. That cost the property the alarm exists for: the
    number of swaps at the stop depended on how fast the program drew, so the
    captured frame was not "the frame of swap N". A time limit already covers
    the hung program, because the host can halt the core and read memory.
    The alarm now fires when the Nth swap completes after arming, with the
    finished frame in the front buffer. It counts with an internal counter,
    so arming no longer resets FRAME_COUNT or SWAP_COUNT. mmio.md 9.6 and
    decision 17 are revised, with a note on the history.
    - CPU vid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
    [cpu_video_tb.v, gpu_system_bl8.v, gpu_video_regs.v, gpu_video_regs_tb.v, mmio_decoder.v, video_fullframe_tb.v]
2026-10-01 x.tests: one video stop for CPU and GPU boards, GPU video cases run on board
    Stopping a video program after N swaps lived only in the CPU backend; the
    GPU backend waited for a HALT that a video program never executes, so
    run_until cases were skipped on 22 and 29.
    - backends/video_stop.py holds what both backends share: the stop, the
    wait for a pending swap, and the frame capture. After the stop it checks
    how many swaps overshot: 0 reads the front buffer, 1 the back buffer,
    2 or more raises ParadaImprecisa and the case is retried up to 3 times
    instead of failing on one pixel as if it were noise.
    - Two ways to stop, chosen by the new halt_on_swap capability (detected
    from the RTL):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
2026-10-01 x.tests: the demos become bounded cases, warp_lane_bands runs on a GPU board
    Demos get a test.json that stops them as soon as they have shown what
    they exist to show: CPU fastpath hit/miss, fpga-smoke-test, perf-loop,
    swap-smoke, fullframe, subword-demo and cube-solid; GPU plasma and
    plasma-nommio, mmio-selftest, and warp-lane-bands (ported to GETTID, with
    a reference.py). divzero.asm was empty and is removed.
    record_case.py records the expect block from the simulator. It refuses to
    record when the simulator ends in error, and with run_until it records no
    pc, registers or warp state, because that stop is asynchronous and the
    board could never match them.
    Recorded values are snapshots, not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
2026-10-01 tools: test-all, bench-all and perf-report
    - test-all runs the whole suite on every prototype with a board, one at a
    time (there is one board), and writes a case x prototype matrix with the
    reason for every skip. A pass that exits non-zero without a FAIL line is
    reported as INCOMPLETO instead of OK.
    - bench-all runs --measure on every prototype, CPU and GPU, and archives
    each measurement.
    - perf-report merges the newest measurement per case and prototype into
    tables: time, CPI, FPS for video programs (only with 10 swaps or more),
    and what got better or worse. Very short cases are not judged.
2026-10-01 29: gpu_mmio_bl8_error_tb expects 8 performance counters
    The pipeline added REG_NO_WARP_STALL at PERF+0x1C, so the first offset past
    the counters is +0x20. The bench failed since gpu_perf_counters.v grew to
    eight, and apio test stops at the first failure, which hid the rest.
    [gpu_mmio_bl8_error_tb.v]
2026-10-01 TODO: drop what is done, refresh lint, close the 17 and the SM pipeline
    - Remove the demos-without-case item and the notes already answered.
    - Point 1: the board round was repeated on 2026-10-01 with 0 failures on
    all eleven prototypes the suite knows; the 17 stays out of the suite and
    moves to the closed list.
    - Point 4 becomes "segment the X unit": the 6-stage pipeline exists in 29.
    - Point 7: lint table now covers twelve prototypes, with the new WIDTHTRUNC
    in sysid.v and the CASEINCOMPLETE in 29 gpu_sm.v.
    - Drop a stray paragraph under point 14.
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2026-10-01 Add shared RTL differential fixture generator
    The five GPU prototypes (12, 14, 17, 22, 29) each carried an identical
    make_fixtures.py and ~258 versioned generated files. tools/make_rtl_fixtures.py
    now holds the 32 programs once and writes the same fixtures/ layout, so no
    testbench changes (and no bitstream invalidation).
    Cases declare `requires` capabilities and a prototype skips those it lacks.
    test_runner uses the shared generator for any prototype whose bench includes
    fixtures/count.vh, falling back to a local make_fixtures.py. Output was
    verified byte-identical for all 1290 files before wiring it in.
2026-10-01 record_case: dump every lane and keep zeros on request
    It only recorded lanes 0 and N-1 and dropped zero registers, so a case about
    WHICH lane does something (one middle lane taking a branch) or about something
    NOT executing (a lane that died before writing R3) recorded nothing useful.
    --all-lanes dumps every lane; --zeros records zeros for registers that are
    nonzero in some lane of the same warp. Defaults are unchanged.
2026-10-01 Add GPU cases for programs that only lived in RTL fixtures
    Convert the differential-fixture programs with no x.tests equivalent into
    cases (branch conditions, ALU/R0, workgroup barriers, memory edges, EXIT/HALT
    variants, SSY reuse), each with README and the rtl.differential mark. Add
    three that close gaps found while converting: BLTU/BGEU divergence, per-group
    barrier isolation (hangs under a global barrier) and LOAD R0 still faulting.
    The two partial region programs are kept because they reach depths no ssy-*
    case does (reuse with 7 PATH entries; two chained regions).
2026-10-01 Drive RTL differential fixtures from x.tests cases and stop versioning them
    The differential bench programs are now x.tests/cases-gpu cases marked
    "rtl": {"differential": true}; tools/make_rtl_fixtures.py reads them (by
    sorted path), keeps those whose `requires` the prototype's RTL satisfies and
    writes fixtures/ in the unchanged format. demos/vector and demos/simt carry
    rtl.warp_config so the RTL still launches 8 warps while the case keeps its 2.
    fixtures/ (1290 generated files) and the five identical make_fixtures.py are
    removed and fixtures/ is gitignored in the five prototypes. Regenerated
    output is byte-identical to the old files for all 32 previous programs; the
    two new cases (R0 hard-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
2026-10-01 Limpieza de avisos de ruff: imports y variables sin usar, test B017
    - Quita imports sin usar (F401) fuera de los monitor.py, que los reexportan.
    - Quita variables sin uso (F841) en build_runner, bounce/reference y test_traceability.
    - test_un_programa_que_falla_en_el_simulador_aborta fallaba al ensamblar, no
    en el simulador, y assertRaises(Exception) lo escondia; ahora usa un LOAD
    fuera de memoria y espera AssertionError.
2026-10-01 Config de ruff en pyproject.toml: solo reglas que apuntan a fallos reales
    Activa F, B017 y B023; exime a los monitor.py de F401 porque reexportan
    nombres de tools.serial_ports que usan los tests. Los dos B023 restantes
    son falsos positivos y llevan noqa con el motivo.
2026-10-01 Config de markdownlint: desactiva reglas de estilo y excluye los lburg
    Apaga MD013, MD014, MD025, MD030 y MD060 (miles de avisos sin valor) en
    .markdownlint.json. Los .md de y.lcc/src son lburg, no Markdown: se excluyen
    con markdownlint.ignore en .vscode/settings.json.
2026-10-01 Docs: arregla una fila de tabla incompleta y dos enlaces rotos
    - 10/docs/migracion-v2.md: la fila de monitor.py tenia 2 celdas de 3.
    - 21 y 30 README: el enlace a "Que se rompe con R0 a cero" apuntaba a un
    encabezado que se llama "Que se rompio con R0 a cero, y como quedo".
2026-10-01 Docs: limpieza de markdownlint (0 avisos) y reglas de estilo desactivadas
    - Aplica markdownlint --fix: lineas en blanco de mas, salto de linea final,
    espacios al final y URLs sin enlazar.
    - Etiqueta con lenguaje (bash/powershell/text) 17 bloques de codigo.
    - Desactiva MD001, MD003, MD010, MD022, MD024, MD028, MD029, MD036 y MD041
    en .markdownlint.json. MD003/MD022 porque --fix metia lineas en blanco
    dentro de las formulas \[ ... \] de intro-gpu.md.
2026-10-04 Add text console to the functional simulators and update z.tui
    VideoDevice gains an optional console mode (CONFIG, palette, 80x30 text RAM
    and SWAP as the two-bit FRAME_COMMIT, as in 30's video_registers.v), enabled
    with --console / --console-output in cpusim, gpusim and gpusim-cycle. This
    lets the z.tui demo run without a board. Tests in test_sim_console.py.
    z.tui now points at the fix for the stack overflow that stopped the demo
    with error 5.
2026-10-04 Use a full CP437 font on the console and count fonts as build inputs
    make_font.py now produces both fonts with the CP437 assignment: the PC one
    entirely from Unscii-16 (public domain), the CPC464 one from the TTF for text
    and from Unscii for the 0xB0-0xDF box/block range and the codes the TTF lacks,
    plus four hand-drawn glyphs. Glyphs are drawn at a fixed origin; the old
    centring by bounding box lifted '_' and dropped '.' to mid-cell.
    build_report.py now hashes fonts/*.hex, so changing a font no longer reports
    the bitstream as CURRENT and skips the rebuild.
    Adds console_charset_demo.py, which paints a CP437 test screen through the
    monitor. Updates the z.tui submodule (double frames, check/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
    [make_font.py]
2026-10-04 Add font-patch: swap the console font in a built bitstream without resynthesis
    The font ROM is initial content of four EBRs in hardware.config. font-patch
    finds them by content (recognising which fonts/*.hex the bitstream carries),
    rewrites them with the requested font and repacks with ecppack; --upload
    programs the board with fujprog. Patching to the default font gives the same
    bitstream, byte for byte, as a full synthesis.
2026-10-04 Render the simulated console to PNG with a chosen font
    cpusim and the other simulators gain --console-image/--console-font. The
    simulator keeps the console as state only and nothing composed it over the
    framebuffer, so tools/console_render.py draws it like text_console.v does
    (8x16 glyphs, colours 1..15 from the palette, colour 0 transparent) and
    composites it over the framebuffer when the program uses it.
    Adds previews of the z.tui demo with each font, tests for the renderer, and
    documents both this option and font-patch in tools/README.md.
2026-10-04 Repair mmio.md formatting and number INPUT as section 25
    Commit a8dd52a rewrote the whole file with Markdown escapes and hard
    line breaks. Rebuild it from the clean parent and re-apply the real
    content: the INPUT device (keyboard and mouse), bit 11 of DEVICES, the
    reset state, MMIO_INPUT_BASE, the visual summary, decisions 45-66 and
    appendix A.
    INPUT is section 25 rather than 12 so sections 12-24 keep their numbers:
    about 370 references in RTL, tests and docs cite them.
2026-10-04 Unify option names: --run-limit, --serial-timeout and monitor uart
    Same meaning, one name, no aliases:
    - --max becomes --run-limit in the three simulators, mini-dbg,
    run_minicpu.py, tests and docs; the cycle simulator drops
    --max-instructions.
    - monitor.py --timeout becomes --serial-timeout (all prototypes and the
    sdram_dq_matrix scripts), like mini-dbg, run-board and run_tests.
    - The monitor console command becomes uart, freeing the name for the
    VIDEO text console; interactive_console is now interactive_uart.
2026-10-04 Add the INPUT device (keyboard and mouse) to the functional simulators
    InputDevice models mmio.md section 25 at 0x80600000: KEY_STATE0..7,
    MOUSE_BUTTONS, STATUS, EVENT_DATA (read-and-pop) and EVENT_CTRL, with the
    event ordering, signed12 mouse moves, drop-new overflow and the
    connect/disconnect rules. Hosts feed it complete reports
    (keyboard_report, mouse_report) and it derives STATE and the FIFO.
    CPU and System take an input_device argument; the cycle simulator
    inherits it. 52 tests cover every rule of the section.
2026-10-04 Add INPUT scripts and the --keyboard, --mouse and --input-script options
    A script is one action per line with the instruction at which it happens
    (@N absolute, +N relative): connect/disconnect, key down/up/press, type,
    mouse move/button/report. It is checked whole when loaded, so a key on a
    keyboard that is not connected fails with its line number instead of
    mid-simulation. tools/hid_keys.py holds the key names and the US ASCII map.
    InputDevice.tick() advances the script with the completed instructions;
    the CPU and GPU simulators call it. Options live in sim_peripherals, so the
    three simulators and mini-dbg get them together.
2026-10-04 Add the input capability and the `input` field to test cases
    A case feeds INPUT with "input": a list of script lines (tools/input_script.py)
    and declares requires: ["input"]. The script is checked when the case is
    loaded. Only the simulators declare the capability, since no RTL implements
    INPUT yet, so on the board the case is skipped. The three simulator
    backends build the device from the script.
    First case, extensions/input/keys-and-mouse, reads seven events (modifier
    change, key down/up, button and move) and checks them in registers.
2026-10-04 Add the host keyboard and mouse translation for INPUT
    tools/host_input.py turns host events into complete INPUT reports without
    depending on Tk, so it is testable without a window. Physical keys come from
    MapVirtualKey -> scancode -> HID (layout independent, so the Spanish n-tilde
    key is the US semicolon position); modifiers are read with GetAsyncKeyState
    because Tk reports Shift releases wrongly; autorepeat presses are ignored;
    the fake Control_L of AltGr is dropped; losing focus releases everything.
    Mouse deltas are position differences, fused until drained.
    All of it follows a probe of Tk on Windows with a Spanish keyboard.
2026-10-04 Add --window: a live screen with keyboard and mouse for the simulators
    tools/screen.py composes what would come out of HDMI (BLANK, PATTERN, the
    SCANOUT framebuffer, plus the text console over it) with PIL and cached
    tiles; it is pixel-identical to console_render.render_rgb, which stays the
    reference. tools/screen_window.py is the Tk process: it draws, captures
    keyboard and mouse through host_input, and sends complete INPUT reports back.
    tools/sim_display.py drives it from the simulator: refresh when the screen
    changed, apply the reports, and stop the simulator on close or F12.
    InputDevice.tick hands control to the host every N instructions, so no
    simulator loop changed. mmio_map.vh gains t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
2026-10-04 Debugger window and INPUT command, --serial-tty and a clean instruction limit
    mini-dbg: `fb screen` (and --window at startup) opens the simulator screen with
    the console and keyboard/mouse wired to INPUT, through the same SimDisplay the
    simulators use. F12 interrupts the running command and does not halt the
    machine; closing the window only disconnects the devices. `input` shows
    presence, pressed keys, mouse buttons and the event queue without consuming
    anything. In the windows Esc is now a normal key for the program: F12
    interrupts (the TUI keeps Esc as well).
    --serial-tty connects the terminal to the simulated UART (SerialTty in
    tools/sim_host.py, which also holds the keyboard reader that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
2026-10-04 Paint demo follows the pointer; hold mouse movement instead of dropping it
    input_paint.asm keeps its position in half pixels (the window shows the
    framebuffer at double size, so the brush now moves at the pointer's speed)
    and R G B Y C M W give named colours instead of mixing the Usage ID.
    SimDisplay holds mouse movement while the INPUT FIFO is nearly full and
    delivers it as one summed report once there is room, so a slow simulator
    (or the debugger) no longer loses motion. The device itself stays faithful
    to the contract: only the host policy changed.
2026-10-04 Clamp the reported pointer position to the window
    When the pointer leaves fast, Tk gives coordinates far outside the window. A
    program that clips its cursor to the screen loses that excess for good and the
    brush never lines up with the pointer again. HostMouse now limits positions to
    the window, so what is delivered always fits the guest's screen.
2026-10-04 INPUT: apply_event, funciones puras del adaptador y codec del monitor
    InputDevice gana apply_event (lo que hara el RTL con cada palabra) y
    keyboard_events/mouse_events (el adaptador, sin FIFO). Se corrige que los
    Usage IDs 0xE8..0xFF no generaban evento. InputMixin anade INPUT_EVENTS
    (0x3B) e INPUT_PRESENCE (0x3C) al cliente de la 30.
    [monitor.py]
2026-10-04 INPUT: input_registers.v y su banco diferencial contra InputDevice
    El bloque solo guarda STATE y la FIFO de 16; los eventos llegan formados del
    adaptador. input_vectors.hex lo genera tools/gen_input_vectors.py con el
    oraculo (7760 operaciones, con colisiones FLUSH/POP/CLEAR en el mismo ciclo).
2026-10-04 monitor.v: INPUT_EVENTS (0x3B) e INPUT_PRESENCE (0x3C) con HAS_INPUT
    Copia comun a las doce carpetas. Con HAS_INPUT=0 (todas menos la 30) los dos
    comandos contestan ff y la sintesis elimina sus estados. monitor_input_tb
    prueba el monitor contra el input_registers real, con lotes de 1 y 16, un
    lote mayor que los huecos y el monitor sin INPUT.
    Los bitstreams de las otras 11 carpetas quedan STALE por el cambio de texto.
2026-10-04 INPUT en la 30: top, decodificador, ventana del monitor, sysid y capacidades
    top.v instancia input_registers con HAS_INPUT, WINDOW4 (0x80600000) y monitor
    5.30 (la 30 es la unica con los comandos de INPUT; la 19 y la 21 siguen en 4).
    mmio_decoder gana el bloque INPUT con sus errores de direccion y de forma.
    DEVICES pasa de 0x237 a 0xA37: generate_sysid lo deriva de la nueva capacidad
    input_device, separada de input (que sigue siendo solo de simuladores, para que
    la placa siga omitiendo los guiones con tiempo en instrucciones).
    Bancos nuevos: mmio_input_ack_tb (cadena mux+decodificador+dispositivo) y
    cpu_input_tb (un programa lee INPUT alimentado por el monitor).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
    [cpu_input_tb.v, mmio_decoder.v, mmio_input_ack_tb.v, monitor.py, top.v]
2026-10-04 monitor.py input: teclado y raton del PC hacia INPUT, y documentacion
    tools/input_adapter.py es el adaptador: calcula los eventos con las reglas de
    InputDevice, respeta los huecos libres de la FIFO (teclas y botones esperan, el
    movimiento se funde) y al salir suelta lo pulsado y quita la presencia.
    screen_window.py gana --panel (solo captura, sin pantalla). El codec admite
    INPUT_EVENTS con cero palabras como sondeo. mmio.md 16.5 documenta el
    protocolo; README de la 30, tools y x.tests actualizados.
2026-10-04 30: semilla 6 tras INPUT (7 de 8 cumplen, 85,76 MHz) y documentacion generada
    El barrido de 8 semillas con tmg-ripup y timingweight=120 sobre el netlist con
    INPUT deja cumplir 7 y la mejor es la 6 (85,76 MHz, +7,2 % sobre los 80). Se
    regeneran los bloques gendoc, que ya estaban desfasados, y se documenta el
    mayor 5 del monitor.
2026-10-04 monitor.py input: ventana de captura de 640x480 (escala 1), no 1280x960
    SCREEN_SIZE ya es la salida HDMI (80x30 celdas de 8x16); con escala 2 la
    ventana salia al doble.
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2026-10-04 Simulador de CPU: DEVICES declara SYSTEM, CPU y los dispositivos conectados
    Antes contestaba 0 aunque llevara teclado y raton, asi que un programa que mire
    el bit INPUT (11) funcionaba en la placa y se paraba en el simulador (mmio.md
    17: mismo contrato).
2026-10-04 z.tui: teclado y raton por INPUT en la consola de la MiniCPU
    Actualiza el submodulo: backend console_mini.c con INPUT, teclado espanol,
    repeticion, puntero y doble clic, y redibujado parcial (tecla 451 -> 36 ms,
    movimiento de raton 324 -> 1 ms, medido en la placa).
2026-10-04 z.tui: redibujado por control (TUI_LOCAL) y sin repintar teclas no gestionadas
    Pulsacion en el cuadro Edit: 36 -> 17 ms en la placa (incluye el viaje serie);
    tecla que nadie gestiona: 1 ms.
2026-10-04 z.tui: redibujado parcial tambien para foco, clics y comandos ligeros
    Boton, checkbox y listbox repintan solo su rectangulo; TAB y clics repintan el
    control que pierde y el que gana el foco. En la placa, comparado con un
    redibujado completo, solo difiere el texto de la barra de estado.
2026-10-04 z.tui: un evento de raton sin gestionar ya no repinta toda la pantalla
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2026-10-04 z.tui: abrir y cerrar la lista del combo sin repintar toda la pantalla
2026-10-04 z.tui: invalidacion en vez de logica de repintado en la aplicacion
    demo.c vuelve a ser el original salvo tui_draw -> tui_draw_pending. Medido en
    la placa: tecla en un cuadro de texto ~17 ms, abrir/cerrar combo ~55-70 ms,
    raton sobre lista desplegada 2-4 ms, completo ~256 ms; la pantalla coincide con
    un redibujado completo salvo el puntero.
2026-10-04 monitor.py input: resincronizar el puntero de la placa al conectar
    El ratón de INPUT es relativo y el programa de la placa conserva su puntero
    entre sesiones, mientras que la ventana de captura supone que empieza en el
    centro: al salir y volver a entrar quedaba un desfase. InputAdapter.home()
    barre el puntero a (0,0), donde lo deja un programa que recorta su cursor, y de
    ahí al centro. run_session lo hace si la fuente declara su origen; --keep-pointer
    lo desactiva.
    Comprobado en la placa: tras una sesión que deja el puntero en el borde, el clic
    en el centro de la siguiente cae en el centro con home y fuera de todo sin él.
2026-10-04 monitor.py input: Ctrl+C sale limpio, como F12
    run_session captura KeyboardInterrupt y cierra por la via normal: suelta lo que
    siga pulsado y quita la presencia. Un segundo Ctrl+C durante el cierre deja de
    esperar al vaciado de la cola pero igualmente quita la presencia. La ventana de
    captura ignora SIGINT (la consola se lo manda igual que al monitor) y la cierra
    el monitor, en vez de morir con su propio traceback.
2026-10-04 Pruebas automaticas en la placa: BoardInput, guiones con expect y monitor.py screen
    - tools/board_input.py: BoardInput (tap, key_down/up, click(col, fila), screen,
    wait_for) con el puntero resincronizado y la cuenta de su posicion; Screen y
    read_screen para leer la pantalla de texto palabra a palabra (el bloque no vale
    para MMIO).
    - tools/board_script.py: guiones como los del simulador, con los instantes en
    milisegundos, mas click, moveto, expect y wait. Las acciones de teclado y raton
    corren sobre un dispositivo de sombra que genera los mismos eventos que el
    simulador; la presencia sale antes de los eventos al conectar y despues al
    desconectar. Se comprueba entero al cargar, y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
2026-10-04 z.tui: los rectangulos sucios se funden en vez de repintar todo; tui_invalidate_frame
2026-10-04 Combo: el triangulo apunta arriba con la lista abierta; el lector de pantalla ve los dibujos
    tools/board_input.py: los codigos 1..31 y 127 de la pantalla son dibujos del CP437
    del PC original (caras, flechas, triangulos), no caracteres de control como los
    trata el codec de Python; Screen.row ahora los devuelve como tales, de modo que
    un guion puede comprobar "▲" y "▼".
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2026-10-04 z.tui: los comandos se ejecutan dentro de tui_dispatch (tabla registrada en el escritorio)
2026-10-04 z.tui: tui_remove limpia lo que el subarbol retenia (detach); el doble clic tambien pulsa
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2026-10-04 z.tui: los menus invalidan solo lo que cambian y la demo siempre tiene pantalla activa
2026-10-04 z.tui: el popup de los menus repinta solo las dos filas que cambian
2026-10-04 z.tui: el popup de los menus repinta solo el texto de las dos filas, sin el borde
2026-10-04 z.tui: el repintado parcial empieza desde el control opaco que cubre la region
2026-10-04 board_script: dejar de esperar por tiempo lo que se puede mirar
    Cada comprobacion dormia 150 ms de asentamiento antes de leer y 100 ms entre
    lecturas, y leer una fila ya cuesta ~160 ms (80 palabras a ~2 ms: la latencia del
    USB-serie; el monitor no encadena peticiones, probado, y rechaza los bloques sobre
    la RAM de texto).
    - wait lee primero y no duerme antes ni entre lecturas (20 ms de sondeo). Una
    condicion `absent` conserva el asentamiento: la ausencia no se confirma viendo
    algo.
    - expect contains/is mira en cuanto la placa consumio lo enviado y, si no esta,
    sigue hasta 4 x settle (con settle=0, una sola lectura, como en los tests).
    expect absent espera settle y mira una vez, como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
2026-10-06 Bump y.lcc: constantes enteras de 64 bits en el front end
    Los literales LL/ULL se leen y el plegado de constantes ya no pierde la mitad
    alta en una build de 32 bits de rcc (Value pasa a long long). Test 162.
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2026-10-06 Bump y.lcc: bandera unica de llamada oculta, producto ancho y runtime mas pequeno
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2026-10-06 z.tui: fine redraw for the text area focus and the window frame
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2026-10-06 GETID family and per-warp LOGICAL_WARP_ID / WARP_ARG
    ISA: GETID (opcode 0x30) selects GETTID/GETLANE/GETWARP/GETLWARP/GETARG
    with the type in the Y field; type >= 5 is ERROR_INVALID_ENCODING.
    GETLWARP replaces the old GETWID (warp_user_id). MMIO: GPU WARPS gets the
    LOGICAL_WARP_ID (+0x200) and WARP_ARG (+0x280) arrays (mmio.md 14.2).
    Assembler: the GETID mnemonics, and ANDI/ORI/XORI now resolve .equ and
    label arithmetic like MOVI/ADDI/LOAD do.
    Simulators 11 (functional) and 25 (cycle model): GETID, logical_warp_id and
    arg per warp, accepted by --config; 11 also gets 8/16-bit accesses. The
    25 pipeline is checked differentially against 11.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
2026-10-06 x.tests: gpu_ids capability and a GETID conformance case
    New gpu_ids capability, declared by the two GPU simulators and without
    RTL detection (the RTL only has GETTID, so the case is skipped on the
    board). The runner rejects a warps.json that uses logical_warp_id or arg
    without requires: ["gpu_ids"]. New case cases-gpu/extensions/gpu-ids/
    getid-family, run on gpusim and gpusim-cycle.
2026-10-06 32.cpu-gpu-func-sim: CPU + GPU functional simulator over shared RAM
    MiniCPU (2) and MiniGPU (11) on one RAM with the MMIO v2 map and per-master
    permissions. They synchronise only through the GPU MMIO (WARP_START,
    WARP_LIVE, WARP_DONE, GPU_STATUS), by polling. Single .asm images, trace
    with CPU/GPU prefixes, per-core run limits, tools/cpugpusim launcher.
    docs/diseno-gpu-dma.md designs the GPU as a DMA/blitter; the needs found on
    the way are in docs/necesidades-detectadas.md. examples/dma is the minimal
    harness for that protocol: gpu_run (validate, descriptors, WARP_START, poll
    with W1C, fault and timeout recovery) plus memset/memcpy kernels, tested in
    test_cpu_gpu_sim.py.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
2026-10-06 29: GETID family and 8/16-bit memory accesses in the RTL
    GETID: gpu_lane decodes opcode 0x30 with type 0..4 (GETTID, GETLANE, GETWARP,
    GETLWARP, GETARG); a type above 4 is ERROR_INVALID_ENCODING. gpu_sm keeps
    LOGICAL_WARP_ID[n] and WARP_ARG[n] per warp and copies them into X on
    entry. gpu_system_bl8 decodes them at +0x200 / +0x280 of GPU WARPS (eight
    words each), host read/write with the core halted. The monitor window for GPU
    WARPS grows to 0x820102A0 in top_bl8.v and monitor.py.
    Sub-word: the SM dispatches LOADB/LOADUB/STOREB/LOADH/LOADUH/STOREH to the
    LSU with size and sign. The store data is replicated across the word lanes and
    the LSU builds the byte mask from the address; loads pick t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
    [gpu_fault_tb.v, gpu_lsu2_tb.v, gpu_scheduler_tb.v, gpu_sm.v, gpu_system_bl8.v, gpu_system_bl8_tb.v, monitor.py, top_bl8.v]
2026-10-06 tools: gpu_ids and GPU subword_memory capabilities, warp id arrays
    capabilities.json: gpu_ids is now detected in gpu_lane.v, and subword_memory is
    declared for CPU and GPU (cpu.v or gpu_sm.v). make_rtl_fixtures writes
    NN.ids.hex (LOGICAL_WARP_ID and WARP_ARG per warp), and WarpMixin writes the
    two arrays through the monitor when a warp has them.
    generate_docs: the capability tables compared architecture with !=, which
    dropped every capability declared for a list of architectures (video, mul_div,
    frame_capture...) and now subword_memory. It uses capability_architectures.
    Regenerated docs/resumen-prototipos.md and docs/synthesis-report.md.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
2026-10-06 x.tests: GPU extension cases for GETID and sub-word access
    New cases-gpu/extensions: getid-8warps and lane-bytes-halves are RTL
    differential (all registers, memory and the two warp arrays), getid-reserved-type
    checks error 0x05, and misaligned-halfword and mmio-byte check the faults. Run on
    the simulators and on the 29 board: 72 cases, 0 failures. The expected memory
    of the two dumps was checked against an independent calculation.
    bank-conflicts dumped words it never writes and expected zero, which only held
    while nothing dirtied that area; on the board the SDRAM is not initialised, and
    lane-bytes-halves left 0x90 at 0x1004. It declares zero initial memory now.
    The same for the two new case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
2026-10-06 32: mark GETID and sub-word RTL as done, record what the board showed
    N3, N4 and N6 are done in the 29 RTL and tested on the board. New notes: N5
    (the 29 clears the two arrays with its only reset), N10 (a warp cannot read
    SYSTEM in the 29, against mmio.md 15) and N11 (the monitor does not expose the
    fault address, so the memory-fault cases are skipped on the board).
2026-10-06 TODO: what is left after GETID and sub-word access in the 29
    Section 16: fault.address as optional with an explicit marker, SYSTEM read from a
    warp (to be done together with GPU CORE), the two reset semantics, the byte
    merge in the LSU (measure first), router2 --threads on a copy, the other GPUs,
    NEW-ASSM, and the dependency chain towards the CPU+GPU runtime.
2026-10-07 Añade 35.fpga-cpu-fifo-sdram2: controlador SDRAM con cuatro bancos en paralelo
    Parte de la 34. El controlador tiene un slot por banco, ACTIVE adelantado,
    READ/WRITE en orden de llegada y salidas registradas; el fabric pasa a un
    backend en tubería con FIFO de destinos en orden y créditos.
    En simulación: 8,19 ciclos por petición alternando bancos (17,21 en la 34).
    Timing con semilla 12: 102,8 MHz memoria, 84,95 MHz CPU; el barrido de 1 a 8
    no cierra ninguna semilla, así que el margen es corto.
2026-10-07 33.fifo-mem: respuestas en orden con FIFO global y propuesta del pipeline
    Actualiza el fabric de seis puertos (router de respuestas registrado, colas
    globales de comandos y respuestas), añade su banco de pruebas y la propuesta
    de evolución del subsistema de memoria.
2026-10-07 Añade 34.fpga-cpu-fifo: CPU y scanout sobre el fabric FIFO de seis puertos
    Integra la CPU y el scanout de la 30 sobre el fabric de la 33, con dos
    generadores de tráfico sostenido. Monitor 5.34, CPU a 80 MHz y fabric y
    SDRAM a 100 MHz.
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2026-10-07 Reproduce los guiones de INPUT en la placa por el monitor
    Las versiones con input_device declaran también input: el backend cpu-fpga
    ejecuta el guion sobre un dispositivo sombra y manda sus eventos y su presencia
    con INPUT_EVENTS e INPUT_PRESENCE, con control de flujo. Se conserva el orden de
    los eventos, no su instante en instrucciones, así que solo valen los casos cuyo
    programa sondea STATUS.COUNT. Probado en la 35: input-keys-and-mouse pasa.
2026-10-07 test_capabilities: perf_stalls ya lo tiene la familia de la 30 (30, 34, 35)
2026-10-07 35: intento de pulido de timing (no mejora, no cierra con ninguna semilla)
    mmio_decoder: error de direccion en paralelo con rangos como bits
    (equivalente al anterior en 1.31M direcciones). sdram_controller_128:
    captura de rdata one-hot, wr_free y ref_wait registrados. Simulaciones
    OK; barrido semillas 1-8 y 12: 0 de 9 cumplen (mediana CPU 68.5 MHz,
    mem 95.0 MHz; antes 68 / 93.6, y la 12 cerraba).
    [mmio_decoder.v, sdram_controller_128.v]
2026-10-07 35: registrar la finalizacion antes de rsp_data_mem
    `complete` habilitaba 129 bits de rsp_data_mem en combinacional y cruzaba
    media FPGA. Ahora rp_valid/rp_port/rp_data capturan un ciclo antes. Tests OK.
    Barrido de 24 semillas con tmg-ripup + placer-heap-timingweight=30: cumplen
    3 (6, 21, 24); mediana CPU 74.4 MHz, memoria 101.9 MHz. Mejor: la 24
    (81.13 / 104.38).
2026-10-07 timing-wall --path: camino critico completo con fichero, linea y distancia
    Con el diseño aplanado el muro sale como (anonimo) y el informe detallado de
    nextpnr no permite reconstruir el camino de cada destino. critical_paths si
    trae el camino completo: se enseña salto a salto con la red, su fuente, la
    distancia recorrida y el reparto logica/ruteo. Tests y seccion en el README.
2026-10-07 35: semilla 17 con tmg-ripup y timingweight 30; README con el barrido
    Build real: CPU 83.21 MHz (80), memoria 107.35 MHz (100). Barrido de 24
    semillas sobre el RTL nuevo: 11 de 23 terminadas cumplen. En placa: 57 casos
    (basics, alu, errors, extensions, programs, video, demos), 0 fallos.
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2026-10-07 TODO 17: la validacion de bloques del monitor limita el reloj de CPU de la 35
    Solo apunta el hallazgo (timing-wall --path, semilla 24) y el arreglo
    propuesto; no se ha tocado RTL.
2026-10-07 36: WIP hito 1, CPU lanza la GPU por MMIO (GPU CORE)
    Copia de la 35 con gpu_system, gpu_mmio_bridge y el dominio de reloj de la GPU.
    Verificado en simulacion; sin enrutar todavia (71 % de LUT). apio.ini con
    -nowidelut y timingweight 120. README y version.json siguen siendo los de la 35.
2026-10-07 36: gpu_sm mas pequeno (-2,3k LUT4) y arreglo del acarreo entre lanes
    lsu_address era UN sumador de 256 bits: el acarreo de la lane n entraba en la
    n+1, y un offset negativo daba una direccion de mas. Ahora son ocho de 32 bits.
    Planificador por vector de elegibilidad, same_group con 28 comparadores,
    generation de 1 bit y bar_mismatch fuera del bucle. gpu_sm: 13.502 -> 11.189
    LUT4 con -nowidelut.
    gpu_barrier_tb: cuatro warps con BAR, divergencia y STORE de offset negativo.
    Con el gpu_sm anterior acaba en error; con solo el sumador arreglado pasa.
    [gpu_sm.v]
2026-10-07 29: lsu_address por lane (el acarreo de una lane entraba en la siguiente)
    d_rf_a+{8{d_immediate}} era un sumador de 256 bits. Con un offset negativo la
    lane n+1 sumaba uno de mas. 12, 14, 17 y 22 ya sumaban por lane; la 32 es un
    simulador y no tiene RTL. Pasan gpu_scheduler_tb, gpu_fault_tb y gpu_smoke_tb.
    Hay que reconstruir el bitstream de la 29.
2026-10-07 x.tests: caso gpu-negative-offset (LOAD/STORE con desplazamiento negativo)
    Cubre el acarreo entre lanes de lsu_address de la 29. Pasa en gpusim y
    gpusim-cycle; en el RTL anterior al arreglo debe fallar.
2026-10-07 TODO 16.10: acarreo entre lanes de lsu_address en la 29, falta verlo en placa
2026-10-07 36: dos muros de timing (monitor.v y issue_go del fabric) y alias cpugpu
    - monitor: STATE_CHECK_BLOCK registra el veredicto del bloque (block_ok) antes
    de actuar; el camino de 14 LUT desde block_end_address limitaba la CPU a
    69,7 MHz (TODO 17). Un ciclo mas por comando de bloque.
    - fabric: cmd_pop = !issue_valid && !cmd_empty. issue_go ya no arrastra
    sdram_req_ready a los ~200 enables de backend_*; sdram_clk estaba en 93,7 MHz.
    El controlador no baja de 8,2 ciclos por peticion, asi que el hueco no se nota.
    - version.json: alias cpugpu.
    Pasan monitor_tb y mmio_monitor_tb (de la 30) y memory_fabric_fifo_6_tb.
    [monitor.v]
2026-10-07 36 apio.ini: sin --tmg-ripup para que el router termine
    Con ripup, router1 no acabo en 2,5 h (gpu-36) ni en 1,5 h (gpu-36-bram). Sin
    el, termino en 20 minutos y dio el informe con los caminos criticos.
2026-10-08 36 sdram_controller_128: seleccion de ACTIVE en paralelo y one-hot
    El camino critico de la 36 (semilla 7: sdram_clk 85,5 MHz) era la candidata a
    ACTIVE: cadena serie act_found -> act_bank -> mux 4:1 de 13 bits -> sel_row
    (13 LUT, 11,7 ns). Ahora elegibilidad, banco y fila de cada posicion se calculan
    a la vez y la primera elegible las selecciona (AND-OR). Mismos ciclos que antes
    en sdram_bank_parallel_tb (1048/1576/1176), mismo instante de fin.
2026-10-08 build-list --prototypes: un test fallido ya no tapa el ultimo build (TODO 15)
    prototype_build_summary ignora los registros de etiqueta `test` al elegir el
    ultimo build, salvo si siguen en marcha. La 34 salia FAILED por un lint del
    7/10 con la sintesis y el timing bien. Dos tests nuevos. 36 apio.ini: semilla 7.
2026-10-08 build-list --prototypes: todos los relojes de cada prototipo
    La columna FMAX/REQ solo enseña el reloj que limita. Con mas de un reloj, debajo
    va una linea con todos (el que no cumple lleva "!" y sale en rojo). Un test.
2026-10-08 build-list --prototypes: un reloj por linea, alineado con CLOCK y FMAX/REQ
    Columna CLOCK nueva. El reloj que limita va en la fila del prototipo; el resto,
    debajo, en las mismas columnas y con su PASS/FAIL en TIMING.
2026-10-08 build-list --prototypes: un solo FAIL general y el valor que no cumple en rojo
    Las lineas de los demas relojes ya no llevan PASS/FAIL; el veredicto es el de la
    fila del prototipo. En rojo sale el FMAX/REQ del reloj que no cumple. Un test.
2026-10-08 36 memory_fabric_fifo_6: arbitro en paralelo (dos pasadas a la vez, sin cadena)
    El camino critico de la semilla 5 (sdram_clk 95,5 MHz) era head3_valid -> grant:
    11 LUT en serie por los dos case(rr_next) con cadenas if/else if. Ahora las
    pasadas de urgentes y de todas se calculan a la vez con una funcion (mascara
    de rotacion + prioridad) y solo al final se elige una. Equivalencia exhaustiva
    con el bloque antiguo: 4374 combinaciones alcanzables, 0 diferencias.
2026-10-08 36 memory_fabric_fifo_6: issue_go solo limpia issue_valid; el empuje a meta, un ciclo despues
    issue_go depende de sdram_req_ready, que sale de la FSM del controlador, y
    alimentaba la escritura de meta, su contador y el de creditos: fan-out 32-51 y
    2,6-3,3 ns de ruteo. Era el muro de sdram_clk de la 36 en las semillas 3 y 7.
    Ahora se registra en go_q y el empuje ocurre un ciclo despues, con backend_port
    e issue_error aun intactos. Un done tarda >= 4 ciclos y el siguiente issue_go
    >= 2, cuando outstanding ya cuenta la peticion. busy incluye go_q.
2026-10-08 36 text_console: el enable de font_ram ya no cuelga del sumador de FONT_COUNT
    loader_range_valid (loader_glyph + write_data[8:0] <= 256) solo importa al
    escribir FONT_COUNT, pero formaba parte de font_error, que gobierna toda la
    escritura de fuente. El enable de font_ram (FONT_DATA3) esperaba al sumador sin
    usarlo: camino critico de la CPU en la 36, 14,0 ns, write_data con fan-out 63
    (4,1 ns de ruteo), 71,3 MHz. Ahora el error "de siempre" va aparte y FONT_COUNT
    se comprueba dentro de su rama. Mismo comportamiento: text_console_tb de la 30
    pasa igual con el mismo instante de fin.
2026-10-08 build-clean: un solo comando limpia logs y reports de cada prototipo
    Sustituye a build-clean-logs (sin alias). Ademas de los logs de ejecucion,
    aligera <prototipo>/reports/: conserva completos los --keep-reports (2) mas
    recientes, el ultimo que cumplio timing y los que no tienen metadata.json
    (build en curso); en el resto borra hardware.json/.config/.pnr y sweep-*, o la
    carpeta entera con --full. Dry-run en seco: libera ~11,8 GB. Test nuevo.
2026-10-08 apio.ini de 16, 21 y 33: semillas que cierran timing tras re-barrer
    16: semilla 9 (sdram_clk 103,1 MHz; 5 de 12 semillas cumplen con el monitor
    actual). La 13 anterior daba 94,8 tras el cambio de monitor.v.
    21: semilla 6 (sdram_clk 81,1 / 80, margen fino; 2 de 12 semillas cumplen).
    33: --tmg-ripup y --placer-heap-timingweight 120 con semilla 12 (104,6 / 100).
2026-10-08 build-sweep --promote SEMILLA: convierte una semilla del barrido en bitstream sin sintetizar
    Tras --apply el apio.ini cambia y el bitstream queda STALE aunque la semilla
    buena ya este enrutada en el barrido. --promote empaqueta ese hardware.config
    con ecppack, lo archiva como build (promote-seedN, con .bit y sources.zip) y lo
    copia a _build/<env>/, de modo que el prototipo vuelve a ser CURRENT. Se niega
    si el RTL cambio desde el build barrido, si el apio.ini no lleva la semilla y
    las opciones con las que se barrio, o si la semilla no cumple timing.
    Comprobado en la 16: el .config y el .bit promovidos son identicos byte a byte
    a los de un build completo con --seed 9. configured_options sale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
2026-10-08 test_sweep_promote: la semilla ajena necesita su carpeta para llegar al chequeo del apio.ini
2026-10-08 36 video_registers: cada registro comprueba su condicion, no el error global
    La escritura de registros se habilitaba con `!error`, y `error` es un case sobre
    la seleccion de registro con la mezcla por bytes y el alineamiento dentro. Cada
    habilitacion colgaba de la seleccion dos veces: 12 LUT desde mmio_address[6] y
    camino critico de la CPU en la 36 (13,0-14,2 ns, 70-77 MHz en las semillas
    1..5). Ahora FB_FRONT, FB_BACK, CONFIG y CTRL llevan su propia condicion (los
    demas no tenian error). Mismo comportamiento: 400.000 ciclos aleatorios contra
    la version anterior, sin ninguna diferencia en lectura, error, modo, fb_base,
    underflow_clear, halt_request ni text_enable.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
    [video_registers.v]
2026-10-08 build-sweep: --promote unifica --apply y la promocion; tabla de mejor semilla por reloj
    Una sola opcion para adoptar una semilla. --promote sin valor elige la que
    cumple con mas margen; --promote N, esa (si cumple todos los relojes). Con
    --seeds actua al terminar el barrido; sin --seeds, sobre uno ya hecho (--from).
    Escribe la semilla y las opciones con que se midio en el apio.ini, empaqueta el
    .config con ecppack y deja el build archivado y _build/ listo. Si falla el
    empaquetado, el apio.ini vuelve a como estaba. --apply desaparece (sin alias).
    Al final del barrido se imprime la mejor semilla de cada reloj, marcando la de
    mas margen global, para decidir a mano cuando discrepan (p. ej. deja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
2026-10-08 36 mmio_decoder: cada dispositivo se registra antes del mux de lectura (EXTRA_CYCLES 3)
    La lectura de un dispositivo es combinacional desde la direccion (el case de
    video_registers, los rangos de la consola, el OR de top.v) y el mux del
    decodificador se le sumaba en el mismo ciclo: once LUT desde mmio_address[4]
    hasta mmio_decoder_i.read_data, 12,97 ns y el camino critico de la CPU en la 36
    (77,1 MHz). Ahora read_data y error de cada dispositivo se registran en el mismo
    ciclo en que antes se muestreaban, y el mux sale un ciclo despues; mmio_mux
    espera uno mas. Cada dispositivo se lee con el mismo estado que antes, asi que
    no cambia ningun valor ni error; cambia la latencia de un acceso MMIO,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
    [mmio_decoder.v]
2026-10-08 36 mmio_bus_tb: banco del bus MMIO entero, con el resultado esperado
    Monta mmio_mux, mmio_decoder, video_registers, text_console, serial_port,
    input_registers, cpu_perf_counters y una GPU simulada, y comprueba read_data y
    error de 96 accesos en el ciclo del ack (lecturas, escrituras, errores de dato y
    de direccion, mascara parcial, dispositivo lento). El esperado
    (sim/mmio_bus_expected.hex) sale del decodificador anterior a registrar la
    salida de cada dispositivo, asi que prueba que esa etapa solo cambio la
    latencia. Con el decodificador nuevo y el mux de dos ciclos falla, como debe.
2026-10-08 36 gpu_mmio_bridge_tb: el puente con 80 y 25 MHz sin relacion de fase
    Simula el protocolo que sigue mmio_mux con un dispositivo lento (datos estables
    antes del start y hasta el done) contra una GPU que contesta a los 1..4 ciclos
    de gclk, con la fase de gclk como argumento (+phase=N). 300 accesos por fase
    comprueban un done de un ciclo por acceso y ninguno suelto, lectura y error del
    acceso correcto aunque el siguiente cambie direccion y dato enseguida, y una
    peticion vista por la GPU por acceso. Pasa en 8 fases distintas.
2026-10-08 36 top: el reset se reparte en cuatro copias (monitor, CPU, bus MMIO, video)
    Con la etapa de lectura del bus, el camino critico de la CPU dejo de ser el
    MMIO y paso a ser la red de reset: 8,5 ns de ruteo, distancia 154, desde `reset`
    hasta el FSM de la CPU, 74,6 MHz. Un solo reset llega a todo el chip. Ahora hay
    cuatro copias registradas con la misma condicion que reset_shift[15] (mismo
    instante, mismo valor) y `keep` para que la sintesis no las fusione; el reset
    original queda para el fabric y los puentes. No cambia el comportamiento.
    [top.v]
2026-10-08 build-list: las columnas se alinean con cualquier ID
    El ancho de ID era fijo (28) y un ID con etiqueta larga desplazaba el resto de
    su fila. Ahora el ancho de cada columna sale de la fila mas larga. La tabla vive
    en format_build_list para poder probarla.
2026-10-08 32 examples/render: a plasma drawn by the GPU, frame loop on the CPU
    The CPU sets up two framebuffers and SCANOUT, and each frame launches 8 warps
    through the examples/dma runtime, waits, requests the SWAP and waits for it.
    64 threads paint an 80x60 mosaic of 4x4 pixel cells with three branch-free
    triangle waves (one per RGB565 channel); only the 4 spare threads diverge.
    test_cpu_gpu_sim compares both buffers pixel by pixel with a Python model.
2026-10-08 build-list --prototypes: el ancho de cada columna sale de sus valores
    Prototipo, bitstream, estado, timing, semilla, reloj, fmax, duracion y fecha
    tenian anchos fijos, y un nombre de prototipo o de reloj mas largo desplazaba el
    resto de la fila (y los relojes de las lineas siguientes). Ahora cada columna
    mide su valor mas largo. Test con un prototipo y un reloj largos.
2026-10-08 mini-dbg TUI: help in a floating window
    F1 (or ?, or typing help) opens a modal with the keys, the per-panel keys, the
    commands grouped by topic and what the colours and marks mean. It only shows
    what the target has, and the keys come from the app's own bindings. Line mode
    still prints the plain list.
2026-10-08 36 top: reset_mem en dos copias (controlador SDRAM y fabric)
    Con las copias del reset de la CPU la 36 llega a 81,3 MHz en clk, pero sdram_clk
    cae a 94,7: su camino critico es ahora la red reset_mem, 7,7 ns de ruteo con
    distancia 141 hasta un FSM. Dos copias registradas con la misma condicion que
    reset_mem_shift[15] (reset_ctl para el controlador, reset_fab para el fabric y
    la parte de memoria de los puentes) y keep contra la fusion. No cambia el
    comportamiento.
    [top.v]
2026-10-08 32 examples/render: the same plasma drawn by the CPU alone
    render_cpu.asm paints the identical image byte for byte (the test checks it
    against the Python model both versions share) with the same arithmetic and
    cell mosaic, as the reference to measure what the GPU brings: 42 instructions
    per cell, about 203,000 per frame.
2026-10-08 32 examples/render: v2 with coalesced stores
    render_v2.asm paints the same image (same tests, byte for byte) but a whole warp
    paints a row of cells and its 8 lanes write 8 consecutive words, 32 contiguous
    bytes: 9,600 LSU transactions per frame instead of 38,400. In the cycle model
    the frame goes from 654,550 to 209,999 cycles and from memory-bound (X 16%) to
    compute-bound (X 95%, shifters). render.asm is kept to compare.
2026-10-08 36 README: reescrito para esta carpeta; apio.ini con la semilla real
    El README era una copia del de la 35. Ahora cuenta lo que es la 36: la CPU que
    lanza una GPU de 8 carriles por MMIO (relojes, puertos del fabric, GPU CORE y
    limitaciones del hito 1, bus MMIO segmentado y puente, memoria, los seis muros de
    timing en el orden en que aparecieron, resultados del 8 de octubre, validacion y
    pendientes). Dice sin rodeos que no esta probado en placa.
    El comentario del apio.ini hablaba de la semilla 17; la que vale es la 7. Solo
    cambia un comentario, asi que el bitstream se re-archivo con build --archive-only
    en vez de volver a rutar 40 minutos.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
2026-10-08 TODO 18: tiempo maximo en el acceso MMIO a la GPU (36); 17 ya arreglado en la 36
2026-10-08 32 examples/render: board variants with RUN runtime and cycle counters
    The 36 board RTL (milestone 1) has no WARP_START, so gpu_runtime_board.inc
    launches with RUN. render_board / render_v2_board / render_cpu_board reset
    the GPU at start and accumulate per-frame paint cycles in R22 (read with
    monitor.py halt + read-register). Measured at 80 MHz: CPU alone 41.0 ms,
    GPU v1 27.1 ms, GPU v2 13.2 ms per frame.
2026-10-08 32 examples/render: whole-frame cycle counters on board, measured table
    Board variants now also count the whole frame (R29) and discard frames that
    cross a monitor halt (R19 valid frames), which had inflated the first
    numbers. Board results at 80 MHz: CPU alone 54.2 ms paint / 14.8 fps, GPU v1
    27.2 ms / 29.8 fps, GPU v2 19.6 ms / 29.8 fps (video 59.5 Hz).
2026-10-08 37 (mk2): copia de la 36 cuando cierra timing, para trabajar sin tocar la 36
    Misma base que la 36 (78 ficheros versionados), con lo que identifica a la
    carpeta: numero 37 en sysid_params.vh (generado), monitor 5.37, alias mk2, README
    que dice que hacer aqui (margen en el controlador SDRAM, hito 2 de GPU CORE) y un
    apio.ini que avisa de que la semilla de la 36 es solo de partida: otro numero de
    carpeta es otro netlist. test_sysid_params conoce la carpeta; capabilities.json
    solo cambia un comentario (gpu_core la tienen la 36 y la 37). mmio_bus_tb y
    gpu_mmio_bridge_tb pasan tambien aqui.
2026-10-08 32 examples/race: Game of Life, CPU vs naive GPU vs well-laid-out GPU
    Shared host (race_host.inc) rotates three methods every N frames over the
    same state, with a per-frame timing chart in the top 32 lines. life.inc has
    the CPU routine and two GPU kernels (one thread per row vs one warp per row
    with lanes on consecutive columns). On the 36 board, per generation of
    160x104 cells: CPU 172.7 ms, naive GPU 138.7 ms, coalesced GPU 45.1 ms.
    Tests check all three methods against a Python Life reference and the chart.
2026-10-08 32 examples/race: heat diffusion and rotating texture demos, README table
    Same host and three-method rotation as the Life demo. On the 36 board, per
    frame: blur CPU 190.9 / naive GPU 138.7 / coalesced GPU 45.4 ms; rotate CPU
    42.0 / 29.5 / 12.2 ms (rotation is a gather, only the stores coalesce). Tests
    compare all three methods against Python references of the whole image.
2026-10-08 37: la GPU gana SLT y SLTU (0x26, 0x27)
    La lane reutiliza la resta registrada y STATE_BRANCH_COMPARE de los saltos
    (branch_kind 6 y 7): en lugar de decidir un salto, escribe 0 o 1 en Rd y va
    directa a RETIRE. Sin estados nuevos ni registros nuevos; la codificacion es la
    de tipo R (los 11 bits bajos a cero, ERROR_INVALID_ENCODING si no).
    gpu_alu_tb.v es el banco para estas instrucciones y las que vengan: 4 warps de 8
    lanes ejecutan sim/kernel_alu.hex sobre 32 pares de operandos de borde y el banco
    compara cada tabla de resultados con lo que calculan los operadores de Verilog.
    Con la lane anterior falla (la GPU para con error); con la nueva pasa, igual que
    gpu_system_tb y gpu_barrier_tb.
    Co-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
2026-10-08 32 examples/race: textured solid cube, orthographic, two-axis rotation
    CPU computes the rotation matrix and, per visible face, six affine
    coefficients (one division per face and axis). Each cell tests the three faces
    with one unsigned compare per coordinate and gathers the texel; lanes of a
    warp can diverge per cell. Six procedural 64x64 textures with a black border.
    On the 36 board: CPU 89.6 ms, naive GPU 27.4 ms, coalesced GPU 15.6 ms.
    Tests compare all three methods against a Python model of the whole image.
2026-10-08 37: la GPU gana MULHI, DIVU, REM y REMU (0x0B, 0x0D, 0x0E, 0x0F)
    MULHI reutiliza el camino de MULFX (magnitudes, producto de 64 bits, signo al
    final) y solo cambia la ventana de salida: [63:32] en lugar de [47:16], con el
    mismo redondeo de la negacion. Un registro nuevo, multiply_high.
    Los cuatro del divisor comparten el camino de DIV. Los dos bits bajos del opcode
    dicen que variante es: el bit 0 pide operandos crudos (unsigned) y el bit 1 pide
    el resto en lugar del cociente. El signo del resultado es a^b para el cociente y
    el del dividendo para el resto. La division por cero para con
    ERROR_DIVISION_BY_ZERO en las cuatro. Dos registros nuevos de un bit.
    El resto desplazado sigue siendo de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
2026-10-08 37: la GPU gana JAL, JALR y JR (0x2C, 0x2D, 0x2E)
    Lane: igual que la CPU. El enlace es el pc ya adelantado, los operandos se leen
    antes de escribirlo (Rd = Ra funciona) y en los saltos indirectos se descartan los
    dos bits bajos del destino. JAL exige Ra = 0 y JR exige Rd = 0 e imm16 = 0.
    SM: JAL cambia el pc del warp a x_branch_target, que el packet ya traia calculado
    con el imm16. JALR y JR sacan el destino de `lane_pc`: cada lane lo deja alli al
    confirmar el salto, y el warp solo sigue si todas las lanes activas coinciden. Si
    alguna llega a otro destino, el SM para con ERROR_SIMT (0x06) en lugar de
    serializar en silencio: no hay un destino que apilar en la pila de divergencia.
    Un warp con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
    [gpu_sm.v]
2026-10-08 32 examples/dma: fill_rect and blit kernels, CPU vs GPU benchmark on the 36
    gpu_k_fill_rect and gpu_k_blit (one warp per row, lanes on consecutive words,
    SSY for the partial last pass), tested with awkward geometries. bench_dma
    measures memset/memcpy/fill_rect/blit for 32 B..1 MiB on the CPU and the GPU
    with 1/2/4/8 warps; bench_dma_report.py reads the table from the board. Result
    (docs/bench-dma.md): GPU wins only memcpy/blit (1.2-1.3x, from ~4 KiB) and
    loses memset/fill_rect (0.65-0.70x); launch costs ~40 us + 9 us per warp.
2026-10-08 32 examples/dma: experiment shows CPU polling does not slow the GPU
    poll_exp launches memset/memcpy of 256 KiB with 1..8 warps and waits three
    ways (continuous polling, paced polling, no MMIO access until done), measured
    with the GPU's own perf counters. GPU cycles are identical within 0.03%, so
    polling is not why a 16 B transaction costs ~38 GPU cycles (30 for memcpy)
    instead of the model's 17. STALL_MEM stays 0 (it only sees request
    back-pressure). Documented in docs/bench-dma.md.
2026-10-08 32 examples/dma: GPU is bound by instruction rate (~12.7 cycles/warp instr)
    lat_exp measures one isolated access with one lane: 14 extra GPU cycles for a
    load or store, the same for strides from 0 to 64 KiB, so SDRAM rows are not
    the limit. The no-access baseline costs 14.4 cycles per retired warp
    instruction with one warp, and memset with 8 warps settles at 12.7 (49k
    instructions in 628k cycles). 3 instructions per 16 B transaction x 12.7 =
    the ~38 cycles/transaction ceiling. poll_exp now also records retired
    instructions and IMEM misses. docs/bench-dma.md rewritten accordingly; the
    earlier claim that the kernels are not the limit was wrong.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
2026-10-08 x.tests: SLT, SLTU, MULHI, DIV*, REM* y JAL/JALR/JR tambien en la GPU
    Capacidades: compare, calls y alu_extended pasan a ser de las dos familias en
    capabilities.json, con gpu_lane.v como fichero alternativo. La 29 sigue sin
    declararlas y la 37 las declara por el `case` de cada instruccion.
    Simulador cycle (25): aprende JAL, JALR y JR y anuncia `calls`. Un indirecto con
    destinos distintos entre lanes da ERROR_SIMT, como gpu_sm.v. Sus tests pasan.
    Casos compartidos CPU/GPU, con lo esperado calculado en Python y no en un
    simulador: compare/slt-sltu, alu-extended/mulhi-div-rem, tres *-by-zero y
    calls/call-return. Pasan en cpusim y en gpusim-cycle; en gpusim (current) se
    omiten por capacidad. c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
2026-10-08 Hito 2 de GPU CORE: reglas de lanzamiento y banco que las comprueba
    mmio.md 14.1 gana la seccion "Reglas de lanzamiento", que cierra lo que el texto
    dejaba abierto: descriptor y estado de ejecucion son cosas distintas (RUN y
    WARP_START copian el primero al segundo; leer un descriptor devuelve siempre lo
    escrito), escribir el descriptor de un warp solo es error si ESE warp esta vivo,
    WARP_START es todo o nada, en reposo pone la GPU en RUNNING y con la GPU parada
    deja el warp vivo y en pausa, y RESET pone a cero WARP_LIVE y WARP_DONE pero
    conserva descriptores, LOGICAL_WARP_ID y WARP_ARG. 14.2 se alinea.
    37.fpga-cpu-gpu-mk2/gpu_core_tb.v prueba esas reglas en siete bloques, con dos
    kernels (s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
2026-10-08 36 sim: instr_rate.py mide ciclos por instruccion de warp en el RTL; 32 docs: corregido el limite
    El SM no retira una instruccion cada 12,7 ciclos: el coste depende del tipo
    (ALU 7, salto 9, SHL 7+n, MUL 11, memoria ~20) porque la etapa X es una FSM
    sin segmentar y las de memoria no se solapan con las de ALU. bench-dma.md
    queda corregido y la estimacion del memset desenrollado, rebajada a ~20 MB/s.
2026-10-08 36 sim: instr_rate.py acepta --rtl para medir cualquier prototipo (36, 37, ...)
2026-10-08 37: hito 2 de GPU CORE en el RTL (WARP_START, RESET que conserva, descriptores)
    gpu_sm.v guarda el DESCRIPTOR de cada warp (desc_pc, desc_active, desc_groups)
    aparte de su estado de ejecucion. `launch` copia uno al otro para los warps de
    `launch_set` (los pedidos, o todos los habilitados con `launch_all`) y, con
    `launch_run`, pone la GPU en marcha; va al final del bloque para que su running<=1
    gane al "ya no queda nada vivo". Leer PC, ACTIVE y GROUP devuelve el descriptor,
    no el estado de ejecucion. Hay dos resets: `reset` (sistema) lo borra todo y
    `soft_reset` (GPU_CONTROL.RESET) conserva descriptores, LOGICAL_WARP_ID y
    WARP_ARG, que dejan de borrarse con el reset blando.
    gpu_system.v impl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
    [gpu_sm.v, gpu_system.v, gpu_system_tb.v]
2026-10-08 37: la GPU gana SHLI, SHRI y SARI (desplazamientos con cantidad inmediata)
    La lane acepta el bit 10 de SHL, SHR y SAR (antes, ERROR_INVALID_ENCODING) y toma
    la cantidad del campo Rb cuando esta a uno: un cable `shift_amount`, igual que
    cpu.v, y los tres casos del desplazador lo usan en lugar de operand_b. Los bits
    9:0 siguen reservados.
    gpu_alu_tb.v prueba SHLI con 5 y con 0, SHRI con 31 y SARI con 9 sobre los
    32 pares; sin el modo inmediato el banco falla (mutante). La capacidad
    shift_immediate pasa a ser de las dos familias (mismo patron en cpu.v y en
    gpu_lane.v) y hay un caso compartido, cases-shared/shift-immediate, con lo
    esperado calculado en Python: pasa en cpusim y en gpusim-cycle.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
2026-10-08 TODO 19: atajo REM tras DIV en la lane de la GPU, idea a pensar con su condicion de medida
2026-10-08 tools: mini-link, el paso entre mini-lcc y mini-asm (union de unidades cpu/gpu, pases)
    Trocea el .s en funciones, con grafo de flujo y vida de registros, y une las
    unidades en un .s. Primer pase: intrinsics (__gpu_tid -> GETTID, etc.).
2026-10-08 tools/mini-link: renombra las L.n de lcc por unidad para que dos .s no choquen
2026-10-08 1.isa mini_asm: las L.n de lcc son privadas de cada fichero incluido
    lcc numera L.1, L.2... desde 1 en cada compilacion, asi que dos .s incluidos
    desde un mismo fuente chocaban. Cada fichero incluido pasa a L.<n>.<k> (n =
    orden de inclusion); el fuente principal conserva sus nombres, y las cadenas
    no se tocan.
2026-10-08 crt0 fuera del compilador: mini-lcc --no-crt + 1.isa/runtime/crt0.s
    El compilador sigue emitiendo el arranque por defecto. Con --no-crt una unidad
    sin main (kernels de GPU) no lleva _start ni __stack, y se incluye crt0.s primero.
2026-10-08 tools: mini-link pasa a ser mini-opt, un filtro de un solo .s
    Juntar unidades lo hace el ensamblador con .include (L.n privadas por fichero) y
    el arranque, crt0.s; el filtro solo aplica pases. README con el flujo completo.
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2026-10-08 Kernels de GPU en C: pase kernels de mini-opt, gpu.h/gpu.c y memset_c.c
    KERNEL(nombre) -> __kernel_nombre; mini-opt lo convierte en entrada de lane (pila,
    parametros desde GETARG, EXIT, desplazamientos con registro, comprobacion de ISA).
    GPU_RUN(nombre, warps, params) lanza con el gpu_run de ensamblador. Ejemplo nuevo
    en examples/c (los de asm quedan igual), probado en el simulador de la 32.
2026-10-08 mini-opt: pase ssy, SSY automatico en los kernels de GPU
    SSY delante de cada salto que puede divergir, con su postdominador inmediato como
    join; en un bucle, una sola vez en el preheader. Un analisis de registros que varian
    entre lanes (GETTID, GETLANE, pila, lo definido bajo salto divergente) evita marcar
    los saltos uniformes; --ssy-all los marca todos. diverge_c.c (cinco kernels con
    divergencia) se comprueba contra un modelo en Python en el simulador de la 32.
2026-10-08 mini-opt kernels: sin marco ni pila de lane si el kernel no usa la pila
    Se quita el prologo/epilogo de lcc que solo guarda y restaura registros preservados
    (un kernel acaba con EXIT), y la pila de la lane solo se fija si queda alguna
    referencia a R30. diverge_c: 2646 -> 2410 instrucciones de warp.
2026-10-08 examples/c: memset, memcpy, fill_rect y blit en C frente al ensamblador
    sysk_c.c reescribe los kernels de sistema en C; compare.py los lanza en el simulador con
    los mismos datos que los de gpu_kernels.inc y cuenta instrucciones de warp: dejan la
    misma memoria y cuestan lo mismo (0 a 2 %). CSystemKernelsTest lo comprueba con un tope.
2026-10-08 Rotacion de textura en C (CPU, GPU inocente, GPU buena) frente a ensamblador
    rotate_body.h es el cuerpo una vez; rotate_c.c lo incluye tres veces con otro reparto de
    trabajo (fila/columna: primera y paso). compare_rotate.py: C cuesta 1,22x en la CPU y
    1,44-1,45x en la GPU; el bucle son 20 instrucciones contra 14 (constantes e invariantes
    sin sacar del bucle). mini-opt: reconoce una direccion de intrinseco reutilizada entre
    bloques, lee desplazamientos como -8+80 y quita los guardados de registros preservados
    aunque el kernel tenga locales.
2026-10-08 Reordena los ejemplos de 32 en examples/asm y examples/c por temas
    asm/{dma,race,render,launch.asm} y c/{dma,race,simt}. Lo comparable lleva el
    mismo nombre en la misma carpeta (dma/gpu_kernels, race/rotate). Rutas, tests y
    docs actualizados.
2026-10-08 mini-lcc -I y lo comun de C en examples/c/system
    Los ejemplos escriben #include "gpu.h" sin rutas relativas; build.py pasa la
    carpeta system a mini-lcc.
2026-10-08 Los scripts de examples/c suben de system: system solo lleva gpu.h y gpu.c
2026-10-08 Cubo en C (CPU, GPU inocente, GPU buena, anfitrion incluido) y build.py --board
    mmio.h, cube.c y cube_body.h; build.py --board usa gpu_runtime_board.inc y
    bench_board.inc. CCubeRaceTest dibuja lo mismo que cube.asm. Medido en la placa 36.
2026-10-08 mini-opt: pases jumps y hoist, SSY unidos y --stats por pase
    hoist saca del bucle constantes y cuentas con operandos fijos; ssy quita los SSY
    que caen despues de otro con el mismo destino. opt_stats.py mide C frente a
    ensamblador con y sin ellos; los topes de CSystemKernelsTest y CRotateTest bajan.
2026-10-08 mini-opt: copyprop (copias y codigo muerto); hoist pasa a llamarse licm
    Rotacion en CPU a 1,01 del ensamblador; cubo en la placa: CPU 0,96, GPU
    inocente 1,06, GPU buena 1,32.
2026-10-08 build-sweep --live: barrer la sintesis de un build que aun esta rutando
    El barrido no sintetiza: repite colocacion y rutado sobre el hardware.json del
    ultimo build archivado, asi que con RTL cambiado hay que hacer antes un build (si no, barre el netlist viejo; el README lo avisa ahora).
    Con --live toma la sintesis de _build/default del build en curso y barre las
    demas semillas a la vez, sin esperar a que termine el rutado de la del apio.ini.
    Comprueba que hardware.json y scons.params son de ese build (fecha posterior al
    arranque) y que hardware.json esta entero, y se niega si las fuentes han cambiado
    desde que arranco (hashes de metadata.json). Copia la sintesis a sweep-*/base/
    para que el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
2026-10-08 mini-opt: constprop; licm usa tambien R1..R4 y R31 cuando la vida de registros lo permite
    Cubo en la placa: GPU buena 1,25 del ensamblador (era 1,32).
2026-10-08 mini-opt: de un fichero a un paquete, un modulo por pase
    tools/mini_opt/{model,isa,flow,dead,registry,cli}.py y passes/ con intrinsics,
    kernels, jumps, constprop, copyprop, licm y ssy. Sin cambios de comportamiento.
2026-10-08 mini-opt: sin errores de tipos (pyright), funciones pequenas, analisis comun
    - reg()/last_instr()/predecessors()/forward_must(): los Optional se resuelven en un sitio
    - constprop, copyprop e intrinsics comparten forward_must en vez de tres copias
    - ssy, licm, kernels, intrinsics y jumps en funciones con nombre; sin closures en bucles
    - salida identica byte a byte a la de antes en los cuatro ejemplos (con y sin --ssy-all)
2026-10-08 37: acortar los caminos de clk (input_registers) y sdram_clk (reset_ctl)
    El barrido del netlist del hito 2 no cerro (semilla 3: clk 59,3/80, sdram_clk
    69,0/100). timing-wall --path dio dos caminos de verdad:
    - clk: mmio_write_data -> input_error -> ctrl_flush -> do_push -> escritura de
    la FIFO de INPUT, 16,9 ns. Ahora la FIFO ve evento, FLUSH y CLEAR un ciclo
    despues, registrados.
    - sdram_clk: reset_ctl hasta el controlador, 10,1 ns de ruteo. Dos registros
    mas parten la red en saltos de un ciclo.
    input_registers_tb (vectores de la 30): 7760 operaciones, 0 fallos.
    [top.v]
2026-10-09 Add rotating plane demo with alpha-blended logos
    plane.c draws a plane spinning around the vertical axis, Autobots on the
    front and Decepticons on the back, blended with 6-bit alpha over a
    vertical gradient. Same host and CPU / naive GPU / good GPU race as
    cube.c; the body lives once in plane_body.h.
    Textures come from plane/logos.png via plane_tex.py (alpha from the
    black background) and build.py embeds them after the code (DATA table).
    Texels use the "spread" RGB565 layout with alpha in the gap, so the
    blend is a single multiply for all three channels.
    CPlaneRaceTest checks all three methods against a Python model in the
    simulator; also run on board 36.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
2026-10-09 35: banco de registros en RAM distribuida con barrido tras el reset
    El reset ya no pone a cero los 32 registros en un ciclo (eso forzaba
    flip-flops: 1.061 FF y 2.589 LUT4 de multiplexores). Ahora son 48 celdas
    DPR16X4 y un barrido de 32 ciclos tras el reset; register_file da `busy` y cpu.v
    se mantiene en reset mientras dure. Misma semilla 17: LUT4 18.456 -> 16.367,
    FF 11.607 -> 10.589, arcos 97.746 -> 88.278; cierra timing. cpu_tb espera 40
    ciclos tras el reset. No probado en placa.
    [cpu.v, cpu_tb.v, register_file.v]
2026-10-09 board-upload --bitstream: programar un build archivado del historico
    board-upload normal sube _build/default/hardware.bit, que es el del ultimo
    intento aunque no haya cerrado timing o haya muerto antes de generar bitstream
    (en la 37 ese fichero era el de isa-ext, que no cerraba). Con --bitstream RUTA
    (un hardware.bit o una carpeta de reports/) se programa ese, se avisa de los
    relojes que no cumplian segun su summary.txt, se comprueba la identidad al
    terminar y se borra el sello de subida para que la siguiente subida normal
    vuelva a programar el bitstream actual. Ocho pruebas nuevas.
2026-10-09 mini-opt: stackslots, sharebase, richer constprop and noalias loads in licm
    New passes:
    - stackslots: promote word-sized frame slots (R30 + fixed offset, no address
    taken, some access inside a loop) to registers the function never mentions;
    drop the whole frame (and the lane stack setup in kernels) when every slot
    fits. On the lane stack each warp access is 8 transactions.
    - sharebase: within a block, replace several `LI sym+K` that only feed
    LOAD/STORE bases by one `LI base, sym` and fold K into the offsets.
    constprop now also: drops MOVI/LI that reload the value a register already
    has, evaluates operations on two constants (32-bit machine arithmetic),
    simplifies identities (x+0, x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
2026-10-09 mini-opt: integrar validacion LCC y optimizaciones post-RA
    [metrics.csv]
2026-10-09 lcc-audit: stop tracking generated .bin and .i probe outputs
    measure.py regenerates them from probes/*.c (it needs MSVC `cl` and
    y.lcc/build/rcc.exe). The .s and .opt.s files stay tracked: they are what
    docs/lcc-optimization-audit.md cites and can be read without compiling.
2026-10-09 mini-opt: tailcalls rejects any function that takes a frame address
    The old check only looked at R1-R4 at the call. A caller that stores &local
    in a global (or anywhere else) and then tail-calls g lets g read it after the
    frame has been released, and g's own frame can overlap that slot. Reproduced
    in the CPU simulator: the program returned 8 instead of 5.
    takes_frame_address() now rejects any function that uses R30 other than as the
    base of a LOAD/STORE or in the frame adjust (ADDI R30,R30,n), both as the
    function making the tail call and as its target. It subsumes the R1-R4 check,
    which is removed.
    stackslots and licm no longer run remove_dead themselves; the dce that follows
    them in the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
2026-10-09 Audit de lcc al dia y puntero de y.lcc a la promocion de locales en hojas
    Secciones 9, 12, 13 y 14 con lo ya hecho (stackslots, sharebase, plegado,
    LICM de loads, tailcalls, promocion en mini.md). Test de stackslots con la
    forma del cubo tal como la dejaba lcc, para mantener probada la red de seguridad.
2026-10-09 mini-opt: EXIT no cuenta como lector de R16..R29
    Tras un EXIT el hilo desaparece, asi que ninguna escritura en un registro
    preservado queda viva. dce ya puede quitar la copia al texel de la rotacion
    (una instruccion por celda): GPU inocente 1,08 -> 1,01 y GPU buena 1,10 -> 1,04
    veces el ensamblador. JR, HALT y TRAP siguen conservandolos.
2026-10-09 mini-opt: licm tambien en bucles con otro dentro
    Los bucles se procesan de dentro afuera: lo que el interior deja en su
    preheader sube otra vez desde el exterior si no depende de esa variable (el
    reparto por lane, 4 * lane, los limites). Hacia falta arreglar
    reaching_in_loop: el estado de salida de cada bloque arrancaba vacio, que se
    leia como "viene de fuera", y una ENTRY falsa quedaba atrapada en el ciclo
    cuando la definicion estaba dentro del bucle, asi que nada era movible. Ahora
    los bloques aun sin calcular no aportan nada.
    Rotacion en C frente a ASM (instrucciones de warp): GPU inocente 1,00x, buena
    1,01x (antes 1,01x y 1,04x). fill_rect y blit tambien bajan. Suite de lcc con
    --compar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
2026-10-09 mini-opt: las cargas de licm se sacan por demostracion, no por suposicion
    Antes, sacar del bucle la carga de una global exigia --assume-noalias porque
    mini-opt no sabia si un puntero podia apuntarla. Con la unidad entera delante lo
    demuestra: el simbolo esta definido en ella, su direccion no escapa de ninguna
    funcion (solo base de LOAD/STORE, directa o por un puntero calculado a partir de
    ella; no en un .word), no es volatile (hecho de lcc) y ningun fichero ajeno lo
    nombra (--extern-refs: arranque, runtime, la otra unidad). En el cubo sale lo
    mismo que con el flag, sin el. --assume-noalias queda como suposicion explicita
    (basta que el kernel no escriba el simbolo) y un volatile no se saca nu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
2026-10-09 Audit de lcc: remedida la suite y helpers __mini_* descartados como metadato
    Suite mini-tst con y.lcc en 63c0e1d: 23.601 -> 20.459 instrucciones (-13,3 %).
    Los __mini_* son opacos para mini-opt (34 de 640 funciones, 3,3 % de las
    instrucciones en mini-tst; ninguna en los ejemplos), asi que no se anade el
    metadato helper por ahora.
2026-10-09 examples/c: el cubo entra en la comparacion de instrucciones C frente a ensamblador
    compare_cube.py corre el demo con race_period=1 (un metodo por fotograma) y
    cuenta instrucciones de CPU o de warp por metodo; opt_stats.py lo suma a la
    tabla antes/ahora. CPU 1,12x el ensamblador, GPU 0,99x y 1,01x.
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2026-10-09 lcc-audit: README con contenido, como regenerar y estado de la linea base
2026-10-09 mini-opt: pase invert (rama invertida)
    Bcc a,b,L1 ; BRA L2 ; L1: -> B!cc a,b,L2 ; L1:
    Solo si L2 es una etiqueta de la misma funcion y esta tiene menos de 32.000
    instrucciones (el branch condicional lleva 16 bits). Va antes de ssy.
    Suite: 23.601 -> 20.420 (-13,5 %), 166/166; z.tui -71 instrucciones;
    165 tests de mini-opt y 134 de simulacion CPU+GPU.
2026-10-09 mini-opt: pase boolean (booleano como valor)
    Bcc a,b,Lf ; MOVI r,1 ; BRA Le ; Lf: ; r=0 ; Le: -> SLT/SLTU (+ XORI), o
    SUB + SLTU para BEQ/BNE. Sin liveness; solo si nadie mas salta a Lf.
    Suite: 23.601 -> 20.242 (-14,2 %), 166/166; z.tui -70 instrucciones (29 casos);
    174 tests de mini-opt (300 programas al azar en el simulador) y 134 de CPU+GPU.
2026-10-09 test_mini_opt: la demo de z.tui compilada con y sin mini-opt
    TuiDemoTest: misma pantalla, -12,7 % de instrucciones ejecutadas y -3,5 % de
    binario. Se omite sin el submodulo z.tui, el rcc de y.lcc o cl en el PATH.
2026-10-09 compare_cube: medir el segundo giro de metodos, sin el arranque del demo
    El fotograma 0 incluye generar las texturas (~530.000 instrucciones de CPU en
    asm, ~670.000 en C) y hacia parecer que la CPU del cubo iba a 1,12 del
    ensamblador. En estado estable: CPU 1,00, GPU inocente 1,00, GPU buena 1,01.
2026-10-09 Audit de lcc: codigo real (z.tui, cubo), peepholes hechos, tailcalls y guardados del prologo medidos
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2026-10-09 mini-opt: pase deadsaves (guardados de R16..R29 que la funcion ya no usa)
    copyprop y dce borran el ultimo uso de un registro preservado y dejan su STORE
    del prologo y sus LOAD del epilogo; el .s crudo de lcc no los tiene. Si el
    registro no aparece en nada mas (el JR lo lee por convenio), se borran.
    Suite: 20.242 -> 20.080 (-14,9 % sobre 23.601); z.tui: -130 instrucciones,
    demo 316.008 -> 311.008 ejecutadas, binario 80.748 -> 80.180 B.
    189 tests de mini-opt, 134 de simulacion CPU+GPU, pantalla de la demo identica.
2026-10-09 mini-opt: pase forward (store-to-load forwarding sobre huecos de pila)
    STORE R1,R30,32 ... LOAD R1,R30,32 -> el LOAD sobra; LOAD R5,R30,32 ->
    ADD R5,R1,R0. forward_must sobre el CFG con {hueco: registro}; lo invalidan
    reescribir el registro, otro store sobre la palabra, llamadas, cambios de R30
    y stores por puntero desde la direccion de marco mas baja que se calcula.
    Suite 20.080 -> 19.980 (-15,3 % sobre 23.601); z.tui: demo 311.008 -> 307.009
    ejecutadas, binario 80.180 -> 79.340 B, trafico de pila 15,1 % -> 12,7 %.
    209 tests de mini-opt (400 programas al azar en el simulador; 3 mutantes
    detectados), 134 de simulacion CPU+GPU, pantalla de la demo identica.
2026-10-09 mini-opt: pase deadstores (DSE de los huecos de argumentos entrantes)
    Tras forward, el STORE R1,R30,32 con que lcc vuelca un argumento ya no se lee.
    Se borra un STORE de palabra por encima del marco (desplazamiento >= n) si
    nada en la funcion lee esa palabra ni toma su direccion (ni la de un hueco
    anterior del area), y R30 solo cambia con el ajuste canonico. Por debajo del
    marco no se toca nada (area saliente, guardados, locales).
    Suite 19.980 -> 19.923 (-15,6 % sobre 23.601); z.tui: demo 307.009 -> 304.009
    ejecutadas, binario 79.340 -> 78.940 B, trafico de pila 12,7 % -> 11,7 %.
    222 tests de mini-opt (300 programas al azar; 2 mutantes detectados),
    134 de simulacion CPU+GPU, pantalla de la d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
2026-10-09 Audit de lcc: trafico de pila restante en z.tui, valores vivos a traves de llamadas y argumentos de pila medidos
2026-10-09 Audit de lcc: estimacion del DSE de guardados y locales (menos del 0,2 %)
2026-10-09 Audit: idea de analisis de alias por tipos y LICM de cargas (caso del cubo)
2026-10-09 Vida de Conway: C natural 2,30x y C con punteros 1,05x frente al ensamblador (compare_life.py); reduccion de fuerza en la audit
2026-10-09 mini-opt: pase strength (reduccion de fuerza de accesos indexados); vida de Conway en C natural 2,30x -> 1,13x
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2026-10-09 compare_race.py generico (rotate, life, blur); vida y blur en C natural con GPU; boolean no toca kernels (la GPU no tiene SLT/SLTU)
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2026-10-09 strength: el paso de la variable de induccion puede ser un registro invariante (x += nlanes en los kernels)
2026-10-09 Audit: vida y blur en C natural en las tres versiones; contrato del bloque de argumentos e if-conversion por mascara como pendientes
2026-10-09 mini-opt: contrato del bloque de argumentos (pase argblock, licm en kernels); strength mas general (Horner, constantes de la entrada, paso repetido); vida y blur en C natural ~1,05-1,65x en la GPU bu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
2026-10-09 mini-opt: objetos const de lcc (; @miniopt const) sacan su lectura del bucle en cualquier funcion; y.lcc con el hecho y el test 167
2026-10-10 mini-opt: NOALIAS(p) (restrict para C89): marca interna, analisis de procedencia por valores y licm de cargas fuera del alcance de los stores; cubo en la CPU 1,00 -> 0,98 con una marca
2026-10-10 Documenta memoria local por lane y shuffle (ideas para la EBR de la 37)
    Recoge el uso del hueco de la EBR del banco de registros (local y
    compartida, ventana de direcciones frente a opcodes propios) y resume
    lo que ya existia sobre SHFL en v0.3, v0.4b y fuego_warps.
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2026-10-10 x.tests: poner a cero las bases de video antes de cada caso en placa
    Solo el reset de la placa reinicia FB_FRONT/FB_BACK, asi que un caso con un
    numero impar de intercambios se las dejaba cruzadas al siguiente. Los casos
    que no escriben las bases (double-buffer, fb-desalineada) las leen y acaban
    con fb_front heredado, y el diferencial lo comparaba contra 0 del simulador:
    fallaban aunque cada backend pasara por separado. Cero es el valor de reset,
    asi que no tapa nada.
2026-10-10 Backend gpu-core: la GPU de la 36 y la 37 en placa, lanzada por el host
    La 36 y la 37 son CPU y GPU. Como CPU siguen en cpu-fpga (backend_from_rtl no
    cambia); su GPU la lanza la CPU por MMIO (GPU CORE) y el monitor gobierna la
    CPU, asi que gpu-fpga no las conoce. gpu-core hace de CPU desde el host:
    escribe kernel y descriptores con la CPU parada, lanza con RUN y sondea
    WARP_DONE.
    - rtl_facts.backends_from_rtl: ("cpu", "gpu") para las dos carpetas.
    - Capacidades de la GPU solo de los ficheros gpu_*.v, para no atribuirle las
    de su CPU.
    - test-board lanza cpu-fpga y gpu-core en un CPU+GPU (--family elige una);
    test-all --family gpu las incluye; prototype-report muestra cpu+gpu.
    - Solo corr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
2026-10-10 mini_asm: add conditional assembly (.ifdef/.ifndef/.else/.endif, .define, -D)
    Conditions are resolved while expanding .include, before pass 1, so the rest of the assembler
    still sees a flat list of lines. Symbols come from -D on the command line or from .define in the
    source; .equ constants do not count. Each .ifdef must close in the file that opens it, and a
    discarded branch is not assembled or even read (its .include lines are skipped).
    Lets one source serve the simulator and the board with a single BOARD symbol.
2026-10-10 Add build-c and merge the simulator/board variants of the GPU examples
    build-c (tools/build_c.py) replaces examples/c/build.py: it accepts any .c, takes --outdir, -I and
    --data LABEL=FILE (it no longer runs data generators), and --board now defines BOARD for the
    assembler. Intermediates go to _build/c/ at the repo root by default.
    The shared runtime moves out of the prototype 32 examples:
    x.tests/inc/ gpu_runtime.inc, bench.inc (one file each, with .ifdef BOARD instead of
    a *_board twin), gpu.h, mmio.h
    x.tests/runtime/gpu gpu.c
    run-board now assembles with -D BOARD, so the 10 *_board.asm twins (bench_dma, lat_exp, poll_exp,
    blur, cube, life, rotate, render,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
2026-10-10 Move the 32 examples to x.tests/cases-cpu-gpu, one folder per program
    32.cpu-gpu-func-sim/examples/{asm,c} split the same program across two trees (cube.asm and cube.c
    lived in different folders), mixed the C comparison tools with the examples, and kept a single
    README for everything. Following what was done for cases-gpu/demos, the programs move to
    x.tests/cases-cpu-gpu/<theme>/<program>/, each version of a program side by side (.asm + .inc,
    .c + *_body.h, data, report):
    launch/ dma/{harness,rect,memset,bench-dma,lat-exp,poll-exp}
    race/{cube,life,blur,rotate,plane} render/{render,render-v2,render-cpu} simt/diverge
    What a theme shares stays in the theme folder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
2026-10-10 32 tests: skip the slow classes unless RUN_SLOW=1
    Ten classes spend 5 to 22 s each in setUpClass simulating frames of a demo (about 100 of the 112 s). By default they are skipped and the suite runs in 14 s; RUN_SLOW=1 runs all 134 tests as before. Same switch idea as RUN_SLOW_SIMT in 11.
2026-10-10 11: rename RUN_SLOW_SIMT to RUN_SLOW, the same switch as the 32 tests
2026-10-10 Add the sim-sys backend (CPU+GPU simulator) and the sys-both differential
    sim-sys wraps 32.cpu-gpu-func-sim as a CPU-architecture backend that declares gpu_core and gpu_warp_start, so cases-cpu/gpu/* run without a board. Document the backend names in x.tests/README.md; fix two stale links in the DMA design doc.
2026-10-10 Rename the x.tests/backends modules after the backends they implement
    simulator->sim_cpu, gpu_simulator->sim_gpu, cpu_gpu_simulator->sim_sys, fpga->fpga_cpu, gpu_fpga->fpga_gpu, gpu_core->fpga_sys; video_stop and video_layout merged into frame_capture. Unit tests and backend-gpu-core.md renamed alike.
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2026-10-10 Add test.json cases for the C CPU+GPU programs (dma, race, simt) and document sim-sys vs fpga-sys
2026-10-10 35: the monitor sets the SDRAM clock phase from version.json
    The PLL phase falls back to 0 whenever the FPGA is programmed, and 0 is not a
    working phase on this board. monitor.py now has a PhaseMixin (phase_status,
    phase_move, set_sdram_phase, apply_version_settings), a phase-set command, and
    applies "sdram_phase" from version.json on every connection except phase-*
    commands. MonitorBackend.connect calls apply_version_settings when the
    prototype's monitor defines it. phase_sweep.py delegates to the client instead
    of keeping its own copy of the logic. sdram_phase is 10, inside the passing
    window of the earlier sweeps (2..17 for seed 10).
    Board run with the current bitstream: 4 of 70 cases fa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
2026-10-10 mmio.md: define the optional SDRAM phase control in the SDRAM block (0x80020000)
    The 35 already had PHASE_CTRL/PHASE_STATUS in the block that section 7 reserved
    for the SDRAM controller. Promote it from experimental to an optional register
    pair of that block: layout, errors, and rules written from phase_mmio.v and
    pll_phase_ctl.v. It is optional, but whoever controls the phase must use these
    registers. Add section 16.6 (the host applies the prototype's "sdram_phase" from
    version.json when it connects), the constants to mmio_map.vh (regenerated into
    mmio_map.py and mmio.inc), the sdram_phase capability, and use the constants in
    the 35's monitor.py. No RTL changes.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
    [monitor.py]
2026-10-12 tools: bit de ejecución en los 20 lanzadores que no lo tenían
2026-10-12 asm2: isa.py pasa a minigpu_isa.py
    Con el nombre genérico, cargar el ensamblador y el simulador de ciclos
    (25.gpu-sim-cycle-uarch, con su propio isa.py) en el mismo proceso hacía
    que este recibiera el módulo del ensamblador desde sys.modules y fallara
    con 'cannot import name ISAError'. Rompía cuatro tests de t.tests/unit
    según el orden de carga.
2026-10-12 test_mini_objdump: registra el módulo en sys.modules antes de ejecutarlo
    Sus dataclass buscan el módulo en sys.modules; sin registrarlo, el test
    fallaba al cargarse con pytest.
2026-10-12 mini-asm: objetos para vlink, .extern de lcc y ruta de t.tests/inc
    - Con --vobj/--json, un LI que nombra una etiqueta usa siempre dos
    instrucciones (MOVHI+ORI). Antes se compactaba a MOVI según el valor
    previo al enlace y, reubicado por encima de 0x7FFF, se extendía el
    signo sin aviso.
    - .extern acepta el tamaño que escribe lcc (`.extern nombre 4`) y, como
    en GNU as, cede ante una definición en el mismo ensamblado (build-c
    junta todas las unidades). Arregla los casos race/* en C.
    - Al generar una imagen, un .extern usado y sin definir es un error; antes
    valía 0 sin avisar. Uno declarado y sin usar no estorba.
    - load_program_bytes busca t.tests/inc en la raíz del repo (desde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
2026-10-12 run_tests: un caso roto ya no detiene la suite
    - Una carpeta no nombra sus casos: los incompatibles con el backend se
    omiten, como sin argumentos (antes, run_tests.py t.tests/cases-cpu
    abortaba por gpu/launch-run sin ejecutar nada).
    - Un caso que no se puede preparar (build que falla, JSON inválido)
    cuenta como fallo y los demás siguen.
    - Nombrar un test.json incompatible sigue siendo un error de uso que sale
    con 2 sin construir backends (SelectionError).
2026-10-12 trazabilidad: resolver la raíz igual que las rutas del modelo
    El modelo trabaja con rutas resueltas; con una raíz que pasa por un enlace
    (en macOS, /var -> /private/var) update_trace_docs fallaba en relative_to.
    Dos tests comparaban con la ruta temporal sin resolver.
2026-10-12 t.tests/inc: stdint.h y stdbool.h para mini-lcc
    La librería de lcc para MiniISA no las trae y cc -E cogía las del sistema,
    que lcc no entiende. bool es un int (C89 no tiene _Bool).
2026-10-12 build-c: acepta varias unidades C
    build-c programa.c otra.c ...: la primera lleva main y da el nombre a la
    imagen. Dos unidades con el mismo nombre base son un error, porque
    pisarían su .s en --outdir.
2026-10-12 gpu-scheduler: scheduler de jobs en C89 con ejemplo y pruebas
    - scheduler.c en C89 sin libc, para que compile con mini-lcc.
    - gpu_cancel recorre la descendencia en anchura marcando cada job: el
    recorrido recursivo era exponencial con diamantes.
    - gpu_release se salta la generación que daría GPU_INVALID_JOB al job 127.
    - test-scheduler.c: ejemplo de uso y pruebas con una GPU simulada;
    corre en el anfitrión (make test, con ASan/UBSan) y en sim-sys
    (make sim, test.json).
2026-10-12 Solved .word in sim traces
2026-10-15 analysis: catalog of the C programs, updated for mini-cc
    Describes every C program and library in the repo with how it is built.
    Covers the mini-cc flow (one mini-opt call over all the .c, crt0 the only
    automatic piece, the GPU runtime asked for explicitly), mini-opt with its
    full pass list, --whole-program and deadfuncs.
2026-10-15 runtime/: shared headers and sources in one place (include/ and src/)
    The shared code lived in t.tests/inc, t.tests/runtime/gpu and 1.isa/runtime,
    and the include path was written by hand in about 25 places. Now:
    runtime/include/ what is included and emits nothing: the C headers and
    mmio.inc (only .equ)
    runtime/src/ code: crt0.s, gpu.c, gpu_runtime.inc, bench.inc,
    putpixel.inc, drawline.inc, sin256.inc
    The rule is "if it emits bytes, it goes in src/"; lib/ is left for the
    compiled objects once there is a linker. The directories are defined once in
    1.isa/runtime_dirs.py (ASM_INCLUDE_DIRS, C_INCLUDE_DIRS) and the assemblers,
    mini-cc, the debu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
2026-10-29 mini-design: reorganiza minimaster y aplana minifont
    - Renombra 39.minimaster -> 39.mini-design (MiniDesign)
    - Integra minifont/ en el nivel principal: tools/, tests/, fonts/ unificados
    y un único Makefile
    - Tests en tests/ (test_gfx, test_blit, test_minifont, test_flb, test_extractors)
    - flb2mf --all: las fuentes se extraen de NEWS.FLB a build/fonts/ en el build
    - Originales de NewsMaster (FLB/SHP/SDX/SDR/ICN) en resources/
    - make: flb-fonts, flb-sheets, shapes, icons, test-extractors, check;
    clean borra build/ y las PNG generadas
2026-10-29 minifont: font_spacing por fuente leído de NEWS.FLB
    - flb2mf.py lee el u16 LE en +80 de cada fuente (provisional) y lo guarda
    en la cabecera .mf (+28, flag 0x0001); también en --all
    - MfFont.font_spacing; los .mf antiguos (flags=0) cargan con spacing=0
    - advance_x, GLYPH_RUN y el renderer sin cambios
    - tests: test_spacing.c, test_flb.py (Park 10=2, News 10=1, Twig=3),
    make test-flb-spacing incluido en check
2026-10-29 mini-design: el layout aplica font_spacing y make run-spacing para compararlo
    - example.c y minifont_demo.c suman font_spacing a cada avance
    (GLYPH_RUN y renderer sin cambios)
    - spacing_demo.c: 12 fuentes con y sin font_spacing (make run-spacing)
2026-10-29 mini-design: .clang-format con el estilo de renderer_cpu.c
    Evita que la extensión C/C++ de VS Code reformatee con su estilo por
    defecto (llaves en línea propia). Reformatea minifont.c, minifont.h y
    minifont_demo.c; el código no cambia.
2026-10-29 clang-format: estilo común en la raíz del repo
    Mueve 39.mini-design/.clang-format a la raíz para que todo mini-gpu use el
    mismo estilo. .clang-format-ignore protege los submódulos (u.lcc, v.tui,
    w.vlink) y .venv del formateo desde VS Code.
2026-10-29 mini-design: aplica clang-format a todos los .c/.h
    Solo formato: el código normalizado es idéntico, los tests pasan y las demos
    generan los mismos PPM.
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2026-10-29 mini-design v0.4: documento, layout en columnas y páginas, viewport
    - src/document: unidades de 1/720", A4, márgenes, N columnas, estilos de
    párrafo y carácter, historias y gráficos con exclusión rectangular
    - src/layout: saltos de línea por palabras con avances proporcionales
    (advance_x + font_spacing + letter_spacing), interlineado, flujo entre
    columnas y páginas, texto alrededor de las imágenes
    - src/viewport y src/document_render: página completa (greeking) y 100 %
    (GLYPH_RUN), imágenes con BLIT; MiniGFX sin cambios
    - examples/page_demo: página A4 con ilustración de NEWS.SHP (make run-page)
    - tests: test_document, test_layout, test_viewport (make test-design)
    - Reorg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
2026-10-29 mini-design v0.5: tipografía y texto a zoom entero
    - Alineación derecha, centrada y justificada (MdParagraphStyle.align)
    - Párrafos a todo el ancho (MD_SPAN_ALL): bandas de columnas en el layout
    - Rangos de estilo de carácter dentro de un párrafo (md_paragraph_add_run);
    cada MdGlyph guarda su estilo y el render emite un GLYPH_RUN por tramo
    - Texto a los dos lados de una imagen (MD_WRAP_BOTH; wrap=1 pasa a llamarse
    MD_WRAP_LARGEST y se comporta igual)
    - GLYPH_RUN.scale: cada píxel del glifo como bloque k x k (0 y 1 = 1x);
    el viewport lo usa a 200 %, 300 %... (md_viewport_text_zoom/_text_scale)
    - page_demo: titular centrado a todo el ancho, cuerpo justificado con
    cursivas, segund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
2026-10-29 mini-design: nombres homogéneos para las demos y examples/README.md
    - examples/<tema>_demo.c -> build/<tema>_demo, make run-<tema>, <tema>-*.ppm
    - example.c -> glyph_demo.c (glyph-*.ppm, make run-glyph)
    - demo_icons.h -> blit_icons.h
    - minifont_demo escribe minifont.ppm y minifont-park10.ppm en la raíz
    - make run lanza todas las demos
    - Cabecera común en cada demo: qué muestra, salida y uso
2026-10-30 mini-design: MiniFont v2 y layout a 120x72 ppp como NewsMaster
    - Formato .mf v2: cabecera de 40 bytes con font_spacing (i16) y res_x/res_y;
    el lector solo acepta la v2.
    - flb2mf: lee resolución, interlineado extra (+82) y ancho del espacio (+84)
    del registro FLB; line_gap y glifo 32 vacío en el .mf. bdf2mf toma la
    resolución del BDF.
    - Layout: píxeles de fuente a unidades según la resolución de cada fuente
    (6 x 10 unidades a 120x72 ppp); ilustraciones de NEWS.SHP igual.
    - Viewport con escala por eje: vistas de texto Normal (1x1) y Zoom (2x2) de
    NewsMaster; el render decide glifos o greeking por tramo y fuente.
    - test_newsmaster: los siete cortes de línea de un párrafo compu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
2026-10-30 mini-gl: versiones V0-V5 renumeradas, ejemplos y plataforma host
    - V0 directo, V1 diferido en CPU, V2 GPU; las fases V2-V4 pasan a V3-V5.
    archive/ conserva los nombres antiguos (tabla de equivalencias en README).
    - src/platform_host.c: main, size() y bucle setup()/draw(); elige versión
    con -v 0|1|2|all y guarda el frame en PPM.
    - examples/shapes.c y pattern.c; tests movidos a tests/; Makefile.
    - API Processing: size(), color(), width/height.
    - mgl_gpu_sprites_from_v0 -> mgl_gpu_sprites_from_cmd.
2026-10-30 mini-gl: circle con diámetro y colores (r,g,b) como Arduino TFT
    - circle(x,y,d) recibe el diámetro, como en Processing; mgl_circle sigue
    con radio (d/2), así que un diámetro par sale un píxel más ancho.
    - background/fill/stroke reciben (r,g,b) 0..255; variantes RGB565
    background565/fill565/stroke565 y color565() como en Adafruit_GFX.
    - Ejemplos y tests adaptados; las imágenes no cambian.
2026-10-30 clang-format: estilo único del repo y formateo al guardar
    - .clang-format: funciones siempre desplegadas, línea en blanco entre
    definiciones, 100 columnas (referencia: 40.mini-gl/src/processing.c).
    - VS Code formatea al guardar C/C++ solo las líneas modificadas: el código
    antiguo se adapta a medida que se toca.
    - .clang-format-ignore: v.tui sale de la lista; tiene su propio
    .clang-format (submódulo actualizado).
    - processing.c/.h reformateados.
2026-10-30 mini-gl: código reformateado con el estilo del repo
    Solo formato (clang-format, líneas en blanco entre bloques, llaves en los
    bucles anidados de los ejemplos) y tildes en comentarios y mensajes.
    Las imágenes de los ejemplos y los tests son idénticas byte a byte.
2026-10-30 mini-gl: compile_commands.json para IntelliSense
    make genera 40.mini-gl/compile_commands.json con los flags reales
    (-Isrc -DMGL_GPU_HOST_TEST -std=c89); .vscode/settings.json solo apunta
    a él (C_Cpp.default.compileCommands). Así IntelliSense no coge las
    cabeceras antiguas de archive/ y los flags se cambian en el Makefile del
    proyecto. No se versiona: lleva rutas absolutas.
2026-10-30 mini-gl: plataforma SDL2 con draw() en bucle y ejemplo animado
    - src/platform.c: parte común de las plataformas (size(), command buffer
    y un frame con V0/V1/V2); platform_host.c se apoya en ella.
    - src/platform_sdl.c: ventana escalada, setup() una vez y draw() a 60 fps;
    -v y teclas 0/1/2 para cambiar de versión en marcha; título con fps y
    bytes de comandos. Ratón con las coordenadas del framebuffer que ya da
    SDL (RenderSetLogicalSize).
    - API Processing: frameCount, mouseX, mouseY, mousePressed.
    - examples/bounce.c; make sdl / make sdl-<sketch>.
    - 300 frames de bounce dan el mismo framebuffer con V0, V1 y V2.
2026-10-30 build-c: biblioteca C mínima y pase deadfuncs de mini-opt
    - t.tests/inc/string.h (memset, memcpy, memcmp) y su implementación en
    t.tests/runtime/libc/string.c, que build-c compila con cada programa.
    Caso t.tests/cases-cpu-gpu/libc/string_test.
    - mini-opt: pase deadfuncs, solo con --whole-program (los --extern-refs
    son todo el resto del programa). Como un enlazador: raíces = lo que se
    nombra fuera de las funciones de la unidad y los kernels (__kernel_*,
    que se lanzan por su dirección, también desde los arneses de Python);
    borra lo que no se alcanza, ciclos incluidos. build-c lo pasa siempre,
    así que de la biblioteca solo se queda lo que se usa (memset.bin vuelve
    a 58.232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
2026-10-30 docs: el SM de la 29 (placas 36 y 37) sí tiene accesos de 8 y 16 bits
    Las notas de 11 y 32 decían que el RTL de la GPU no los tenía. El SM de la
    29 los decodifica, la LSU de la 36 y la 37 escribe con máscara por byte y
    el informe de prototipos da subword_memory para 29, 36 y 37. No los
    tienen las GPU anteriores (12, 14, 17, 22).
2026-10-30 simuladores: perfil por función (--profile, --symbols)
    tools/sim_profile.py, compartido por sim-sys, sim-cpu y sim-gpu: cuenta
    cada instrucción en la función que la contiene (las etiquetas que no son
    de bloque; en un programa de build-c, las funciones C). En la CPU,
    instrucciones propias, llamadas y total con lo que llama, siguiendo la
    pila por la dirección de retorno (llamadas finales con BRA y recursión);
    en la GPU, instrucciones de warp por kernel. Los nombres salen del .asm
    del programa o de --symbols para un .bin. Funciona junto a --trace: la
    GPU entrega cada evento a sim_profile.GpuEvents, que lo reparte.
    Tests: ProfileTest (32), ProfileCommandLineTest (2) y la línea de
    órdenes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
2026-10-30 mini-gl: plataforma MiniGPU con V0 en el simulador
    - src/platform_minigpu.c: main(), size() (solo 320x240) y el bucle
    setup()/draw() sobre el vídeo de MiniGPU. Lienzo fijo que se copia al
    buffer trasero antes de cada swap, para conservar lienzo y estado de
    dibujo entre frames como en Processing. Se compila con build-c.
    - Makefile: make minigpu, sim-<sketch> (ventana del simulador),
    check-minigpu (frame FRAMES contra V0 en el host, píxel a píxel) y
    profile-minigpu-<sketch> (--profile del simulador).
    - platform_host: -f N frames y -o x.bin (RGB565 crudo, como el simulador).
    - shapes, pattern y bounce (también su frame 5) salen idénticos al host.
    - Documentación al día: toolcha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
2026-10-30 mini-gl: doble buffer sin lienzo intermedio (mgl_set_target)
    La plataforma MiniGPU dibuja directamente en el buffer trasero. Tras cada
    swap, mgl_set_target cambia de buffer sin tocar el estado de dibujo y deja
    pendiente copiar el delantero; solo se copia si se dibuja algo antes de un
    background(). mgl_cmd_render_cpu empieza por el último CLEAR y mgl_finish
    copia si el frame no dibujó nada. Con 3 frames: shapes -10 %, pattern -9 %,
    bounce -25 % de instrucciones.
    memcpy de la libc copia por palabras (de 4 en 4) con punteros alineados.
    Ejemplo trail (no borra entre frames) y test de doble buffer en test_cpu.c.
2026-10-30 mini-gl: V0 por tramos horizontales (span)
    sw_clear, el relleno de rect y circle y el pincel de los contornos gruesos
    escriben tramos horizontales en vez de píxeles con put. Los triángulos
    calculan las aristas de forma incremental y rellenan con un tramo por
    fila. Mismos píxeles que antes: comparado byte a byte con el raster.c
    anterior con 16.000 primitivas aleatorias. Con 3 frames: shapes 4,6x,
    pattern 3,7x, bounce 4,7x, trail 3,0x menos instrucciones.
2026-10-30 mini-lcc: sin macros del host, con __LCC__ y __MINIGPU__, y -D
    mini-lcc preprocesa con el cc del host (o cl), no con el driver de lcc, y
    heredaba sus macros: __GNUC__, __APPLE__, __SIZEOF_LONG__ == 8... Ahora
    preprocesa con -undef (/u en MSVC) y define __LCC__ y __MINIGPU__. -D en
    mini-lcc y build-c (en todas las unidades).
2026-10-30 mini-gl: span con escrituras de 32 bits en MiniGPU
    Con __MINIGPU__ (lcc no aplica strict aliasing), span escribe dos píxeles
    por escritura cuando el tramo tiene al menos 8. Cuenta con un entero: lcc
    compila cada resta de punteros como una DIV. Mismos píxeles (comparado con
    el raster.c anterior también con -D__MINIGPU__). Con 3 frames: shapes -9 %,
    pattern -5 %, bounce -21 %, trail -9 %.
2026-10-30 mini-gl: líneas por tramos y triángulos sin recorrer la fila
    Las líneas agrupan los puntos de Bresenham en tramos de la misma y: cada
    fila es un span (con pincel grueso, la ventana de tramos sale de dos
    recorridos de la línea), y las horizontales y verticales son un
    rectángulo (box, que también rellena rect). Los triángulos recortan cada
    fila con una división por arista. Mismos píxeles que el raster.c original
    (comparado con primitivas aleatorias y grosores hasta 12). Con 3 frames:
    shapes -39 %, pattern -32 %.
2026-10-30 mini-gl: command buffer por palabras en MiniGPU
    Con __MINIGPU__, los campos del command buffer se leen y escriben con
    accesos de 16 y 32 bits (macros; en el host, byte a byte), y mgl_cmd_init
    pide memoria alineada a 4. emit solo actualiza used de la cabecera; fit y
    pack son macros. En pattern (3 frames), V1 cuesta 105.000 instrucciones más
    que V0 en vez de 360.000.
2026-10-30 mini-opt: pase inline (hojas pequeñas de la unidad)
    Cada JAL R31 a una hoja de la unidad de hasta 8 instrucciones (sin
    llamadas, sin tocar R30 ni R31, solo saltos a sus etiquetas) pasa a ser su
    cuerpo, con etiquetas L.n nuevas. Va tras deadsaves y le siguen copyprop,
    dce, jumps y deadsaves. mini-gl: 1-2 % menos con macros, 4-7 % con
    funciones (las macros siguen ganando: lcc ya repartió los registros
    contando con la llamada). Con 8 instrucciones la demo de v.tui sigue
    ocupando un 4 % menos que sin optimizar.
2026-10-30 mini-opt: pase leafregs (preservados libres en funciones sin llamadas)
    En una función sin llamadas, los R16..R29 que guarda pasan a un R3..R15
    que no interfiere con ellos (vida de registros) y se borran el guardado y
    la restauración, sea una copia (stackslots) o un STORE/LOAD en la pila;
    el de R31 se borra y, si nada lee ya la pila, también el marco. stackslots
    se repite tras inline. mini-gl (3 frames, V0): shapes -6 %, pattern -7 %;
    la demo de v.tui ejecuta un 1,7 % menos.
2026-10-30 build-c: los static de cada unidad de C pasan a <nombre>.<unidad>
    El ensamblador junta los .s con .include y solo hace privadas de cada
    fichero las L.n de lcc: dos unidades con un static del mismo nombre
    chocaban (o, con .comm, se fundían sin aviso). Lo que lcc no marca con
    .globl es static: se le añade el nombre de la unidad.
2026-10-30 mini-gl: entrada (ratón y teclado) y V1 en MiniGPU
    Entrada como en Processing: pmouseX/pmouseY, keyPressed, key y keyCode
    (CODED, UP, DOWN...). En MiniGPU sale de INPUT (mmio.md §25): ratón
    relativo en medios píxeles desde el centro y teclado HID a ASCII (US); en
    SDL, de sus eventos (el cambio de versión pasa a F1/F2/F3). El ratón
    empieza en el centro en todas las plataformas. Ejemplo paint con un guion
    de entrada.
    V1 en MiniGPU (MGL_VERSION=1, make V=1): draw() se graba en un command
    buffer y la CPU lo interpreta antes del swap. Los binarios van a
    build/minigpu/v<N>/ y check-minigpu compara con la misma versión en el host.
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2026-10-30 sim-gpu 11: JAL, JALR y JR (destinos distintos entre lanes: ERROR_SIMT)
    El DESIGN.md de la 25 decia que no tenia llamadas; si las tiene, como la 37.
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2026-10-30 mini-opt ssy: lo que se lee de un hueco de la pila varia solo si lo guardado variaba
    Con kernelcalls, lcc pasa por la pila los parametros a partir del quinto y
    cada if sobre ellos abria una region (el renderer de V2 de mini-gl pasaba de
    8 niveles: ERROR_SIMT). Si una direccion de la pila se escapa, se mantiene
    el criterio conservador.
2026-10-30 mini-gl: V2 en MiniGPU (KERNEL(mgl_render) en un warp)
    mgl_gpu_render valida en la CPU y lanza el kernel; en el host recorre las 8
    lanes (sobra gpu_host.c). mgl_cmd_ready trae el lienzo antes de que la GPU
    dibuje. make check-minigpu V=2 da los mismos pixeles que el host.
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2026-10-31 mini-gl V2: colores como unsigned int y NOALIAS(j)
    Los mgl_color_t de los parametros iban y venian por la pila para
    estrecharlos; con NOALIAS(j), licm saca de los bucles lo que se lee del
    trabajo. shapes: 1222652 -> 844224 instrucciones de warp en 2 frames;
    bounce: 274862 -> 147068.
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2026-10-31 mini-gl V2: el renderer dibuja con raster.c por lanes
    gpu_renderer.c interpreta el buffer como V1 e incluye raster.c con
    MGL_RASTER_LANES: cada lane dibuja lo mismo que V0 en sus columnas, y solo
    cambian put, row_fill, la columna de box y sw_image. Los bordes de lineas,
    rectangulos y triangulos van en un unico bucle del renderer y el del circulo
    en un bucle de octantes, para que kernelcalls no copie segment ocho veces.
    clip_edge pasa a ser una macro (CLIP_EDGE): con &from y &to la pila del
    kernel no se podia seguir y ssy daba todo por divergente.
    shapes: 844224 -> 348088 instrucciones de warp en 2 frames. test_fuzz_v2
    compara V2 con V0 en 3000 escenas al azar.
2026-10-31 mini-opt: comprobar las regiones SIMT anidadas y la pila de la lane
    ssy da un error al compilar si un SSY puede abrir su region con las 8 de la
    GPU ya abiertas (cota por arriba: las regiones que lo contienen), diciendo de
    que funcion expandida viene el salto. El pase nuevo lanestack da un error si
    los marcos de las funciones expandidas o un acceso a la pila se salen de los
    512 bytes de la lane; si R30 no se puede seguir, lo cuenta en las stats.
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2026-10-31 sim-sys: motor Codon que compila los mismos núcleos que Python
    - Núcleos sin CLI, válidos en Python y en Codon: minicpu_core.py,
    minigpu_core.py y cpu_gpu_core.py. Los *_sim.py de siempre añaden la
    CLI y los reexportan. Nadie guarda a su padre: system (y warp) bajan
    como argumento (Warp.step(system)...), con las llamadas de 23, 24 y 25
    al día.
    - tools/mmio_device.py (MmioDevice, MachineHooks) como base común de los
    dispositivos; tools/codon_compat (struct, from_bytes, dataclass) con
    gemelo .codon.
    - Periféricos con reloj por lotes (ticks_until_event/advance), y
    sim-sys para al cerrar la ventana, con F12 o Ctrl+C (request_stop).
    - --backend codon: tools/codon_backend.py c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
2026-10-31 minigpu: el paso del warp no reserva memoria por lane
    CPU.evaluate ya no copia los 32 registros ni crea un LaneResult: deja
    el resultado en campos de la lane (rd, value, next_pc, halted, store_*)
    y Warp.step lo confirma, sin lista de resultados ni set de PCs. Un fallo
    en una lane sigue sin dejar a las otras a medias.
    dma-bench: 9,2 -> 1,7 s con Codon y 12,8 -> 8,2 s con PyPy, con la
    misma salida. tools/codon/RENDIMIENTO.md recoge cómo medir y lo que
    queda por mirar.
2026-10-31 sim-sys: reloj por lotes en el sistema y planificador más ligero
    - tick_devices solo cuenta: los periféricos avanzan con advance(n) en
    el primer tick con evento (ticks_until_event) o antes de que el bus
    acceda a uno (_Port -> MachineHooks.sync_devices). Fuera de run, tick
    a tick. Los proxies de Codon ya no cuentan ticks.
    - Con la GPU detenida, step_round hace una comprobación de límites en
    vez de gpu_steps pasos vacíos.
    - Límites con NO_LIMIT en vez de Optional.
    boxes hasta 60 swaps con Codon: 3,9 -> 2,6 s; hasta 12, 1,0 -> 0,75 s.
    Salida, framebuffer y estado completo idénticos. RENDIMIENTO.md explica
    cómo perfilar el motor y lo que queda.
2026-10-31 sim-sys: sin llamadas a Python por frame, límites por lotes y RAM por puntero
    - VideoDevice: sin intercambio ni cambio de configuración pendientes,
    las fronteras de frame no son eventos (ticks_until_event da NEVER) y
    advance(n) cuenta de una vez los frames que pasan. En el motor Codon
    eran dos llamadas a Python cada 1000 instrucciones.
    - CpuGpuSystem: _limit_slack cuenta las instrucciones que pueden
    retirarse antes de que un límite pueda alcanzarse; _check_limits solo
    se llama cuando llega a cero.
    - codon_compat.codon: load_u32/store_u32 con una lectura de 32 bits por
    puntero; quien llama ya ha comprobado límites y alineación.
    Con Codon, boxes hasta 60 swaps: 2,6 -> 1,6 s (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
2026-11-03 mini-gl: racer, carreras en islas con niveles, tráfico y modo debug
    - racer.c: circuitos por casillas en cuatro niveles (examples/racer/*.h:
    COAST, SIERRA, DELTA, KNOT), con curvas de 1x1, 2x2 y 3x3, cruces al
    mismo nivel y pasos elevados. La altura de la carretera sale del terreno
    ('^' marca dónde va una cuesta). Tráfico que frena, adelanta y cede el
    paso; cámaras detrás, dentro, alta y TV; piloto automático; minimapa con
    la isla. La roca no se puede subir.
    - Modo debug (G): congela la escena y enseña sus datos;
    make racer-scene SCENE="..." la vuelve a dibujar en el host.
    - examples/racer/README.md: el formato de los niveles.
    - processing3d: resetShapes() para cambiar de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
2026-11-04 Renderer 3D: geometria y profundidad en Q16.16 (experimental) y raster3d mas barato
    MGR_FIXED_GEOMETRY=1: transformar, outcode y viewport de los triangulos sin
    recortar en Q16.16 con los idiomas de MULFX y __mini_divfx (fixed.c); el
    recorte sigue en float. 1/w se calcula una vez (r = 2^46 / w) y cada
    coordenada sale de un producto ancho.
    MGR_FIXED_DEPTH=1: el plano de profundidad de cada triangulo en enteros
    (mgr_depth_plane), con un solo reciproco de 1/area (mini_divfx + una
    iteracion de Newton) en vez de float por software. Requiere
    MGR_INCREMENTAL_DEPTH=1.
    Las dos macros valen 0 por defecto y entonces el codigo es el de antes.
    Ademas, sin cambiar ningun bit del resultado: floor16 pasa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
2026-11-04 Renderer 2D en GPU: MGL_GPU_WARPS, RASTER_STRIDE e instrumentacion de contadores
    MGL_GPU_WARPS (1 por defecto) reparte las columnas entre 8 * warps hilos con
    RASTER_STRIDE en raster.c; con 1 el comportamiento es el de antes (la lane es
    __gpu_tid, igual a __gpu_lane con un warp). Con varios warps el estado global
    del raster se pisa: hay una barrera por primitiva salvo MGL_GPU_NO_BARRIER. Se
    dejan como herramienta de medida: en la placa 36 V2 va 6 veces mas lento que
    V0 y con mas warps empeora porque cada hilo repite la preparacion de las
    primitivas.
    MGL_GPU_PERF_SNAPSHOT copia los contadores de GPU PERFORMANCE y los ciclos de
    CPU dentro y fuera de cada lanzamiento a SDRAM (0x00F00000) para l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
2026-11-05 37: escrituras posted en la LSU (MAX_POSTED)
    Una escritura a RAM retira el grupo al aceptarla el puerto, sin esperar la
    respuesta; se cuentan las pendientes (st_out, tope MAX_POSTED=8, 0 = antes).
    Las cargas y el MMIO esperan a st_out==0 para conservar el orden. wr_pending
    entra en lsu_occupied (halted) y gpu_system mantiene vivo (live_hold) a un warp
    que acaba con escrituras en vuelo, para que WARP_DONE/STATUS no se adelanten a
    la memoria. Un error de memoria tardio en una escritura es una bandera pegajosa
    (wr_error) que cuenta como GPU_STATUS.ERROR.
    gpu_lsu2_tb: modelo de memoria con varias peticiones en vuelo y casos 17-21
    (liberacion del warp, carga tras escritura, tope de la cuenta, er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
2026-11-05 Diamond vs apio: phase timings, TRACE errors and per-tool rows in build-list
    - build_report/diamond_runner record wall-clock synthesis and PNR seconds
    (phases in metadata.json and summary.json); build-compare shows
    TOTAL/SYNTH/PNR and a FF column.
    - build-list --prototypes prints one row per tool (TOOL column, colored)
    with the latest Diamond report next to the apio one.
    - diamond_report: a clock whose TRACE preference has errors has no
    "Report: MHz" line and used to vanish (PASS with errors). Its Fmax is
    now estimated from the worst excess and flagged "estimated".
    - diamond_runner: read [common] + [env:X] of apio.ini and add --env, so
    multi-env prototypes such as 13.hdmi can be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
2026-11-05 9, 10: CLKOP_CPHASE = CLKOP_DIV-1 so Diamond accepts the PLL
    ecppll gives DIV/2, which leaves CLKOP 120/144 degrees out of phase with
    CLKI. Diamond >= 3.10 aborts in Map ("should not be used as the feedback
    signal"); yosys/nextpnr accept it silently. Same fix already applied in 4,
    5 and 6. nextpnr results are unchanged (Fmax and LUT identical). Checked
    on the board for 10 with both the apio and the Diamond bitstream; 9 is
    not tested on the board yet.
2026-11-05 13: give Diamond the PLL output frequencies
    Synplify does not derive them from the EHXPLLL parameters, so TRACE only
    analyzed the input clock. FREQUENCY_PIN_CLKI/CLKOP/CLKOS = 25/370/74 MHz
    (valid for the three tops). Diamond now reports clk_pix_5x at 250 MHz
    against 370 (SIOLOGIC pulse width) and 30 hold errors across the
    deliberate CLKOP/CLKOS phase offset; both bitstreams show a stable image
    on the board. nextpnr is unaffected.
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2026-11-05 workgroup-barrier-isolation: document the polling race on the board
    The case fails in the full fpga-gpu suite (ERROR_SIMT at the BEQ) and passes
    alone. A warp LOAD of one address is served one lane per bank per wave, so a
    STORE from another workgroup can land between lanes and split R6 (0 in lanes
    0..5, 7 in lanes 6..7); the BEQ then diverges without an SSY region. The
    functional simulator loads atomically and never sees it. Not a regression
    (the 2026-10-08 bitstream fails too). Documented, test left unchanged.
2026-11-05 12: make the design work when built with Diamond (Synplify)
    - top.v: registered reset (shift register that starts at ones, like 10)
    instead of the combinational `!(&power_on)`. With Diamond the monitor
    answered 0x00/0xF0 on the board even though the post-PAR netlist worked in
    simulation; bisecting (single-port RAM, no GPU) pinned it on the reset.
    - gpu_bram.v: `ifdef DIAMOND` instantiates 8 DP16KD (4 bits) per bank, because
    Synplify does not infer a RAM with two write ports. The default branch is
    unchanged.
    Board (Diamond bitstream): PONG, monitor 3.12, 58 cases pass; the only failure
    is the known workgroup-barrier-isolation race. The apio bitstream for the new
    top.v has not been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
2026-11-05 diamond: per-prototype constraints file; 13 blocks the clk_pix -> clk_pix_5x path
    TRACE reported 30 hold errors (up to 5.15 ns) in 13, all in the pixel -> 5x
    clock crossing. It is an analysis artifact: both clocks come from one PLL with
    aligned edges (CLKOS_CPHASE 5 vs CLKOP_CPHASE 1 = 4 VCO cycles = 2 periods at
    370 MHz), TRACE adds that offset as source clock delay but compares against the
    unshifted capture edge. Measured on the same .ncd: 30 hold errors with no
    constraint, 30 with MULTICYCLE 5X, 0 with BLOCK PATH.
    diamond_runner appends <prototype>/diamond-constraints.txt to its copy of the
    .lpf if it exists (it cannot be named .lpf: apio globs every .lpf). 13 gets the
    BLOCK PATH with th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
2026-11-05 diamond report: minimum-pulse-width errors are a warning (WARN), not a FAIL
    TRACE counts "Minimum Pulse Width" violations among the setup errors. In 13 the
    serializer drives ODDRX1F at 370 MHz, above the ~250 MHz the datasheet gives for
    the SIOLOGIC clock (4.0 ns). nextpnr does not check it, no placement fixes it,
    and the HDMI output is fine on the screen, so it should not turn the row to FAIL.
    - parse_twr separates those blocks from real path errors (a pulse-width block is
    the one that carries "based on Minimum Pulse Width"; a "Passed:" line closes
    the block so an approved pulse width is not counted). They no longer feed the
    estimated Fmax. If the pulse width is the only error the cl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
2026-11-05 14, 17, 22: registered reset (same fix as 12)
    `reset = !(&power_on)` is a combinational decode of a counter. Built with Diamond
    (Synplify) the monitor answered 0x00 on the board even though the post-PAR
    netlist worked in simulation; a registered reset (16-bit shift register that
    starts at ones, as in 10) fixes it. See 12.fpga-gpu/top.v.
    Board, Diamond bitstreams: 14 passes 61/62 cases (the only failure is the known
    workgroup-barrier-isolation race); 17 answers the monitor (3.17, not a
    run_tests target). 22 has only been synthesized, not tested on the board.
    29/top_bl8.v and 33 still have a counter-based reset; 29 pins nextpnr --seed 2,
    so changing its netlist needs a new seed sweep.
    Co-Aut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
2026-11-05 17 is a test target of the board suite (version sdram2)
    The 2026-10-01 decision left 17 out because it was "an attempt that never
    closed". It now synthesizes with apio (44.4 MHz vs 30.3 for 14) and with
    Diamond, and answers on the board. Its different critical path is exactly what
    a suite should exercise, so it gets a version.json and the same suite as 14.
    Board, apio bitstream with the registered reset: 17 passes 61/62 cases; 14
    passes 61/62 too. The single failure in both is the known
    workgroup-barrier-isolation race.
    Comments in fpga_gpu.py / fpga_common.py and the closed item in TODO.md say
    what the old comments said the other way round.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
2026-11-05 22: Diamond constraints for the clk_pix crossings
    TRACE gave 978 hold errors (up to 15.7 ns) in clk_pix -> clk_25mhz_c and
    clk_pix -> clk_pix_5x. Both are analysis artefacts: the first is the "data
    accompanying a toggle" handshake of video_scanout.v (req_bank is stable for
    two screen lines before the synchronised toggle arrives), the second is the
    same PLL phase offset seen in 13. Two BLOCK PATH lines in
    diamond-constraints.txt remove them.
    With the constraints: 0 setup and 0 hold errors, 28.7 MHz against 25. On the
    board the Diamond bitstream passes the whole suite (lsu2, 64 cases, 0
    failures) and the HDMI picture is stable.
2026-11-05 build-list: an interrupted build no longer hides the last finished one
    14 showed INTERRUPTED with no timing because an auto-upload build that was cut
    by hand started (12:02) after the good build (11:56, which finished later).
    build-list keeps the most recently STARTED record per prototype, so the cut one
    won. Interrupted records are now skipped when the prototype has any other
    record that finished; if it is the only one it is still shown.
2026-11-05 Revert "build-list: an interrupted build no longer hides the last finished one"
    This reverts commit e4b02490db8b9c0b9ee6cebff89c418f8adbe695.
2026-11-05 16: Diamond constraints for the clk / clk_pix / clk_pix_5x crossings
    TRACE treated the CPU PLL (pll_cpu) and the pixel PLL (clock2_gen) as related
    and added their phase offset and feedback compensation as skew, giving 1271
    hold errors (up to 15.7 ns) and cross-domain setup errors that do not exist on
    the chip. The three crossings are asynchronous by design (toggle + 2 FF for
    done/clear/req, and the "data accompanying a toggle" handshake of
    video_scanout.v for req_bank), so diamond-constraints.txt blocks them:
    clk -> clk_pix, clk_pix -> clk and clk_pix -> clk_pix_5x. clk -> clk is left
    alone on purpose: it is what really limits the CPU.
    Result with the common monitor.v: 0 hold errors; the on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
2026-11-05 build-list: a running Diamond build is shown as RUNNING
    Diamond runs did not go through the common build records, so build-list only
    knew about the finished report and never showed one in progress (apio builds
    are marked RUNNING and counted in ACTIVE BUILD).
    - diamond_runner opens a record in reports/<id>/status.json (the one apio
    uses) with tool: diamond and its own pid, and closes it as success, failed or
    interrupted. A killed process is marked interrupted the usual way, when
    build-list sees that the pid is gone.
    - prototype_build_summary keeps those records out of the apio row (they are not
    apio builds) and uses them only to put the Diamond row in RUNNING; with no
    previous repo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
2026-11-05 diamond_runner: the build record carries the real Diamond log
    The record that diamond_runner opens in reports/<id>/ had an empty build.log,
    which reads as "the build wrote nothing". It now gets a copy of
    .diamond/diamond.log when the run ends, also when it is interrupted, so the
    list by ID (and anything that tails a build) shows what Diamond printed.
    Checked with a short run (3): build.log 135 kB, state success.
2026-11-05 backend_from_rtl is data again; the cpu+gpu label goes in backend_label
    94cb0d2 made backend_from_rtl return "cpu+gpu" and "-" so that list-prototypes
    would show both families of 36 and 37. But it is not a display string: the
    fpga-cpu version selector (== "cpu"), generate_sysid (SYS_ID bits and ISA
    profile) and the reports all key on it. With "cpu+gpu", 36 and 37 stopped being
    registered as fpga-cpu versions and the SYS_ID logic for them took the wrong
    branch.
    backend_from_rtl returns "cpu", "gpu" or None again (the governing family; "cpu"
    for 36 and 37, as the docstring of backends_from_rtl already said). The listing
    gets its own backend_label() ("cpu+gpu", "cpu", "gpu" or "-") and list-pr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
2026-11-05 monitor: one file for every prototype, no MMIO windows, registered block counter
    monitor.v was meant to be a byte-identical copy in every folder that speaks the
    protocol, but 35/38 (a sixth window) and 36/37 (STATE_CHECK_BLOCK) had drifted
    away, and the window parameters were a twin of the decoder map and of
    MONITOR_REGIONS in monitor.py that kept going out of sync (0x200/0x300 in the
    GPU, then 18 and 19: NACKs that look like an old bitstream).
    One monitor.v now, copied to 18 folders (6, 10, 12, 14, 16, 17, 18, 19, 21, 22,
    29, 30, 33..38):
    - No WINDOWn parameters. Block commands only check that a block starting in RAM
    ends in RAM (RAM_END) and that a block starting outside RAM lies in th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
2026-11-06 Add Diamond constraints for 18/19/21 and adopt seed 2 for 19
    18, 19 and 21 share video_scanout.v with 16 (identical file), so the three
    BLOCK PATH crossings validated there (clk<->clk_pix, clk_pix->clk_pix_5x)
    apply unchanged. With them Diamond reports 0 TRACE errors and clk >= 83.6 MHz
    (PAR search of 20 iterations) on all three.
    19 failed apio timing at seed 4 (73.9 MHz at 80 required) after the monitor
    unification; an 8-seed sweep put seed 2 at 87.1 MHz. Suite on the board:
    37 cases, 0 failures; MMIO holes are rejected.
2026-11-06 Clear input_registers keys with a sweep instead of a parallel reset
    The 256-bit keys vector was reset in parallel from the global reset net.
    In Diamond that was the critical clk path of prototype 30 (reset_shift[15]
    -> input_i/keys, ~15 ns, 92% routing). Now a small counter walks the 256
    keys once per cycle after reset or when the host declares the keyboard
    absent (3.2 us at 80 MHz), sharing the single write decoder with events.
    keys is initialised to zero for power-up and simulation.
    Key events arriving during the sweep are ignored; the testbenches now
    wait 260 cycles after reset. Applied to 30, 34, 35, 36, 37 and 38.
2026-11-06 Add Diamond constraints for prototype 30
    BLOCK PATH between clk, clk_pix and clk_pix_5x, which come from two PLLs
    and are treated as related by TRACE. Covers the scanout toggles, the
    dual-clock text_console memories (no handshake by design) and the
    clk_pix to clk_pix_5x crossing shared with the HDMI prototypes. clk to
    clk stays unblocked. With it Diamond reports 0 TRACE errors on 30.
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2026-11-06 Unify instruction_buffer and memory_fabric_fifo_6 across prototypes
    instruction_buffer.v: one copy in all eleven folders that have it. The
    older copy (18, 19, 21, 22, 29) lacked the hit_event/miss_event outputs;
    the new one is a superset and the callers use named ports, so the unused
    outputs stay unconnected. 38 differed only in line endings.
    memory_fabric_fifo_6.v: 35 and 38 get the 36/37 version, with the parallel
    round-robin arbiter and the registered issue_go. 38 was created after those
    fixes but copied the older fabric from 35, so it never got them. 33 and 34
    keep the sequential backend, which is a different design.
    Tests pass for 18, 19, 21, 22, 29, 35 and 38. No synthesis rerun yet.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
2026-11-08 37: per-domain reset sync, phantom-response drop and pre-IO SDRAM stage
    reset_sync per clock domain; fabric_fifo_bridge drops responses with no
    outstanding request (the hardware-only phantom that shifted instruction
    fetch by one line); sdram_controller_128 captures DQ through a dq_pos
    stage and registers all outputs before the pins (READ_DELAY_CYCLES=2),
    which closes clk_mem at 100+ MHz. Adds phase tooling and system testbenches.
    Closes timing in Diamond (clk_mem 124 MHz); board suites pass.
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2026-11-08 36: port reset_sync, phantom-response drop and pre-IO SDRAM stage from 37
    Same shared modules and top.v as 37 (no gpu_sm change: the 36 SM already
    gets core_reset). Closes timing in Diamond (clk_mem 104.7 MHz). Adds the
    Diamond constraints file that 36/37 builds depend on.
    Known: with this bitstream serial-empty-input fails on the board (serial
    STATUS overrun bit is set at boot); not yet explained.
2026-11-08 38: port reset_sync, phantom-response drop and pre-IO SDRAM stage
    Also adds the Diamond PLL phase fix to clock2_gen.v and a constraints file
    (CPU clock is clk_25mhz_c here). Work in progress: Diamond clk_mem reaches
    98.1 MHz of 100 required (2 setup errors); needs a PAR seed search.
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2026-11-08 board-load: fix ValueError reading the video status; isolate user state in tests
    run_board parsed "whatever follows the last ':'" of the monitor output, which
    broke once monitor.py prints "SDRAM phase: 10 (version.json)" after the value.
    It now looks for the "Address 0x...: 0x..." line. record_upload uses
    socket.gethostname() (platform.node() spawns a subprocess, which the upload
    tests mock), and test_run_board no longer writes to the real ~/.mini-gpu.
2026-11-08 35: port reset_sync, phantom-response drop and pre-IO SDRAM stage
    Same shared modules as 37/38 (the 35 has no GPU). Closes timing in Diamond with
    PAR cost table 2 (clk 83.5 MHz, clk_mem 109.6 MHz) and passes 71/72 on the board;
    the only failure is serial-empty-input (serial STATUS overrun bit set at boot,
    under investigation, also present in 36). Adds the Diamond constraints file.
2026-11-08 serial_port: reset inside rx_overrun's data logic (30, 34-38)
    With 'if (reset) ... else ...' Synplify (Diamond) maps the reset to the flop's LSR
    next to a CE that includes reset; on the board rx_overrun started at 1 and the
    reset did not clear it (STATUS = 0x14000 after programming, serial-empty-input
    failed in 35 and 36). Measured on the 36: the flop stayed at 1 for 255+ cycles
    with reset active. Folding reset into the next-state expression gives
    STATUS = 0x4000. Same behaviour in simulation (serial_port_tb passes).
    Board (Diamond): 35 72/72, 36 79/79, 37 97/97, 38 49/49.
2026-11-08 workgroup-barrier-isolation: make the wait loop independent of timing
    The group-1 spin loop diverged inside a warp when the group-0 STORE landed between
    the eight per-lane LOADs, raising ERROR_SIMT on the board (full suite only). The
    loop now opens an SSY region, so the divergence is legal and the warp reconverges
    before its BAR. Same property is tested; final pc 44 -> 52. Passes on sim-gpu,
    sim-gpu-cycle and on boards 12, 14 (apio and Diamond).
2026-11-08 cpu-gpu C cases: require gpu_warp_start
    These images are built without --board, so they launch with WARP_START, which the
    36 (milestone 1, RUN only) does not have; there GPU_RUN returned GPU_ERR_STATE.
    They were run on the 36 and counted as failures. They are now skipped there
    (36: 79/79, 245 skipped) and still run on the 37 and in the system simulator.
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2026-11-08 docs: reset and Diamond lessons from the 2026-11-08 board session
    How reset should be written (reset_sync per clock domain, reset inside the
    next-state function for sticky flags), what was measured versus what is only a
    probable explanation, Diamond flow notes, and open items.
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2026-11-10 19/21: rx_overrun con el reset dentro de la expresion
    Con la forma if (reset) ... else, Synplify lleva el reset al LSR y el flop
    podia arrancar a 1 (serial-empty-input fallaba en la 19). Misma correccion
    que en 35-38. Cierra temporizacion en la 19 (83,36 MHz); aun sin probar en
    la placa.
2026-11-10 30: el adaptador de memoria descarta respuestas huerfanas
    Mismo arreglo que en 18, 19 y 21: rsp_ready pasa de (state == ST_WAIT) a
    (state != ST_ISSUE). Con Diamond, sin el, el primer acceso a memoria del
    monitor se colgaba y los 72 casos de la placa fallaban. Con el: 72/0.
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2026-11-10 34: diamond-constraints.txt con los cruces de reloj bloqueados
    Sin el, Diamond trataba clk, clk_mem y clk_pix como relojes relacionados y
    sumaba el desfase de las PLL como skew: 2227 errores de setup, el peor en el
    cruce font_ram (clk) -> glyph_q (clk_pix) con 16 ns de skew. Mismo criterio que
    la 35. Con este fichero y la tabla 3 de PAR cierra timing (clk_mem 100,38 MHz).
    En la placa sigue fallando 72/72; es otra causa (arquitectura antigua de SDRAM).
2026-11-10 docs: cambios por prototipo para Diamond y lecciones del 10 de noviembre
    Nueva tabla por conceptos (diamond-cambios-por-prototipo.md) y, en las
    lecciones, las secciones 4.5 (respuesta huerfana en 18, 19, 21 y 30) y 4.6 (la
    34), la fase de la SDRAM, el crash de apio y los pendientes al dia.
2026-11-11 docs: experimento A/B del reset en red primaria (18) y analisis de TRACE
2026-11-11 38: one always block per stage, no _WR buffer, no WB bypass
    - WB writes the register file directly (ctl_retire && wb_reg_write).
    - Drop id_live_operand_*: hazard_wb already stalls ID whenever it would
    forward, so it never changed a result but sat on the critical path.
    - Read the bank with id_src_a/b; the id_valid ? id_src : if_src mux was
    not needed with an asynchronous read.
    - Remove dead code: ALU_FAST_PATH, ctl_halt_pending (never set),
    ctl_running (always !halted), ex_instruction (never read).
    - Control (hazard events and ctl_* decisions) in one section; comments
    cleaned up; ctl_* registers get their stage from the prefix.
    CPU Fmax 50.3 -> 51.8-54.8 MHz depending on source order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
2026-11-11 tools/phase-sweep: one SDRAM phase sweep for every prototype
    Replaces the copies in 35-38. The 38 copy had --prototype 35 hard-coded
    and failed the identity check after programming. The prototype now comes
    from each bitstream's path (-p for bitstreams outside the repo), and the
    serial protocol uses that prototype's monitor.py (38 runs at 250 kbaud,
    35-37 at 1 Mbaud). Keeps the PLL-lock wait from the 37 copy; restores the
    bitstream's own phase at the end; reports go to <prototype>/reports/.
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2026-11-11 38: cpu_perf_tb measures cycles per instruction without the board
    Three programs, each isolating one effect: straight (200 independent ADDI,
    fetch only), chain (200 dependent ADDI) and loop (taken BNE every 4). The
    memory model mimics an instruction_buffer hit: one-cycle latency, a
    one-cycle ready pulse, and no new request served in the ready cycle.
    Baseline: straight 4.01, chain 4.01, loop 4.25. The fetch handshake
    alone costs 4 cycles per instruction and hides the dependency stalls.
2026-11-11 38: pipeline counters (why nothing moved from ID to EX each cycle)
    CPU PERFORMANCE slots 8-11 (mmio.md 13.2): STALL_EX_MEM, STALL_RAW,
    STALL_BRANCH, STALL_ID_EMPTY. Every running cycle either moves an
    instruction from ID to EX or counts in exactly one of them, so
    CPI = 1 + their sum per instruction (+ a few STEP/HALT/start cycles).
    - cpu.v: perf_stall[3:0], computed and registered inside the CPU so
    raw_hazard only feeds a local LUT+FF; perf_after_redirect tells a
    branch bubble from an empty ID.
    - cpu_perf_counters.v (identical in 30, 34-38): PIPELINE parameter; only
    38 sets it, the others keep the same circuit.
    - 38 top.v: PIPELINE(1), PERF_SLOTS 8 -> 12.
    - tools: perf_pipeline capabi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
2026-11-11 38: cpu_perf_tb measures STORE and LOAD
    A dmem model that behaves like cpu_dmem_adapter: a STORE to the line held
    by the write-combining buffer is answered next cycle, one to another line
    waits for the flush, a LOAD waits for the read, and after answering it
    waits for valid to drop (its ST_DONE).
    Baseline: store CPI 3.45 (EX busy with memory 1.20/instr: a buffered
    STORE still stalls EX about 2.8 cycles), load CPI 4.97 (2.72/instr, about
    3 cycles of protocol per LOAD on top of the memory).
2026-11-11 38: STOREs to SDRAM no longer stall EX (split dmem request and response)
    dmem now uses the same protocol as imem: valid/ready accepts a request,
    rvalid (+ error) answers it later, in order. It is also the interface a
    future D-cache would sit behind: a hit is just rvalid the next cycle.
    - cpu.v: dmem ports are wires. A STORE to SDRAM (addr[31:25] == 0) is
    posted: EX ends when the adapter accepts it. ex_mem_drop counts
    responses nobody waits for (posted stores, requests flushed in flight)
    and skips them. MMIO stores and every LOAD still wait for rvalid.
    dmem_waiting feeds the perf counters.
    - cpu_dmem_adapter.v: ready = idle (and not flushing at halt), rvalid
    pulses with the data/er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
2026-11-11 38: SDRAM pin registers in the IO cells under Yosys (syn_useioff)
    Yosys left cmd_q/a_q/ba_q/dqm_q/dq_out and the negedge capture
    dq_negedge in the fabric (IOLOGIC 0/224), so the good SDRAM clock phase
    moved with every placement. Diamond already packed them into the IO
    cells. With (* syn_useioff, ioff_dir *) on those regs, Yosys copies the
    attribute to the TRELLIS_FF and nextpnr packs them (or fails loudly).
    - IOLOGIC 0 -> 36 (the 3 SIOLOGIC are the DVI ODDRX1F).
    - Phase window on the board: 0-7 -> 2-21 (8 -> 20 steps of 208 ps).
    - clk_mem closes again (105 MHz) with a bigger I-cache that made every
    seed fail without the attribute (79-93 MHz).
    - dq_oe is still one register for 16 pins, so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
2026-11-11 CPU PERFORMANCE slots 12-13: data cache hits and misses
    DMEM_HITS (+0x30) and DMEM_MISSES (+0x34), capability `perf_dcache`:
    every LOAD to memory hits or misses dcache.v; STOREs, MMIO and
    out-of-range accesses count in neither (mmio.md §13.2).
    - cpu_perf_counters.v (identical in 30, 34-38): DCACHE parameter, events
    registered before counting like the others, overflow bits. With
    DCACHE = 0 nothing changes.
    - 38 top.v: #(.PIPELINE(1), .DCACHE(1)), dcache pulses wired,
    PERF_SLOTS 12 -> 14.
    - capabilities.json: perf_dcache; perf_pipeline's pattern no longer
    requires PIPELINE to be the only parameter.
    - perf_counters.py: DCACHE_COUNTERS, read_counters(dcache=), and
    dcache_breakdown();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
2026-11-12 run_tests: refuse a board whose RTL changed since the last build
    ensure_bitstream only compared the monitor version, which does not move
    with every build, while the runner takes capabilities from the RTL on
    disk. With RTL edited after the build it asked for things the loaded
    bitstream lacked (72 cases 'rejected' on 38). Now, on ULX3S, a source
    mismatch with the last build (bitstream_is_current) is handled like a
    wrong version: an error with --no-upload, an offer to build and load
    otherwise.
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2026-11-12 38: registered taken-branch redirect
    The taken-branch decision now ends in if_redirect/if_redirect_pc: in the
    decision cycle IF and ID carry on and the branch moves to EX; the next
    cycle IF empties the queue and fetches the target and ID drops the
    wrong-path instruction (id_live). if_pop, the queue, imem_address and
    ID's load no longer depend on the 33-bit compare: ID's worst arrival
    15.5 -> 10.2 ns. One more bubble per taken branch (cpu_perf_tb: exactly
    +1 per taken branch, counted as branch).
    cpu_redirect_tb: wrong-path TRAP/DIV-by-zero/JAL/STORE/HALT leave no
    trace, chained branches, STEP over a taken branch, HALT swept over every
    cycle of a loop, and a taken branch waiting behind a MUL/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
2026-11-12 38: next instruction enters EX as the access completes; registered D-cache compare
    D-cache hit drops from 3 to 2 EX cycles (1.62 after a STORE, was 3.31).
    ST_DECIDE registers the tag compare with no latency cost; CPU Fmax
    63.2 -> 65.4 MHz. dcache_tb test 15 invalidates during lookup/decide.
    Board: 72 cases, 0 failures.
2026-11-12 CPU PERFORMANCE slots 16-17: video frames and swap wait; 38 README status
    VIDEO_FRAMES counts frames started while the CPU runs; SWAP_WAIT counts
    cycles with a requested swap not yet done. --measure adds cycles/frame,
    work/swap and frame occupancy to the video pacing table (perf_video).
    38 sysid now advertises MUL/DIV in ISA_PROFILE. README: stage-splitting
    plan, measured table, D-cache 2-cycle hit. Board: 72 cases, 0 failures.
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2026-11-12 38: separate soft_reset for the monitor's RESET; in-flight fetches and accesses are dropped instead of forgotten
    board-load over a running program reset only the CPU while the I-cache and
    D-cache still owed it responses: a late fetch response wrapped if_inflight
    and the CPU stopped fetching (0 instructions retired). The in-flight
    bookkeeping now only clears on the system reset; soft_reset turns it into
    discards, as a stop does. cpu_memory_system_tb case 3 resets a running
    program with a slow instruction memory and D-cache misses (hangs with the
    old wiring).
2026-11-12 38: D-cache stores update a cached line instead of invalidating its index
    The compiled code stores to the stack and reloads at once: 93% of D-cache
    misses were lines just dropped by a STORE (26-33% miss rate on the 3D
    sketches; 1.5-3.5% with the update, in a cache model on the functional
    simulator's trace). A STORE still takes one cycle and is posted; it now also
    reads tag and line, compares in S1 and writes the merged line in S2. A reader
    of the same line in between gets it forwarded from S2 or W. dcache_tb:
    stores followed by loads at 0-3 cycles, back-to-back stores to one line,
    same index other tag, no write-allocate, and 3000 random accesses; mutants
    without each forwarding path fail.
    C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
2026-11-12 38: divider skips the quotient bits known to be zero (early exit)
    The first 31 - bits(n) + bits(d) restoring steps only shift in a prefix of
    the dividend below the divisor; step 1 counts them from the leading zeros
    of both magnitudes and step 2 sets remainder and dividend where they would
    have left them. The 3D rasterizer's divisions (span bounds, ~7-bit
    quotients) and the soft-float division were ~80% of the MUL/DIV wait: DIV
    1000/7 now costs 12 cycles instead of 34; a 32-bit quotient 36.
    cpu_muldiv_tb: 74 more pairs of mixed magnitudes and the skip edges;
    mutants with a skip off by one or without the clamp fail.
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2026-11-12 38: D-cache lookup in EX (MEM stage phase B): a load hit costs no stall
    ID gives the D-cache the address of the access entering EX; the EBR is read
    at that edge (and every edge, with EX's address while EX holds), and EX
    compares the tag and picks the word. A hit carries its data to MEM like an
    ALU result, and its consumer takes it from MEM (FWD-MEM-EX) without waiting.
    MEM only asks the adapter for misses, stores and MMIO; a missed load keeps
    its response in mem_result and leaves the cycle after. The line seen in EX
    is forwarded from a write in this cycle (store hit accepted, fill) or the
    previous one (read-during-write). A MUL/DIV does not start while its operand
    comes from a load still wai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
2026-11-13 racer: fast sin/cos for headings, relative() and visible() (cached per camera angle)
    Steady-state racer 3d-fixed in sim: 5.51 -> 5.09 M instructions/frame;
    visible() 487k -> 83k. Road geometry and the sky keep the exact mgl_sin/mgl_cos.
2026-11-13 mini-gl: faster 3D path (fixed clipping, span loop, matrix ops, MVP cache, DIVU division)
    - MGR_FIXED_GEOMETRY: clipping in Q16.16 (mgr_clip_triangle_q), same planes and
    inside-vertex cuts; t with 30 fraction bits. Fan uses the Q16 viewport.
    - mgr_fragment_span: no per-pixel depth clamp when both span ends are in range,
    end pointer instead of counter (12 -> 9 instructions per pixel, same pixels).
    - translate/scale/rotate_by update only the columns that change (same values,
    only the sign of a zero may differ).
    - Q16 MVP converted when MVP changes, not per DRAW_INDEXED; same_matrix compares
    words on MiniGPU.
    - udiv_shift: Q16 long division with hardware DIVU for viewport and clipping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
2026-11-13 38: FP32 extension (FADD/FSUB/FMUL/FDIV, opcodes 0x38-0x3B, capability fp32)
    - fp32_alu.sv: elastic binary32 unit (RNE, DAZ/FTZ, canonical NaN), wired into
    EX with valid/ready; one FP op in flight, younger instructions wait, flush
    cancels it. STALL_MULDIV/MULDIV_RETIRED also count FP ops.
    - Tests: fp32_alu_tb.sv (random vs binary64, corner cases, backpressure,
    reset) and cpu_fp32_tb.v (dependencies, R0, invalid encoding, stop/resume).
    - Functional simulator (tools/fp32.py, also in the Codon engine), assembler/
    disassembler, mini_opt, capabilities and the shared case alu/fp32.
    - apio.ini: seed 9 (CPU 55.75 MHz, SDRAM 111.01 MHz). Not yet run on the board.
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2026-11-13 38: 16 KB instruction and data caches (1024 lines each)
    The hot 3D renderer code (~7.5 KB) no longer fits an 8 KB direct-mapped
    I-cache: layout changes alone moved CPI by 15-20%. With 1024 lines, racer
    3d-fixed: I-cache misses 4.9M -> 0.79M per 10 s, CPI 2.46 -> 1.81.
    Board (50 MHz, phase 27), fps 8 KB -> 16 KB: racer fixed 6.00 -> 7.32,
    racer float 3.77 -> 4.69, tie_fighter fixed 5.39 -> 7.68, tie_fighter float
    -> 4.12. Fmax CPU 57.20 MHz, SDRAM 104.93 MHz. Board tests 73/73.
2026-11-13 mini-cc/mini-lcc --fp32 and FP32=1 in mini-gl: float with the FP32 instructions
    mini-lcc --fp32 passes -fp32 to rcc and defines __MINI_FP32__; mini-cc --fp32
    forwards it. mini-gl FP32=1 builds into build/minigpu/3d-fp32 (combinable with
    FIXED=1). check-minigpu3d FP32=1: 8/8 sketches identical to the host.
    Board (38, 50 MHz, 16 KB caches), float softfloat -> FP32: racer 4.69 -> 7.36
    fps, tie_fighter 4.12 -> 6.57 fps. isa.md: lcc now generates FP32.
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2026-11-13 mini-gl: triple buffer by default on MiniGPU, frameBuffers(2|3) to choose
    With two buffers the CPU waits for the next VBlank after each frame; with three
    it draws at once into the free one, and only waits for the previous swap,
    which at these frame rates finished several VBlanks ago. No hardware change:
    FB_BACK is writable while the old front is shown. The third buffer is at
    0x010D0800, inside the 1 MB 3D context window. A 2D context copies its canvas
    from the last drawn buffer. Same images (host checks, simulator 2D V0-V2 and
    3D). Board (38): racer 9.46 -> 10.74 fps, tie_fighter 8.06 -> 8.89 fps.
    A sketch at 60 fps can run one frame ahead: frameBuffers(2) there.
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2026-11-14 mini-gl: per-vertex color meshes, branchless clamps, make board-<sketch>
    - New vertex format MGL_VERTEX_POSITION_F32_XYZ_RGB565 (stride >= 16): each
    triangle takes the color of its first vertex. mgl_create_mesh_copy_rgb565,
    mgl_mesh_color_range and mgl_draw_mesh_range_uniform (same data as format 1).
    - shape() builds colored meshes and draws a model with one DRAW_INDEXED when it
    has few triangles per color group; otherwise (or with vertices shared across
    colors) per group as before. disableStyle()/enableStyle() as in Processing.
    - Renderer reads the color from the vertex pointer it already computed
    (mgr_transform_at[_q]); mgr_raster_triangle_area skips the checks draw.c did.
    - MIN/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
2026-11-14 38: pipelined MUL, MEM->ID address forwarding, 256-entry BTB
    - MUL/MULHI/MULFX no longer hold EX: partial products registered in the DSPs
    as the MUL leaves EX, summed in MEM; the consumer right after waits 1 cycle.
    - Load/store base can come from mem_result (FWD-MEM-ID): AGI 2->1 and 1->0.
    - BTB_BITS 8, forced to distributed RAM (in EBR it missed 50 MHz).
    - Board, same frames: racer +4.5/+1.5/+2.9 %, tanks +2.8/+3.6 %,
    skimmer +2.4/+3.3 %.
    - analisis-rendimiento.md: measurements, models and discarded options.
